We-sson/HanGao/README.md

# KUKA上位机软件使用说明

  该项目处于研发阶段，项目详情使用方法后续更新文档说明!
   
  主项目入口：HanGao/HanGao_Base/HanGao.sln
 
  欢迎各位对项目提出意见和问题~

 The project is in the research and development stage, the project details of the use of subsequent updates to the document description!
 
 Main project entrance: HanGao/HanGao_Base/HanGao.sln
 
 We welcome your comments and questions about the project.

企业微信截图_17210061561094
