We-sson/HanGao/KUKA_Socket/Krc8.3/技术参数说明.docx

Surround_Welding_Struc

参数（使用英文表示）：

焊盆口：

水槽本体属性参数：

Sink_Size_Long-长度

Sink_Size_Width-宽度

Sink_Size_R-圆角

Sink_Size_Pots_Thick 盆胆厚度

Sink_Size_Panel_Thick面板厚度

Sink_Model水槽型号

Sink_Size _Left_Distance 水槽面板左配件尺寸

Sink_Size _Down_Distance 水槽面板下配件尺寸

Sink_Type 水槽类型

各位置围边焊接工艺默认值

Welding_Name=”SS_1” 点名称

Welding _Power=80% 焊接功率

Welding_Speed=0.045 焊接速度

Welding_Angle=25 焊接角度

Welding_CDIS=5 轨道逼近值

Welding_Offset={X 0,Y 0,Z 0} 焊接偏移

Welding_Name={X 0,Y 0,Z 0} 焊接位置

短边焊接工作参数

{Surr_Welding_Craft_Type: Welding_Name[] "S2", Welding_Pos {E6POS: X 533.000, Y 463.600037, Z -2.05000, A 0.0, B -23.0000, C 0.0}, Welding_Speed 0.0500000, Welding_Angle 23.0000, Welding_Offset {Offset_POS: X 10.0000, Y 0.0, Z 0.0}} {Surr_Welding_Craft_Type: Welding_Name[] "S2", Welding_Pos {E6POS: X 533.000, Y 463.600037, Z -2.05000, A 0.0, B -23.0000, C 0.0}, Welding_Speed 0.0500000, Welding_Angle 23.0000, Welding_Offset {Offset_POS: X 10.0000, Y 0.0, Z 0.0}} {Surr_Welding_Craft_Type: Welding_Name[] "S2", Welding_Pos {E6POS: X 533.000, Y 463.600037, Z -2.05000, A 0.0, B -23.0000, C 0.0}, Welding_Speed 0.0500000, Welding_Angle 23.0000, Welding_Offset {Offset_POS: X 10.0000, Y 0.0, Z 0.0}} {Surr_Welding_Craft_Type: Welding_Name[] "S2", Welding_Pos {E6POS: X 533.000, Y 463.600037, Z -2.05000, A 0.0, B -23.0000, C 0.0}, Welding_Speed 0.0500000, Welding_Angle 23.0000, Welding_Offset {Offset_POS: X 10.0000, Y 0.0, Z 0.0}} {Surr_Welding_Craft_Type: Welding_Name[] "S2", Welding_Pos {E6POS: X 533.000, Y 463.600037, Z -2.05000, A 0.0, B -23.0000, C 0.0}, Welding_Speed 0.0500000, Welding_Angle 23.0000, Welding_Offset {Offset_POS: X 10.0000, Y 0.0, Z 0.0}} {Surr_Welding_Craft_Type: Welding_Name[] "S2", Welding_Pos {E6POS: X 533.000, Y 463.600037, Z -2.05000, A 0.0, B -23.0000, C 0.0}, Welding_Speed 0.0500000, Welding_Angle 23.0000, Welding_Offset {Offset_POS: X 10.0000, Y 0.0, Z 0.0}} {Surr_Welding_Craft_Type: Welding_Name[] "S2", Welding_Pos {E6POS: X 533.000, Y 463.600037, Z -2.05000, A 0.0, B -23.0000, C 0.0}, Welding_Speed 0.0500000, Welding_Angle 23.0000, Welding_Offset {Offset_POS: X 10.0000, Y 0.0, Z 0.0}} {Surr_Welding_Craft_Type: Welding_Name[] "S2", Welding_Pos {E6POS: X 533.000, Y 463.600037, Z -2.05000, A 0.0, B -23.0000, C 0.0}, Welding_Speed 0.0500000, Welding_Angle 23.0000, Welding_Offset {Offset_POS: X 10.0000, Y 0.0, Z 0.0}} {Surr_Welding_Craft_Type: Welding_Name[] "S2", Welding_Pos {E6POS: X 533.000, Y 463.600037, Z -2.05000, A 0.0, B -23.0000, C 0.0}, Welding_Speed 0.0500000, Welding_Angle 23.0000, Weldi

{Surr_Welding_Craft_Type:

Welding_Name[] "S2",

Welding_Pos {E6POS: X 533.000, Y 463.600037, Z -2.05000, A 0.0, B -23.0000, C 0.0},

Welding_Speed 0.0500000,

Welding_Angle 23.0000,

Welding_Offset {Offset_POS: X 10.0000, Y 0.0, Z 0.0}

}

存储XML格式

<Sink_Data DateLastModify=”2022-2-10-01:29” Sink_ListNumber=”12” >

<Sink Model=”952154” Type=”#LeftRight_One”>

<Sink_Size_Long>641<Sink_Size_Long>

<Sink_Size_Width>345<Sink_Size_Width>

<Sink_Size_R>10<Sink_Size_R>

<Sink_Size_Pots_Thick>0.75<Sink_Size_Pots_Thick>

<Sink_Size_Panel_Thick>2.85<Sink_Size_Panel_Thick>

<Sink_Size _Left_Distance>23.8<Sink_Size _Left_Distance>

<Sink_Size _Down_Distance>23.8<Sink_Size _Down_Distance>

<Surround_Craft >

<L0_Welding_Craft MaxArray=”10” >

<Craft_Data NO=”1” Welding_Name=”SS_1” Craft_Speed =”0.045” Craft_Angle=”25” Craft_CDIS=”10” Craft_Type=”#L_LIN_POS”>

<Welding_Offset X=”0.00” Y=”0.00” Z=”0.00” A=”0.00” B=”0.00” C=”0.00”>

<Craft_Data>

<Craft_Data NO=”2” Welding_Name=”SS_1” Craft_Speed =”0.045” Craft_Angle=”25” Craft_CDIS=”10” Craft_Type=”#L_LIN_POS”>

<Welding_Offset X=”0.00” Y=”0.00” Z=”0.00” A=”0.00” B=”0.00” C=”0.00”>

<Craft_Data>

<....补充....>

<Craft_Data NO=”10” Welding_Name=”SS_1” Craft_Speed =”0.045” Craft_Angle=”25” Craft_CDIS=”10” Craft_Type=”#L_LIN_POS”>

<Welding_Offset X=”0.00” Y=”0.00” Z=”0.00” A=”0.00” B=”0.00” C=”0.00”>

<Craft_Data>

< L0_Welding_Craft>

<C45_Welding_Craft MaxArray=”3” >

<Craft_Data NO=”1” Welding_Name=”SS_1” Craft_Speed =”0.045” Craft_Angle=”25” Craft_CDIS=”10” Craft_Type=”#C_LIN_POS”>

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

<Craft_Data>

<Craft_Data NO=”2” Welding_Name=”SS_1” Craft_Speed =”0.045” Craft_Angle=”0” Craft_CDIS=”0” Craft_Type=”#C_CIR_POS”>

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

<Craft_Data>

<Craft_Data NO=”3” Welding_Name=”SS_1” Craft_Speed =”0.045” Craft_Angle=”25” Craft_CDIS=”10” Craft_Type=”#C_CIR_POS”>

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

<Craft_Data>

<C45_Welding_Craft>

<...补充....>

<L270_Welding_Craft MaxArray=”10” >

<Craft_Data NO=”1” Welding_Name=”SS_1” Craft_Speed =”0.045” Craft_Angle=”25” Craft_CDIS=”10” Craft_Type=”#L_LIN_POS”>

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

<Craft_Data>

<Craft_Data NO=”2” Welding_Name=”SS_1” Craft_Speed =”0.045” Craft_Angle=”25” Craft_CDIS=”10” Craft_Type=”#L_LIN_POS”>

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

<Craft_Data>

<Craft_Data NO=”10” Welding_Name=”SS_1” Craft_Speed =”0.045” Craft_Angle=”25” Craft_CDIS=”10” Craft_Type=”#L_LIN_POS”>

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

<Craft_Data>

<L270_Welding_Craft >

<Surround_Craft>

<Sink>

<Sink_Data>

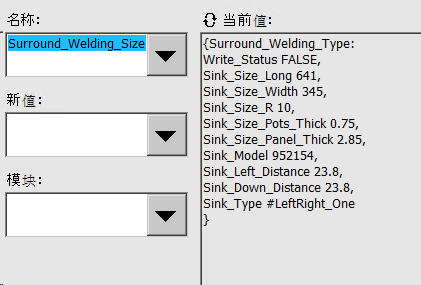
[picture p3: figure]
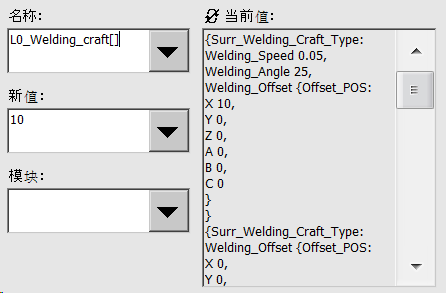
[picture p4: figure]
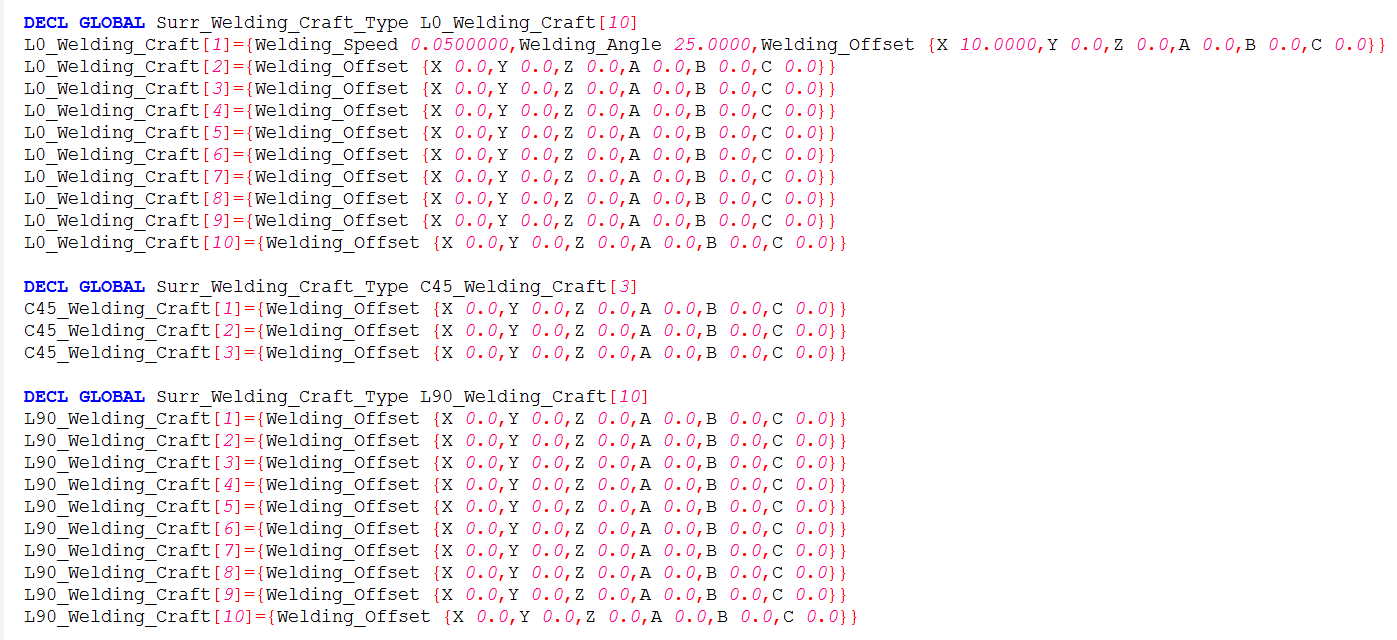
[picture p5: figure]

焊短边：ShortSide（）

结构：ShortSide_Struc {E6POS P1,P2……,E6POS Safe, BOOL Run, REAL Weld_Vel, INT CONT , REAL Width , Area SS_Area, Sink_Type SS_Sink , REAL BurnBack_High ,POS BurnBack_Point,INT BurnBack_Width, REAL BurnBack_Vel}

位置变量如：SS_1、SS_2。。。。。。。

D-焊小边长度

点：L_270_P1........

结构：

C_V_TYPE（CDIS,VEL,ANGLE）---轨道逼近，速度，姿态

例：L_0={C_DIS ,VEL ,ANGLE}

枚举：

方向区域：ENUM Area L0,C45,L90, C135,L180,C255,L270,C315

水槽类型：ENUM Sink_Type UpDown_One,LeftRight_One, LeftRight_Two
