We-sson/HanGao/Robot_Info_Mes/通讯协议解析.docx

ABB:

通讯发送使用格式：16进制位（1~FF）

协议结构：

1. 总字节长度：格式整数Uint（0~ 65535）
2. 通讯类型长度：格式整数Uint（0~ 65535）
3. 通讯类型：固定字符串Mes_Info_Data
4. 机器人类型长度：格式整数Uint（0~ 65535）
5. 机器人类型：ABB,KUKA,FAUNC等等
6. 机器人模式长度：格式整数Uint（0~ 65535）
7. 机器人模式：（Run，T1，Error）表示运行，手动，报警
8. 机器人程序名称长度：格式整数Uint（0~ 65535）
9. 机器人程序名称：当前指针程序名称。
10. 工位A作业状态长度：格式整数Uint（0~ 65535）
11. 工位A作业状态：FALSE,TURE
12. 工位B作业状态长度：格式整数Uint（0~ 65535）
13. 工位B作业状态：FALSE,TURE
14. 工位C作业状态长度：格式整数Uint（0~ 65535）
15. 工位C作业状态：FALSE,TURE
16. 工位D作业状态长度：格式整数Uint（0~ 65535）
17. 工位D作业状态：FALSE,TURE
18. 设备工艺类型长度:格式整数Uint（0~ 65535）
19. 设备工艺类型: Stretch_Sink_Cutting _1,每台机独立名称

接受示例~~~~

1. 总字节长度(如122个字，发送： 7A 00)，固定占2位
2. 通讯类型长度（如13字，发送0D 00）固定占2位
3. 通讯类型（如“Mes_Info_Data”字符串转字发送：4D 65 73 5F 49 6E 66 6F 5F 44 61 74 61）
4. 机器人类型长度（如3个字，发送03 00）固定占2位
5. 机器人类型(如“ABB”字符串转字发送41 42 42)
6. 机器人模式长度（如2个字，发送02 00）固定占2位
7. 机器人模式（如“T1”，字符串转字发送54 31）
8. 机器人程序名称长度（如6个字，发送06 00）固定占2位
9. 机器人程序名称（如“T_ROB1”,发送54 5F 52 4F 42 31）
10. 工位A作业状态长度（如5个字，发送05 00）固定占2位
11. 工位A作业状态（如“FALSE”字符串转字，发送：46 41 4C 53 45）
12. 工位B作业状态长度（如5个字，发送05 00）固定占2位
13. 工位B作业状态（如“FALSE”字符串转字，发送：46 41 4C 53 45）
14. 工位C作业状态长度（如5个字，发送05 00）固定占2位
15. 工位C作业状态（如“FALSE”字符串转字，发送：46 41 4C 53 45）
16. 工位D作业状态长度（如5个字，发送05 00）固定占2位
17. 工位D作业状态（如“FALSE”字符串转字，发送：46 41 4C 53 45）
18. 设备工艺类型长度（如8个字，发送08 00）固定占2位
19. 设备工艺类型（如“R_Side_9”，字符串转字发送52 5F 53 69 64 65 5F 39）
20. 完整接受信息47 00 0D 00 4D 65 73 5F 49 6E 66 6F 5F 44 61 74 61 03 00 41 42 42 02 00 54 31 06 00 54 5F 52 4F 42 31 05 00 46 41 4C 53 45 04 00 54 52 55 45 05 00 46 41 4C 53 45 05 00 46 41 4C 53 45 08 00 52 5F 53 69 64 65 5F 39
