We-sson/HanGao/ABB_Socket/资料/3HAC050947 TRM RAPID Overview RW 6-zh-cn.pdf

ROBOTICS

# 技术参考手册

# RAPID语言概览

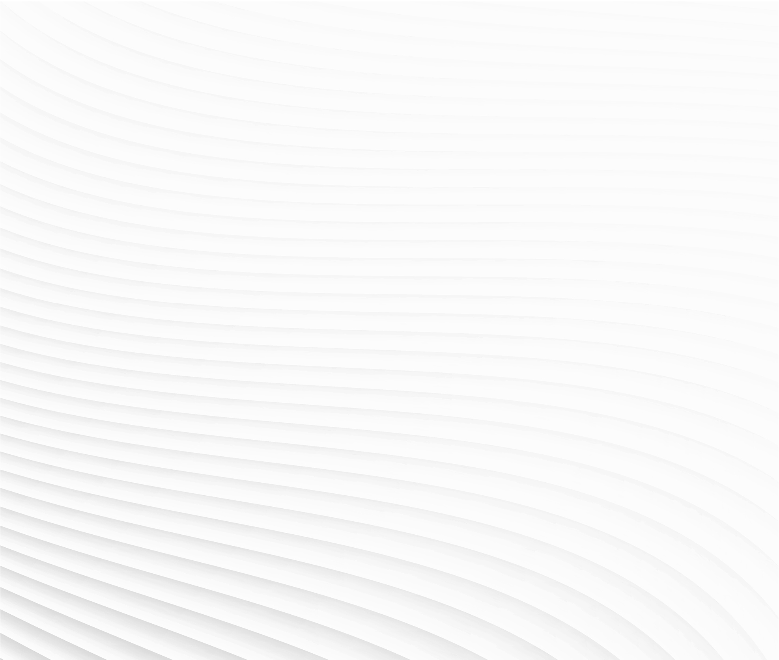
[picture p18: figure]

Trace back information:
Workspace 23C version a5
Checked in 2023-09-20
Skribenta version 5.5.019

## 技术参考手册

## RAPID语言概览

RobotWare 6.15.04

文档编号: 3HAC050947-010
修订: R

© 版权所有 2004-2023 ABB。保留所有权利。 规格如有更改，恕不另行通知。

本手册中包含的信息如有变更，恕不另行通知，且不应视为 ABB 的承诺。 ABB 对本手 册中可能出现的错误概不负责。
除本手册中有明确陈述之外，本手册中的任何内容不应解释为 ABB 对个人损失、财产 损坏或具体适用性等做出的任何担保或保证。
ABB 对因使用本手册及其中所述产品而引起的意外或间接伤害概不负责。
未经 ABB 的书面许可，不得再生或复制本手册和其中涉及的任何部件。 保留以备将来参考。
可从 ABB 处获取此手册的额外复印件。
本出版物为译本。

© 版权所有 2004-2023 ABB。保留所有权利。 规格如有更改，恕不另行通知。

目录

1 基本RAPID编程 | 11
2 运动编程和I/O编程 | 97
技术参考手册 - RAPID语言概览 | 5
3HAC050947-010 修订: R
© 版权所有 2004-2023 ABB。保留所有权利。

目录

3 术语表 | 143
索引 | 145
6 | 技术参考手册 - RAPID语言概览

目录

# 手册概述

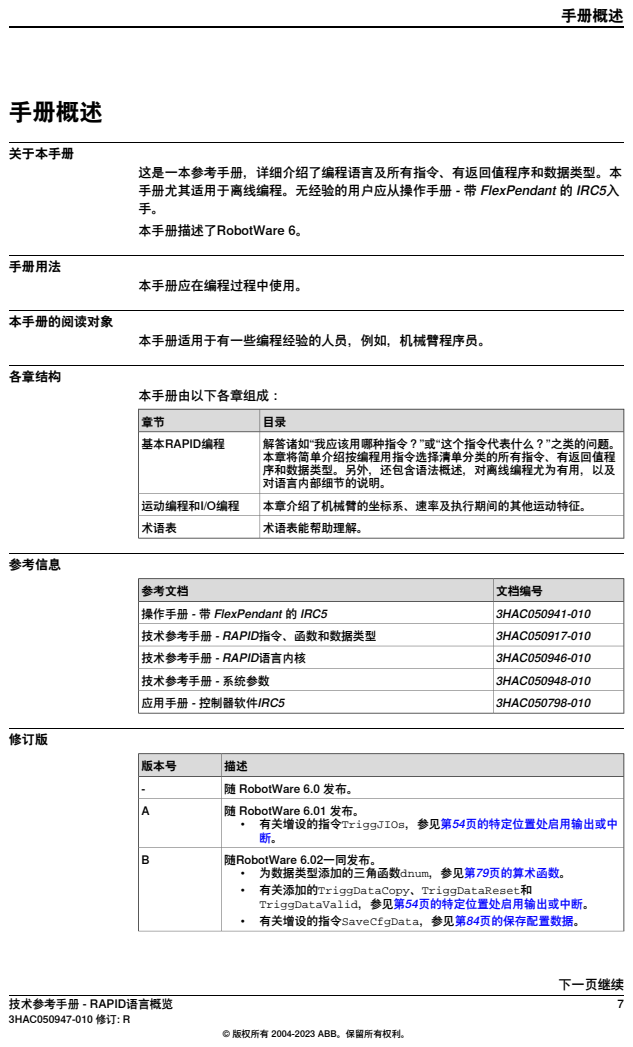
[picture p19: page 7]
关于本手册; 手册用法; 本手册应在编程过程中使用。; 本手册的阅读对象; 各章结构; 本手册由以下各章组成：; 基本RAPID编程; 运动编程和I/O编程; 本章介绍了机械臂的坐标系、速率及执行期间的其他运动特征。; 术语表; 术语表能帮助理解。; 参考信息; 参考文档; 文档编号; 操作手册 - 带 FlexPendant 的 IRC5; 3HAC050941-010; 技术参考手册 - RAPID指令、函数和数据类型; 3HAC050917-010; 技术参考手册 - RAPID语言内核; 3HAC050946-010; 技术参考手册 - 系统参数; 3HAC050948-010; 应用手册 - 控制器软件IRC5; 3HAC050798-010; 修订版; 版本号; - 随 RobotWare 6.0 发布。; 随 RobotWare 6.01 发布。 • 有关增设的指令TriggJIOs，参见第54页的特定位置处启用输出或中 断。; 随RobotWare 6.02一同发布。 • 为数据类型添加的三角函数dnum，参见第79页的算术函数。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

这是一本参考手册，详细介绍了编程语言及所有指令、有返回值程序和数据类型。本
手册尤其适用于离线编程。无经验的用户应从操作手册 - 带 FlexPendant 的 IRC5入
本手册描述了RobotWare 6。

本手册适用于有一些编程经验的人员，例如，机械臂程序员。

解答诸如“我应该用哪种指令？”或“这个指令代表什么？”之类的问题。
本章将简单介绍按编程用指令选择清单分类的所有指令、有返回值程
序和数据类型。另外，还包含语法概述，对离线编程尤为有用，以及
对语言内部细节的说明。

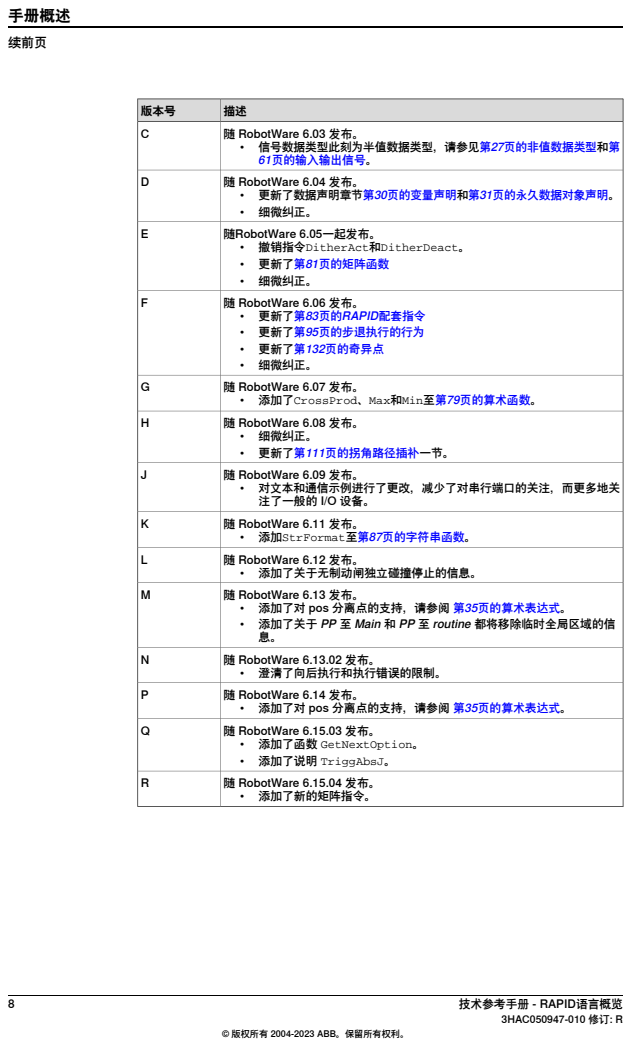
[picture p20: page 8]
版本号; 随 RobotWare 6.03 发布。 • 信号数据类型此刻为半值数据类型，请参见第27页的非值数据类型和第 61页的输入输出信号。; 随 RobotWare 6.04 发布。 • 更新了数据声明章节第30页的变量声明和第31页的永久数据对象声明。 • 细微纠正。; 随RobotWare 6.05一起发布。 • 撤销指令DitherAct和DitherDeact。 • 更新了第81页的矩阵函数 • 细微纠正。; 随 RobotWare 6.06 发布。 • 更新了第83页的RAPID配套指令 • 更新了第95页的步退执行的行为 • 更新了第132页的奇异点 • 细微纠正。; 随 RobotWare 6.07 发布。 • 添加了CrossProd、Max和Min至第79页的算术函数。; 随 RobotWare 6.08 发布。 • 细微纠正。 • 更新了第111页的拐角路径插补一节。; 随 RobotWare 6.11 发布。 • 添加StrFormat至第87页的字符串函数。; 随 RobotWare 6.12 发布。 • 添加了关于无制动闸独立碰撞停止的信息。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

随 RobotWare 6.09 发布。
• 对文本和通信示例进行了更改，减少了对串行端口的关注，而更多地关
注了一般的 I/O 设备。

随 RobotWare 6.13 发布。
• 添加了对 pos 分离点的支持，请参阅 第35页的算术表达式。
• 添加了关于 PP 至 Main 和 PP 至 routine 都将移除临时全局区域的信
随 RobotWare 6.13.02 发布。
• 澄清了向后执行和执行错误的限制。

随 RobotWare 6.14 发布。

# 如何查阅本手册

书面约定
程序示例通常以输出文件或打印机输出形式呈现，区别于以如下形式呈现在FlexPendant 示教器上的程序：
- FlexPendant示教器中隐藏的特定控制字码，如表明程序开始和结束的字码；
- 以标准格式打印出来的数据声明和程序声明，如VAR num reg1。 在本手册说明中，所有指令、函数和数据类型的名称都要用等宽字体表示，如 TPWrite。变量、系统参数和功能的名称用斜体表示。所列事件号示例中的注释不译 （即使翻译本手册时也一样不译）。

语法规则
用简化语法和形式语法对指令和函数进行说明。若您是用FlexPendant示教器编程， 则由于机械臂自身能保证所用语法的正确性，因此通常只需了解简化语法。

简化语法示例
如下为一种含指令TPWrite的简化语法示例。
TPWrite String [\Num] | [\Bool] | [\Pos] | [\Orient] [\Dnum]
- 括号中不含强制性参数。
- 用方括号[]将可选参数括起来，但可忽略这些参数。
- 互相排斥的参数不能同时存在于同一指令中，在同一指令中就要用竖线|隔开。
- 用波形括号{ }将可重复任意次的参数括起来。
上述示例采用了如下参数：
- String为强制性参数。
- Num、Bool、Pos、Orient和Dnum为可选参数。
- Num、Bool、Pos、Orient和Dnum互相排斥。

形式语法示例

TPWrite

[String ':='] <expression (IN) of string>

['\'Num':=' <expression (IN) of num> ] |

['\'Bool':=' <expression (IN) of bool> ] |

['\'Pos':=' <expression (IN) of pos> ] |

['\'Orient ':=' <expression (IN) of orient> ]

['\' Dnum':=' <expression (IN) of dnum]';'
- 方括号[ ]中的文字可忽略。
- 互相排斥的参数不能同时存在于同一指令中，在同一指令中就要用竖线|隔开。
- 用波形括号{ }将可重复任意次的参数括起来。
- 用单引号（两个撇号' '）将为获得正确语法而写出的符号括起来。
- 用尖角括号<>将参数和其他字符的数据类型括起来。更多详情，请查阅程序参 数说明。
用特殊语法EBNF编写语言和特定指令的基本元素。规则不变，而且还有所增加。
- 符号::=等同于被定义为。
- 至于尖角括号<>中的文字，将另起一行单独说明。

### 如何查阅本手册

示例

GOTO <identifier> ';'

<identifier> ::= <ident> | <ID>
<ident> ::= <letter> {<letter> | <digit> | '_'}

### 如何查阅本手册

# 1 基本RAPID编程

### 1.1 程序结构

### 1.1.1 简介

指令
本程序由多个对机械臂工作加以说明的指令构成。因此，不同操作对应的是不同的指 令，如，移动机械臂对应一个指令，设置输出对应一个指令。 指令通常包含多个相关参数，这些参数可定义按特定指令会出现的情况。如，重置输 出的指令包括一个明确要重置哪个输出的参数，如Reset do5。确定这些参数的方式 如下：
- 数值，如5或4.6；
- 数据索引，如reg1；
- 表达式，如5+reg1*2；
- 函数调用，如Abs(reg1)；
- 串值，如"Producing part A"。

程序
程序分为三类—无返回值程序、有返回值程序和软中断程序。
- 无返回值程序用作子程序。
- 有返回值程序会返回一个特定类型的数值。此程序用作指令的参数。
- 软中断程序提供了一种中断应对方式。一个软中断程序对应一次特定中断，如， 设置一个输入，若发生对应中断，则自动执行该输入。

数据
可按数据形式保存信息，如工具数据，包含对应工具的所有相关信息，如工具的工具 中心接触点及其重量等；数值数据，也有多种用途，如计算待处理的零件量等。数据 分为多种类型，不同类型所含的信息也各有不同，如工具、位置和负载等。由于此类 数据是可创建的，且可赋予任意名称，因此其数量不受限（除来自内存的限制外）。 既可遍布于整个程序中，也可能只在某一程序的局部。
数据分为三类—常量、变量和永久数据对象。
- 常量表示的是静态值，只能通过人为方式赋予新值。
- 另外，在程序执行期间，也可赋予变量一个新值。
- 永久数据对象也可被视作“永久”变量。保存程序时，初始化值呈现的就是永久数 据对象的当前值。

其他特征
语言中还有其他特征，如下所示：
- 程序参数
- 算术表达式和逻辑表达式
- 自动错误处理器
- 模块化程序

### 1 基本RAPID编程

1.1.1 简介

- 多任务处理
这种语言不区分大小写，如同一字母的大小写形式无区别。

1.1.1 简介

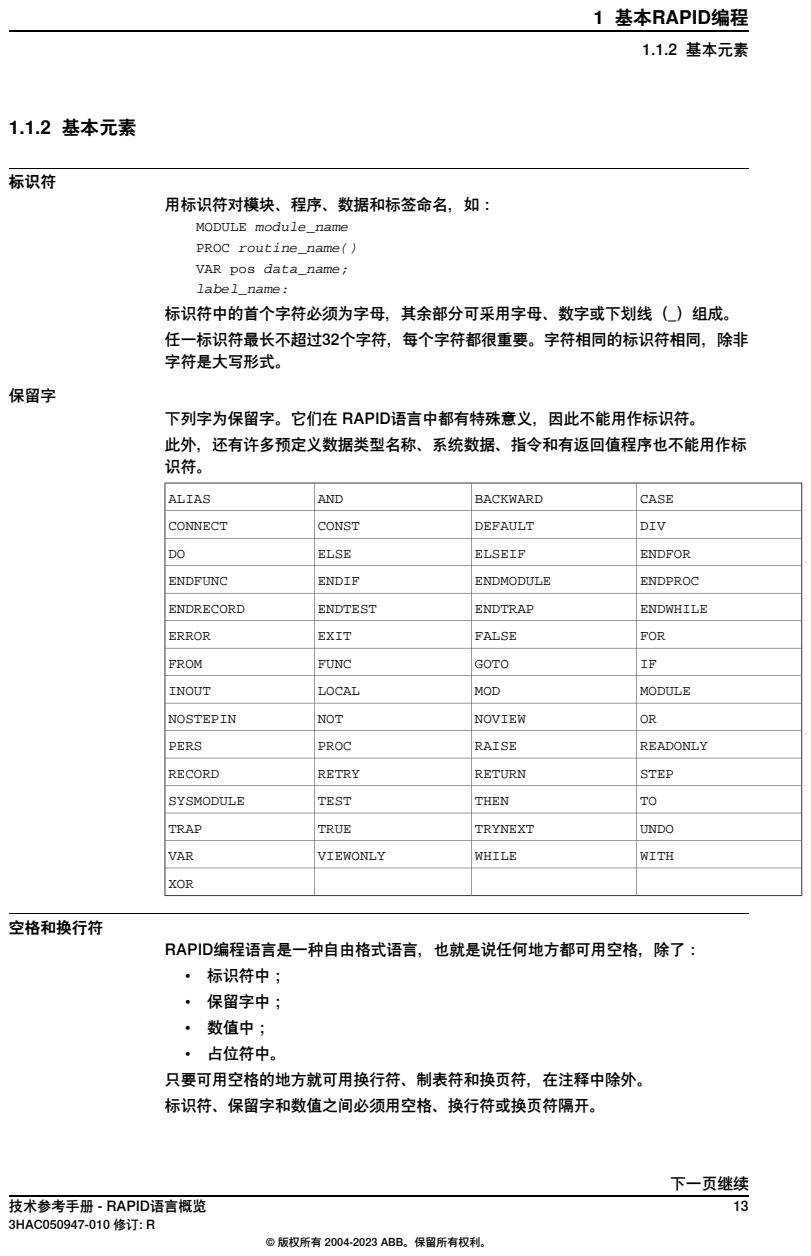
[picture p21: page 13]
1.1.2 基本元素; 标识符; MODULE module_name; PROC routine_name(); 保留字; ALIAS; AND; BACKWARD; CASE; CONNECT; CONST; DEFAULT; DIV; ELSE; ELSEIF; ENDFOR; ENDFUNC; ENDIF; ENDMODULE; ENDPROC; ENDRECORD; ENDTEST; ENDTRAP; ENDWHILE; ERROR; EXIT; FALSE; FOR; FROM; FUNC; GOTO; INOUT; LOCAL; MOD; MODULE; NOSTEPIN; NOT; NOVIEW; PERS; PROC; RAISE; READONLY; RECORD; RETRY; RETURN; STEP; SYSMODULE; TEST; THEN; TRAP; TRUE; TRYNEXT; UNDO; VAR; VIEWONLY; WHILE; WITH; XOR; 空格和换行符

用标识符对模块、程序、数据和标签命名，如：

VAR pos data_name;
label_name:
标识符中的首个字符必须为字母，其余部分可采用字母、数字或下划线（_）组成。
任一标识符最长不超过32个字符，每个字符都很重要。字符相同的标识符相同，除非
字符是大写形式。

下列字为保留字。它们在 RAPID语言中都有特殊意义，因此不能用作标识符。
此外，还有许多预定义数据类型名称、系统数据、指令和有返回值程序也不能用作标

RAPID编程语言是一种自由格式语言，也就是说任何地方都可用空格，除了：
• 标识符中；
• 保留字中；
• 数值中；
• 占位符中。
只要可用空格的地方就可用换行符、制表符和换页符，在注释中除外。
标识符、保留字和数值之间必须用空格、换行符或换页符隔开。

数值
数值有如下两种表示方式：
- 整数，如 3、-100或3E2等；
- 小数，如3.5、-0.345或-245E-2等。 数值必须在《浮点数算术标准》（ANSI IEEE 754）规定的范围内。

逻辑值

逻辑值可表示为TRUE或FALSE。

串值
串值为一个由字符（ISO 8859-1（Latin-1））和控制字符（用0~255这一数字代码范 围表示的非ISO 8859-1（Latin-1）字符）组成的序列。其中可含字符代码，使其能包 含字符串中的不可见字符（二进制数据）。字符串的最长长度为80个字符。 例子：

"This is a string"

"This string ends with the BEL control character \07"
若其中包含一个反斜线（表示字符代码）或双引号字符，则该字符必须写两次。 例子：

"This string contains a "" character"

"This string contains a \\ character"

注释
注释可帮助理解程序。绝不会影响程序的意义。
注释以感叹号（！）开始，以换行符结束，占据了该行的其余部分（从感叹号开始）， 不会出现在模块声明之外的其他地方。

! comment

IF reg1 > 5 THEN

! comment

reg2 := 0;

ENDIF

占位符
可用占位符暂时代表程序中尚未定义的部分。从句法方面来看，含占位符的程序没错， 可载入程序内存。
占位符 | 描述
<TDN> | 数据类型定义
<DDN> | 数据声明
<RDN> | 程序声明
<PAR> | 可选替换形参
<ALT> | 可选形参
<DIM> | 形式（一致）数组阶数
<SMT> | 指令
<VAR> | 数据对象（变量、永久数据对象或参数）索引
<EIT> | if指令的else if子句

1.1.2 基本元素

占位符 | 描述
<CSE> | 测试指令情况子句
<EXP> | 表达式
<ARG> | 过程调用参数
<ID> | 标识符

文件标题
一份程序文件的开头就是文件标题（非强制性要求），如下所示：

%%%

VERSION:1

LANGUAGE:ENGLISH

%%%

语法

标识符

<identifier> ::= <ident> | <ID>
<ident> ::= <letter> {<letter> | <digit> | '_'}

数值

<num literal> ::=

<integer> [ <exponent> ]

| <decimal integer>) [<exponent>]

| <hex integer> | <octal integer>

| <binary integer>

| <integer> '.' [ <integer> ] [ <exponent> ]

| [ <integer> ] '.' <integer> [ <exponent> ]

<integer> ::= <digit> {<digit>}

<hex integer> ::= '0' ('X' | 'x')

<hex digit> {<hex digit>}

<octal integer> ::= '0' ('O' | 'o') <octal digit> {<octal digit>}
<binary integer> ::= '0' ('B' | 'b') <binary digit> {<binary digit>}
<exponent> ::= ('E' | 'e') ['+' | '-'] <integer>
<digit> ::= 0 | 1 | 2 | 3 | 4 | 5 | 6 | 7 | 8 | 9
<hex digit> ::= <digit> | A | B | C | D | E | F | a | b | c | d |
e | f
<octal digit> ::= 0 | 1 | 2 | 3 | 4 | 5 | 6 | 7
<binary digit> ::= 0 | 1

逻辑值；

<bool literal> ::= TRUE | FALSE

字符串值

<string literal> ::= '"' {<character> | <character code> } '"'

<character code> ::= '\' <hex digit> <hex digit>

<hex digit> ::= <digit> | A | B | C | D | E | F | a | b | c | d |
e | f

备注

<comment> ::= '!' {<character> | <tab>} <newline>

1.1.2 基本元素

字符

<character> ::= -- ISO 8859-1 (Latin-1)--

<newline> ::= -- newline control character --

<digit> ::= 0 | 1 | 2 | 3 | 4 | 5 | 6 | 7 | 8 | 9
<hex digit> ::= <digit> | A | B | C | D | E | F | a | b | c | d |
e | f
<letter> ::= <upper case letter> | <lower case letter>

<upper case letter> ::=
A | B | C | D | E | F | G | H | I | J
| K | L | M | N | O | P | Q | R | S | T
| U | V | W | X | Y | Z | À | Á | Â | Ã
| Ä | Å | Æ | Ç | È | É | Ê | Ë | Ì | Í
| Î | Ï | Ð | Ñ | Ò | Ó | Ô | Õ | Ö | Ø
| Ù | Ú | Û | Ü | Ý | Þ | ß

<lower case letter> ::=
a | b | c | d | e | f | g | h | i | j
| k | l | m | n | o | p | q | r | s | t
| u | v | w | x | y | z | ß | à | á | â | ã
| ä | å | æ | ç | è | é | ê | ë | ì | í
| î | ï | ð | ñ | ò | ó | ô | õ | ö | ø
| ù | ú | û | ü | ý | þ | ÿ

1.1.2 基本元素

### 1.1.3 模块

简介
本程序分为编程模块和系统模块。

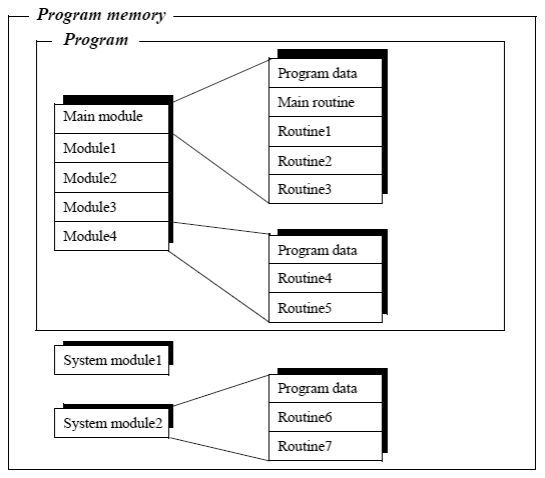
[picture p22: figure]

xx1100000550

编程模块
编程模块由不同的数据和路径构成。每个模块或整个程序都可复制到磁盘和内存盘等 设备中，反过来，也可从这些设备中复制模块或程序。
其中一个模块中含有入口过程和被称为Main的全局过程。执行程序实际上就是在执行 Main过程。本程序可包括多个模块，但其中一个必须要有一个主过程。 如，一个模块要么可定义与外部设备的接口，要么就包含CAD系统生成的或经数字化 （示教编程）在线上创建的几何学数据。
因而，一个模块中通常会包含多个小型计算站，而多个偏大的计算站可能共用一个主 模块，主模块可引用某一或其他多个模块中包含的程序和/或数据。

系统模块
用系统模块定义常见的系统专用数据和程序，如工具等。系统模块不会随程序一同保 存，也就是说，对系统模块的任何更新都会影响程序内存中当前所有的或随后会载入 其中的所有程序。

1.1.3 模块

模块声明
模块声明介绍了相应模块的名称和属性。这些属性只能通过离线添加，不能用 FlexPendant示教器添加。下文为某模块的属性示例：
属性 | 如有规定
SYSMODULE | 就模块而言，不是系统模块就是编程模块。
NOSTEPIN | 在逐步执行期间不能进入模块。
VIEWONLY | 模块无法修改。
READONLY | 模块无法修改，但可以删除其属性。
| 模块不可读，只可执行。可通过其他模块接近全局程序，此程序 通常以NOSTEPIN方式运行。目前全局数据数值可从其他模块或 FlexPendant示教器上的数据窗口接近。NOVIEW只能通过PC在 线下定义。
NOVIEW

例如，

MODULE module_name (SYSMODULE, VIEWONLY)

!data type definition

!data declarations

!routine declarations

ENDMODULE
某模块可能与另一模块的名称不同，或可能没有全局程序或数据。

程序文件结构
如上所述，名称已定的程序中包含所有编程模块。保存程序时，会生成一个新的以该 程序名称命名的目录。在这个目录中，所有程序模块都保存在该文件夹中，对应文件 扩展名为.mod。另外随之一起存入该文件夹的还有同样以程序名称命名的相关使用说 明文件，扩展名为 .pgf。该使用说明文件含有一份列表，该列表囊括了程序中的所有 模块。

语法

模块声明

<module declaration> ::=

MODULE <module name> [ <module attribute list> ]

<type definition list>

<data declaration list>

<routine declaration list>

ENDMODULE

<module name> ::= <identifier>

<module attribute list> ::= '(' <module attribute> { ',' <module attribute> } ')'

<module attribute> ::=

SYSMODULE
| NOVIEW

| NOSTEPIN

| VIEWONLY

| READONLY

1.1.3 模块

<type definition list> ::= { <type definition> }

<data declaration list> ::= { <data declaration> }

<routine declaration list> ::= { <routine declaration> }

1.1.3 模块

### 1.1.4 系统模块User

简介
为简化编程过程，提供机械臂的同时要提供预定义数据。由于未明确要求必须创建此 类数据，因此，此类数据不能直接使用。
若用该数据，则初始编程会更简单。但通常最好是自己重新为所用数据命名，以便您 能更轻松地查阅程序。

目录
User包含五个数值数据（寄存器）、一个对象数据、一个计时函数和两个数字信号符 号值。
名称 | 数据类型 | 声明
reg1 | num | VAR num reg1:=0
reg2 | num | VAR num reg2:=0
reg3 | num | VAR num reg3:=0
reg4 | num | VAR num reg4:=0
reg5 | num | VAR num reg5:=0
clock1 | clock | VAR clock clock1
User是一个系统模块，也就是说，无论有没有加载程序，它都会出现在机械臂内存 中。

1.1.4 系统模块User

### 1.1.5 程序

简介
程序（子程序）分为无返回值程序、有返回值程序和软中断程序这三类。
- 无返回值程序不会返回数值。该程序用于指令中。
- 有返回值程序会返回一个特定类型的数值。该程序用于表达式中。
- 软中断程序提供了一种中断应对方式。一个软中断程序只对应一次特定中断。 一旦发生中断，则将自动执行对应软中断程序。但不能从程序中直接调用软中 断程序。

程序的范围
程序的范围是指可获得程序的区域。除非程序声明的可选局部命令将程序归为局部程 序（在模块内），不然则为全局程序。
例子：

LOCAL PROC local_routine (...

PROC global_routine (...
程序适用的范围规则如下：
- 全局程序的范围可能包括任务中的任意模块；
- 局部程序的范围由其所处模块构成；
- 在范围内，局部程序会隐藏名称相同的所有全局程序或数据；
- 在范围内，程序会隐藏名称相同的所有指令、预定义程序和预定义数据。

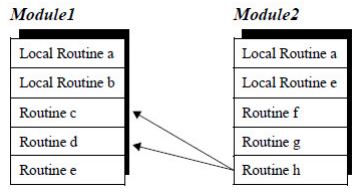
[picture p23: figure]

xx1100000551
以上示例中，可从程序h中调用下述程序：
- 模块1：程序c和d；
- 模块2：所有程序。
同一模块中，某一程序的名称与另一程序、数据或数据类型的名称不一定相同。全局 程序的名称与对应模块或另一模块中的全局程序、全局数据或全局数据类型的名称不 一定相同。

参数
程序声明中的参数列表明确规定了调用程序时必须或能提供的参数（实参）。

1.1.5 程序

参数包括四种（按访问模式区分）：
- 正常情况下，参数仅用作输入，同时被视作程序变量。改变此变量，不会改变 对应参数；
- INOUT参数规定，对应参数必须为变量（整体、元素或部分）或对应参数必须 为可为程序所改变的完整的永久数据对象；
- VAR参数规定，对应参数必须为可为程序所改变的变量（整体、元素或部分）；
- PERS参数规定，对应参数必须为可为程序所改变的完整的永久数据对象。 更新INOUT、VAR或PERS参数事实上就等同于更新了参数本身，借此可用参数将多个 数值返回到调用程序。
例子：

PROC routine1 (num in_par, INOUT num inout_par,

VAR num var_par, PERS num pers_par)
此类参数是可选的，在程序调用的参数列表中可忽略。可选参数用反斜线（\）+参数 表示。
例子：

PROC routine2 (num required_par \num optional_par)
不可引用程序调用时会忽略的可选参数值，也就是说，在使用可选参数前，必须要检 查程序调用的可选参数。
两个或多个可选参数之间可能会互相排斥（声明互相排斥），也就是说同一程序调用 中只可能出现其中一个。这一情况通过在存疑参数之间加竖线（管道字符 |）表明。 例子：
PROC routine3 (\num exclude1 | num exclude2)
特殊类型switch可能（只能）属于可选参数，提供了一种运用转换参数（只能通过名 称—而非数值—确定）的方式。数值不能转为switch参数。要运用switch参数的唯 一方式就是运用预定义函数Present检查其存在。
例子：
PROC routine4 (\switch on | switch off)

IF Present (off ) THEN

ENDPROC
数组可能会以参数的形式通过。数组参数的范围必须与相应形参的范围相符。数组参 数的阶数一致（带*标记）。因此实际阶数取决于程序调用中相应参数的阶数。程序借 用预定义函数 Dim可确定参数的实际阶数。
例子：

PROC routine5 (VAR num pallet{*,*})

程序终止
通过RETURN指令明确无返回值程序执行终止，或在到达无返回值程序末端（ENDPROC、

BACKWARD、ERROR或UNDO）时，即暗示执行终止。
有返回值程序求值必须通过RETURN指令终止。
运用RETURN指令明确软中断程序执行终止，或在到达软中断程序末端（ENDTRAP、 ERROR或UNDO）时，即暗示执行终止。下次会从中断点处开始继续执行。

1.1.5 程序

程序声明
程序包含程序声明（包括参数）、数据、正文主体、反向处理器（仅限无返回值程 序）、错误处理器和撤销处理器。不能套入程序声明，也就是说，不能在程序中声明 程序。

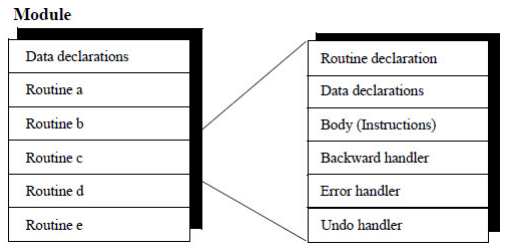
[picture p24: figure]

xx1100000553

无返回值程序声明
如，用数值数组中的各元素乘以：

PROC arrmul( VAR num array{*}, num factor)

FOR index FROM 1 TO dim( array, 1 ) DO

array{index} := array{index} * factor;

ENDFOR

ENDPROC

有返回值程序声明
有返回值程序可返回任意数据类型的数值，但不能返回数组数值。 如，可返回矢量长度。

FUNC num veclen (pos vector)

RETURN Sqrt(Pow(vector.x,2)+Pow(vector.y,2)+Pow(vector.z,2));

ENDFUNC

软中断声明
如，对“给料机空载”所致中断的反应：

TRAP feeder_empty

wait_feeder;

RETURN;

ENDTRAP

过程调用
调用一个过程时,应使用与该过程的参数对应的参数:
- 必须明确强制性参数,同时还须按正确顺序列出.
- 可选参数可忽略.
- 可用条件式参数,将参数从一个程序调用转到另一程序调用。 请参阅 第39页的运用表达式中的函数调用。

1.1.5 程序

可用标识符（前期绑定）以静态方式指定过程名称或在串类型表达式运行时间内（后 期绑定）求得程序名称的值。前期绑定应被视作正常的过程调用形式，但有时后期绑 定却能提供极有效的紧凑编码。通过在代表过程名称的字符串前后添加百分比符号， 定义后期绑定。
例子：

! early binding

TEST products_id

CASE 1:

proc1 x, y, z;

CASE 2:

proc2 x, y, z;

CASE 3:

! same example using late binding

% “proc” + NumToStr(product_id, 0) % x, y, z;

! same example again using another variant of late binding

VAR string procname {3} :=[“proc1”, “proc2”, “proc3”];

% procname{product_id} % x, y, z;
注意后期绑定仅适用于过程调用，不适合函数调用。若要用后期绑定引用一个未知过
程，则将系统变量ERRNO设为ERR_REFUNKPRC；若要引用过程调用错误（语法，而

非过程），则将系统变量ERRNO设为ERR_CALLPROC。

语法

程序声明

<routine declaration> ::=

[LOCAL] ( <procedure declaration>

| <function declaration>

| <trap declaration> )

| <comment>

| <RDN>

参数

<parameter list> ::=

<first parameter declaration> { <next parameter declaration> }

<first parameter declaration> ::=

<parameter declaration>

| <optional parameter declaration>

| <PAR>

<next parameter declaration> ::=

',' <parameter declaration>

| <optional parameter declaration>

| ','<optional parameter declaration>

| ',' <PAR>

<optional parameter declaration> ::=

'\' ( <parameter declaration> | <ALT> )
{ '|' ( <parameter declaration> | <ALT> ) }

1.1.5 程序

<parameter declaration> ::=

[ VAR | PERS | INOUT] <data type>
<identifier> [ '{' ( '*' { ',' '*' } ) | <DIM>] '}'

| 'switch' <identifier>

无返回值程序声明

<procedure declaration> ::=

PROC <procedure name>

'(' [ <parameter list> ] ')'

<data declaration list>

<instruction list>

[ BACKWARD <instruction list> ]

[ ERROR <instruction list> ]

[ UNDO <instruction list> ]

ENDPROC

<procedure name> ::= <identifier>

<data declaration list> ::= {<data declaration>}

有返回值程序声明

<function declaration> ::=

FUNC <value data type>

<function name>

'(' [ <parameter list> ] ')'

<data declaration list>

<instruction list>

[ ERROR <instruction list> ]

[ UNDO <instruction list> ]

ENDFUNC

<function name> ::= <identifier>

软中断程序声明

<trap declaration> ::=

TRAP <trap name>

<data declaration list>

<instruction list>

[ ERROR <instruction list> ]

[ UNDO <instruction list> ]

ENDTRAP

<trap name> ::= <identifier>

过程调用

<procedure call> ::= <procedure> [ <procedure argument list> ] ';'

<procedure> ::=

<identifier>

| '%' <expression> '%'

<procedure argument list> ::= <first procedure argument> { <procedure argument> }

<first procedure argument> ::=

<required procedure argument>

| <optional procedure argument>

| <conditional procedure argument>

| <ARG>

1.1.5 程序

<procedure argument> ::=

',' <required procedure argument>

| <optional procedure argument>

| ',' <optional procedure argument>

| <conditional procedure argument>

| ',' <conditional procedure argument>

| ',' <ARG>

<required procedure argument> ::= [ <identifier> ':=' ] <expression>

<optional procedure argument> ::= '\' <identifier> [ ':=' <expression> ]

<conditional procedure argument> ::= '\' <identifier> '?' (
<parameter> | <VAR> )

1.1.5 程序

### 1.2 程序数据

### 1.2.1 数据类型

简介
有三种数据类型：
- 显然从意义上讲，基本类型就是不是基于其他任意类型定义且不能再分为多个 部分的基本数据，如num。
- 记录数据类型就是含多个有名称的有序部分的复合类型，如pos。其中任意部分 可能由基本类型构成，也可能由记录类型构成。
可用聚合表示法表示记录数值，如[ 300, 500, depth ] pos记录聚合值。 通过某部分的名称可访问数据类型的对应部分，如pos1.x:=300；pos1的x部分 赋值。
- 从定义上来讲，alias数据类型等同于其他类型。Alias类型可对数据对象进行分 类。

非值数据类型
一个有效数据类型要么是数值数据类型，要么是非值数据类型。简而言之，数值数据 类型仅代表部分数值形式。在数值导向操作中不能用非值数据：
- 初始化；
- 赋值（:=）；
- 等于（=）和不等于（<>）检查；
- TEST指令；
- 程序调用中的IN（访问模式）参数；
- 有返回值程序（返回）数据类型。
信号数据类型（signalai、signaldi、signalgi、signalao、signaldo、signalgo）均为 半值数据类型。这些数据可用于数值运算中，但初始化和赋值除外。 在数据类型说明中，仅对何时是半值数据类型及何时是非值数据类型作了规定。

同等（alias）数据类型
alias根据定义，数据类型等同于另一类型。数据可用另一含相同数据类型的数据替 代。
例子：

VAR num level;

VAR dionum high:=1;

level:= high;
由于dionum是num的一种alias数据类型，因此这样可行。

语法

<type definition>::=

[LOCAL] ( <record definition>

| <alias definition> )

| <comment>

| <TDN>

1.2.1 数据类型

<record definition>::=

RECORD <identifier>

<record component list>

ENDRECORD

<record component list> ::=

<record component definition> |

<record component definition> <record component list>

<record component definition> ::=

<data type> <record component name> ';'

<alias definition> ::=

ALIAS <data type> <identifier> ';'

<data type> ::= <identifier>

1.2.1 数据类型

### 1.2.2 数据声明

简介
数据包括三种：
- 程序执行期间，可赋予一个变量一个新值。
- 一个数据可被称为永久变量。这点通过如下方式实现，即更新永久数据对象数 值自发导致待更新的永久声明数值初始化。（保存程序的同时，任意永久声明 的初始化值反映的都是对应永久数据对象的当前值。）
- 各常量代表各个静态值，不能赋予其新值。
数据声明通过将名称（标识符）与数据类型联系在一起，引入数据。除了预定义数据 和循环变量外，必须声明所用的其他所有数据。

数据的范围
数据的范围是指可获得数据的区域。除非数据声明的可选局部命令将数据归为局部数 据（在模块内），不然则为全局数据。注意局部命令仅限用于模块级，不能用在程序 内。

示例

LOCAL VAR num local_variable;

VAR num global_variable;

程序数据
程序外声明的数据被称为程序数据。程序数据适用的范围规则如下：
- 预定义程序数据或全局程序数据的范围可能包括任何模块；
- 局部程序数据的范围由其所处模块构成；
- 在范围内，局部程序数据会隐藏名称相同的所有全局数据或程序（包括指令、 预定义程序和预定义数据）。
同一模块中，程序数据的名称与其他数据或程序的名称不一定相同。全局程序数据的 名称与另一模块中的全局数据或程序的名称不一定相同。

程序数据
程序内声明的数据被称作程序数据。注意程序参数也同样按程序数据处理。程序数据 适用的范围规则如下：
- 程序数据的范围由其所处程序构成；
- 在范围内，程序数据会隐藏名称相同的其他所有程序或数据。 程序数据的名称与同一程序中其他数据或标号的名称不一定相同。

示例
在该示例中，可从程序e中调用下述数据：
- 模块1：数据c和d；
- 模块2：数据a、f、g和e1。
可从程序h中调用下述数据：
- 模块1：数据d；
- 模块2：数据a、f、g、h1和c。

1.2.2 数据声明

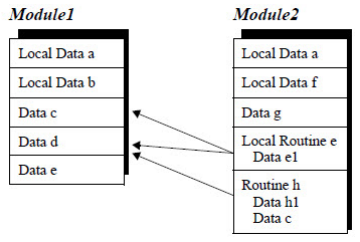
[picture p25: figure]

xx1100000554

变量声明
通过变量声明可引入变量。同时变量也可作全局（无需命令）或局部变量声明。 例子：

MainModule已加载到任务T_ROB1。

MODULE MainModule

! The scope of this variable is within T_ROB1, i.e. it can be

! accessed from any module in T_ROB1.

VAR num global_var := 123;

! The scope of this variable is within this module.

LOCAL VAR num local_var := 789;

PROC main()

! The scope of this variable is within this procedure.

VAR num local_var2 := 321;

ENDPROC

ENDMODULE
在已安装共享的模块中声明的变量可以使用TASK来声明，请参阅，技术参考手册-系 统参数, 主题 Controller, 类型 Automatic Loading of Modules。这样的变量可以从所 有任务中访问，但是每个任务都有一个惟一的值。例如，从一个任务更改变量值不会 影响其他任务。
例子：

SharedModule在系统中为共享安装。

MODULE SharedModule(SYSMODULE)

! This variable is accessible from all tasks, but has a

! unique value for each task.

TASK VAR num global_var := 123;

ENDMODULE
在为共享安装的模块中使用TASK命令将不会有效果。

1.2.2 数据声明

通过在声明中添加阶数信息，可赋予任一类变量一种数组（1阶、2阶和3阶）形式。 阶数是大于0的整数值。
例子：

VAR pos pallet{14, 18};
可初始化含各类数值的变量（赋予一个初始值）。程序变量初始化所用的表达式必须 为常量表达式。注意，也可用未初始化变量的数值，只是该值未定义，如果为num则 设为零。如果是字符串则设为空字符串，如果是布尔值则设置为 FALSE。
例子：

VAR string author_name := "John Smith";

VAR pos start := [100, 100, 50];

VAR num maxno{10} := [1, 2, 3, 9, 8, 7, 6, 5, 4, 3];
出现如下状况时，即设置初始化值：
- 已加载程序/模块。
- 程序指针重置，例如程序指针指向main。

永久数据对象声明
只能在模块级进行永久数据对象声明，在程序内不能。可作系统全局（无需命令）、 任务全局或局部永久数据对象声明。
例子：

下列模块同时加载到T_ROB1和T_ROB2.

MODULE MainModule

! The scope of this persistent is within the task it’s been

! loaded to. But, it will share the current value with any

! other task declaring the same persistent. I.e. changing the

! value in T_ROB1 will automatically change the value in T_ROB2.

PERS num globalpers := 123;

! The scope of this persistent is within the task this

! module has been loaded to.

TASK PERS num taskpers := 456;

! The scope of this persistent is within this module.

LOCAL PERS num localpers := 789;

ENDMODULE
必须赋予局部和任务全局永久数据对象一个初始化值。而对于系统全局永久数据对象， 可忽略初始值。初始化值必须为单一值（不含数据引用对象或数据运算对象）或由多 个单一值或单一聚合体构成的单一聚合体。
例子：

PERS pos refpnt := [100.23, 778.55, 1183.98];
通过在声明中添加阶数信息，可赋予任一类永久数据对象一种数组（1阶、2阶和3阶） 形式。阶数是大于0的整数值。
例子：

PERS pos pallet{14, 18} := [...];
注意，永久数据对象的当前值变更时，永久数据对象声明的初始化值（若未忽略）也 会随之更新。但在程序执行期间，因执行问题，不会更新。保存模块（备份

1.2.2 数据声明

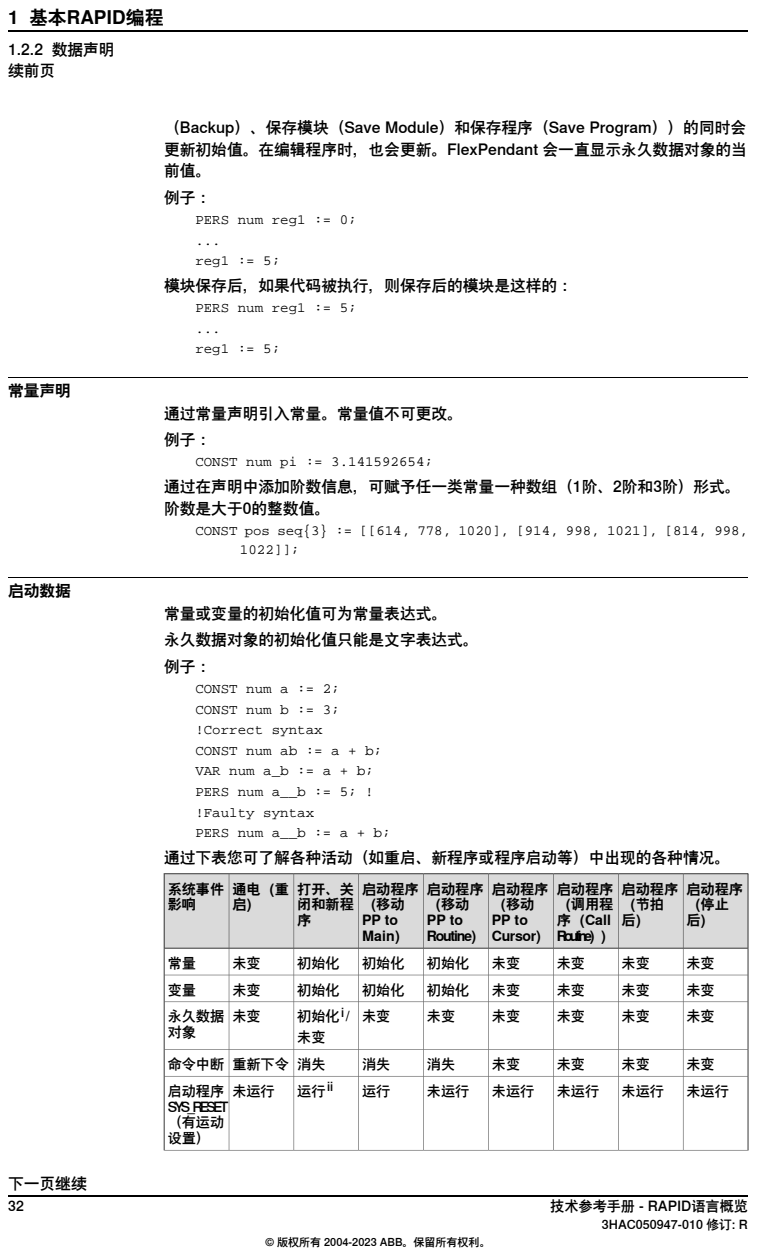
[picture p26: page 32]
PERS num reg1 := 0;; reg1 := 5; 模块保存后，如果代码被执行，则保存后的模块是这样的：; PERS num reg1 := 5;; reg1 := 5;; 常量声明; 通过常量声明引入常量。常量值不可更改。; 启动数据; 常量或变量的初始化值可为常量表达式。; 永久数据对象的初始化值只能是文字表达式。; 启动程序 （停止 后）; 启动程序 （节拍 后）; 启动程序 （调用程 序（Call Routine））; 启动程序 （移动 PP to Cursor）; 启动程序 （移动 PP to Routine）; 启动程序 （移动 PP to Main）; 打开、关 闭和新程 序; 系统事件 影响; 初始化; 永久数据 未变; 初始化i; 命令中断 重新下令 消失; 启动程序 未运行; 运行ii; 未运行; SYS_RESET （有运动 设置）; 1.2.2 数据声明

（Backup）、保存模块（Save Module）和保存程序（Save Program））的同时会
更新初始值。在编辑程序时，也会更新。FlexPendant 会一直显示永久数据对象的当

CONST num pi := 3.141592654;
通过在声明中添加阶数信息，可赋予任一类常量一种数组（1阶、2阶和3阶）形式。
阶数是大于0的整数值。

CONST pos seq{3} := [[614, 778, 1020], [914, 998, 1021], [814, 998,

CONST num a := 2;
CONST num b := 3;
!Correct syntax
CONST num ab := a + b;
VAR num a_b := a + b;
PERS num a__b := 5; !
!Faulty syntax
PERS num a__b := a + b;
通过下表您可了解各种活动（如重启、新程序或程序启动等）中出现的各种情况。

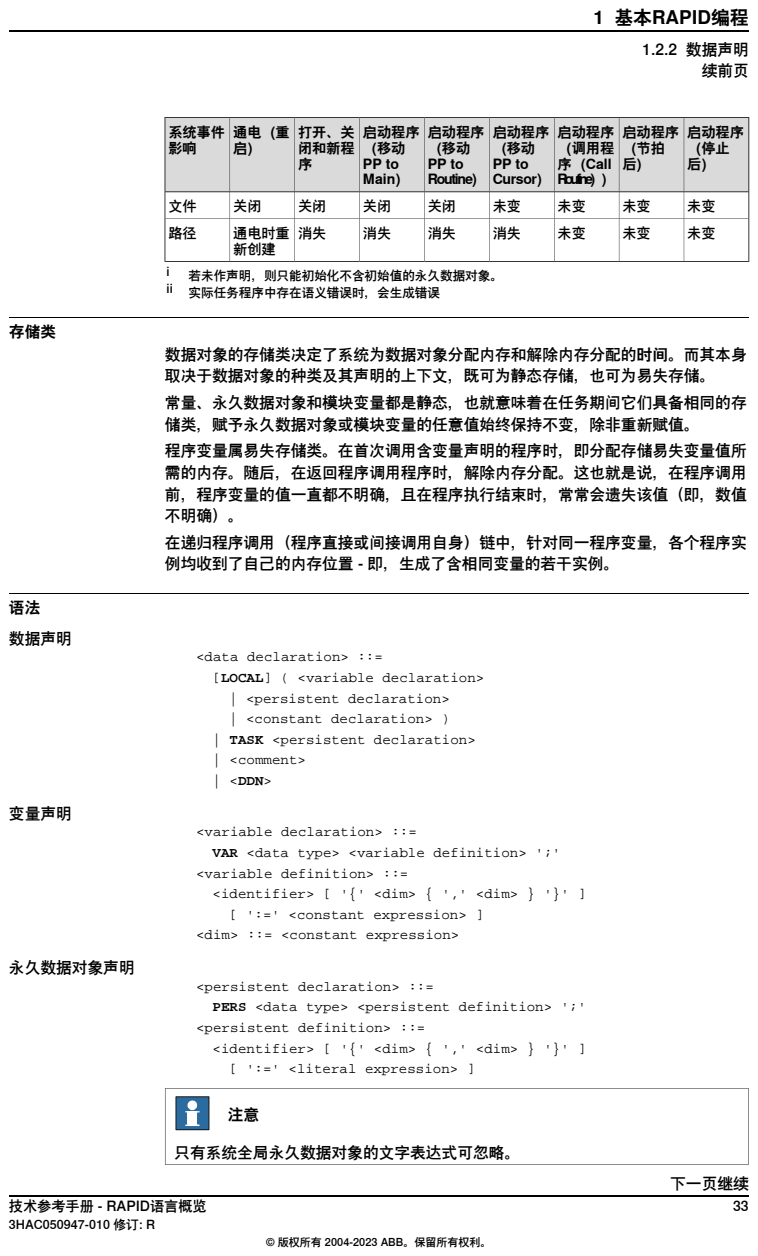
[picture p27: page 33]
启动程序 （停止 后）; 启动程序 （节拍 后）; 启动程序 （调用程 序（Call Routine））; 启动程序 （移动 PP to Cursor）; 启动程序 （移动 PP to Routine）; 启动程序 （移动 PP to Main）; 打开、关 闭和新程 序; 系统事件 影响; 通电时重 消失; 新创建; 若未作声明，则只能初始化不含初始值的永久数据对象。; 实际任务程序中存在语义错误时，会生成错误; 存储类; 数据声明; 变量声明; 永久数据对象声明; [ ':=' <literal expression> ]; 只有系统全局永久数据对象的文字表达式可忽略。; 1.2.2 数据声明

数据对象的存储类决定了系统为数据对象分配内存和解除内存分配的时间。而其本身
取决于数据对象的种类及其声明的上下文，既可为静态存储，也可为易失存储。
常量、永久数据对象和模块变量都是静态，也就意味着在任务期间它们具备相同的存
储类，赋予永久数据对象或模块变量的任意值始终保持不变，除非重新赋值。
程序变量属易失存储类。在首次调用含变量声明的程序时，即分配存储易失变量值所
需的内存。随后，在返回程序调用程序时，解除内存分配。这也就是说，在程序调用
前，程序变量的值一直都不明确，且在程序执行结束时，常常会遗失该值（即，数值
不明确）。
在递归程序调用（程序直接或间接调用自身）链中，针对同一程序变量，各个程序实
例均收到了自己的内存位置 - 即，生成了含相同变量的若干实例。

<data declaration> ::=
[LOCAL] ( <variable declaration>
<persistent declaration>
<constant declaration> )
TASK <persistent declaration>
<comment>
<DDN>

<variable declaration> ::=
VAR <data type> <variable definition> ';'
<variable definition> ::=
<identifier> [ '{' <dim> { ',' <dim> } '}' ]

[ ':=' <constant expression> ]
<dim> ::= <constant expression>

<persistent declaration> ::=
PERS <data type> <persistent definition> ';'
<persistent definition> ::=

常量声明

<constant declaration> ::=

CONST <data type> <constant definition> ';'

<constant definition> ::=

<identifier> [ '{' <dim> { ',' <dim> } '}' ]

':=' <constant expression>

<dim> ::= <constant expression>

1.2.2 数据声明

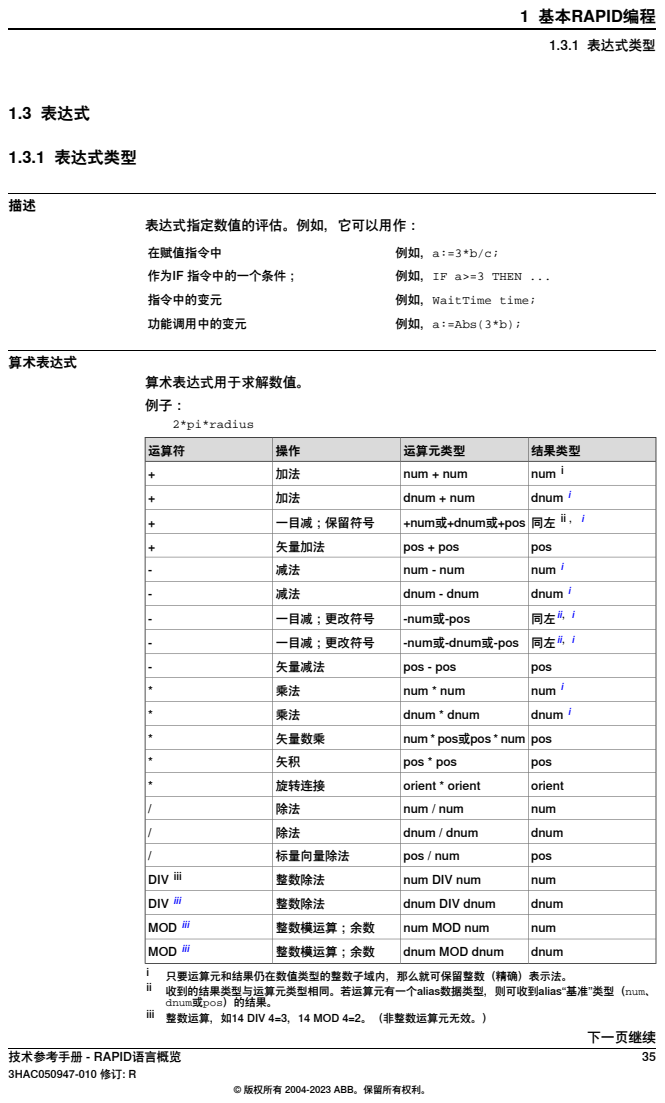
[picture p28: page 35]
1.3 表达式; 1.3.1 表达式类型; 在赋值指令中; 作为IF 指令中的一个条件；; 例如，IF a>=3 THEN ...; 指令中的变元; 例如，WaitTime time;; 功能调用中的变元; 例如，a:=Abs(3*b);; 算术表达式; 算术表达式用于求解数值。; 2*pi*radius; 运算符; 运算元类型; 结果类型; num i +; num + num; dnum i +; dnum + num; 一目减；保留符号; +num或+dnum或+pos; 矢量加法; pos + pos; pos; num i; num - num; dnum i; dnum - dnum; 同左ii，i; 一目减；更改符号; -num或-pos; -num或-dnum或-pos; 矢量减法; pos - pos; num * num; dnum * dnum; 矢量数乘; num * pos或pos * num pos; pos * pos; 旋转连接; orient * orient; orient; num / num; num; dnum / dnum; dnum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

表达式指定数值的评估。例如，它可以用作：

dnum或pos）的结果。
iii 整数运算，如14 DIV 4=3，14 MOD 4=2。（非整数运算元无效。）

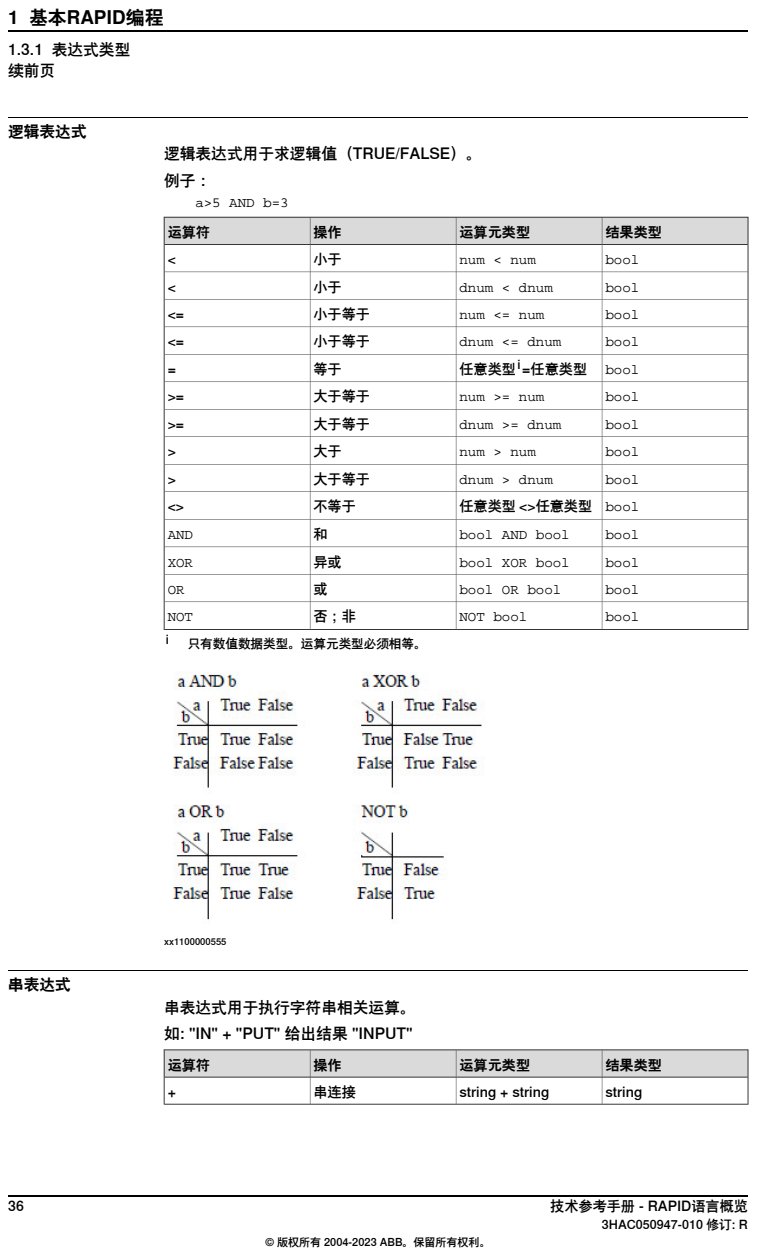
[picture p29: page 36]
逻辑表达式; a>5 AND b=3; 运算符; 运算元类型; 结果类型; num < num; bool; dnum < dnum; 小于等于; num <= num; dnum <= dnum; 任意类型; bool i =; =任意类型; 大于等于; num >= num; dnum >= dnum; num > num; dnum > dnum; 不等于; 任意类型 <>任意类型 bool; AND; bool AND bool; XOR; bool XOR bool; bool OR bool; NOT; NOT bool; 只有数值数据类型。运算元类型必须相等。; 串表达式; 串连接; string + string; string; 1.3.1 表达式类型

逻辑表达式用于求逻辑值（TRUE/FALSE）。

串表达式用于执行字符串相关运算。
如: "IN" + "PUT" 给出结果 "INPUT"

### 1.3.2 运用表达式中的数据

简介
变量、永久数据对象或常量整体可作为表达式的组成部分。 例子：

2*pi*radius

数组
整个数组或单一元素中可引用声明为数组的变量、永久数据对象或常量。 运用元素的索引号引用数组元素。索引号为大于0的整数值，不会违背所声明的阶数。 索引值1对应的是第一个元素。索引表中的元素量必须与声明的数组阶数（1阶、2阶 或3阶）相配。
例子：

VAR num row{3};

VAR num column{3};

VAR num value;

! get one element from the array value := column{3};

! get all elements in the array

row := column;

记录
整个记录或单一部分中可引用声明为记录的变量、永久数据对象或常量。 运用部分名称引用记录部分。
例子：

VAR pos home;

VAR pos pos1;

VAR num yvalue;

! get the Y component only

yvalue := home.y;

! get the whole position

pos1 := home;

1.3.2 运用表达式中的数据

### 1.3.3 运用表达式中的聚合体

简介
聚合体可用于记录或数组数值中。
例子：

! pos record aggregate

pos := [x, y, 2*x];

! pos array aggregate

posarr := [[0, 0, 100], [0,0,z]];

操作前提
必须根据上下文确定范围内聚合项的数据类型。各聚合项的数据类型必须等于类型确 定的相应项的类型。
示例（通过p1确定的聚合类型pos - ）：

VAR pos pl;

p1 :=[1, -100, 12];
不允许存在（由于任意聚合体的数据类型都不能通过范围决定，因此不允许存在）的 示例：

VAR pos pl;

IF [1, -100, 12] = [a,b,b,] THEN

1.3.3 运用表达式中的聚合体

### 1.3.4 运用表达式中的函数调用

简介
通过函数调用，求特定函数的值，同时接收函数返回的值。 例子：

Sin(angle)

变元
运用函数调用的参数将数据传递至所调用的函数（及也可从调用的函数中调动数据）。 参数的数据类型必须与相应函数参数的类型相同。可选参数可忽略，但（当前）参数 的顺序必须与形参的顺序相同。此外，声明两个及两个以上可选参数相互排斥，在此

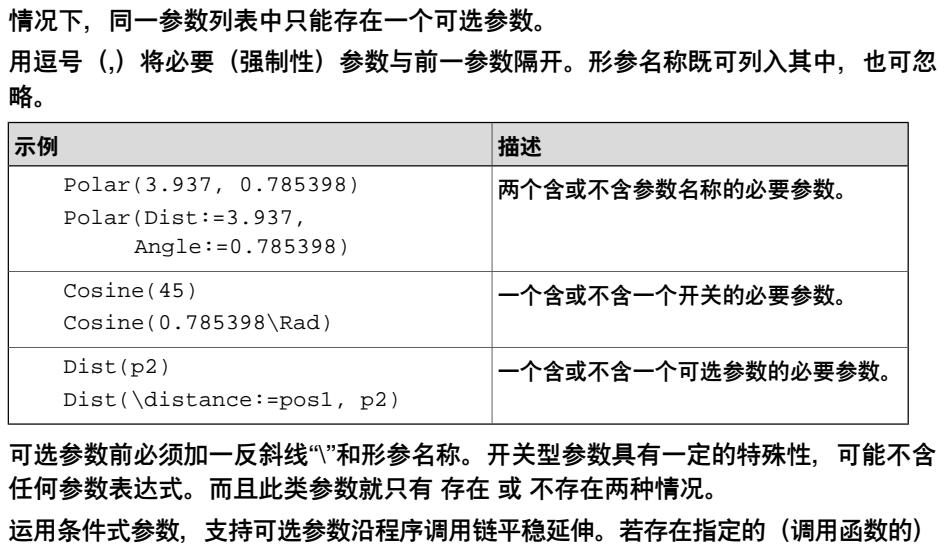
[picture p30: figure]
情况下，同一参数列表中只能存在一个可选参数。; 用逗号（,）将必要（强制性）参数与前一参数隔开。形参名称既可列入其中，也可忽 略。; Polar(3.937, 0.785398); 两个含或不含参数名称的必要参数。; Polar(Dist:=3.937,; Angle:=0.785398); Cosine(45); 一个含或不含一个开关的必要参数。; Cosine(0.785398\Rad); Dist(p2); 一个含或不含一个可选参数的必要参数。; Dist(\distance:=pos1, p2); 可选参数前必须加一反斜线“\”和形参名称。开关型参数具有一定的特殊性，可能不含 任何参数表达式。而且此类参数就只有 存在 或 不存在两种情况。; 运用条件式参数，支持可选参数沿程序调用链平稳延伸。若存在指定的（调用函数的）

可选参数，则可以认为条件式参数“存在”，反之则可认为已忽略。注意指定参数必须 为可选参数。
例子：

PROC Read_from_file (iodev File \num Maxtime)

character:=ReadBin (File \Time?Maxtime);

! Max. time is only used if specified when calling the routine

! Read_from_file

ENDPROC

参数
函数参数列表为各个参数指定了一种访问模式。访问模式包括in、inout、var或pers：
- 一个IN参数（默认）允许参数成为任意表达式。所调用的函数将该参数视作常 量。
- 一个INOUT参数要求相应参数为变量（整体、数组元素或记录部分）或一个永 久数据对象整体。所调用的函数可全面（读/写）接入参数。
- 一个VAR参数要求相应参数为变量（整体、数组元素或记录部分）。所调用的函 数可全面（读/写）接入参数。

1.3.4 运用表达式中的函数调用

- 一个PERS参数要求相应参数为永久数据对象整体。所调用的函数可全面（读/更 新）接入参数。

1.3.4 运用表达式中的函数调用

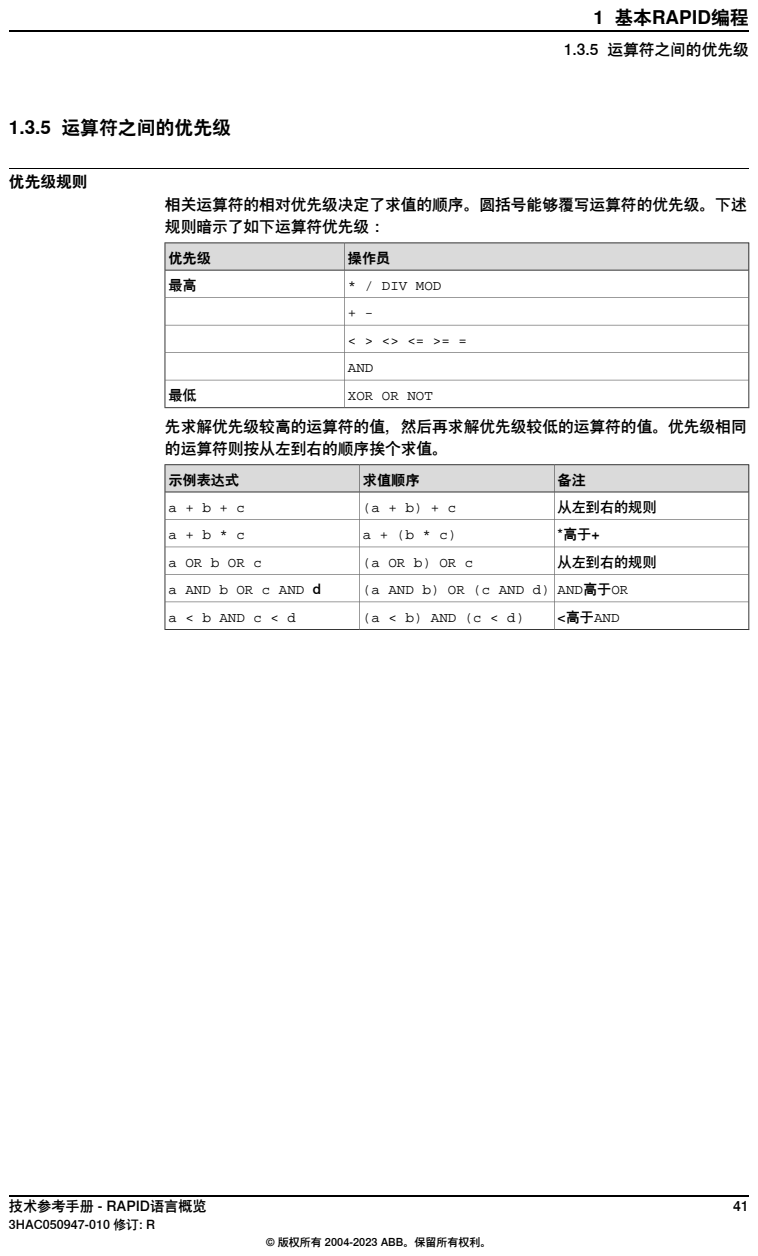
[picture p31: page 41]
1.3.5 运算符之间的优先级; 优先级规则; 优先级; 操作员; * / DIV MOD; AND; XOR OR NOT; 示例表达式; 求值顺序; 从左到右的规则; a AND b OR c AND d; (a AND b) OR (c AND d) AND高于OR; a < b AND c < d; (a < b) AND (c < d); <高于AND

相关运算符的相对优先级决定了求值的顺序。圆括号能够覆写运算符的优先级。下述
规则暗示了如下运算符优先级：

先求解优先级较高的运算符的值，然后再求解优先级较低的运算符的值。优先级相同
的运算符则按从左到右的顺序挨个求值。

### 1.3.6 语法

表达式

<expression> ::= <expr> | <EXP>
<expr> ::= [ NOT ] <logical term> { ( OR | XOR ) <logical term> }

<logical term> ::= <relation> { AND <relation> }

<relation> ::= <simple expr> [ <relop> <simple expr> ]

<simple expr> ::= [ <addop> ] <term> { <addop> <term> }

<term> ::= <primary> { <mulop> <primary> }

<primary> ::=

<literal>

| <variable>

| <persistent>

| <constant>

| <parameter>

| <function call>

| <aggregate>

| '(' <expr> ')'

操作员

<relop> ::= '<' | '<=' | '=' | '>' | '>=' | '<>'
<addop> ::= '+' | '-'
<mulop> ::= '*' | '/' | DIV | MOD

常量值

<literal> ::= <num literal>

| <string literal>

| <bool literal>

数据

<variable> ::=

<entire variable>

| <variable element>

| <variable component>

<entire variable> ::= <ident>

<variable element> ::= <entire variable> '{' <index list> '}'

<index list> ::= <expr> { ',' <expr> }

<variable component> ::= <variable> '.' <component name>

<component name> ::= <ident>

<persistent> ::=

<entire persistent>

| <persistent element>

| <persistent component>

<constant> ::=

<entire constant>

| <constant element>

| <constant component>

聚合体

<aggregate> ::= '[' <expr> { ',' <expr> } ']'

1.3.6 语法

函数调用

<function call> ::= <function> '(' [ <function argument list> ] ')'

<function> ::= <ident>

<function argument list> ::= <first function argument> { <function argument> }

<first function argument> ::=

<required function argument>

| <optional function argument>

| <conditional function argument>

<function argument> ::=

',' <required function argument>

| <optional function argument>

| ',' <optional function argument>

| <conditional function argument>

| ',' <conditional function argument>

<required function argument> ::= [ <ident> ':=' ] <expr>

<optional function argument> ::= '\' <ident> [ ':=' <expr> ]

<conditional function argument> ::= '\' <ident> '?' <parameter>

特殊表达式

<constant expression> ::= <expression>

<literal expression> ::= <expression>

<conditional expression> ::= <expression>

参数

<parameter> ::=

<entire parameter>

| <parameter element>

| <parameter component>

1.3.6 语法

### 1.4 指令：

描述
连续执行指令，除非程序流程指令或中断或错误导致执行中途中断，然后接着继续。 多数指令都通过分号(;)终止。标号通过冒号 (:)终止。有些指令可能含有其他指令，要 通过具体关键词才能终止：
指令 | 终止词
IF | ENDIF
FOR | ENDFOR
WHILE | ENDWHILE
TEST | ENDTEST

例子：

WHILE index < 100 DO

| index := index + 1;

ENDWHILE

拾取列表
所有指令按指定组集合到一起。有关分组情况，详见下文。其分组可参见在 FlexPendant 示教器程序编辑器上给程序添加新指令时所用的参数选用表中的分组情 况，两者相同。

语法

<instruction list> ::= { <instruction> }

<instruction> ::=

| [<instruction according to separate chapter in this manual>

| <SMT>

1.4 指令：

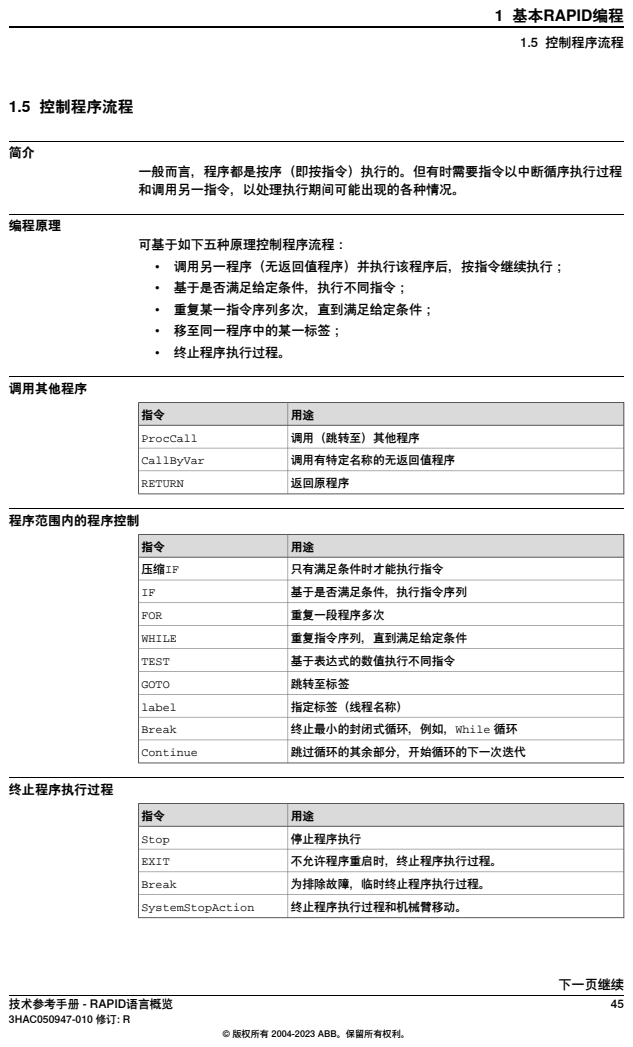
[picture p32: page 45]
1.5 控制程序流程; 编程原理; 调用其他程序; ProcCall; 调用（跳转至）其他程序; CallByVar; 调用有特定名称的无返回值程序; RETURN; 返回原程序; 程序范围内的程序控制; 压缩IF; 只有满足条件时才能执行指令; 基于是否满足条件，执行指令序列; FOR; 重复一段程序多次; WHILE; 重复指令序列，直到满足给定条件; TEST; 基于表达式的数值执行不同指令; GOTO; 跳转至标签; label; 指定标签（线程名称）; Break; 终止最小的封闭式循环，例如，While 循环; Continue; 跳过循环的其余部分，开始循环的下一次迭代; 终止程序执行过程; Stop; 停止程序执行; EXIT; 不允许程序重启时，终止程序执行过程。; 为排除故障，临时终止程序执行过程。; SystemStopAction; 终止程序执行过程和机械臂移动。

一般而言，程序都是按序（即按指令）执行的。但有时需要指令以中断循序执行过程
和调用另一指令，以处理执行期间可能出现的各种情况。

可基于如下五种原理控制程序流程：
• 调用另一程序（无返回值程序）并执行该程序后，按指令继续执行；
• 基于是否满足给定条件，执行不同指令；
• 重复某一指令序列多次，直到满足给定条件；
• 移至同一程序中的某一标签；
• 终止程序执行过程。

终止当前循环

指令 | 用途
ExitCycle | 终止当前循环，将程序指针移至主程序中第一个指令处。 选中执行模式CONT后，在下一程序循环中，继续执行。

1.5 控制程序流程

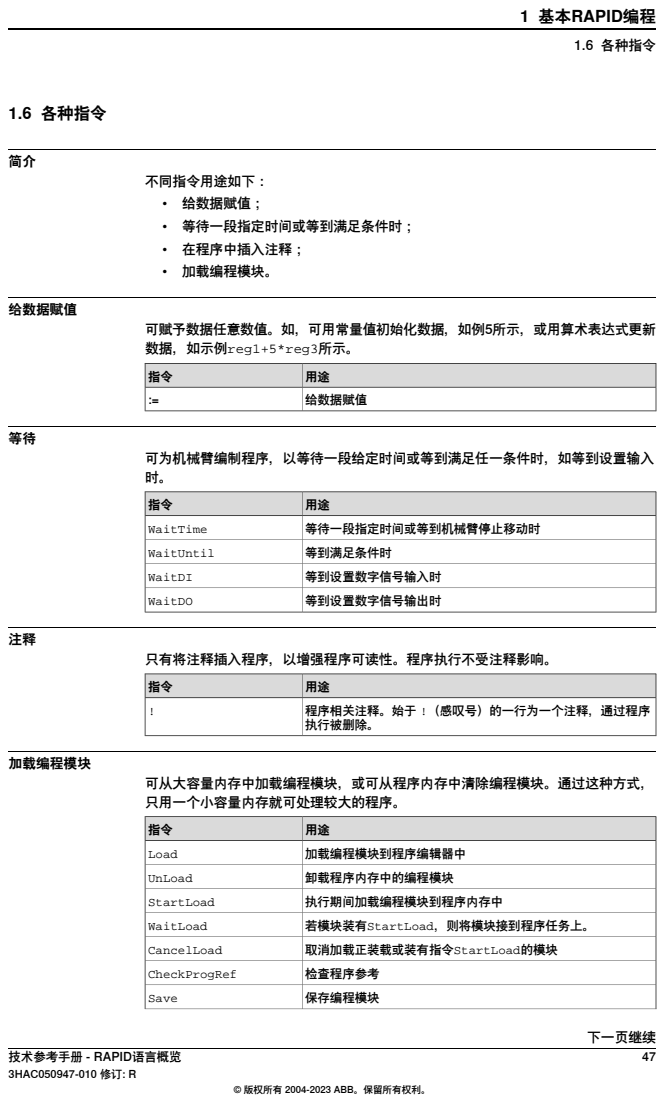
[picture p33: page 47]
1.6 各种指令; 不同指令用途如下：; • 给数据赋值；; • 等待一段指定时间或等到满足条件时；; • 在程序中插入注释；; • 加载编程模块。; 给数据赋值; WaitTime; 等待一段指定时间或等到机械臂停止移动时; WaitUntil; 等到满足条件时; WaitDI; 等到设置数字信号输入时; WaitDO; 等到设置数字信号输出时; 加载编程模块; Load; 加载编程模块到程序编辑器中; UnLoad; 卸载程序内存中的编程模块; StartLoad; 执行期间加载编程模块到程序内存中; WaitLoad; 若模块装有StartLoad，则将模块接到程序任务上。; CancelLoad; 取消加载正装载或装有指令StartLoad的模块; CheckProgRef; 检查程序参考; Save; 保存编程模块

可赋予数据任意数值。如，可用常量值初始化数据，如例5所示，或用算术表达式更新
数据，如示例reg1+5*reg3所示。

可为机械臂编制程序，以等待一段给定时间或等到满足任一条件时，如等到设置输入

只有将注释插入程序，以增强程序可读性。程序执行不受注释影响。

程序相关注释。始于 !（感叹号）的一行为一个注释，通过程序
执行被删除。

可从大容量内存中加载编程模块，或可从程序内存中清除编程模块。通过这种方式，
只用一个小容量内存就可处理较大的程序。

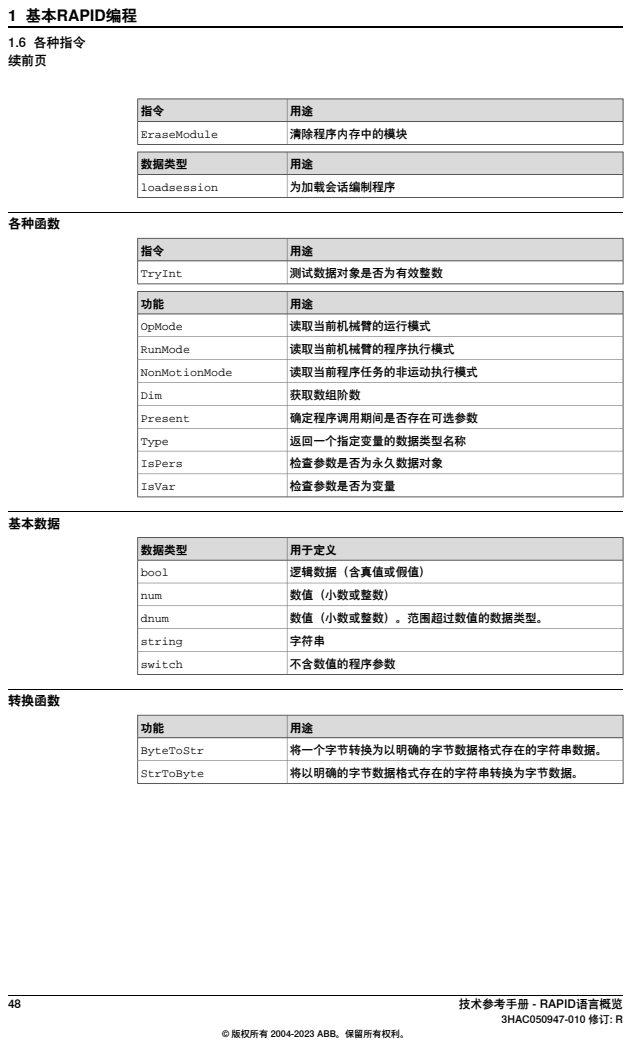
[picture p34: page 48]
EraseModule; 清除程序内存中的模块; 数据类型; loadsession; 为加载会话编制程序; 各种函数; TryInt; 测试数据对象是否为有效整数; OpMode; 读取当前机械臂的运行模式; RunMode; 读取当前机械臂的程序执行模式; NonMotionMode; 读取当前程序任务的非运动执行模式; Dim; 获取数组阶数; Present; 确定程序调用期间是否存在可选参数; Type; 返回一个指定变量的数据类型名称; IsPers; 检查参数是否为永久数据对象; IsVar; 检查参数是否为变量; 基本数据; 用于定义; bool; 逻辑数据（含真值或假值）; num; 数值（小数或整数）; dnum; 数值（小数或整数）。范围超过数值的数据类型。; string; 字符串; switch; 不含数值的程序参数; 转换函数; ByteToStr; 将一个字节转换为以明确的字节数据格式存在的字符串数据。; StrToByte; 将以明确的字节数据格式存在的字符串转换为字节数据。; 1.6 各种指令

### 1.7 运动设置

简介
运用应用于所有运动的逻辑指令确定机械臂的部分运动特征：
- 工具中心接触点（TCP）最大速度
- 最高速率和速率覆盖
- 加速度
- 不同机械臂配置的管理
- 有效载荷
- 接近奇点时的行为
- 程序位移
- 软伺服
- 调整值
- 事件缓冲区的启用和停用
- 抑制圆角路径警告

编程原理
机械臂运动的基本特征取决于为各个定位指令指定的数据。但部分数据是通过在数据 变更前一直适用于所有运动的不同指令指定。

运用多个指令明确一般运动设置，另外，也可用系统变量C_MOTSET或C_PROGDISP
读取一般运动设置。

自动设置默认值（通过执行系统模块BASE_SHARED中的程序SYS_RESET）。
- 使用重启模式重置系统时；
- 加载新的程序时；
- 从起点开始启动程序时。

工具中心接触点（TCP）最大速度函数

功能 | 用途
MaxRobSpeed | 返回所用的机械臂类型的工具中心接触点最大速度

确定速率
将绝对速率设为定位指令中的参数。除此以外，也可确定最高速率和速率覆盖（设定 速率的百分比）。
同时，可设置速度限值，在设置系统输入信号时，对速度加以限制。
指令 | 用于定义
VelSet | 最高速率和速率覆盖
SpeedRefresh | 更新持续运动速率覆盖
SpeedLimAxis | 设置轴的速度限值。随后，通过系统输入信号加以应用。
SpeedLimCheckPoint | 设置检查点的速度限值。随后，通过系统输入信号加以应用。

1.7 运动设置

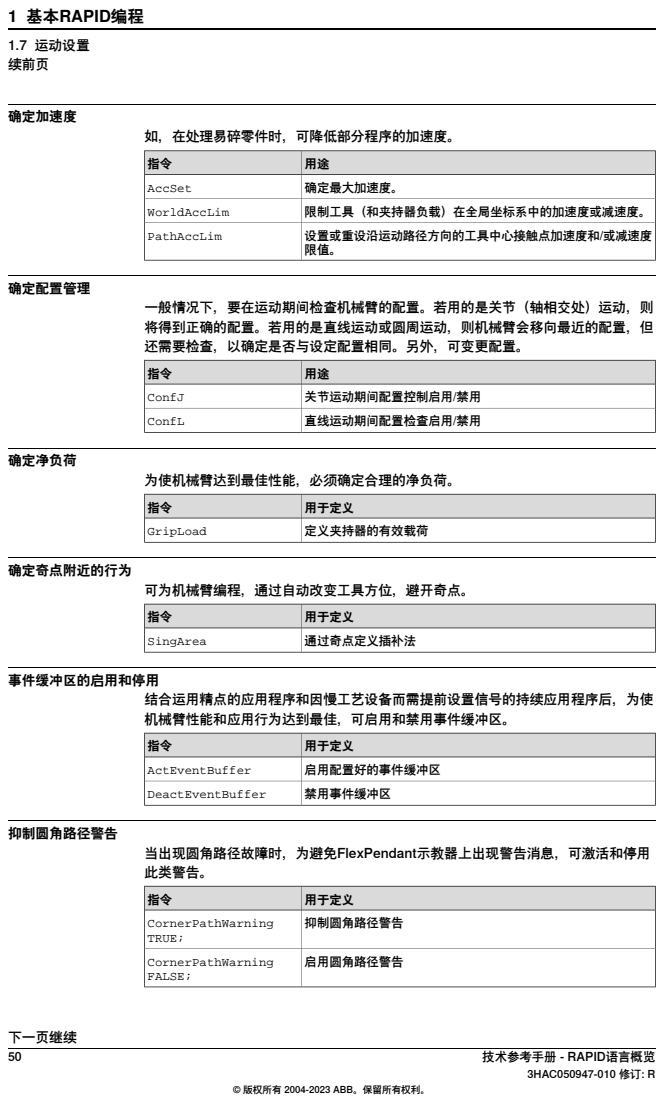
[picture p35: page 50]
确定加速度; 如，在处理易碎零件时，可降低部分程序的加速度。; AccSet; 确定最大加速度。; WorldAccLim; 限制工具（和夹持器负载）在全局坐标系中的加速度或减速度。; 设置或重设沿运动路径方向的工具中心接触点加速度和/或减速度 限值。; PathAccLim; 确定配置管理; ConfJ; 关节运动期间配置控制启用/禁用; ConfL; 直线运动期间配置检查启用/禁用; 确定净负荷; 为使机械臂达到最佳性能，必须确定合理的净负荷。; 用于定义; GripLoad; 定义夹持器的有效载荷; 确定奇点附近的行为; SingArea; 通过奇点定义插补法; 事件缓冲区的启用和停用 结合运用精点的应用程序和因慢工艺设备而需提前设置信号的持续应用程序后，为使 机械臂性能和应用行为达到最佳，可启用和禁用事件缓冲区。; ActEventBuffer; 启用配置好的事件缓冲区; DeactEventBuffer; 禁用事件缓冲区; 抑制圆角路径警告; CornerPathWarning; TRUE;; 启用圆角路径警告; FALSE;; 1.7 运动设置

一般情况下，要在运动期间检查机械臂的配置。若用的是关节（轴相交处）运动，则
将得到正确的配置。若用的是直线运动或圆周运动，则机械臂会移向最近的配置，但
还需要检查，以确定是否与设定配置相同。另外，可变更配置。

可为机械臂编程，通过自动改变工具方位，避开奇点。

当出现圆角路径故障时，为避免FlexPendant示教器上出现警告消息，可激活和停用
此类警告。

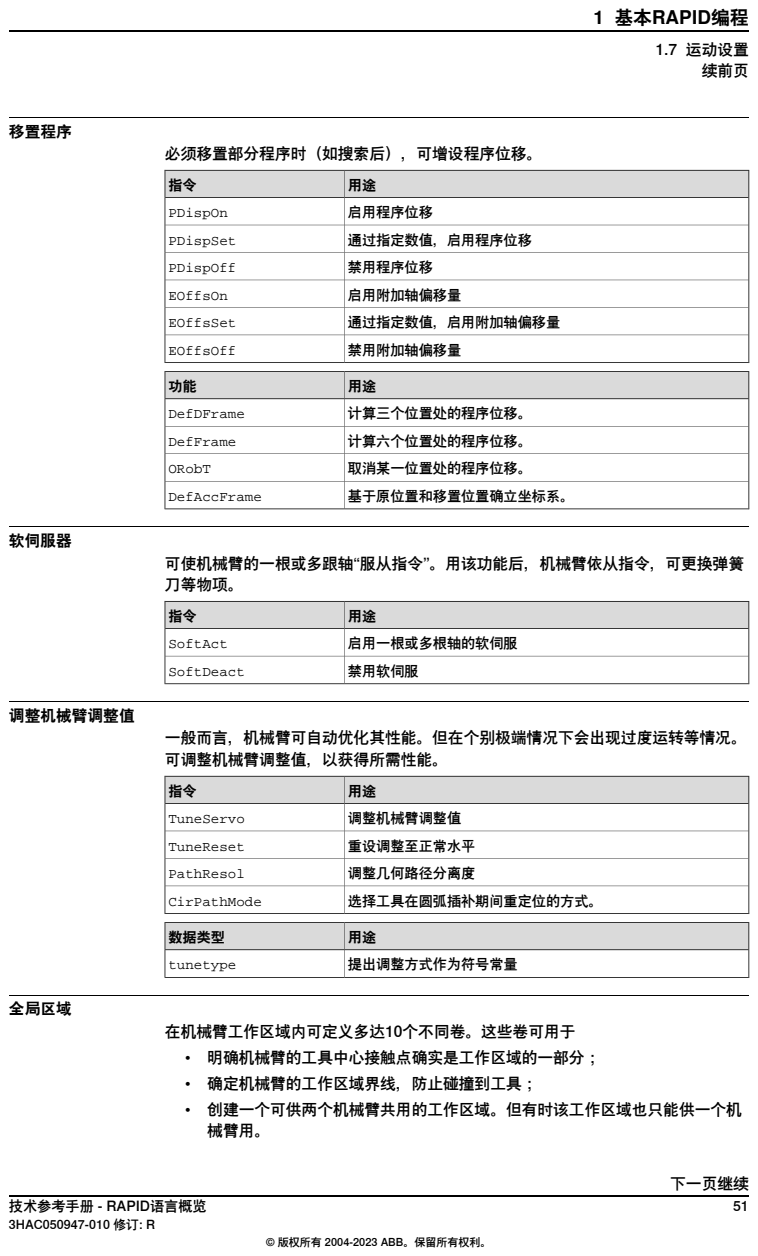
[picture p36: page 51]
移置程序; PDispOn; 启用程序位移; PDispSet; 通过指定数值，启用程序位移; PDispOff; 禁用程序位移; EOffsOn; 启用附加轴偏移量; EOffsSet; 通过指定数值，启用附加轴偏移量; EOffsOff; 禁用附加轴偏移量; DefDFrame; 计算三个位置处的程序位移。; DefFrame; 计算六个位置处的程序位移。; ORobT; 取消某一位置处的程序位移。; DefAccFrame; 基于原位置和移置位置确立坐标系。; 软伺服器; SoftAct; 启用一根或多根轴的软伺服; SoftDeact; 禁用软伺服; 调整机械臂调整值; TuneServo; TuneReset; 重设调整至正常水平; PathResol; 调整几何路径分离度; CirPathMode; 选择工具在圆弧插补期间重定位的方式。; 数据类型; tunetype; 提出调整方式作为符号常量; 全局区域; 在机械臂工作区域内可定义多达10个不同卷。这些卷可用于; • 明确机械臂的工具中心接触点确实是工作区域的一部分；; • 确定机械臂的工作区域界线，防止碰撞到工具；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

必须移置部分程序时（如搜索后），可增设程序位移。

可使机械臂的一根或多跟轴“服从指令”。用该功能后，机械臂依从指令，可更换弹簧
刀等物项。

一般而言，机械臂可自动优化其性能。但在个别极端情况下会出现过度运转等情况。
可调整机械臂调整值，以获得所需性能。

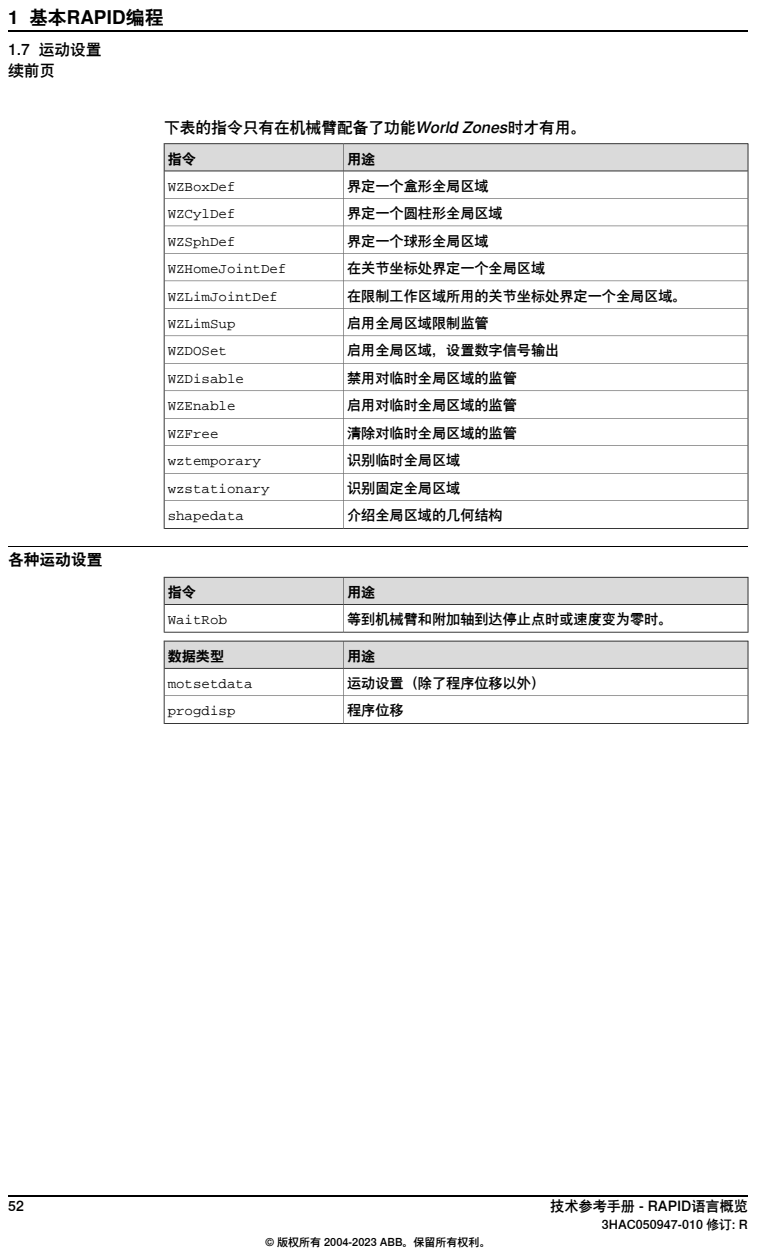
[picture p37: page 52]
下表的指令只有在机械臂配备了功能World Zones时才有用。; WZBoxDef; 界定一个盒形全局区域; WZCylDef; 界定一个圆柱形全局区域; WZSphDef; 界定一个球形全局区域; WZHomeJointDef; 在关节坐标处界定一个全局区域; WZLimJointDef; 在限制工作区域所用的关节坐标处界定一个全局区域。; WZLimSup; 启用全局区域限制监管; WZDOSet; 启用全局区域，设置数字信号输出; WZDisable; 禁用对临时全局区域的监管; WZEnable; 启用对临时全局区域的监管; WZFree; 清除对临时全局区域的监管; wztemporary; 识别临时全局区域; wzstationary; 识别固定全局区域; shapedata; 介绍全局区域的几何结构; 各种运动设置; WaitRob; 等到机械臂和附加轴到达停止点时或速度变为零时。; 数据类型; motsetdata; 运动设置（除了程序位移以外）; progdisp; 程序位移; 1.7 运动设置

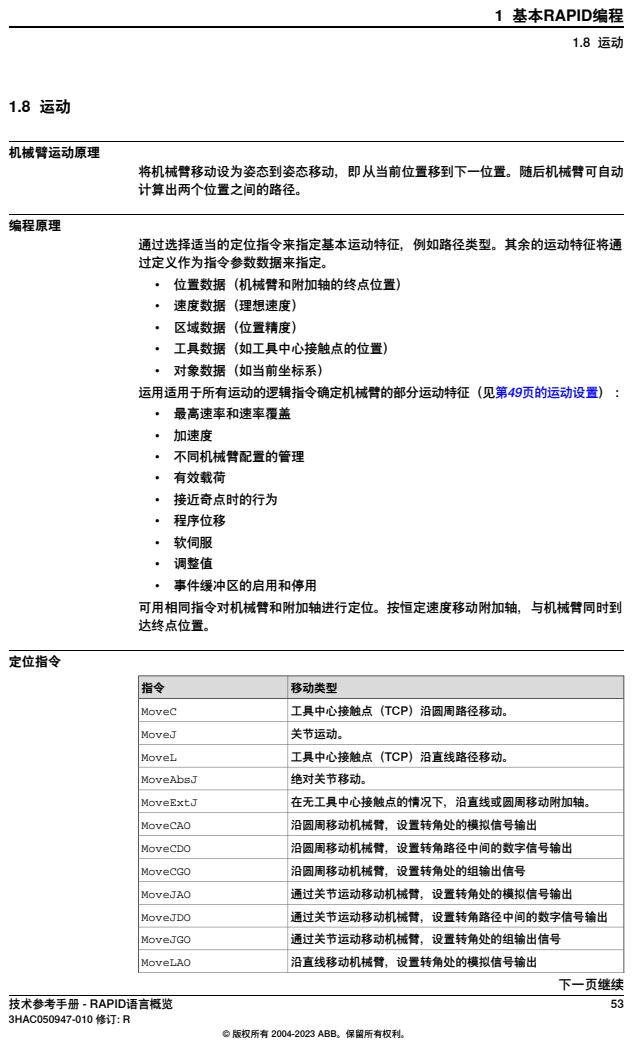
[picture p38: page 53]
机械臂运动原理; 编程原理; 通过选择适当的定位指令来指定基本运动特征，例如路径类型。其余的运动特征将通 过定义作为指令参数数据来指定。; • 位置数据（机械臂和附加轴的终点位置）; • 速度数据（理想速度）; • 区域数据（位置精度）; • 工具数据（如工具中心接触点的位置）; • 对象数据（如当前坐标系）; 运用适用于所有运动的逻辑指令确定机械臂的部分运动特征（见第49页的运动设置）：; • 最高速率和速率覆盖; • 加速度; • 不同机械臂配置的管理; • 有效载荷; • 接近奇点时的行为; • 程序位移; • 软伺服; • 调整值; • 事件缓冲区的启用和停用; 可用相同指令对机械臂和附加轴进行定位。按恒定速度移动附加轴，与机械臂同时到 达终点位置。; 定位指令; 移动类型; MoveC; 工具中心接触点（TCP）沿圆周路径移动。; MoveJ; 关节运动。; MoveL; 工具中心接触点（TCP）沿直线路径移动。; MoveAbsJ; 绝对关节移动。; MoveExtJ; 在无工具中心接触点的情况下，沿直线或圆周移动附加轴。; MoveCAO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

将机械臂移动设为姿态到姿态移动，即从当前位置移到下一位置。随后机械臂可自动
计算出两个位置之间的路径。

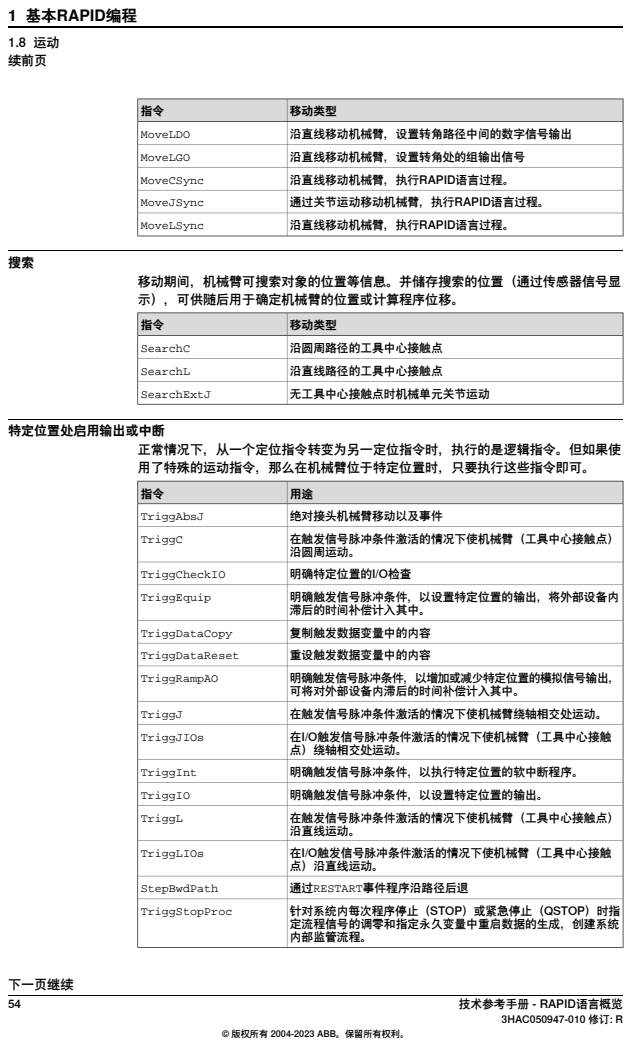
[picture p39: page 54]
移动类型; MoveLDO; 沿直线移动机械臂，设置转角路径中间的数字信号输出; MoveLGO; 沿直线移动机械臂，设置转角处的组输出信号; MoveCSync; 沿直线移动机械臂，执行RAPID语言过程。; MoveJSync; 通过关节运动移动机械臂，执行RAPID语言过程。; MoveLSync; SearchC; 沿圆周路径的工具中心接触点; SearchL; 沿直线路径的工具中心接触点; SearchExtJ; 无工具中心接触点时机械单元关节运动; 特定位置处启用输出或中断; TriggAbsJ; 绝对接头机械臂移动以及事件; 在触发信号脉冲条件激活的情况下使机械臂（工具中心接触点） 沿圆周运动。; TriggC; TriggCheckIO; 明确特定位置的I/O检查; TriggEquip; TriggDataCopy; 复制触发数据变量中的内容; TriggDataReset; 重设触发数据变量中的内容; 明确触发信号脉冲条件，以增加或减少特定位置的模拟信号输出， 可将对外部设备内滞后的时间补偿计入其中。; TriggRampAO; TriggJ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

移动期间，机械臂可搜索对象的位置等信息。并储存搜索的位置（通过传感器信号显
示），可供随后用于确定机械臂的位置或计算程序位移。

正常情况下，从一个定位指令转变为另一定位指令时，执行的是逻辑指令。但如果使
用了特殊的运动指令，那么在机械臂位于特定位置时，只要执行这些指令即可。

明确触发信号脉冲条件，以设置特定位置的输出，将外部设备内
滞后的时间补偿计入其中。

在I/O触发信号脉冲条件激活的情况下使机械臂（工具中心接触
点）绕轴相交处运动。

在触发信号脉冲条件激活的情况下使机械臂（工具中心接触点）
沿直线运动。
点）沿直线运动。

针对系统内每次程序停止（STOP）或紧急停止（QSTOP）时指
定流程信号的调零和指定永久变量中重启数据的生成，创建系统
内部监管流程。

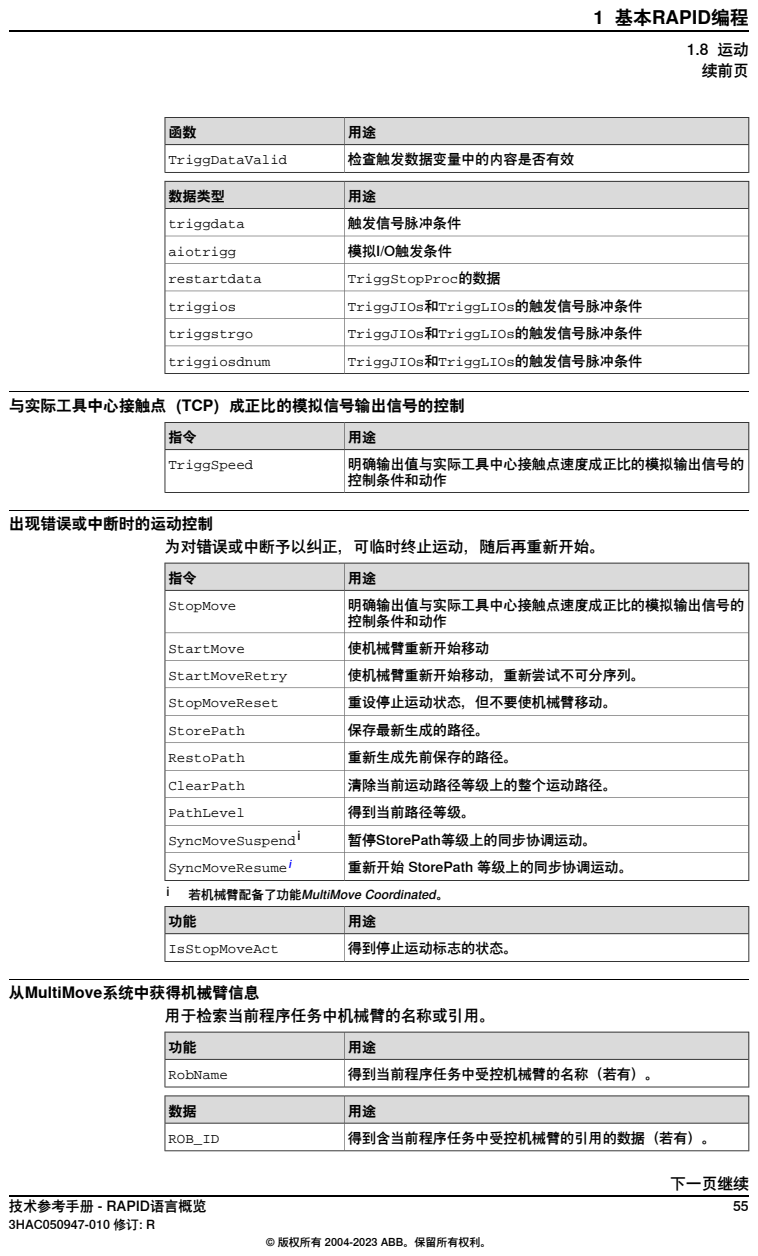
[picture p40: page 55]
TriggDataValid; 检查触发数据变量中的内容是否有效; 数据类型; triggdata; 触发信号脉冲条件; aiotrigg; 模拟I/O触发条件; restartdata; TriggStopProc的数据; triggios; TriggJIOs和TriggLIOs的触发信号脉冲条件; triggstrgo; triggiosdnum; 明确输出值与实际工具中心接触点速度成正比的模拟输出信号的 控制条件和动作; TriggSpeed; 出现错误或中断时的运动控制; StopMove; StartMove; 使机械臂重新开始移动; StartMoveRetry; 使机械臂重新开始移动，重新尝试不可分序列。; StopMoveReset; 重设停止运动状态，但不要使机械臂移动。; StorePath; 保存最新生成的路径。; RestoPath; 重新生成先前保存的路径。; ClearPath; 清除当前运动路径等级上的整个运动路径。; PathLevel; 得到当前路径等级。; SyncMoveSuspendi; 暂停StorePath等级上的同步协调运动。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

与实际工具中心接触点（TCP）成正比的模拟信号输出信号的控制

为对错误或中断予以纠正，可临时终止运动，随后再重新开始。

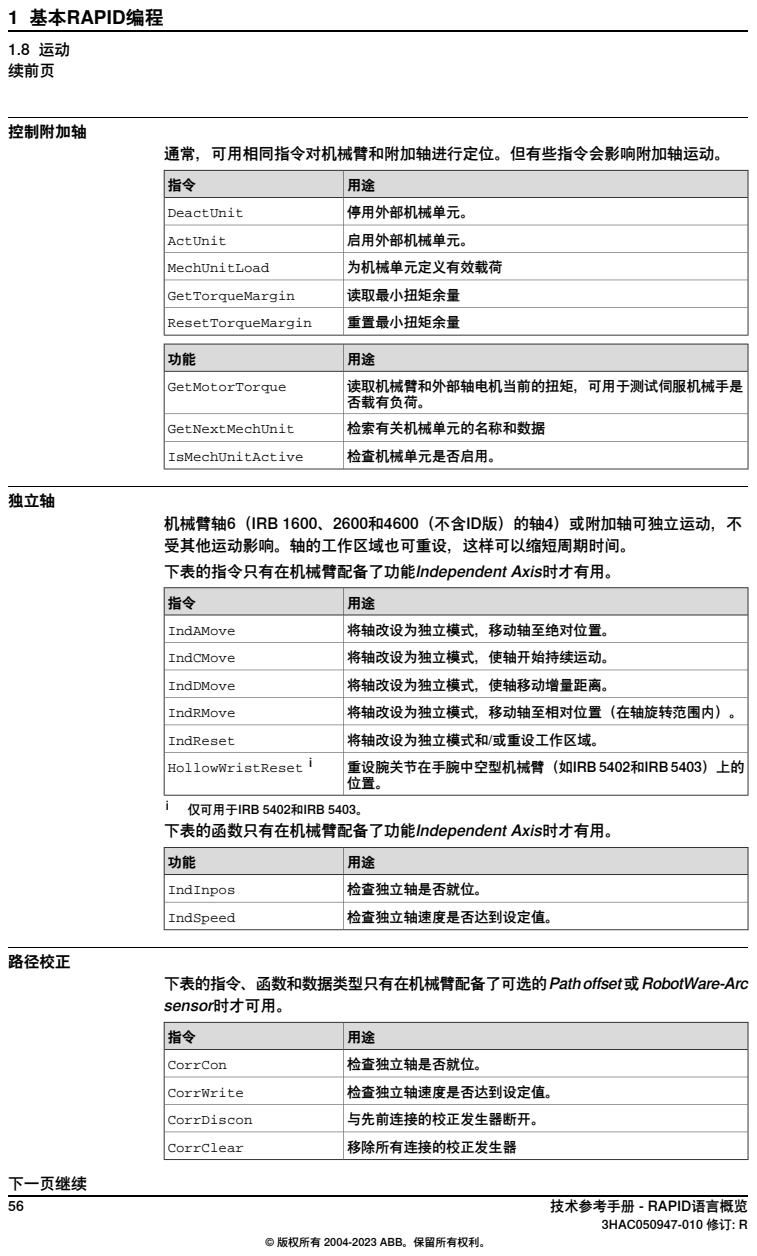
[picture p41: page 56]
控制附加轴; DeactUnit; 停用外部机械单元。; ActUnit; 启用外部机械单元。; MechUnitLoad; 为机械单元定义有效载荷; GetTorqueMargin; 读取最小扭矩余量; ResetTorqueMargin; 重置最小扭矩余量; 读取机械臂和外部轴电机当前的扭矩，可用于测试伺服机械手是 否载有负荷。; GetMotorTorque; GetNextMechUnit; 检索有关机械单元的名称和数据; IsMechUnitActive; 检查机械单元是否启用。; 独立轴; IndAMove; 将轴改设为独立模式，移动轴至绝对位置。; IndCMove; 将轴改设为独立模式，使轴开始持续运动。; IndDMove; 将轴改设为独立模式，使轴移动增量距离。; IndRMove; 将轴改设为独立模式，移动轴至相对位置（在轴旋转范围内）。; IndReset; 将轴改设为独立模式和/或重设工作区域。; 重设腕关节在手腕中空型机械臂（如IRB5402和IRB5403）上的 位置。; HollowWristReset i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

通常，可用相同指令对机械臂和附加轴进行定位。但有些指令会影响附加轴运动。

机械臂轴6（IRB 1600、2600和4600（不含ID版）的轴4）或附加轴可独立运动，不
受其他运动影响。轴的工作区域也可重设，这样可以缩短周期时间。
下表的指令只有在机械臂配备了功能Independent Axis时才有用。

下表的指令、函数和数据类型只有在机械臂配备了可选的Pathoffset或RobotWare-Arc
sensor时才可用。

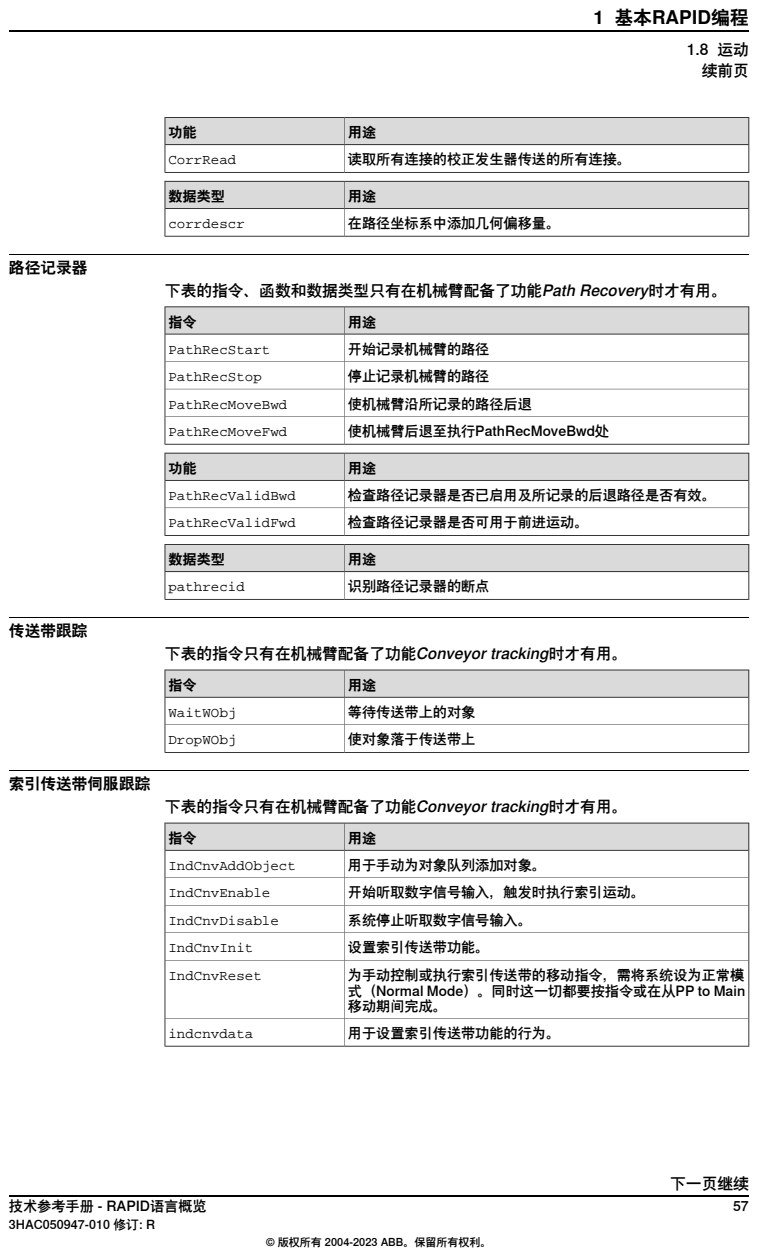
[picture p42: page 57]
CorrRead; 读取所有连接的校正发生器传送的所有连接。; 数据类型; corrdescr; 在路径坐标系中添加几何偏移量。; 路径记录器; PathRecStart; 开始记录机械臂的路径; PathRecStop; 停止记录机械臂的路径; PathRecMoveBwd; 使机械臂沿所记录的路径后退; PathRecMoveFwd; 使机械臂后退至执行PathRecMoveBwd处; PathRecValidBwd; 检查路径记录器是否已启用及所记录的后退路径是否有效。; PathRecValidFwd; 检查路径记录器是否可用于前进运动。; pathrecid; 识别路径记录器的断点; 传送带跟踪; 下表的指令只有在机械臂配备了功能Conveyor tracking时才有用。; WaitWObj; 等待传送带上的对象; DropWObj; 使对象落于传送带上; 索引传送带伺服跟踪; IndCnvAddObject; 用于手动为对象队列添加对象。; IndCnvEnable; 开始听取数字信号输入，触发时执行索引运动。; IndCnvDisable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

下表的指令、函数和数据类型只有在机械臂配备了功能Path Recovery时才有用。

为手动控制或执行索引传送带的移动指令，需将系统设为正常模
式（Normal Mode）。同时这一切都要按指令或在从PP to Main
移动期间完成。

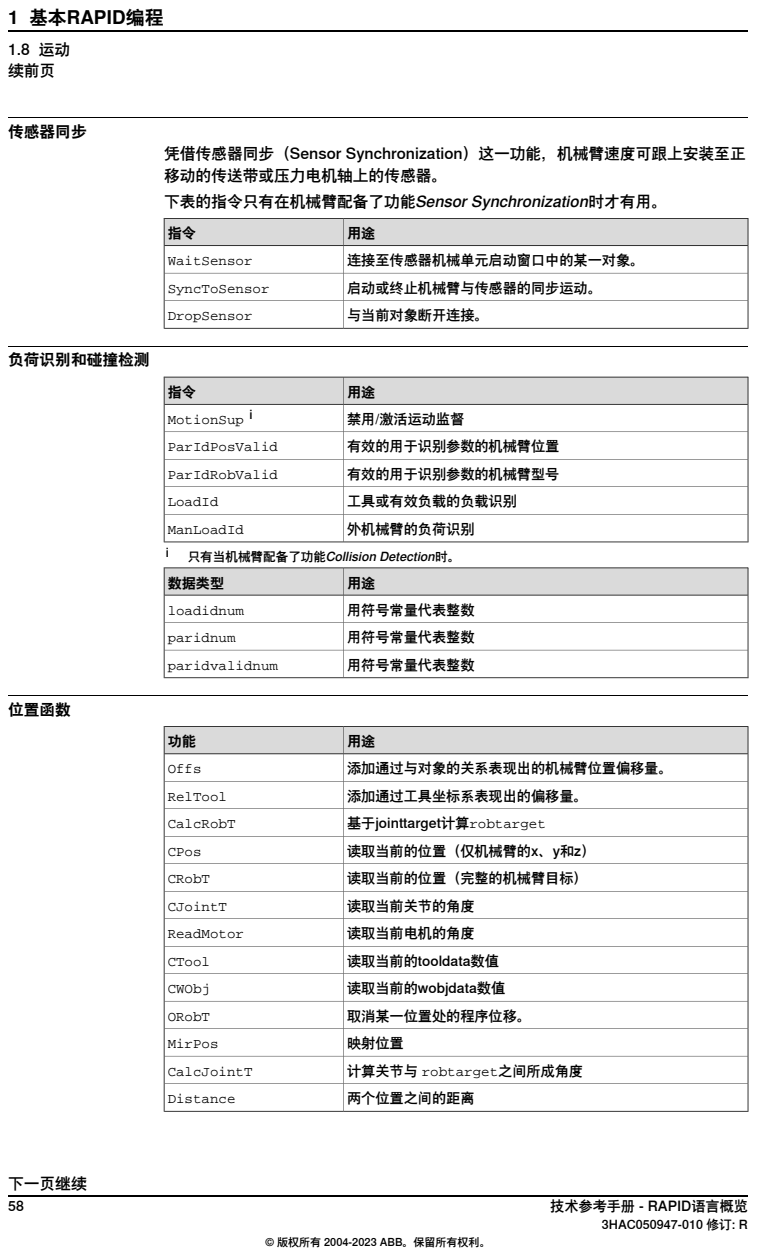
[picture p43: page 58]
传感器同步; WaitSensor; 连接至传感器机械单元启动窗口中的某一对象。; SyncToSensor; 启动或终止机械臂与传感器的同步运动。; DropSensor; 与当前对象断开连接。; 负荷识别和碰撞检测; MotionSup i; 禁用/激活运动监督; ParIdPosValid; 有效的用于识别参数的机械臂位置; ParIdRobValid; 有效的用于识别参数的机械臂型号; LoadId; 工具或有效负载的负载识别; ManLoadId; 外机械臂的负荷识别; 只有当机械臂配备了功能Collision Detection时。; 数据类型; loadidnum; 用符号常量代表整数; paridnum; paridvalidnum; 位置函数; Offs; 添加通过与对象的关系表现出的机械臂位置偏移量。; RelTool; 添加通过工具坐标系表现出的偏移量。; CalcRobT; 基于jointtarget计算robtarget; CPos; 读取当前的位置（仅机械臂的x、y和z）; CRobT; 读取当前的位置（完整的机械臂目标）; CJointT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

凭借传感器同步（Sensor Synchronization）这一功能，机械臂速度可跟上安装至正
移动的传送带或压力电机轴上的传感器。
下表的指令只有在机械臂配备了功能Sensor Synchronization时才有用。

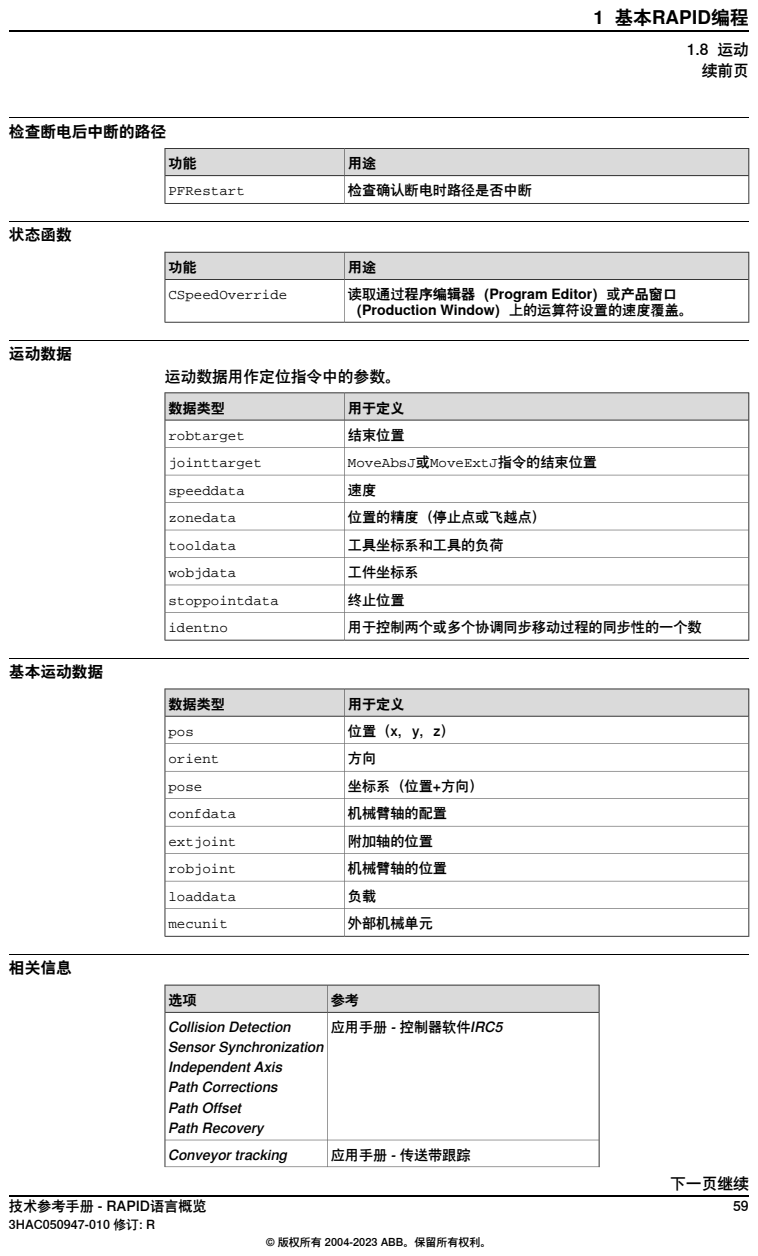
[picture p44: page 59]
检查断电后中断的路径; PFRestart; 检查确认断电时路径是否中断; 状态函数; CSpeedOverride; 运动数据; 运动数据用作定位指令中的参数。; 数据类型; 用于定义; robtarget; 结束位置; jointtarget; MoveAbsJ或MoveExtJ指令的结束位置; speeddata; zonedata; 位置的精度（停止点或飞越点）; tooldata; 工具坐标系和工具的负荷; wobjdata; 工件坐标系; stoppointdata; 终止位置; identno; 用于控制两个或多个协调同步移动过程的同步性的一个数; 基本运动数据; pos; orient; pose; 坐标系（位置+方向）; confdata; 机械臂轴的配置; extjoint; 附加轴的位置; robjoint; 机械臂轴的位置; loaddata; mecunit; 外部机械单元; 相关信息; Collision Detection; 应用手册 - 控制器软件IRC5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

读取通过程序编辑器（Program Editor）或产品窗口
（Production Window）上的运算符设置的速度覆盖。

选项 | 参考
MultiMove | 应用手册 - MultiMove
RobotWare-Arc | Application manual - Arc and Arc Sensor

1.8 运动

### 1.9 输入输出信号

信号
机械臂配有多个数字和模拟用户信号,这些信号可读,也可在程序内对其进行更改。

编程原理
通过系统参数定义信号名称。这些名称通常用于I/O操作读取或设置程序中。 规定模拟信号或一组数字信号的值为数值。

变更信号值

指令 | 用于定义
InvertDO | 转化数字信号输出信号值
PulseDO | 应数字信号输出信号生成脉冲
Reset | 重设数字信号输出信号（为0）
Set | 设数字信号输出信号（为1）
SetAO | 变更数字信号输出信号值
SetDO | 变更数字信号输出信号值（符号值，如高/低）
SetGO | 变更一组数字信号输出信号的值

读取输入信号值
通过程序可直接读取输入信号值，如，

! Digital input

IF di1 = 1 THEN ...

! Digital group input (smaller than 23 bits)

IF gi1 = 5 THEN ...

! Analog input

IF ai1 > 5.2 THEN ...
可能会产生下列可恢复错误。可用错误处理器处理这些错误。系统变量ERRNO将设置 为：
如果信号变量是RAPID中声明的变量，则ERR_NO_ALIASIO_DEF。尚未同I/O配置以 及指令AliasIO中确定的I/O信号相连。

如果与I/O单元无接触，则ERR_NORUNUNIT。

如果无法访问I/O信号（仅对ICI现场总线有效），则ERR_SIG_NOT_VALID。

读取输出信号值
通过程序可直接读取输出信号值，如：

! Digital output

IF do1 = 1 THEN ...

! Digital group output (smaller than 23 bits)

IF go1 = 5 THEN ...

! Analog output

IF ao1 > 5.2 THEN ...
可能会产生下列可恢复错误。可用错误处理器处理这些错误。系统变量ERRNO将设置 为：

1.9 输入输出信号

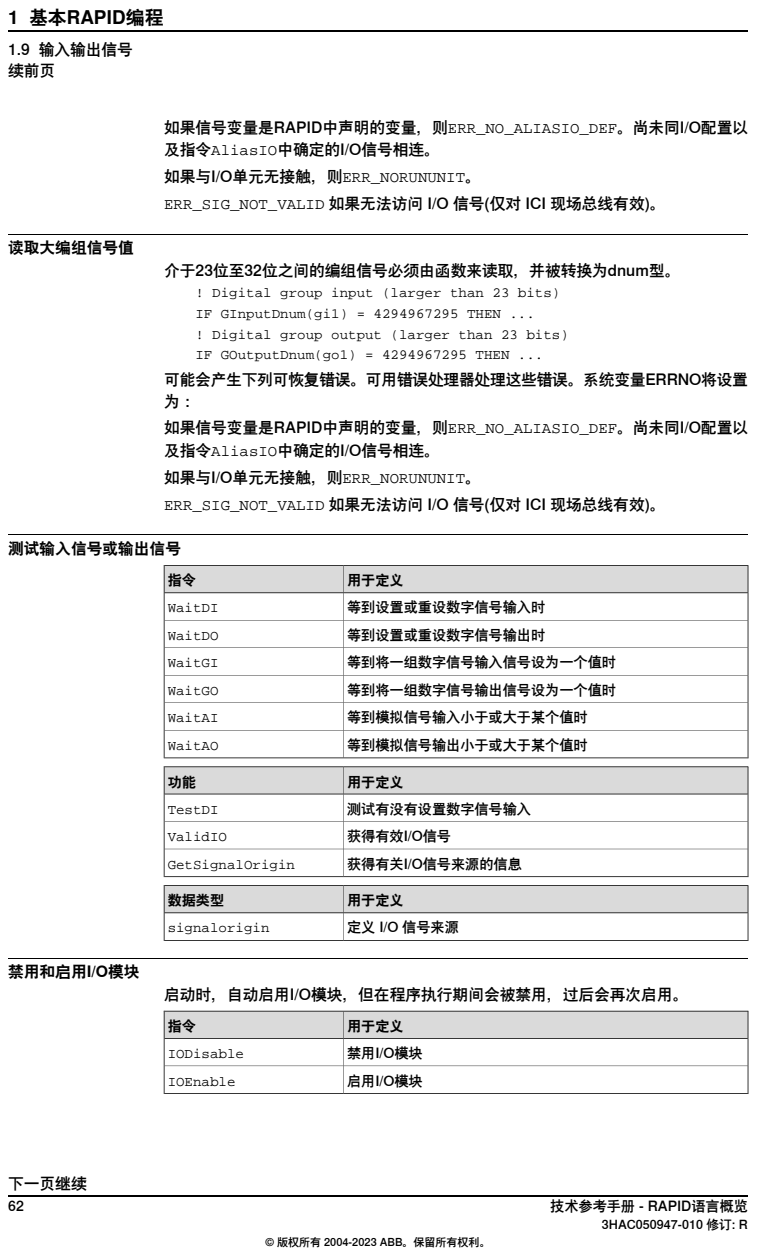
[picture p45: page 62]
如果与I/O单元无接触，则ERR_NORUNUNIT。; 读取大编组信号值; 介于23位至32位之间的编组信号必须由函数来读取，并被转换为dnum型。; 测试输入信号或输出信号; 用于定义; WaitDI; 等到设置或重设数字信号输入时; WaitDO; 等到设置或重设数字信号输出时; WaitGI; 等到将一组数字信号输入信号设为一个值时; WaitGO; 等到将一组数字信号输出信号设为一个值时; WaitAI; 等到模拟信号输入小于或大于某个值时; WaitAO; 等到模拟信号输出小于或大于某个值时; TestDI; 测试有没有设置数字信号输入; ValidIO; 获得有效I/O信号; GetSignalOrigin; 获得有关I/O信号来源的信息; 数据类型; signalorigin; 定义 I/O 信号来源; 禁用和启用I/O模块; IODisable; 禁用I/O模块; IOEnable; 启用I/O模块; 1.9 输入输出信号

如果信号变量是RAPID中声明的变量，则ERR_NO_ALIASIO_DEF。尚未同I/O配置以
及指令AliasIO中确定的I/O信号相连。

ERR_SIG_NOT_VALID 如果无法访问 I/O 信号(仅对 ICI 现场总线有效)。

! Digital group input (larger than 23 bits)
IF GInputDnum(gi1) = 4294967295 THEN ...
! Digital group output (larger than 23 bits)

IF GOutputDnum(go1) = 4294967295 THEN ...
可能会产生下列可恢复错误。可用错误处理器处理这些错误。系统变量ERRNO将设置

启动时，自动启用I/O模块，但在程序执行期间会被禁用，过后会再次启用。

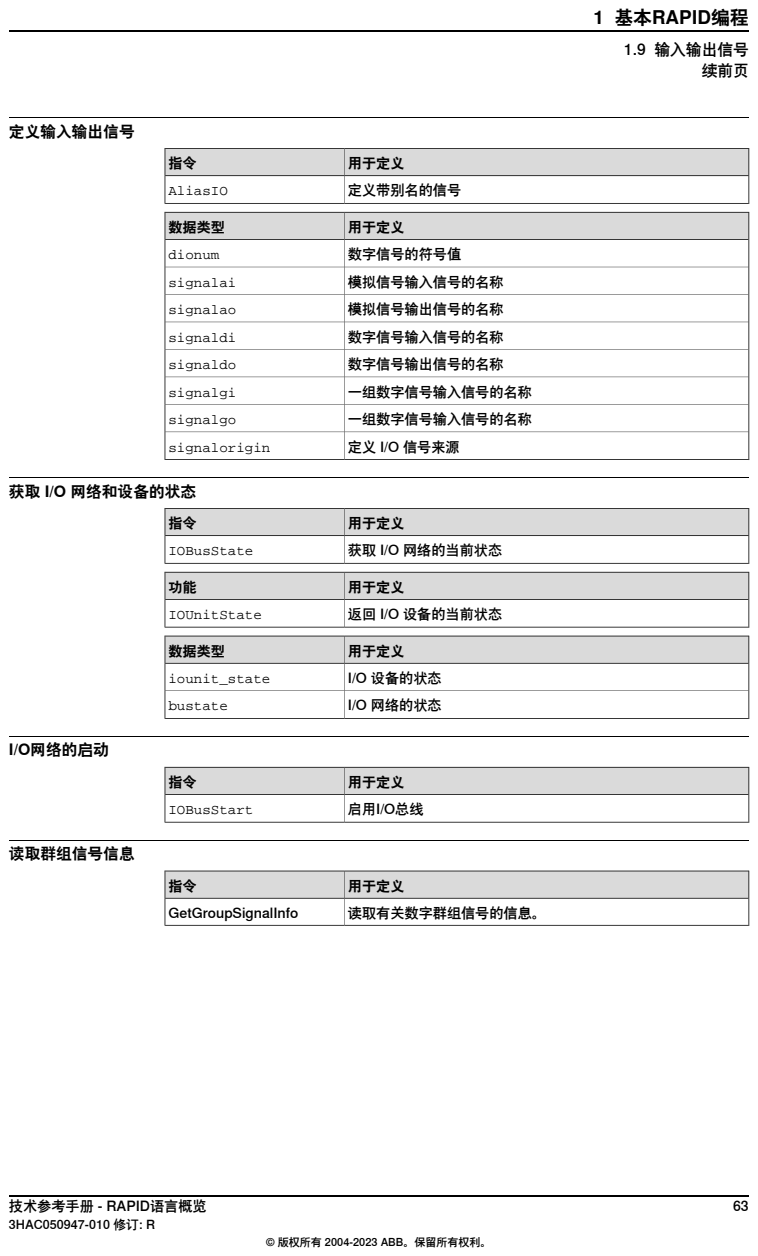
[picture p46: page 63]
定义输入输出信号; 用于定义; AliasIO; 定义带别名的信号; 数据类型; dionum; 数字信号的符号值; signalai; 模拟信号输入信号的名称; signalao; 模拟信号输出信号的名称; signaldi; 数字信号输入信号的名称; signaldo; 数字信号输出信号的名称; signalgi; 一组数字信号输入信号的名称; signalgo; signalorigin; 定义 I/O 信号来源; 获取 I/O 网络和设备的状态; IOBusState; 获取 I/O 网络的当前状态; IOUnitState; 返回 I/O 设备的当前状态; iounit_state; I/O 设备的状态; bustate; I/O 网络的状态; I/O网络的启动; IOBusStart; 启用I/O总线; 读取群组信号信息; GetGroupSignalInfo; 读取有关数字群组信号的信息。; 1.9 输入输出信号

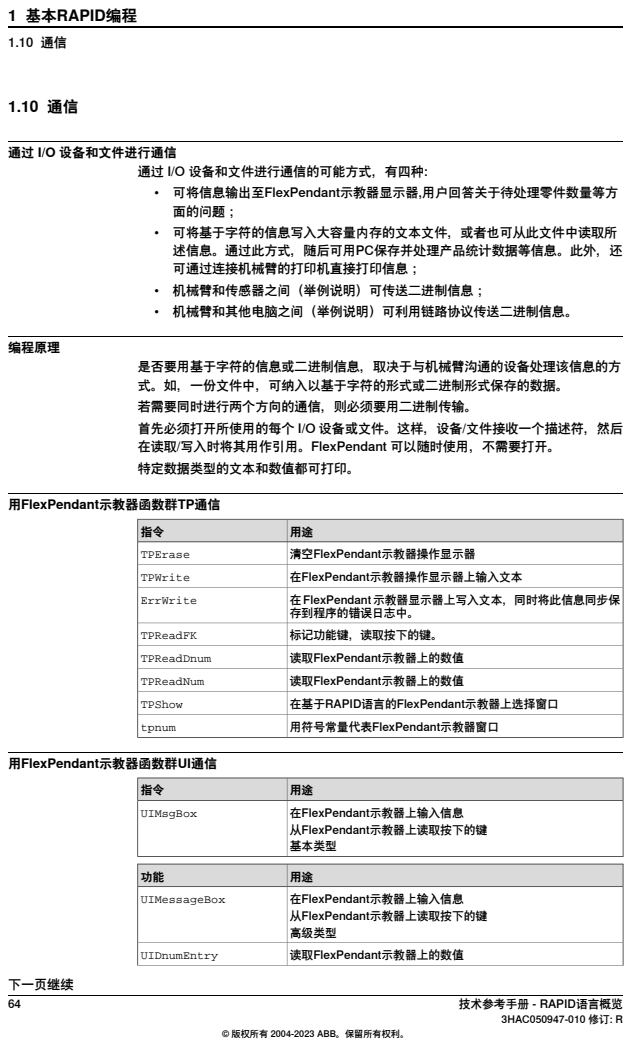
[picture p47: page 64]
通过 I/O 设备和文件进行通信; 编程原理; 用FlexPendant示教器函数群TP通信; TPErase; 清空FlexPendant示教器操作显示器; TPWrite; 在FlexPendant示教器操作显示器上输入文本; 在FlexPendant示教器显示器上写入文本，同时将此信息同步保 存到程序的错误日志中。; ErrWrite; TPReadFK; 标记功能键，读取按下的键。; TPReadDnum; 读取FlexPendant示教器上的数值; TPReadNum; TPShow; 在基于RAPID语言的FlexPendant示教器上选择窗口; tpnum; 用符号常量代表FlexPendant示教器窗口; 用FlexPendant示教器函数群UI通信; UIMsgBox; 在FlexPendant示教器上输入信息; 从FlexPendant示教器上读取按下的键 基本类型; UIMessageBox; 从FlexPendant示教器上读取按下的键 高级类型; UIDnumEntry

通过 I/O 设备和文件进行通信的可能方式，有四种:
• 可将信息输出至FlexPendant示教器显示器,用户回答关于待处理零件数量等方
面的问题；
• 可将基于字符的信息写入大容量内存的文本文件，或者也可从此文件中读取所
述信息。通过此方式，随后可用PC保存并处理产品统计数据等信息。此外，还
可通过连接机械臂的打印机直接打印信息；
• 机械臂和传感器之间（举例说明）可传送二进制信息；
• 机械臂和其他电脑之间（举例说明）可利用链路协议传送二进制信息。

是否要用基于字符的信息或二进制信息，取决于与机械臂沟通的设备处理该信息的方
式。如，一份文件中，可纳入以基于字符的形式或二进制形式保存的数据。
若需要同时进行两个方向的通信，则必须要用二进制传输。
首先必须打开所使用的每个 I/O 设备或文件。这样，设备/文件接收一个描述符，然后
在读取/写入时将其用作引用。FlexPendant 可以随时使用，不需要打开。
特定数据类型的文本和数值都可打印。

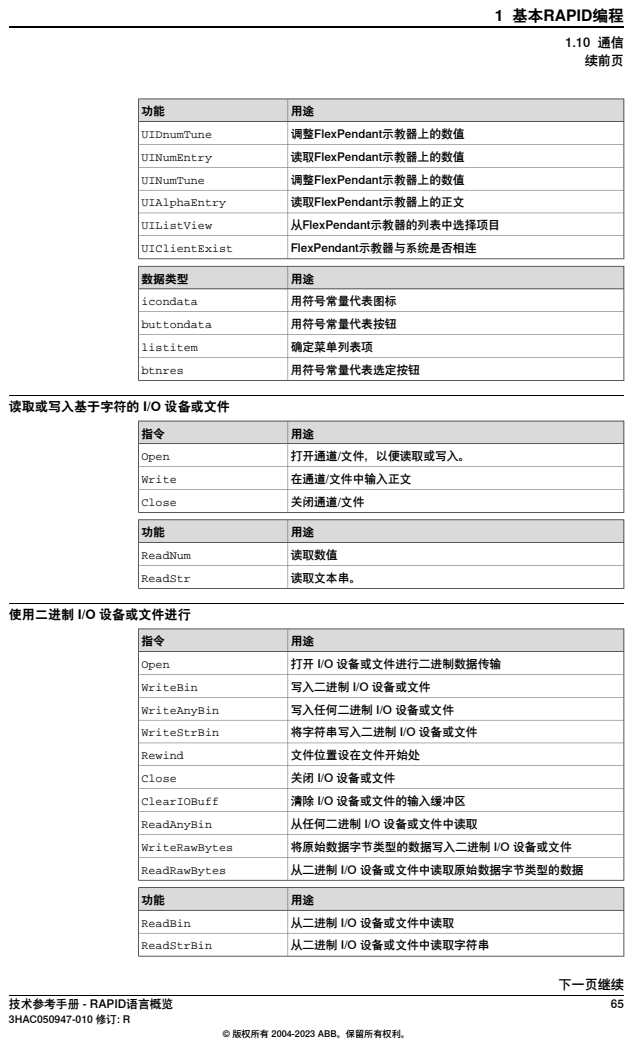
[picture p48: page 65]
UIDnumTune; 调整FlexPendant示教器上的数值; UINumEntry; 读取FlexPendant示教器上的数值; UINumTune; UIAlphaEntry; 读取FlexPendant示教器上的正文; UIListView; 从FlexPendant示教器的列表中选择项目; UIClientExist; FlexPendant示教器与系统是否相连; 数据类型; icondata; 用符号常量代表图标; buttondata; 用符号常量代表按钮; listitem; 确定菜单列表项; btnres; 用符号常量代表选定按钮; 读取或写入基于字符的 I/O 设备或文件; Open; 打开通道/文件，以便读取或写入。; Write; 在通道/文件中输入正文; Close; 关闭通道/文件; ReadNum; 读取数值; ReadStr; 读取文本串。; 使用二进制 I/O 设备或文件进行; 打开 I/O 设备或文件进行二进制数据传输; WriteBin; 写入二进制 I/O 设备或文件; WriteAnyBin; 写入任何二进制 I/O 设备或文件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

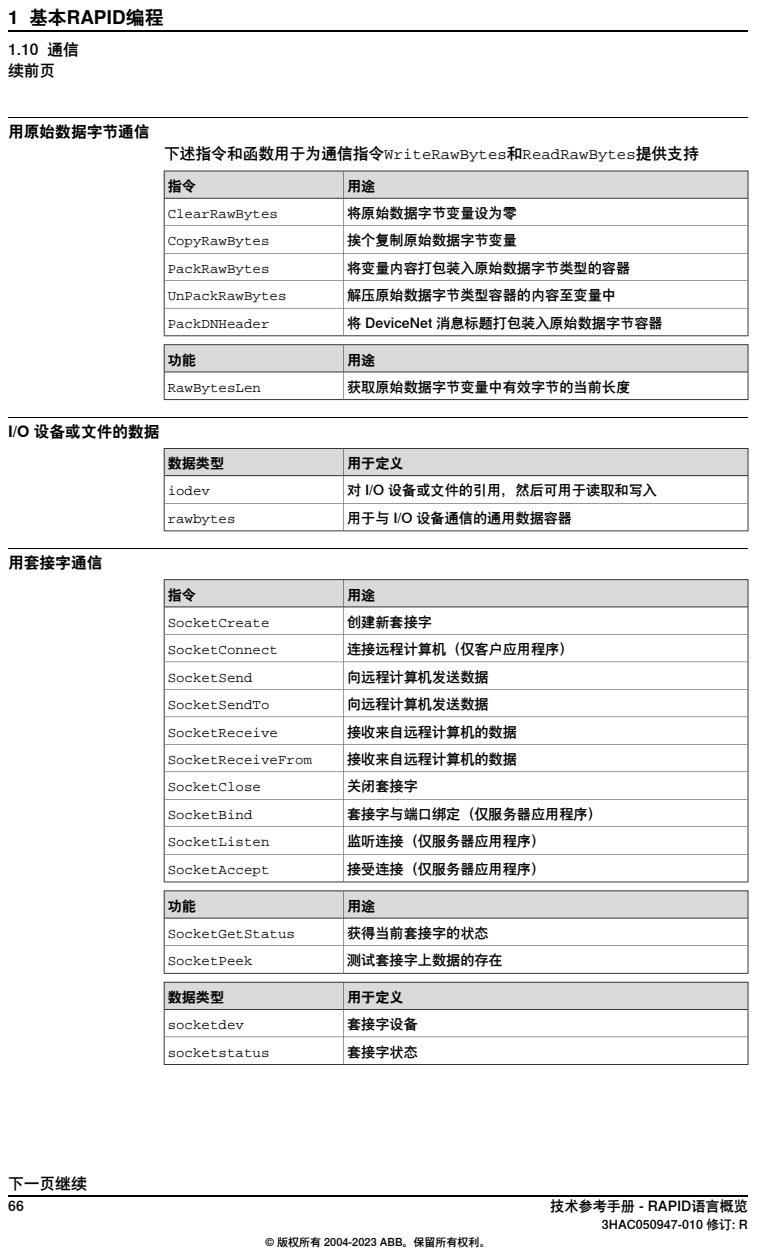
[picture p49: page 66]
用原始数据字节通信; 下述指令和函数用于为通信指令WriteRawBytes和ReadRawBytes提供支持; ClearRawBytes; 将原始数据字节变量设为零; CopyRawBytes; 挨个复制原始数据字节变量; PackRawBytes; 将变量内容打包装入原始数据字节类型的容器; UnPackRawBytes; 解压原始数据字节类型容器的内容至变量中; PackDNHeader; 将 DeviceNet 消息标题打包装入原始数据字节容器; RawBytesLen; 获取原始数据字节变量中有效字节的当前长度; I/O 设备或文件的数据; 数据类型; 用于定义; iodev; 对 I/O 设备或文件的引用，然后可用于读取和写入; rawbytes; 用于与 I/O 设备通信的通用数据容器; 用套接字通信; SocketCreate; 创建新套接字; SocketConnect; 连接远程计算机（仅客户应用程序）; SocketSend; 向远程计算机发送数据; SocketSendTo; SocketReceive; 接收来自远程计算机的数据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

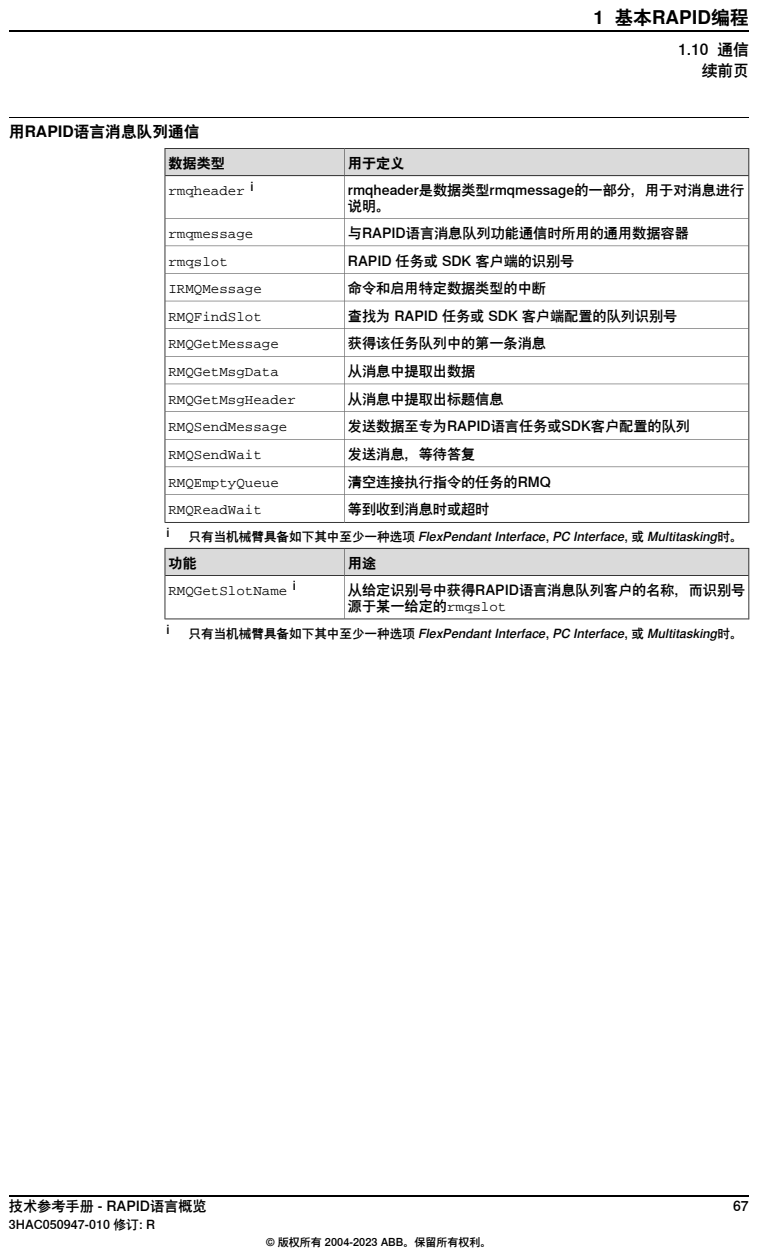
[picture p50: page 67]
用RAPID语言消息队列通信; 数据类型; 用于定义; rmqheader是数据类型rmqmessage的一部分，用于对消息进行 说明。; rmqheader i; rmqmessage; 与RAPID语言消息队列功能通信时所用的通用数据容器; rmqslot; RAPID 任务或 SDK 客户端的识别号; IRMQMessage; 命令和启用特定数据类型的中断; RMQFindSlot; 查找为 RAPID 任务或 SDK 客户端配置的队列识别号; RMQGetMessage; 获得该任务队列中的第一条消息; RMQGetMsgData; 从消息中提取出数据; RMQGetMsgHeader; 从消息中提取出标题信息; RMQSendMessage; 发送数据至专为RAPID语言任务或SDK客户配置的队列; RMQSendWait; 发送消息，等待答复; RMQEmptyQueue; 清空连接执行指令的任务的RMQ; RMQReadWait; 等到收到消息时或超时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

### 1.11 中断

简介
中断是程序定义事件，通过中断编号识别。中断发生在中断条件为真时。中断不同于 其他错误，前者与特定消息号位置无直接关系（不同步）。中断会导致正常程序执行 过程暂停，跳过控制，进入软中断程序。
即使机械臂可快速识别中断事件（仅因硬件速度延迟），但也只会在特定程序位置才 会作出反应，即调用相应的软中断程序，其中特定位置如下所示：
- 输入下一条指令时；
- 等待指令执行期间的任意时候，如WaitUntil；
- 移动指令执行期间的任意时候，如MoveL。
这通常会导致在识别出中断后要延迟2ms到30ms才能作出反应，具体延时取决于中断 时所进行的运动类型。
可禁用和启用中断。若禁用中断，则可将发生的所有中断列入等待队列，到再次启用 中断前都不会再出现。注意中断队列可能包含不止一起待中断事件。使列队的中断按 FIFO顺序（先进先出）发生。在软中断程序执行期间通常禁用中断。 按步骤运行期间，在程序停止的情况下，不处理任何中断。停止时将舍弃队列中的所 有中断，同时也不会处理停止时发生的任何中断，但安全中断例外，参见第70页的安 全中断。
任意一次确定的最高中断次数限于每个程序任务100次。

编程原理
赋予每次中断一个中断识别号。通过创建变量（数据类型intnum）并与软中断程序相 连，获取该识别号。
随用可用中断识别号（变量）发出中断命令，也就是明确中断原因。原因可能是如下 任一事件：
- 将输入或输出设为一或零；
- 下令在中断后按给定时间延时；
- 到达指定位置。
下达中断命令的同时，会自动启用中断，但会临时禁用。在两种情况下会发生这种情 况：
- 可禁用所有中断。在此期间发生的所有中断都将列入等待队列，同时会在再次 启用中断时自动出现；
- 可使个别中断失效。而在此期间发生的所有中断都可忽略。

连接中断与软中断程序

指令 | 用途
CONNECT | 连接变量（中断识别号）与软中断程序

下达中断命令

指令 | 用于下令
ISignalDI | 中断数字信号输入信号

1.11 中断

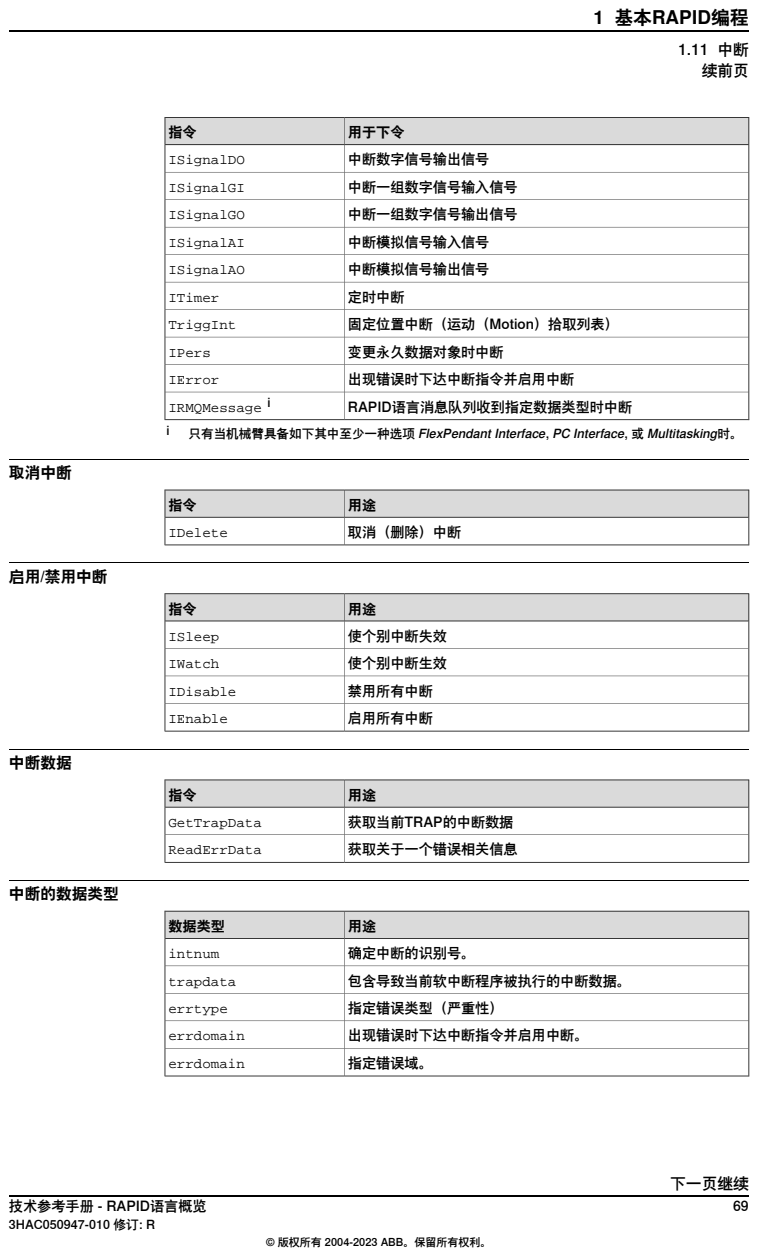
[picture p51: page 69]
用于下令; ISignalDO; 中断数字信号输出信号; ISignalGI; 中断一组数字信号输入信号; ISignalGO; 中断一组数字信号输出信号; ISignalAI; 中断模拟信号输入信号; ISignalAO; 中断模拟信号输出信号; ITimer; 定时中断; TriggInt; 固定位置中断（运动（Motion）拾取列表）; IPers; 变更永久数据对象时中断; IError; 出现错误时下达中断指令并启用中断; IRMQMessage i; RAPID语言消息队列收到指定数据类型时中断; 只有当机械臂具备如下其中至少一种选项 FlexPendant Interface, PC Interface, 或 Multitasking时。; 取消中断; IDelete; 启用/禁用中断; ISleep; 使个别中断失效; IWatch; 使个别中断生效; IDisable; 禁用所有中断; IEnable; 启用所有中断; 中断数据; GetTrapData; 获取当前TRAP的中断数据; ReadErrData; 获取关于一个错误相关信息; 中断的数据类型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

安全中断
某些指令（如ITimer和ISignalDI）可与安全中断结合用。安全中断是指停止或按 步骤执行期间发生时被列入等待队列的所有中断。在启动持续执行过程时，按FIFO顺 序尽快处理所有列入等待队列的中断。另外，停止时列队的中断也要予以处理。指令 ISleep不能与安全中断结合用。

中断操作
对中断的定义可帮助系统了解此中断。定义将明确中断条件，激活并启用中断。 例子：

VAR intnum sig1int;

ISignalDI di1, high, sig1int;
但激活的中断也可能失效，当然反过来也有可能。
在失效期间，无软中断执行的情况下，可舍弃产生的任何指定类型的中断。 例子：

! deactivate

ISleep sig1int;

! activate

IWatch sig1int;
已启用的中断也可能被禁用，反过来也有可能。
在禁用期间，将产生的所有指定类型的中断列入等待队列，待再次启用中断时，使其 首先出现。
例子：

! disable

IDisable sig1int;

1 enable

IEnable sig1int;
删除中断也就意味着取消其定义。没有必要直接取消中断定义，但只有当前一个中断 定义被取消后才能将新出现的中断定义为中断变量。
例子：

IDelete sig1int;

软中断程序
软中断程序提供了一种中断处理方式。可用CONNECT指令将软中断程序与特定中断相 连。发生中断时，立即将控制符传到相应的软中断程序（若有）。若此时没有任何可 连接的软中断程序，则将中断当做一个严重错误（即，导致程序执行立即终止）来处 理。
例子：

VAR intnum empty;

VAR intnum full;

PROC main()

! Connect trap routines

CONNECT empty WITH etrap;

CONNECT full WITH ftrap;

! Define feeder interrupts

1.11 中断

ISignalDI di1, high, empty;

ISignalDI di3, high, full;

! Delete interrupts

IDelete empty;

IDelete full;

ENDPROC

! Responds to “feeder empty” interrupt

TRAP etrap

open_valve;

RETURN;

ENDTRAP

! Responds to “feeder full” interrupt

TRAP ftrap

close_valve;

RETURN;

ENDTRAP
同一软中断程序可连接多个中断。系统变量INTNO包含中断次数，可供软中断程序用 于识别中断。在采取必要行动后，可用RETURN指令结束软中断程序，也可等到到达软 中断程序结尾（ENDTRAP或ERROR）处自然结束软中断程序。随后，将从中断处继续 执行。

1.11 中断

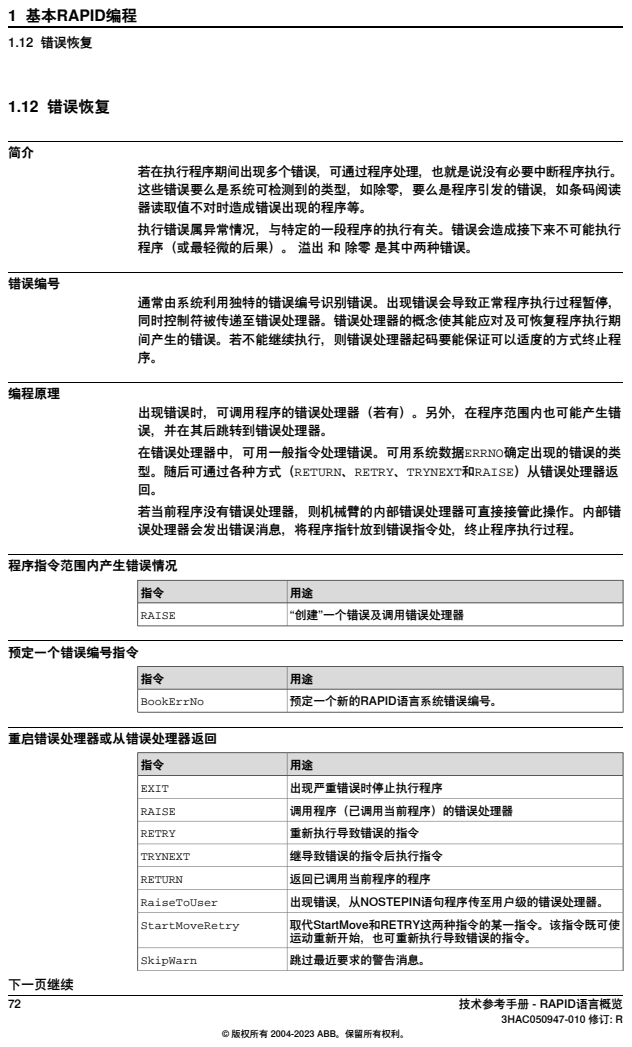
[picture p52: page 72]
1.12 错误恢复; 错误编号; 编程原理; 程序指令范围内产生错误情况; RAISE; “创建”一个错误及调用错误处理器; 预定一个错误编号指令; BookErrNo; 预定一个新的RAPID语言系统错误编号。; 重启错误处理器或从错误处理器返回; EXIT; 出现严重错误时停止执行程序; 调用程序（已调用当前程序）的错误处理器; RETRY; 重新执行导致错误的指令; TRYNEXT; 继导致错误的指令后执行指令; RETURN; 返回已调用当前程序的程序; RaiseToUser; 出现错误，从NOSTEPIN语句程序传至用户级的错误处理器。; 取代StartMove和RETRY这两种指令的某一指令。该指令既可使 运动重新开始，也可重新执行导致错误的指令。; StartMoveRetry; SkipWarn; 跳过最近要求的警告消息。

若在执行程序期间出现多个错误，可通过程序处理，也就是说没有必要中断程序执行。
这些错误要么是系统可检测到的类型，如除零，要么是程序引发的错误，如条码阅读
器读取值不对时造成错误出现的程序等。
执行错误属异常情况，与特定的一段程序的执行有关。错误会造成接下来不可能执行
程序（或最轻微的后果）。 溢出 和 除零 是其中两种错误。

通常由系统利用独特的错误编号识别错误。出现错误会导致正常程序执行过程暂停，
同时控制符被传递至错误处理器。错误处理器的概念使其能应对及可恢复程序执行期
间产生的错误。若不能继续执行，则错误处理器起码要能保证可以适度的方式终止程

出现错误时，可调用程序的错误处理器（若有）。另外，在程序范围内也可能产生错
误，并在其后跳转到错误处理器。
在错误处理器中，可用一般指令处理错误。可用系统数据ERRNO确定出现的错误的类
型。随后可通过各种方式（RETURN、RETRY、TRYNEXT和RAISE）从错误处理器返
若当前程序没有错误处理器，则机械臂的内部错误处理器可直接接管此操作。内部错
误处理器会发出错误消息，将程序指针放到错误指令处，终止程序执行过程。

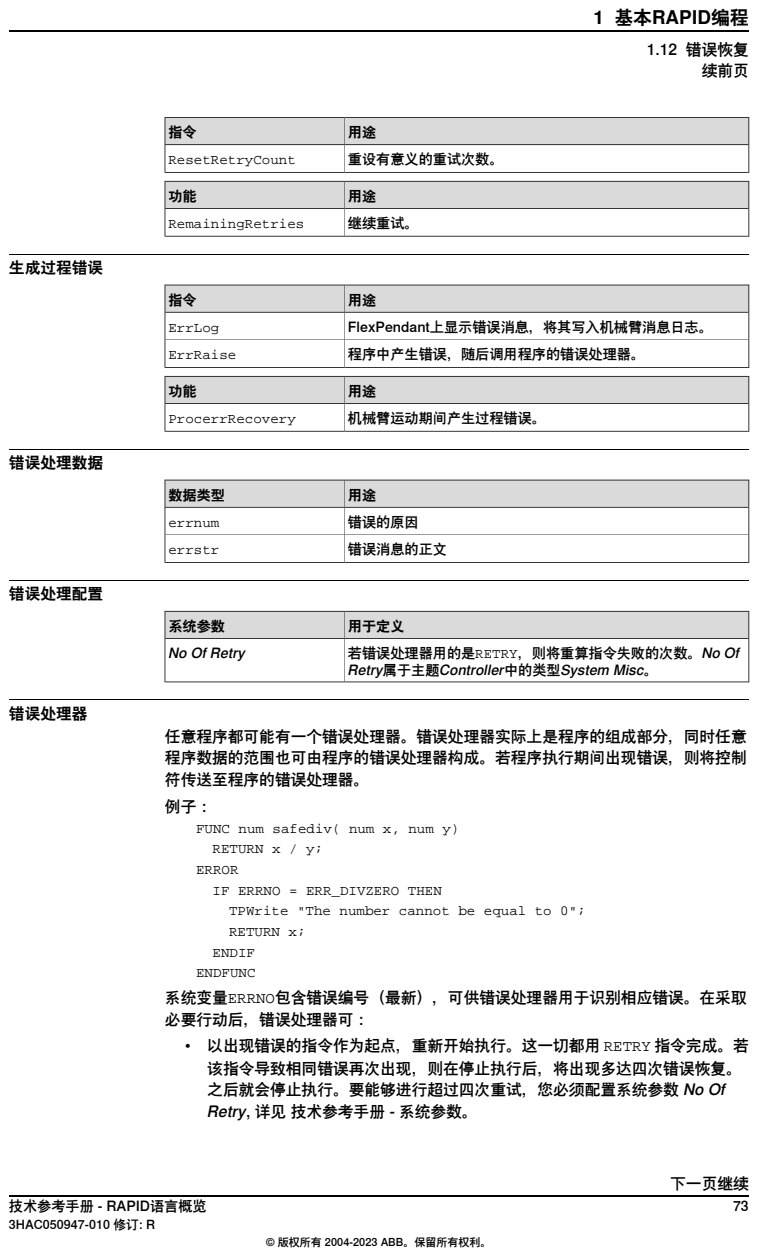
[picture p53: page 73]
ResetRetryCount; 重设有意义的重试次数。; RemainingRetries; 继续重试。; 生成过程错误; ErrLog; FlexPendant上显示错误消息，将其写入机械臂消息日志。; ErrRaise; 程序中产生错误，随后调用程序的错误处理器。; ProcerrRecovery; 机械臂运动期间产生过程错误。; 错误处理数据; 数据类型; errnum; 错误的原因; errstr; 错误消息的正文; 错误处理配置; 系统参数; 用于定义; 错误处理器; 1.12 错误恢复

No Of Retry

若错误处理器用的是RETRY，则将重算指令失败的次数。No Of
Retry属于主题Controller中的类型System Misc。

任意程序都可能有一个错误处理器。错误处理器实际上是程序的组成部分，同时任意
程序数据的范围也可由程序的错误处理器构成。若程序执行期间出现错误，则将控制
符传送至程序的错误处理器。

FUNC num safediv( num x, num y)

RETURN x / y;
ERROR
IF ERRNO = ERR_DIVZERO THEN
TPWrite "The number cannot be equal to 0";

RETURN x;
ENDIF
ENDFUNC
系统变量ERRNO包含错误编号（最新），可供错误处理器用于识别相应错误。在采取
必要行动后，错误处理器可：
• 以出现错误的指令作为起点，重新开始执行。这一切都用 RETRY 指令完成。若
该指令导致相同错误再次出现，则在停止执行后，将出现多达四次错误恢复。
之后就会停止执行。要能够进行超过四次重试，您必须配置系统参数 No Of
Retry, 详见 技术参考手册 - 系统参数。

- 以出现错误的指令后的指令作为起点，重新开始执行。这一切都用TRYNEXT指 令完成；
- 用RETURN指令返回控制符至程序调用程序。若该程序为有返回值程序，则 RETURN指令必须指定适当的返回值；
- 用RAISE指令将错误传送至程序的调用程序。

系统错误处理器
若不含错误处理器的程序中出现错误或到达错误处理器末尾（ENDFUNC、ENDPROC或 ENDTRAP），则调用系统错误处理器。系统错误处理器才会报告错误，并停止执行。 在程序调用链中，可能每个程序都有自己的错误处理器。若带错误处理器的程序中出 现错误，并用RAISE指令直接传送出错误，则在程序调用处会再次出现同样的错误， 即，传送错误。在没有错误处理器的情况下到达调用链顶端（任务的入口程序）时， 或到达调用链中任一错误处理器的末尾时，调用系统错误处理器。随后系统错误处理 器才会报告错误并停止执行。由于系统只能调用软中断程序（以应对中断），因此软 中断程序中的错误可传送至系统错误处理器。
错误恢复不适用于反向处理器中的指令。此时一般会将此类错误传送至系统错误处理 器。
错误处理器中出现的错误既不能恢复也不能应对。此时一般也会将此类错误传送至系 统错误处理器。

程序导致的错误
除了机械臂检测到的及导致的错误外，程序也可通过RAISE指令直接导致错误。可用 该功能恢复复杂情况。如，可用于脱离深层次嵌套代码位置。在出现指令中，可用1到 90的错误编号。对于直接出现的错误，可像处理系统导致的错误那样加以处理。

事件日志
利用错误处理器处理的错误仍会导致事件日志中出现警告。通过查阅事件日志，可跟 踪出现过的所有错误。
若想要在事件日志中不会写入警告的情况下处理好错误，则要用错误处理器中的指令 SkipWarn。这对于用错误处理器测试某些物项（如，有一份文件）存在与否很有用， 即使测试失败，也不会留下任何痕迹。

1.12 错误恢复

### 1.13 UNDO

简介
RAPID语言程序可能包含一个UNDO处理器。若将程序指针移到程序范围外，则会自动 执行该处理器。据推测，这可用于清除执行部分程序后留下的侧放作用，如取消模态 指令（如打开一份文件）。大部分RAPID语言都可用于UNDO处理器中，但也有一些限 制，如运动指令等。
UNDO 处理程序中的代码应尽可能快地执行，不得有任何延迟，因为用户很可能不知 道此时将运行任何代码。

术语
以下术语与UNDO有关。
- UNDO：程序重设前清理代码的执行。
- UNDO处理器：含在UNDO上可执行的RAPID语言代码的RAPID语言过程或函 数的一个可选部分。
- UNDO程序：有UNDO处理器的一个过程或函数。
- 调用链：目前通过尚未完成的程序调用相互联系到一起的所有过程或函数。若 未另作说明，则假定从程序Main处开始。
- UNDO上下文：当前程序为以UNDO处理器作为起点的调用链的组成部分。

何时使用UNDO
通过将程序指针移到程序外，可以在任意点中止RAPID语言程序。有时，若程序正在 执行特定敏感程序时，则不适合中止程序。采用UNDO，可保护这些敏感程序，使其 不会出现意外的程序复位。在中止程序的情况下，运用UNDO可自动执行特定代码。 该代码应执行清理动作，比如，关闭文档。

详细的UNDO行为
若激活UNDO，则可执行当前调用链中的所有UNDO-处理器。这些处理器为含有RAPID 代码的RAPID过程或函数的可选部分。当前活跃的UNDO-处理器都是已调用但还未终 止的过程或函数的一部分，即为当前调用链中的程序。
意外将程序指针移出UNDO-程序范围时，如用户将程序指针移至Main，UNDO被激 活。另外，若执行EXIT指令导致程序复位或出于其他原因（如变更某些配置或删除程 序或模块时）程序复位，则UNDO将被启动。但如果程序到达程序或RETURN语句的结 尾处，并如常从程序处返回，则不会启动UNDO。
若调用链中有不止一个UNDO程序，则将按程序返回的顺序（由下至上）处理程序的 UNDO-处理器。离调用链末端最近的UNDO-处理器第一个执行，最接近Main的处理 器将最后一个执行。

限制
UNDO-处理器可访问从正常程序体处可到达的包括局部声明变量在内的所有变量或符 号。但UNDO上下文中将执行的RAPID代码有限制。

UNDO-处理器不得含有STOP、BREAK、RAISE或RETURN。若试图在UNDO上下文中
使用上述任一指令，则指令将被忽略，同时产生ELOG警告。 在UNDO上下文中，也不允许存在诸如MoveL之类的运动指令。

1.13 UNDO

在UNDO中,执行是一个连续过程,不可能跳过。UNDO启动时，自动将执行模式设为连 续。完成UNDO会话后，才会恢复原来的执行模式。
若执行UNDO-处理器期间终止程序，则不会再执行程序的其余部分。若调用链中还有 其他未执行的UNDO-处理器，则也会忽略掉。而这会导致出现ELOG警告。同时，还 会出现因运行出错造成的停止。
在UNDO-处理器中看不到程序指针。执行UNDO时，程序指针停留在其原来的位置， 但在完成UNDO-处理器时，会有所变化。
EXIT指令通过类似于运行出错或Stop这样的方式中止UNDO。UNDO-处理器的其余部 分都被忽略，将程序指针移至Main。

示例
程序：

PROC B

TPWrite "In Routine B";

Exit;

UNDO

TPWrite "In UNDO of routine B";

ENDPROC

PROC A

TPWrite "In Routine A";

B;

ENDPROC

PROC main

TPWrite "In main";

A;

UNDO

TPWrite "In UNDO of main";

ENDPROC
输出：

In main

In Routine A

In Routine B

In UNDO of routine B

In UNDO of main

1.13 UNDO

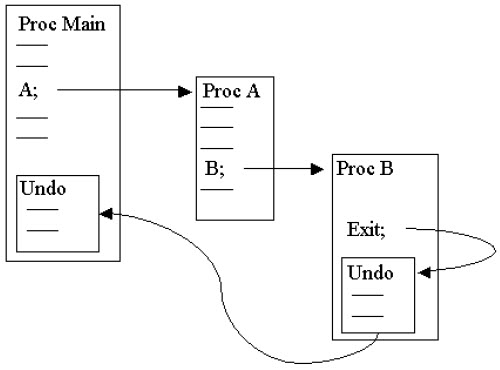
[picture p54: figure]

xx1100000588

1.13 UNDO

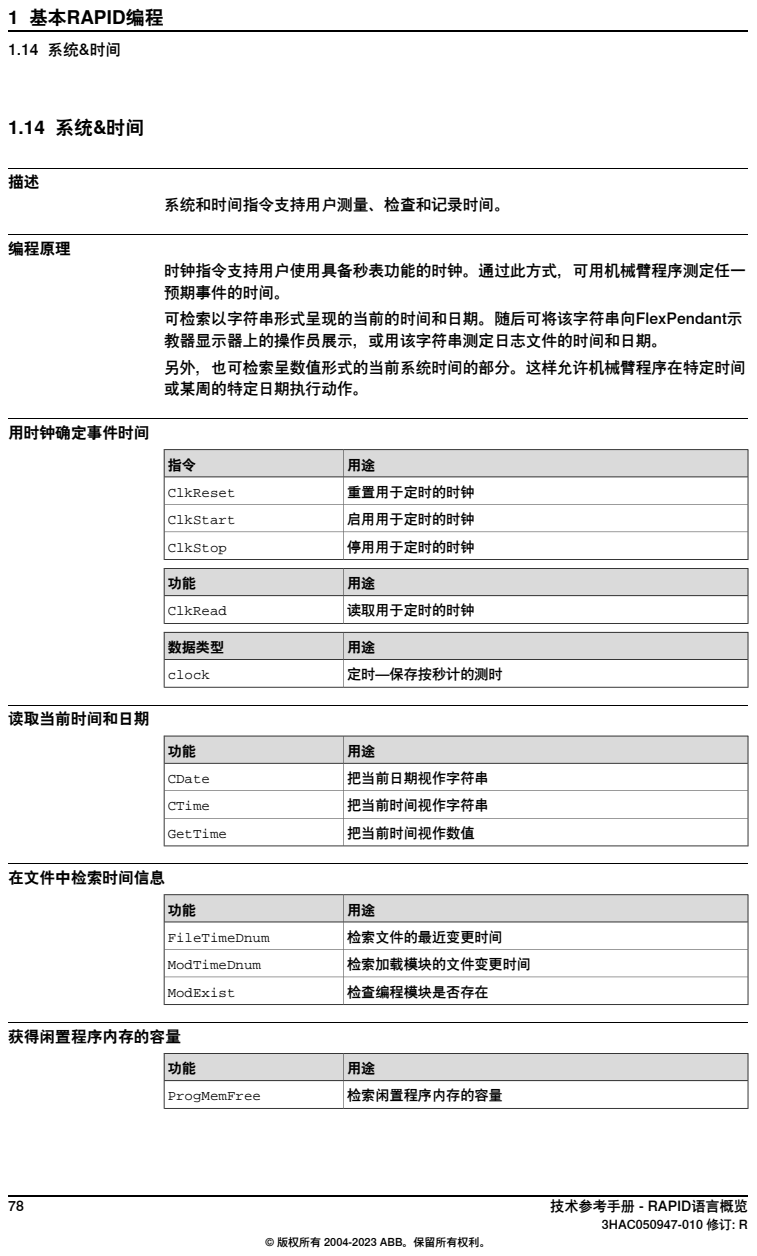
[picture p55: page 78]
系统和时间指令支持用户测量、检查和记录时间。; 编程原理; 用时钟确定事件时间; ClkReset; 重置用于定时的时钟; ClkStart; 启用用于定时的时钟; ClkStop; 停用用于定时的时钟; ClkRead; 读取用于定时的时钟; 数据类型; clock; 定时—保存按秒计的测时; 读取当前时间和日期; CDate; 把当前日期视作字符串; CTime; 把当前时间视作字符串; GetTime; 把当前时间视作数值; 在文件中检索时间信息; FileTimeDnum; 检索文件的最近变更时间; ModTimeDnum; 检索加载模块的文件变更时间; ModExist; 检查编程模块是否存在; 获得闲置程序内存的容量; ProgMemFree; 检索闲置程序内存的容量

时钟指令支持用户使用具备秒表功能的时钟。通过此方式，可用机械臂程序测定任一
预期事件的时间。
可检索以字符串形式呈现的当前的时间和日期。随后可将该字符串向FlexPendant示
教器显示器上的操作员展示，或用该字符串测定日志文件的时间和日期。
另外，也可检索呈数值形式的当前系统时间的部分。这样允许机械臂程序在特定时间
或某周的特定日期执行动作。

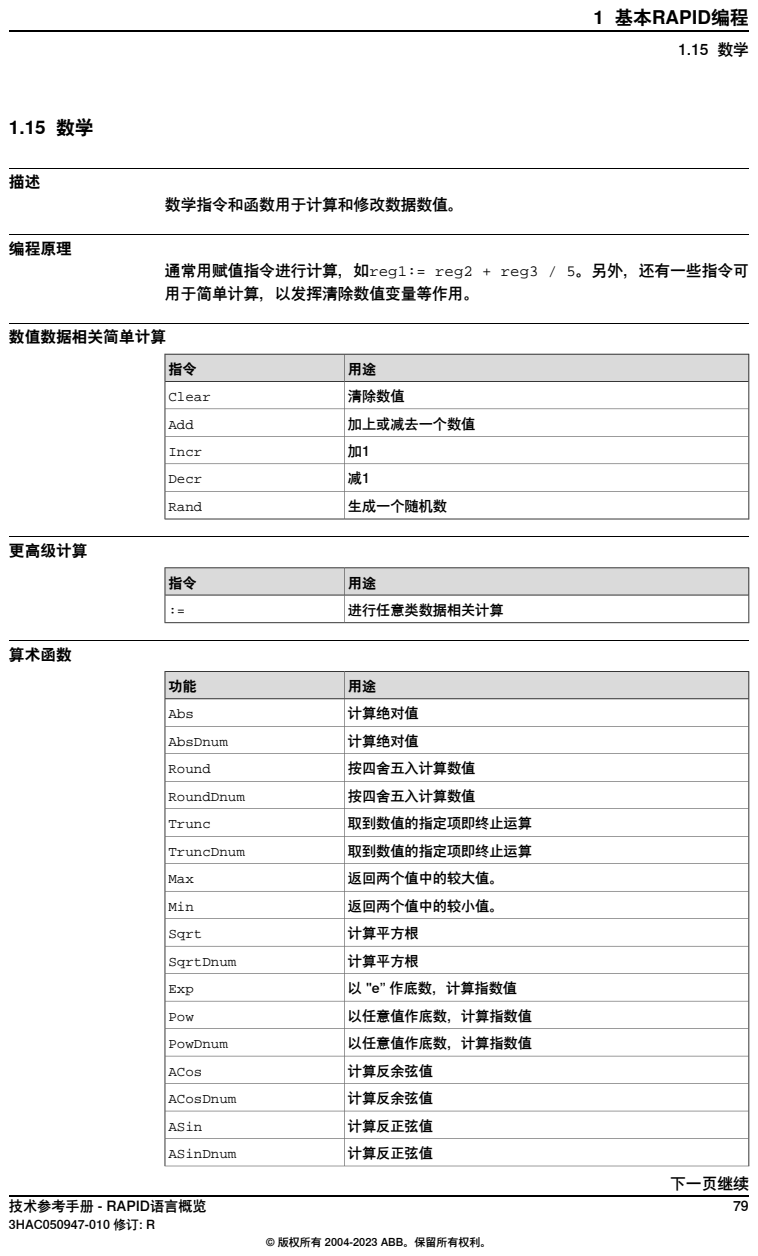
[picture p56: page 79]
数学指令和函数用于计算和修改数据数值。; 编程原理; 数值数据相关简单计算; Clear; 清除数值; Add; 加上或减去一个数值; Incr; Decr; Rand; 生成一个随机数; 更高级计算; 进行任意类数据相关计算; 算术函数; Abs; 计算绝对值; AbsDnum; Round; 按四舍五入计算数值; RoundDnum; Trunc; 取到数值的指定项即终止运算; TruncDnum; Max; 返回两个值中的较大值。; Min; 返回两个值中的较小值。; Sqrt; 计算平方根; SqrtDnum; Exp; 以 "e” 作底数，计算指数值; Pow; 以任意值作底数，计算指数值; PowDnum; ACos; 计算反余弦值; ACosDnum; ASin; 计算反正弦值; ASinDnum

通常用赋值指令进行计算，如reg1:= reg2 + reg3 / 5。另外，还有一些指令可
用于简单计算，以发挥清除数值变量等作用。

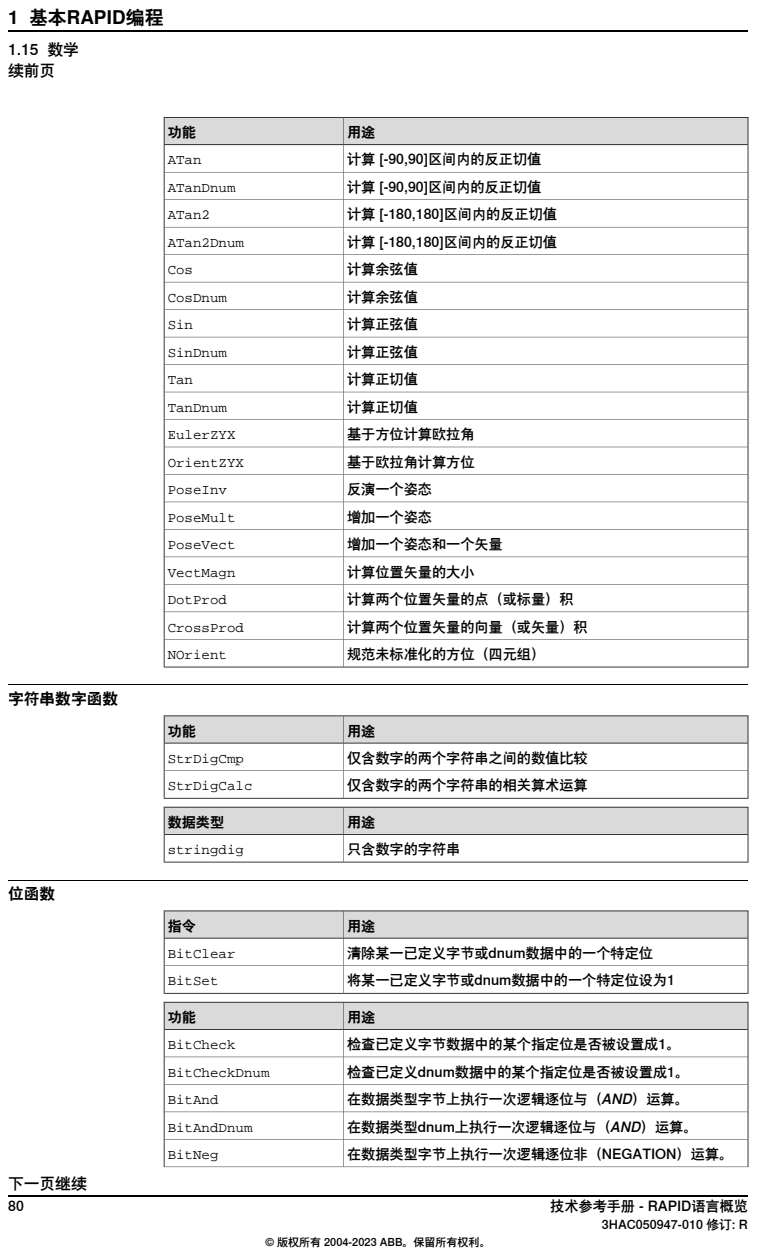
[picture p57: page 80]
ATan; 计算 [-90,90]区间内的反正切值; ATanDnum; ATan2; 计算 [-180,180]区间内的反正切值; ATan2Dnum; Cos; 计算余弦值; CosDnum; Sin; 计算正弦值; SinDnum; Tan; 计算正切值; TanDnum; EulerZYX; 基于方位计算欧拉角; OrientZYX; 基于欧拉角计算方位; PoseInv; 反演一个姿态; PoseMult; 增加一个姿态; PoseVect; 增加一个姿态和一个矢量; VectMagn; 计算位置矢量的大小; DotProd; 计算两个位置矢量的点（或标量）积; CrossProd; 计算两个位置矢量的向量（或矢量）积; NOrient; 规范未标准化的方位（四元组）; 字符串数字函数; StrDigCmp; 仅含数字的两个字符串之间的数值比较; StrDigCalc; 仅含数字的两个字符串的相关算术运算; 数据类型; stringdig; 只含数字的字符串; 位函数; BitClear; 清除某一已定义字节或dnum数据中的一个特定位; BitSet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

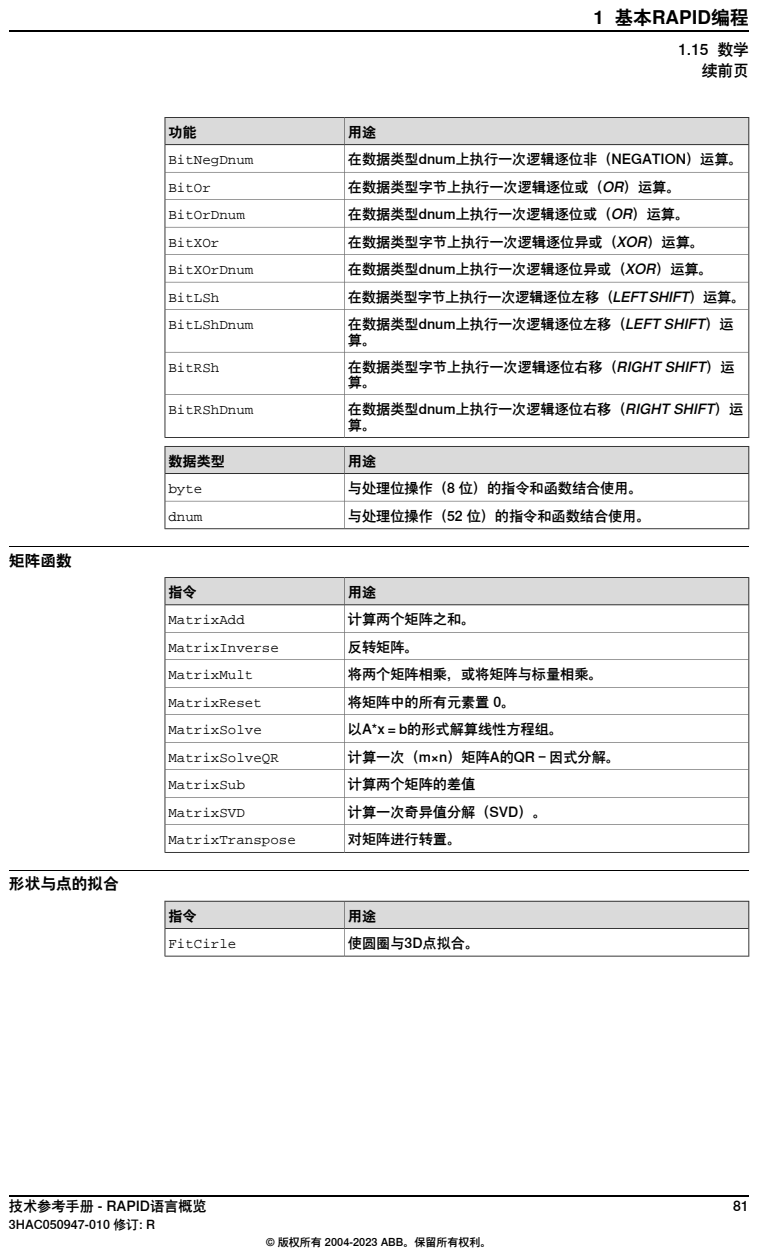
[picture p58: page 81]
BitNegDnum; 在数据类型dnum上执行一次逻辑逐位非（NEGATION）运算。; BitOr; 在数据类型字节上执行一次逻辑逐位或（OR）运算。; BitOrDnum; 在数据类型dnum上执行一次逻辑逐位或（OR）运算。; BitXOr; 在数据类型字节上执行一次逻辑逐位异或（XOR）运算。; BitXOrDnum; 在数据类型dnum上执行一次逻辑逐位异或（XOR）运算。; BitLSh; 在数据类型字节上执行一次逻辑逐位左移（LEFTSHIFT）运算。; BitLShDnum; BitRSh; BitRShDnum; 数据类型; byte; 与处理位操作（8 位）的指令和函数结合使用。; dnum; 与处理位操作（52 位）的指令和函数结合使用。; 矩阵函数; MatrixAdd; 计算两个矩阵之和。; MatrixInverse; 反转矩阵。; MatrixMult; 将两个矩阵相乘，或将矩阵与标量相乘。; MatrixReset; 将矩阵中的所有元素置 0。; MatrixSolve; 以A*x＝b的形式解算线性方程组。; MatrixSolveQR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

在数据类型dnum上执行一次逻辑逐位左移（LEFT SHIFT）运
在数据类型字节上执行一次逻辑逐位右移（RIGHT SHIFT）运
在数据类型dnum上执行一次逻辑逐位右移（RIGHT SHIFT）运

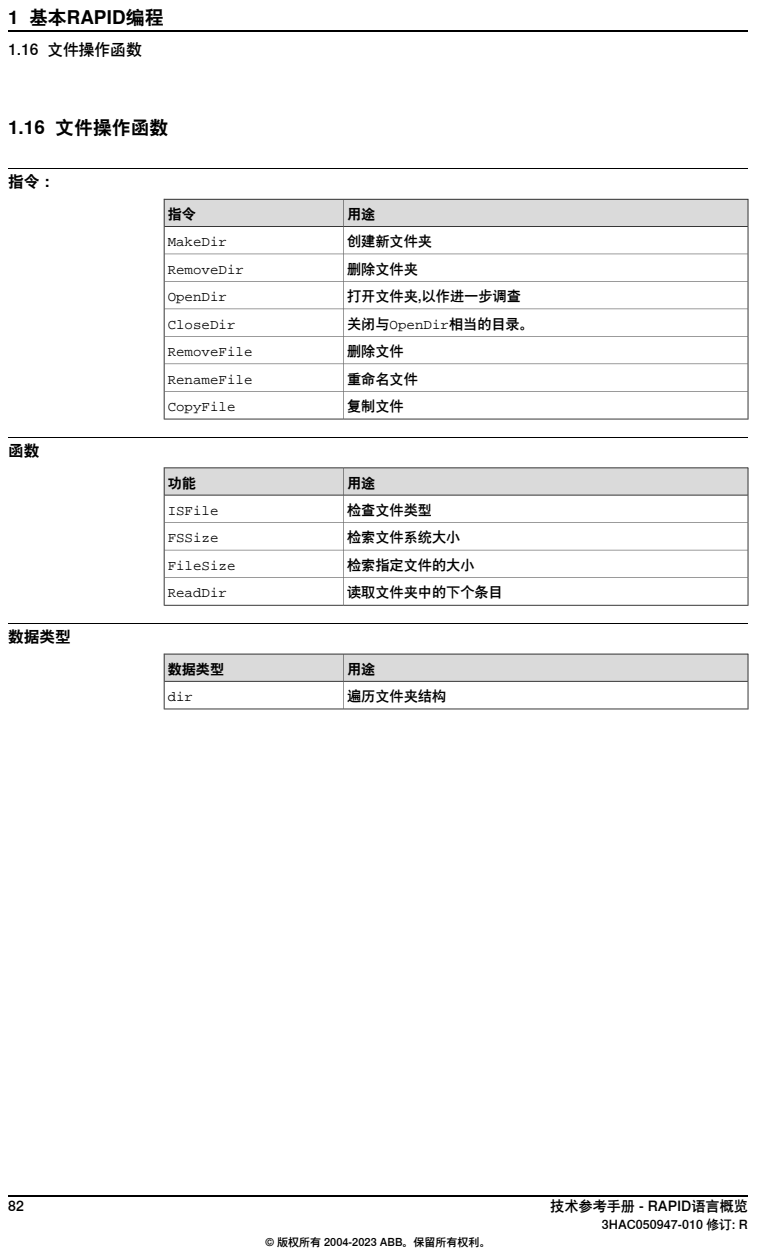
[picture p59: page 82]
1.16 文件操作函数; MakeDir; 创建新文件夹; RemoveDir; 删除文件夹; OpenDir; 打开文件夹,以作进一步调查; CloseDir; 关闭与OpenDir相当的目录。; RemoveFile; 删除文件; RenameFile; 重命名文件; CopyFile; 复制文件; ISFile; 检查文件类型; FSSize; 检索文件系统大小; FileSize; 检索指定文件的大小; ReadDir; 读取文件夹中的下个条目; 数据类型; dir; 遍历文件夹结构

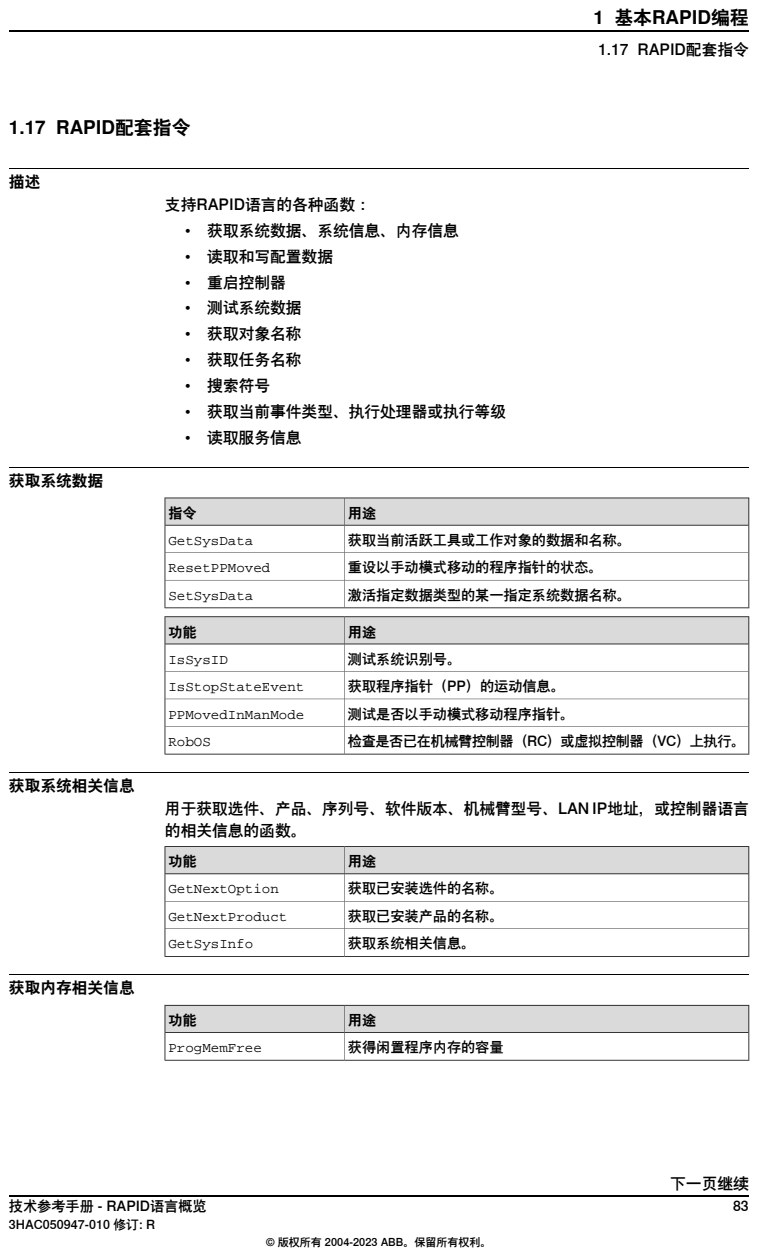
[picture p60: page 83]
1.17 RAPID配套指令; 支持RAPID语言的各种函数：; • 获取系统数据、系统信息、内存信息; • 读取和写配置数据; • 重启控制器; • 测试系统数据; • 获取对象名称; • 获取任务名称; • 搜索符号; • 获取当前事件类型、执行处理器或执行等级; • 读取服务信息; 获取系统数据; GetSysData; 获取当前活跃工具或工作对象的数据和名称。; ResetPPMoved; 重设以手动模式移动的程序指针的状态。; SetSysData; 激活指定数据类型的某一指定系统数据名称。; IsSysID; 测试系统识别号。; IsStopStateEvent; 获取程序指针（PP）的运动信息。; PPMovedInManMode; 测试是否以手动模式移动程序指针。; RobOS; 检查是否已在机械臂控制器（RC）或虚拟控制器（VC）上执行。; 获取系统相关信息; GetNextOption; 获取已安装选件的名称。; GetNextProduct; 获取已安装产品的名称。; GetSysInfo; 获取系统相关信息。; 获取内存相关信息; ProgMemFree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

用于获取选件、产品、序列号、软件版本、机械臂型号、LAN IP地址，或控制器语言
的相关信息的函数。

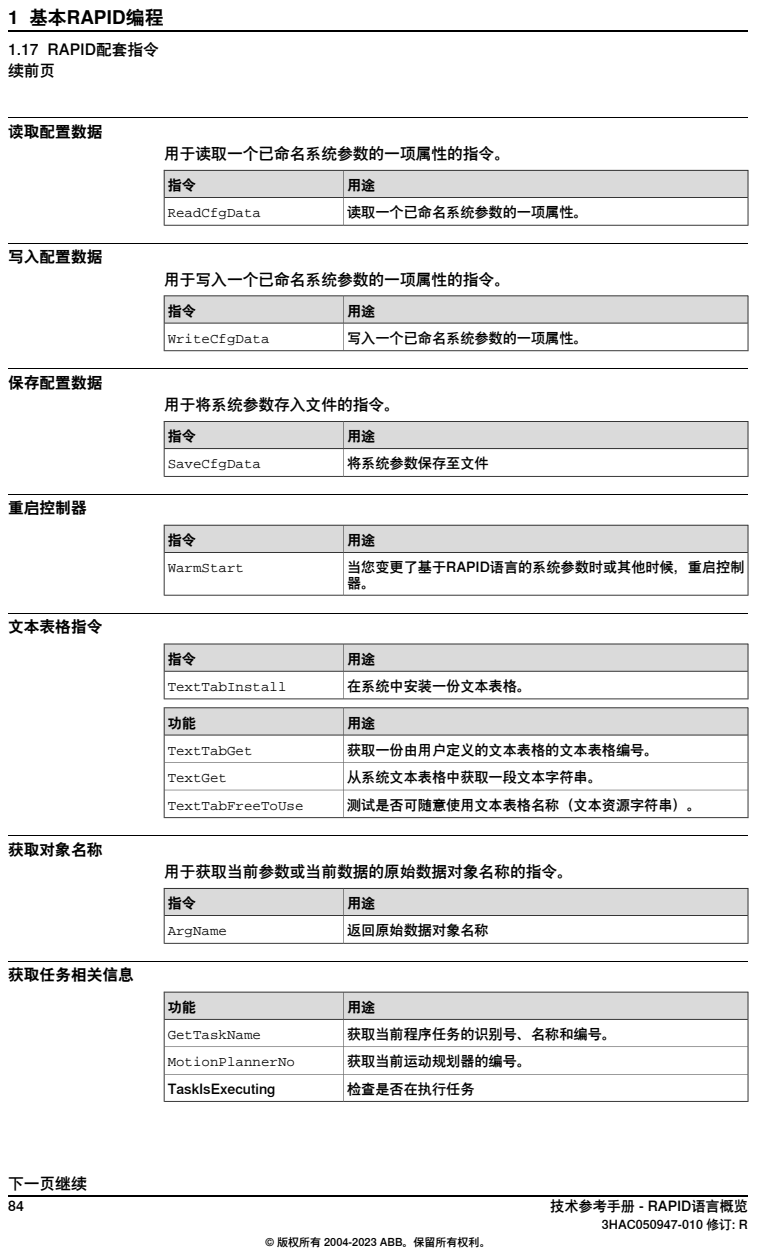
[picture p61: page 84]
读取配置数据; 用于读取一个已命名系统参数的一项属性的指令。; ReadCfgData; 读取一个已命名系统参数的一项属性。; 写入配置数据; 用于写入一个已命名系统参数的一项属性的指令。; WriteCfgData; 写入一个已命名系统参数的一项属性。; 保存配置数据; 用于将系统参数存入文件的指令。; SaveCfgData; 将系统参数保存至文件; 重启控制器; 当您变更了基于RAPID语言的系统参数时或其他时候，重启控制 器。; WarmStart; 文本表格指令; TextTabInstall; 在系统中安装一份文本表格。; TextTabGet; 获取一份由用户定义的文本表格的文本表格编号。; TextGet; 从系统文本表格中获取一段文本字符串。; TextTabFreeToUse; 测试是否可随意使用文本表格名称（文本资源字符串）。; 获取对象名称; 用于获取当前参数或当前数据的原始数据对象名称的指令。; ArgName; 返回原始数据对象名称; 获取任务相关信息; GetTaskName; 获取当前程序任务的识别号、名称和编号。; MotionPlannerNo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

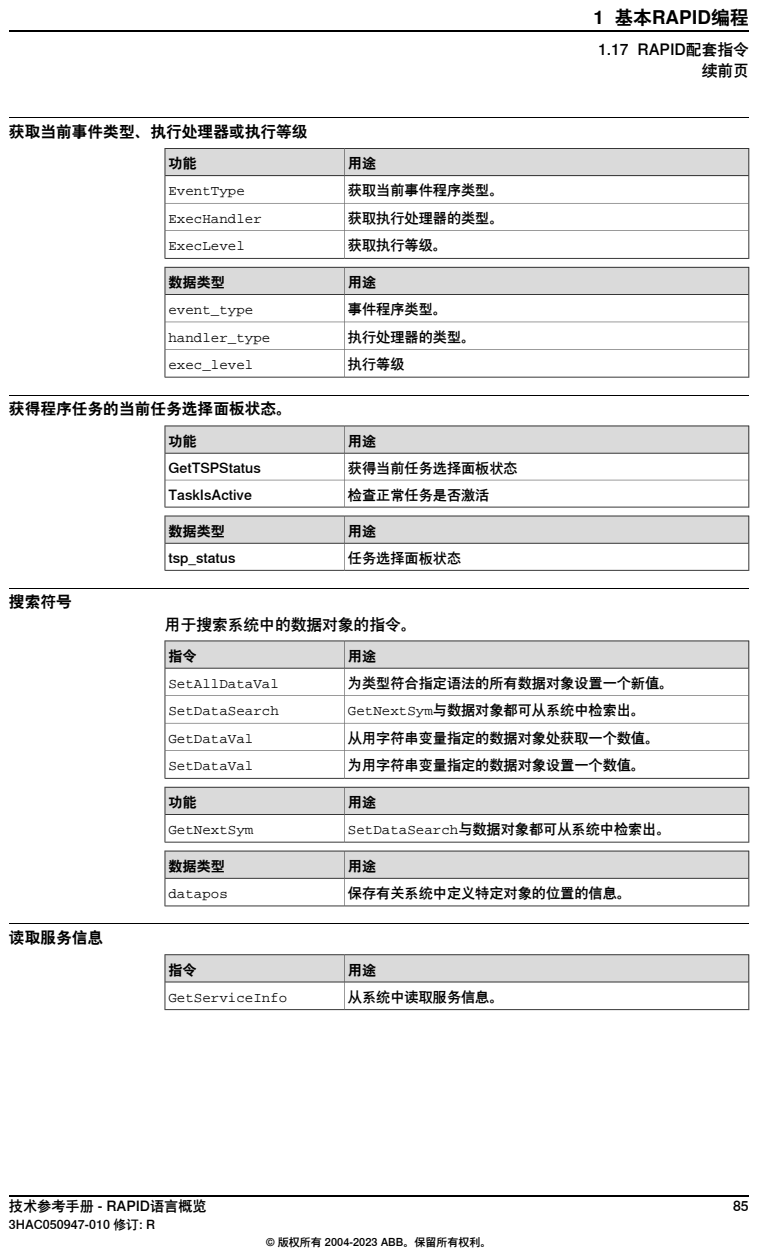
[picture p62: page 85]
获取当前事件类型、执行处理器或执行等级; EventType; 获取当前事件程序类型。; ExecHandler; 获取执行处理器的类型。; ExecLevel; 获取执行等级。; 数据类型; event_type; 事件程序类型。; handler_type; 执行处理器的类型。; exec_level; 执行等级; 获得程序任务的当前任务选择面板状态。; GetTSPStatus; 获得当前任务选择面板状态; TaskIsActive; 检查正常任务是否激活; tsp_status; 任务选择面板状态; 搜索符号; 用于搜索系统中的数据对象的指令。; SetAllDataVal; 为类型符合指定语法的所有数据对象设置一个新值。; SetDataSearch; GetNextSym与数据对象都可从系统中检索出。; GetDataVal; 从用字符串变量指定的数据对象处获取一个数值。; SetDataVal; 为用字符串变量指定的数据对象设置一个数值。; GetNextSym; SetDataSearch与数据对象都可从系统中检索出。; datapos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

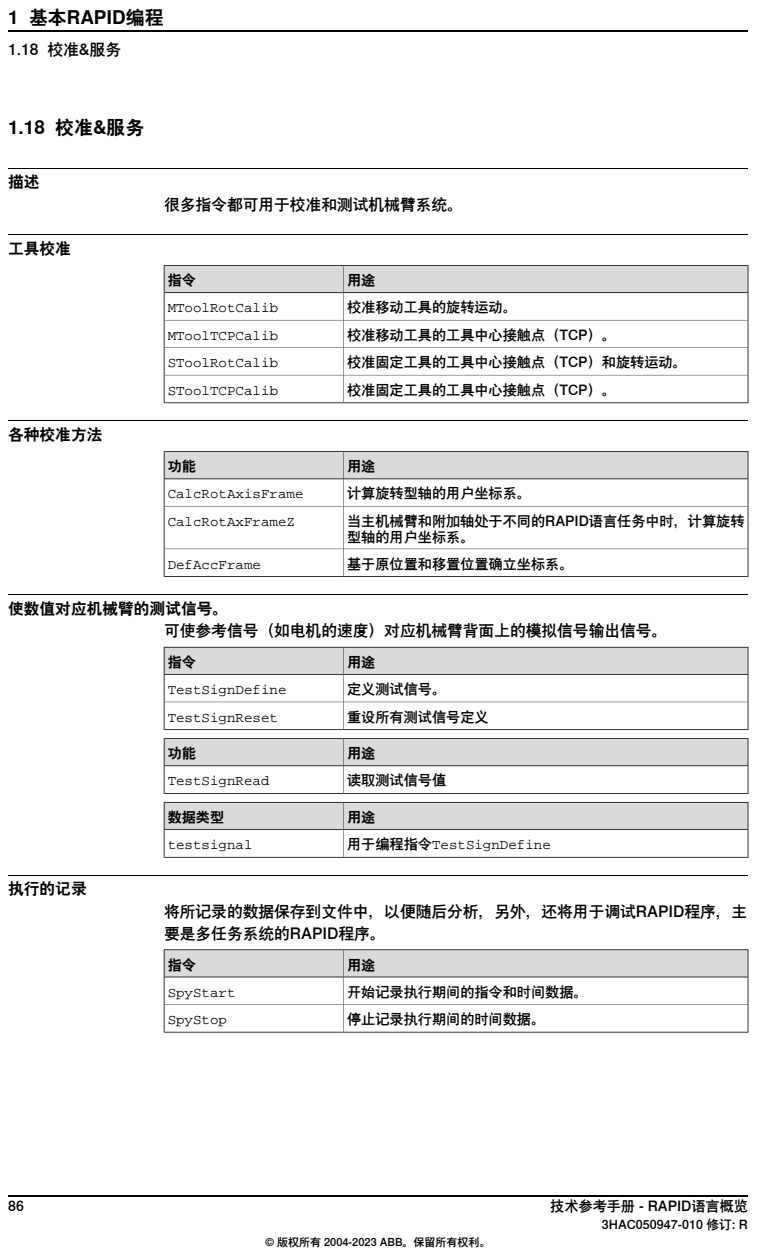
[picture p63: page 86]
很多指令都可用于校准和测试机械臂系统。; 工具校准; MToolRotCalib; 校准移动工具的旋转运动。; MToolTCPCalib; 校准移动工具的工具中心接触点（TCP）。; SToolRotCalib; 校准固定工具的工具中心接触点（TCP）和旋转运动。; SToolTCPCalib; 校准固定工具的工具中心接触点（TCP）。; 各种校准方法; CalcRotAxisFrame; 计算旋转型轴的用户坐标系。; 当主机械臂和附加轴处于不同的RAPID语言任务中时，计算旋转 型轴的用户坐标系。; CalcRotAxFrameZ; DefAccFrame; 基于原位置和移置位置确立坐标系。; 使数值对应机械臂的测试信号。; TestSignDefine; 定义测试信号。; TestSignReset; 重设所有测试信号定义; TestSignRead; 读取测试信号值; 数据类型; testsignal; 用于编程指令TestSignDefine; 执行的记录; SpyStart; 开始记录执行期间的指令和时间数据。; SpyStop; 停止记录执行期间的时间数据。

可使参考信号（如电机的速度）对应机械臂背面上的模拟信号输出信号。

将所记录的数据保存到文件中，以便随后分析，另外，还将用于调试RAPID程序，主
要是多任务系统的RAPID程序。

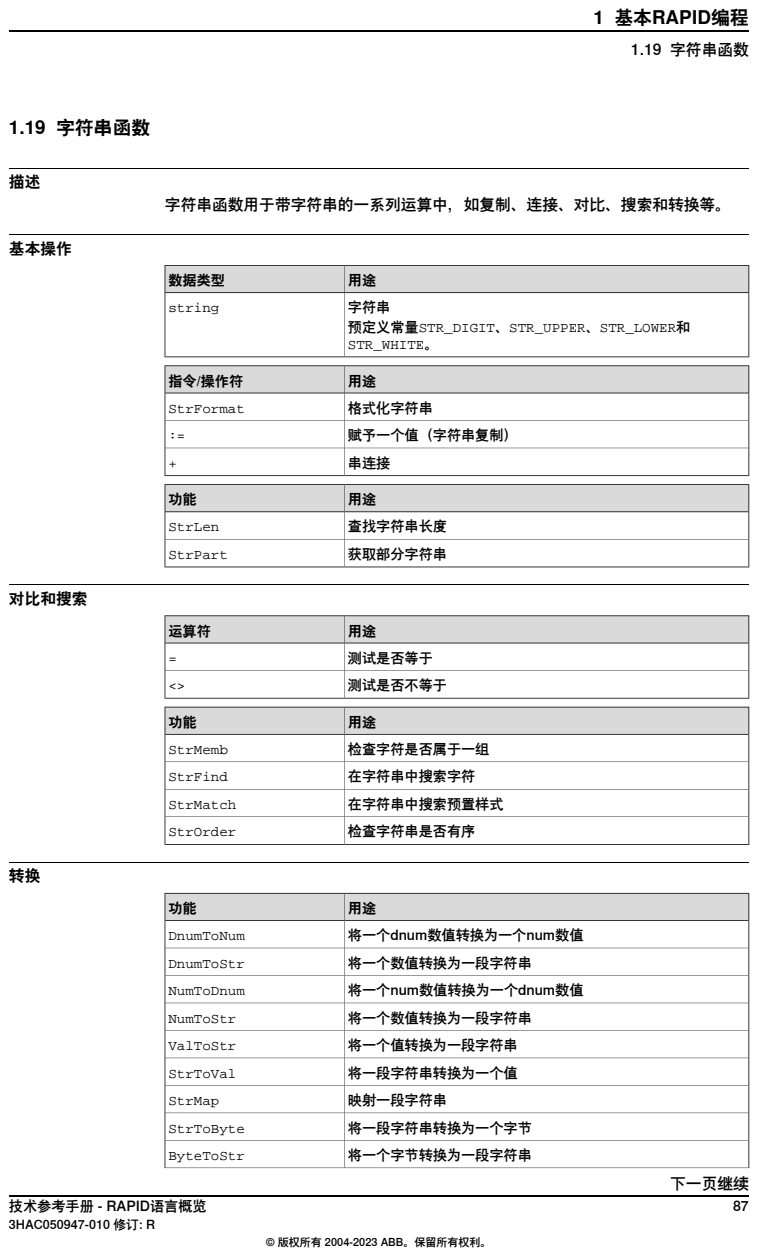
[picture p64: page 87]
1.19 字符串函数; 基本操作; 数据类型; string; 字符串; 预定义常量STR_DIGIT、STR_UPPER、STR_LOWER和; STR_WHITE。; 指令/操作符; StrFormat; 格式化字符串; 赋予一个值（字符串复制）; 串连接; StrLen; 查找字符串长度; StrPart; 获取部分字符串; 对比和搜索; 运算符; 测试是否等于; 测试是否不等于; StrMemb; 检查字符是否属于一组; StrFind; 在字符串中搜索字符; StrMatch; 在字符串中搜索预置样式; StrOrder; 检查字符串是否有序; DnumToNum; 将一个dnum数值转换为一个num数值; DnumToStr; 将一个数值转换为一段字符串; NumToDnum; 将一个num数值转换为一个dnum数值; NumToStr; ValToStr; 将一个值转换为一段字符串; StrToVal; 将一段字符串转换为一个值; StrMap; 映射一段字符串; StrToByte; 将一段字符串转换为一个字节; ByteToStr; 将一个字节转换为一段字符串

字符串函数用于带字符串的一系列运算中，如复制、连接、对比、搜索和转换等。

功能 | 用途
DecToHex | 将10进制可读字符串中指定的一个数字转换成16进制。
HexToDec | 将16进制可读字符串中指定的一个数字转换成10进制。

1.19 字符串函数

### 1.20 多任务

描述
一个机械臂安全围笼中的所有事件通常是并行的，那为什么程序不是并行的呢？ 多任务RAPID是执行（伪）并行程序的一种方式。可将一个并行程序放入另一程序的 后台或前台。另外，也可与另一程序同在一个级别上。
有关所有设置，参见 技术参考手册 - 系统参数。

限制
但在使用多任务RAPID上有几个限制。
- 不要混淆并行程序与PLC。响应时间与某一任务的中断响应时间相同，但在任 务不在另一繁忙程序的后台时，这才是真的。
- 以手动模式运行Wait指令时，约3秒后，将出现一个仿真逻辑单元。但这只会 出现在NORMAL任务中。
- 在运动任务中只能执行移动指令（程序实例 0 中的任务绑定，参见 技术参考手 册 - 系统参数）。
- 在其他任务正访问文件系统时，也就是，若操作员选择保存或打开程序或任务 中的程序采用加载/清除/读取/写入指令，将停止执行任务。
- 除了一项NORMAL任务外，FlexPendant示教器不能访问其他任务。因此只有 在将代码载入NORMAL任务或在离线时才能开发其他SEMISTATIC 或STATIC 任务的RAPID程序。

基本要素
为使用该函数，必须为该机械臂的每个附加程序都额外配置一个任务（TASK）。每 个任务可为NORMAL、STATIC或SEMISTATIC类型。 多达20项任务可同时伪并行运行。每项任务由一组模块按正常程序那样的方式构成。 每项任务中的所有模块都呈局部性。
每项任务中的变量、常量和永久数据对象都呈局部性，但也有例外，即全局永久数据 对象。若未声明该永久数据对象为LOCAL或TASK，则默认其为全局永久数据对象。 可在声明的全局永久数据对象所在的所有任务中，访问名称和类型相同的全局永久数 据对象。若两个全局永久数据对象名称相同，但其类型或大小（数组阶数）不同，则 会发生运行出错。
各任务都有自己的软中断处理，且只有在面对其自身的任务系统状态（如启动、停止 或重启等）时才会触发事件程序。

通用指令和函数

1.20 多任务

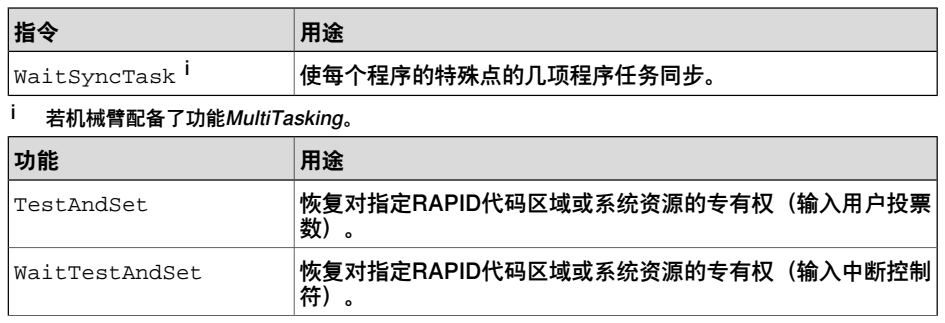
[picture p65: figure]
WaitSyncTask i; 使每个程序的特殊点的几项程序任务同步。; 若机械臂配备了功能MultiTasking。; 恢复对指定RAPID代码区域或系统资源的专有权（输入用户投票 数）。; TestAndSet; 恢复对指定RAPID代码区域或系统资源的专有权（输入中断控制 符）。; WaitTestAndSet
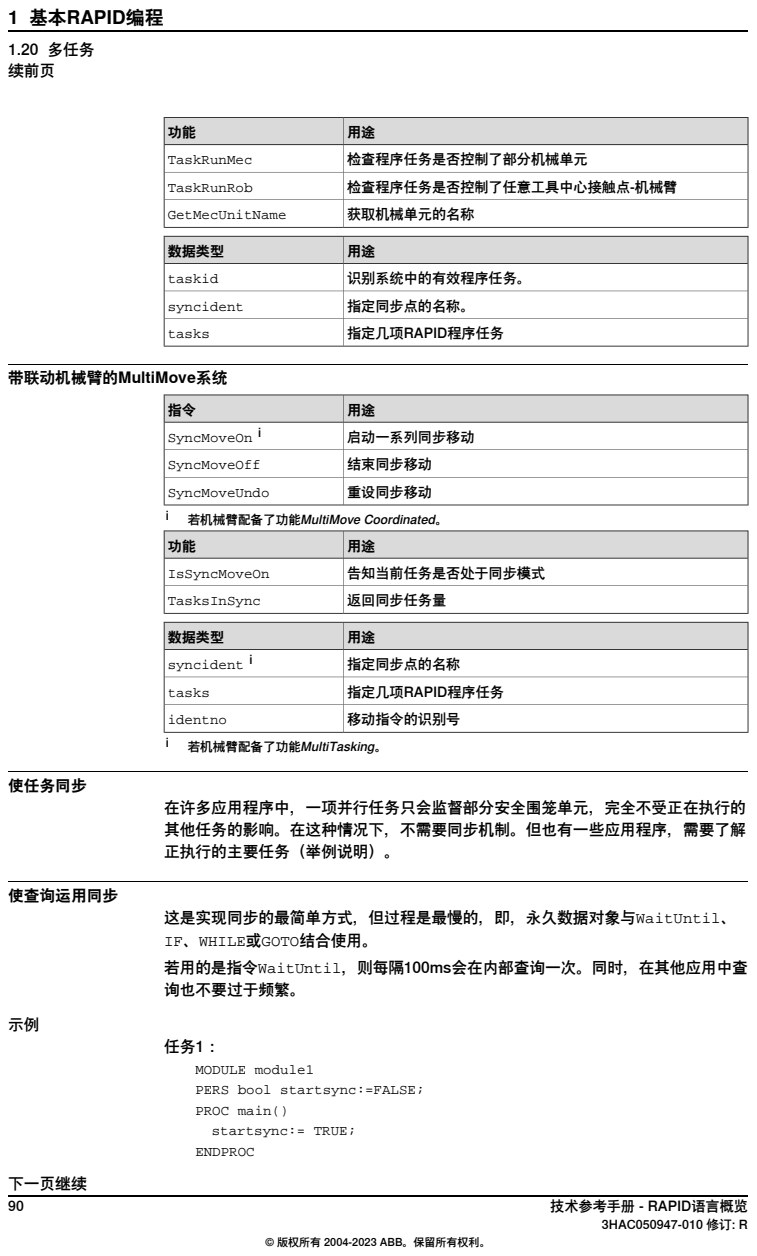
[picture p66: page 90]
TaskRunMec; 检查程序任务是否控制了部分机械单元; TaskRunRob; 检查程序任务是否控制了任意工具中心接触点-机械臂; GetMecUnitName; 获取机械单元的名称; 数据类型; taskid; 识别系统中的有效程序任务。; syncident; 指定同步点的名称。; tasks; 指定几项RAPID程序任务; 带联动机械臂的MultiMove系统; SyncMoveOn i; 启动一系列同步移动; SyncMoveOff; 结束同步移动; SyncMoveUndo; 重设同步移动; 若机械臂配备了功能MultiMove Coordinated。; IsSyncMoveOn; 告知当前任务是否处于同步模式; TasksInSync; 返回同步任务量; syncident i; 指定同步点的名称; identno; 移动指令的识别号; 若机械臂配备了功能MultiTasking。; 使任务同步; 使查询运用同步; startsync:= TRUE;; ENDPROC; 1.20 多任务

在许多应用程序中，一项并行任务只会监督部分安全围笼单元，完全不受正在执行的
其他任务的影响。在这种情况下，不需要同步机制。但也有一些应用程序，需要了解
正执行的主要任务（举例说明）。

这是实现同步的最简单方式，但过程是最慢的，即，永久数据对象与WaitUntil、
IF、WHILE或GOTO结合使用。
若用的是指令WaitUntil，则每隔100ms会在内部查询一次。同时，在其他应用中查
询也不要过于频繁。

MODULE module1
PERS bool startsync:=FALSE;
PROC main()

ENDMODULE
任务2：

MODULE module2

PERS bool startsync:=FALSE;

PROC main()

WaitUntil startsync;

ENDPROC

ENDMODULE

使中断运用同步

运用指令SetDO和ISignalDO。

示例
任务1：

MODULE module1

PROC main()

SetDO do1,1;

ENDPROC

ENDMODULE
任务2：

MODULE module2

VAR intnum isiint1;

PROC main()

CONNECT isiint1 WITH isi_trap;

ISignalDO do1, 1, isiint1;

WHILE TRUE DO

WaitTime 200;

ENDWHILE

IDelete isiint1;

ENDPROC

TRAP isi_trap

ENDTRAP

ENDMODULE

任务间通信
在含全局永久变量的两项（或多项）任务之间，可传送各类数据。 所有任务中的全局永久变量是共用的。在声明该永久变量的所有任务中，该永久变量 必须具备相同的类型和大小（数组阶数）。否则，就会发生运行出错。

示例
任务1：

MODULE module1

PERS bool startsync:=FALSE;

PERS string stringtosend:=””;

PROC main()

1.20 多任务 stringtosend:=”this is a test”;

startsync:= TRUE

ENDPROC

ENDMODULE
TASK 2:

MODULE module2

PERS bool startsync:=FALSE;

PERS string stringtosend:=””;

PROC main()

WaitUntil startsync;

!read string

IF stringtosend = “this is a test” THEN

ENDIF

ENDPROC

ENDMODULE

任务类型
每项任务都必须是NORMAL、STATIC 或SEMISTATIC类型。 按系统启动顺序启动STATIC 和SEMISTATIC任务。若任务是 STATIC类型，则将在 当前位置（系统断电时PP所在位置）重启该任务。若将任务设置为SEMISTATIC，则 每次通电时将从开始启动，同时若模块文件比加载模块更新更快，则要重新加载系统 参数中指定的模块。
启动时，不会启动NORMAL类型的任务。这些任务将按正常方式启动，如通过 FlexPendant示教器。

优先级
默认的任务运行方式是以循环方式运行同处一级的所有任务（各实例中的一个基本步 骤）。而通过将任务嵌入另一任务的后台，则可能改变某一任务的优先级。随后该后 台只有在前台等待某些事件或已停止执行（空闲状态）时才能执行。大多数时候，含 移动指令的机械臂程序都处于空闲状态。
下述示例介绍了系统有10项任务时的部分情况（参见图9）。 循环链1：任务1、2和9正处于繁忙状态。
循环链2：任务1、4、5、6和9正处于繁忙状态，而任务2和3处于空闲状态。 循环链3：任务3、5和6正处于繁忙状态，而任务1、2、9和10处于空闲状态。

1.20 多任务

循环链4：任务7和8正处于繁忙状态，而任务1、2、3、4、5、6、9和10处于空闲状 态。

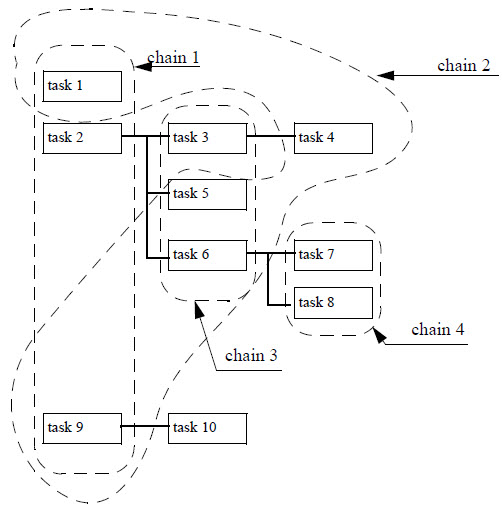
[picture p67: figure]

xx1100000589

图9：任务优先级可有所不同

TrustLevel
出于某种原因停止SEMISTATIC或STATIC任务时或此任务不可执行时，由信任等级 处理系统行为。
- SysFail—这是默认行为，同时所有其他NORMAL任务将停止，系统被设为 SYS_FAIL状态。拒绝所有手动控制和程序启动命令。只有通过热重启重置系 统。这可用于任务具备一定的安全监管时。
- SysHalt—将停止所有NORMAL任务。迫使系统电机关闭。使系统电机开启时， 可手动控制机械臂，但拒绝再次尝试启动程序。同时热重启将重置系统。
- SysStop—将停止所有NORMAL任务，但可重启。同时也可手动控制。
- NoSafety —只有实际任务本身才会停止。
参见 技术参考手册 - 系统参数，主题Controller和类型Task

推荐
指定任务优先级时，要考虑如下事宜：
- 监管任务延时时，常用中断机制或回路。不然，FlexPendant示教器再无法取得 任何时间去与用户互动。若监管任务位于前台，则禁止后台中的另一任务执行。

1.20 多任务

### 1.21 步退执行

描述
有时执行程序可后退一项指令。步退执行时遇到的有效常规限制如下：
- 步退时无法退出IF、FOR、WHILE 和 TEST 语句。
- 到达某一例行程序的开头时将无法以步退方式退出该例行程序。
- 运动设置指令和其他可影响运动的指令不能向后执行。若试图执行这样的指令， 则事件日志中会写入一个警告。
- 当执行向后处理程序时，如果出现执行错误，则不可能在错误处理程序中处理 该错误。

反向处理器
过程可能包含一个定义过程调用步退执行的反向处理器。在调用反向处理器内部的程 序时，可步进执行该程序。
反向处理器实际上是过程的一部分，同时任何程序数据的范围都由过程的反向处理器 构成。
程序的反向处理器或错误处理器中的指令可能不能步退执行。不能嵌入步退执行，也 就是说，不能同时步退执行同一调用链中的两个指令。
不能步退执行无反向处理器的过程。而含空反向处理器的过程可以“空操作”方式执行。

例 1

PROC MoveTo ()

MoveL p1,v500,z10,tool1;

MoveC p2,p3,v500,z10,tool1;

MoveL p4,v500,z10,tool1;

BACKWARD

MoveL p4,v500,z10,tool1;

MoveC p2,p3,v500,z10,tool1;

MoveL p1,v500,z10,tool1;

ENDPROC
若步进执行期间调用了过程，则会出现如下情况：

MoveL p1,v500,z10,tool1;

MoveC p2,p3,v500,z10,tool1;

MoveL p4,v500,z10,tool1;

例 2

PROC MoveTo ()

MoveL p1,v500,z10,tool1;

MoveC p2,p3,v500,z10,tool1;

MoveL p4,v500,z10,tool1;

BACKWARD

MoveL p4,v500,z10,tool1;

MoveC p2,p3,v500,z10,tool1;

MoveL p1,v500,z10,tool1;

ENDPROC
若步进执行期间调用了过程，则会执行如下代码（接反向处理器的过程代码）：

MoveL p1,v500,z10,tool1;

MoveC p2,p3,v500,z10,tool1;

1.21 步退执行

MoveL p4,v500,z10,tool1;
若步退执行期间调用了过程，则会执行如下代码（反向处理器中的代码）：

MoveL p4,v500,z10,tool1;

MoveC p2,p3,v500,z10,tool1;

MoveL p1,v500,z10,tool1;

反向处理器中移动指令的限制
反向处理器中移动指令的类型和顺序必须为同一程序中步进执行用移动指令的类型和 顺序的映射：

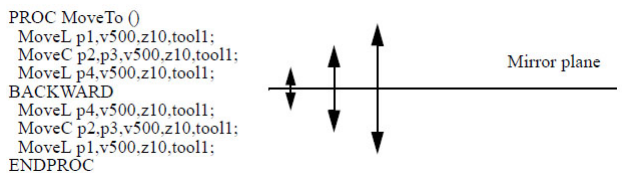
[picture p68: figure]

xx1100000633

步退执行的行为

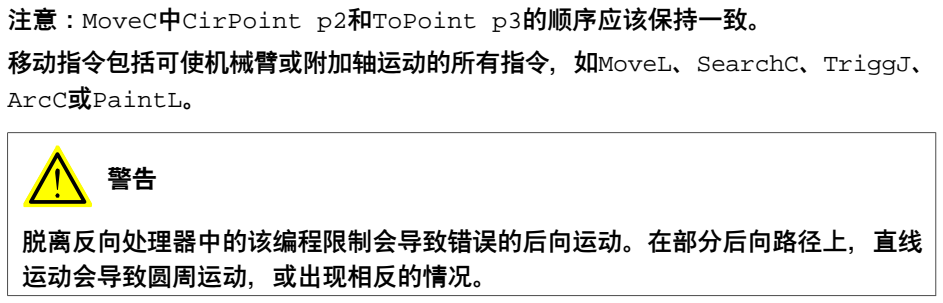
[picture p69: figure]
注意：MoveC中CirPoint p2和ToPoint p3的顺序应该保持一致。; 移动指令包括可使机械臂或附加轴运动的所有指令，如MoveL、SearchC、TriggJ、; ArcC或PaintL。; 脱离反向处理器中的该编程限制会导致错误的后向运动。在部分后向路径上，直线 运动会导致圆周运动，或出现相反的情况。

MoveC和nostepin程序
向前分步执行MoveC指令时，机械臂停在圆点（分两步执行指令）。然而，向后分步 执行MoveC指令时，机械臂不会停在圆点（通过一个步骤执行指令）。 在机械臂执行MoveC指令时，禁止从步进执行变为步退执行。 为了能在nostepin程序中从步进执行变为步退执行或从步退执行变为步进执行，必须 设置系统参数StepOutNoStepin。

目标、运动类型和速度
当步进执行时，在程序代码中，程序指针指示下一步应该执行的程序指令，动作指针 指示机器人的动作指令。
当分步步退执行程序代码时，程序指针指示的指令优先于运动指针指示的指令。当程 序指针和运动指针指示不同的移动指令时，下次将用运动指针指示的类型和速度，向 后移动到程序指针指示的目标处。
就步退执行速度而言，也有例外，即指令MoveExtJ。该指令将robtarget相关速度 运用到步进执行和步退执行中。

1.21 步退执行

示例
下图解释了如何通过动作指令执行步退。程序指针和动作指针可以帮助您跟踪RAPID 的执行位置和机器人的位置。

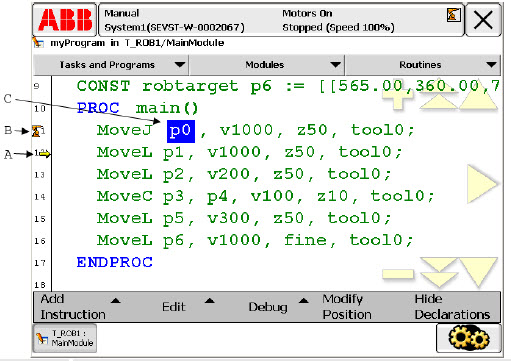
[picture p70: figure]

xx1100000634

A | 程序指针
B | 运动指针
C | 突出机械臂正向前移动要到达或已到达的robtarget

1 使程序向前步进，直至机械臂位于p5。运动指针将指向p5，而程序指针将指向
| Next Move指令（MoveL p6）。
2 首次按下步退按钮时，机械臂不会移动，但程序指针将移动到上一条指令（MoveC p3, p4），表明这就是再次按下步退按钮时将执行的指令。
3 第二次按下步退按钮时，机械臂将以v300的速度沿直线移动至p4。该移动目标 （p4）取自MoveC指令。运动类型（直线）和速度取自下述指令（MoveL p5）。 运动指针将指向p4，程序指针将向上移至MoveL p2。
| 4 第三次按下步退按钮时，机械臂将以v100的速度沿圆周经p3移至p2。目标p2取
自指令MoveL p2。运动类型（圆周）、圆点（p3）和速度取自MoveC指令。 运动指针将指向p2，程序指针将向上移至MoveL p1。
5 第四次按下步退按钮，机械臂将以v200的速度沿直线移动至p1。运动指针将指 向p1，程序指针将向上移至MoveJ p0。
6 首次按下步进按钮，机械臂不会移动，但程序指针会移向后一个指令（MoveL

p2）。
7 第二次按下步进按钮，机械臂将以v200的速度移至p2。

1.21 步退执行

# 2 运动编程和I/O编程

### 2.1 坐标系

### 2.1.1 机械臂的工具中心接触点（TCP）

描述
机械臂的位置及其移动常常与工具中心接触点（TCP）有关。一般情况下，该点被定 义为工具上的某处，如喷胶枪的枪口、机械手的中心或手锥的末端等。 可定义多个工具中心接触点（工具），但一次只能用一个。若已记录下一个位置，则 该位置即为所记录的工具中心接触点的位置，同时也是沿给定路径以给定速率移动的 点。
当机械臂夹住一个对象并在某固定工具上工作时，可用固定工具中心接触点。当该工 具已启用，则编程路径和速度与该对象有关。参见第106页的固定工具中心接触点。

相关信息

参考

全局坐标系的确定 | 技术参考手册 - 系统参数
用户坐标系的确定 | 操作手册 - 带 FlexPendant 的 IRC5
对象坐标系的确定 | 操作手册 - 带 FlexPendant 的 IRC5
工具坐标系的确定 | 操作手册 - 带 FlexPendant 的 IRC5
工具中心接触点的确定 | 操作手册 - 带 FlexPendant 的 IRC5
位移坐标系的确定 | 操作手册 - 带 FlexPendant 的 IRC5

通过不同坐标系手动控制 操作手册 - 带 FlexPendant 的 IRC5

### 2 运动编程和I/O编程

2.1.1 机械臂的工具中心接触点（TCP）

### 2.1.2 用于确定工具中心接触点（TCP）位置的坐标系

描述
通过不同坐标系可指定工具（工具中心接触点）的位置，以便编程和调整程序。 确定的坐标系基于机械臂必须要做的事项。若未确定坐标系，则可通过基座坐标系确 定机械臂的位置。

基座坐标系
在简单应用中，可通过基座坐标系统编程；在该坐标系中，z 轴与机械臂的轴 1 保持 一致。

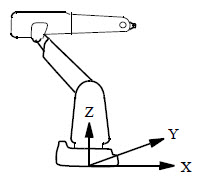
[picture p71: figure]

xx1100000611
基座坐标系位于机械臂的基座上：
- 原点设于轴1与基座安装面的交点处。
- xy平面就是基座安装面。
- x轴 指向前方。
- y轴指向左边（从机械臂角度来看）。
- z轴指向上方。

世界坐标系
若机械臂是安装在地面上，则通过基座坐标系编程较容易。但，如果机械臂是倒置安 装（倒挂安装），那么因各轴的方向与工作空间内的主要方向不同，导致通过基座坐 标系编程变难。此时，定义一个全局坐标系很有用。全局坐标系将与基座坐标系保持 一致，除非另有规定。
有时，在某一装置的同一工作空间内，会有多个机械臂同时运作。本例中使用了一个 公用全局坐标系，使机械臂程序能够彼此通信。当这些位置与车间中的一个定点相关 时，使用这种方法也是一个好主意。

### 2 运动编程和I/O编程

2.1.2 用于确定工具中心接触点（TCP）位置的坐标系

下图显示了两个机械臂(一个悬挂着)，它们有一个公用全局坐标系。

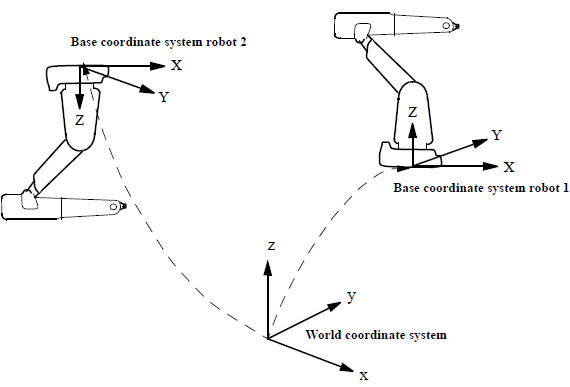
[picture p72: figure]

xx1100000612

用户坐标系
一个机械臂可与不同位置、不同方位的各种固定设备或工作面工作。可为各固定设备 定义一个用户坐标系。若将所有位置都通过对象坐标保存下来，则在必须移动或转动 该固定设备时，不需要再次编程。按移动或转动固定设备的情况移动或转动用户坐标 系，此时所有的已编程位置都将随固定设备变动，因而不需要再次编程。 用户坐标系是在全局坐标系的基础上定义的。
下图显示了描述两个不同夹具位置的两个用户坐标系统。

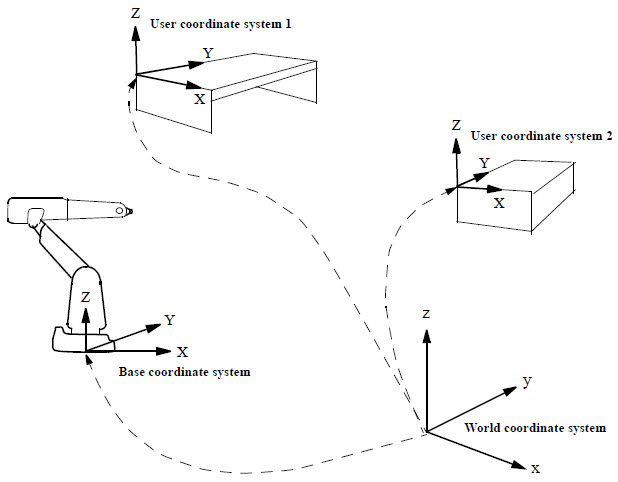
[picture p73: figure]

xx1100000613

### 2 运动编程和I/O编程

2.1.2 用于确定工具中心接触点（TCP）位置的坐标系

对象坐标系
利用用户坐标系获得不同固定设备或工作面的坐标系。但有时，一台固定设备可能包 含几个需要机械臂处理的对象。因此，为便于在移动对象或需要在另一处对一个新对 象（同前述对象一样）进行编程时调节程序，通常要为所有对象都定义一个坐标系。 对象所参照的坐标系就被称为对象坐标系。同时，由于可直接从对象的图纸中找出规 定位置，因此对象坐标系也非常适合离线编程。除此之外，在使机械臂缓慢行进时， 也可用对象坐标系。
在用户坐标系的基础上定义目标坐标系。
下图显示了两个对象坐标系，它们描述位于同一夹具中的两个不同工作对象的位置。

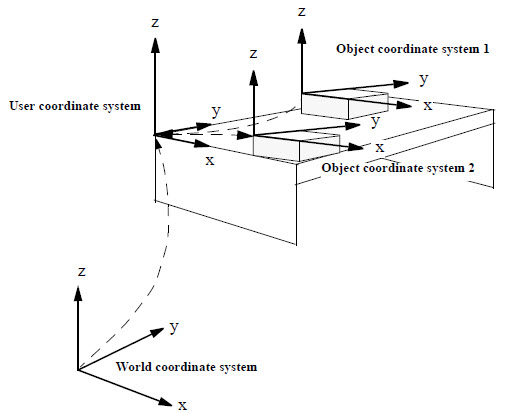
[picture p74: figure]

xx1100000614
通常可基于对象坐标系，定义已编程位置。若要移动或转动固定设备，则可通过移动 或转动用户坐标系加以弥补，既不需要改动已编程位置，也不需要改动已定义对象坐 标系。若要移动或转动对象，则可通过移动或转动对象坐标系加以弥补。 若用户坐标系可移动，也就是说，可用协同附加轴，则对象坐标系可随用户坐标系一 起移动。这样一来，即使是在操纵工作台时，也可使机械臂对照对象作相对运动。

### 2 运动编程和I/O编程

2.1.2 用于确定工具中心接触点（TCP）位置的坐标系

位移坐标系
有时，同一对象上多处的路径相同。为避免每次都要对所有位置重新编程，特别定义 了一个坐标系，即，位移坐标系。另外，可结合搜索功能，使用该坐标系，以弥补单 个零件位置的不同。
位移坐标系基于工件坐标系而定义。

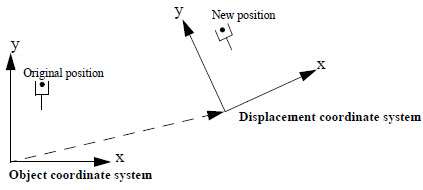
[picture p75: figure]

xx1100000615
若程序位移激活，则将移动所有位置。

### 2 运动编程和I/O编程

2.1.2 用于确定工具中心接触点（TCP）位置的坐标系

协调附加轴

用户坐标系的协调
在机械臂执行对象坐标系定义的路径时，移动某一外部机械单元，同时将对象放到正 移动的机械单元上，则可定义可移动的用户坐标系。此时，用户坐标系的位置和方位 都将视外部单元的轴旋转而定。因此，已编程的路径和速度与对象有关，不需要考虑 对象随外部单元移动一事。
下图显示了一个用户坐标系，定义为跟踪一个 3 轴外部机械单元移动。

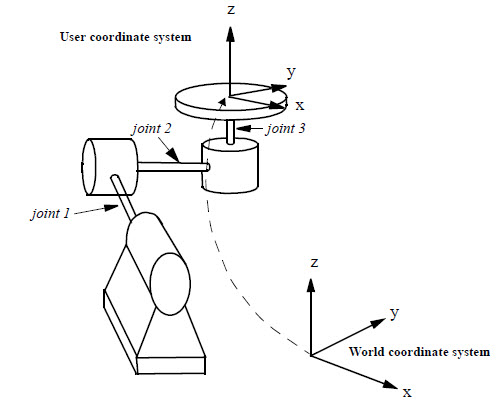
[picture p76: figure]

xx1100000616

### 2 运动编程和I/O编程

2.1.2 用于确定工具中心接触点（TCP）位置的坐标系

基座坐标系的协调
也可为机械臂的基座定义一个可移动坐标系。这有利于安装，比如要将机械臂安装到 轨道或龙门吊上时。同可移动用户坐标系一样，基座坐标系的位置和方位同样视外部 单元的移动情况而定。已编程路径和速度与对象坐标系有关，无需考虑机械臂坐标随 外部单元移动一事。可同步定义一个协调的用户坐标系和一个协调的基座坐标系。 下图显示的是在机械臂的基础坐标系中运动轨迹的协调插补。

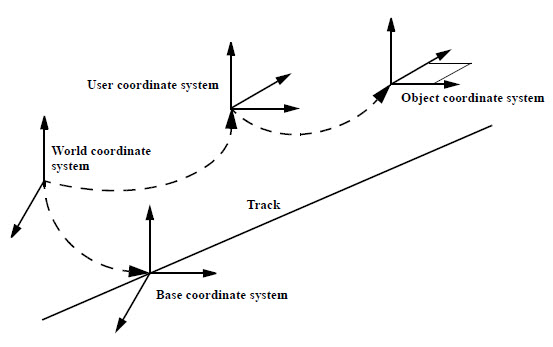
[picture p77: figure]

xx1100000617
为能计算出移动相关单元时的用户和基座坐标系，机械臂必须获知：
- 用户和基座坐标系的校准位置。
- 附加轴的角度与用户和基座坐标系平移或旋转之间的关系；
- 通过系统参数定义上述关系。

### 2 运动编程和I/O编程

2.1.2 用于确定工具中心接触点（TCP）位置的坐标系

### 2.1.3 用于定义工具方向的坐标系

描述
利用工具坐标系的姿态得出某一已编程位置处此工具的姿态。工具坐标系可供机械臂 腕上安装法兰处定义的腕坐标系参考。

腕坐标系
在简单应用中，可通过腕坐标系定义工具的方向。在该坐标系中，z 轴与机械臂的轴 6 保持一致。

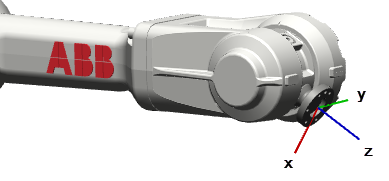
[picture p78: figure]

xx1600000580
腕坐标系不可改动,且从如下方面来看,通常与机械臂的安装法兰保持一致:
- 原点设于安装法兰（安装面上）的中心处；
- x轴沿相反方向指向安装法兰的控制孔。
- z轴指向外面，与安装法兰成直角。

工具坐标系
安装在机械臂安装法兰上的工具通常需要有自己的坐标系，以便定义其工具中心接触 点。工具中心接触点是工具坐标系的原点。另外还可通过工具坐标系，得出缓慢移动 机械臂时正确的移动方向。
若工具受损或要更换工具，则您只需重新定义工具坐标系即可。而程序通常无需作变 动。
选择工具中心接触点（原点）作为工具上必须正确定位的点，如喷胶枪的枪口。自然， 将工具坐标轴定义为存疑工具的坐标轴。

### 2 运动编程和I/O编程

2.1.3 用于定义工具方向的坐标系

下图显示了工具坐标系，通常定义为弧焊枪(左)和点焊枪(右)。

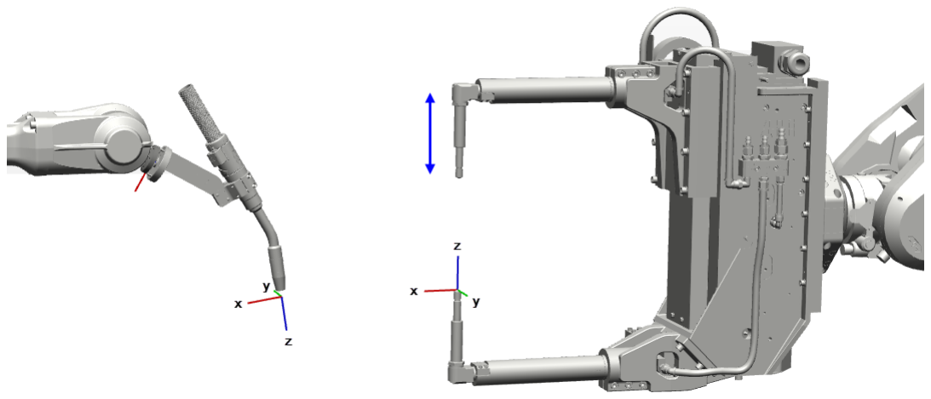
[picture p79: figure]

xx1600000581
基于腕坐标系定义工具坐标系。
下图显示了相对于腕坐标系定义的工具坐标系，此处所示为夹具坐标系。

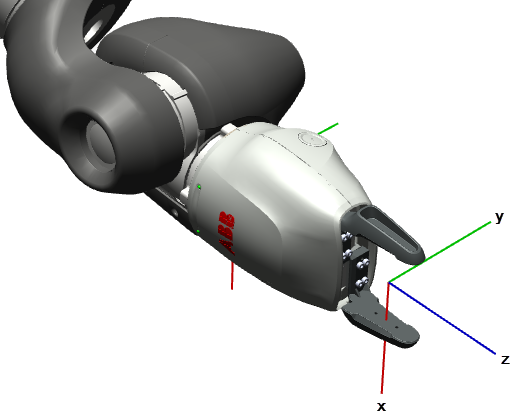
[picture p80: figure]

xx1600000582

### 2 运动编程和I/O编程

2.1.3 用于定义工具方向的坐标系

固定工具中心接触点
如果机械臂拿着一个工作对象在一个固定的工具上工作，就使用一个固定的TCP。如 果该工具处于活动状态，则程序路径和速度与机械臂所持的工作对象相关。这意味着 坐标系将被颠倒，如下图所示。
下图显示了一个固定的 TCP，其中对象坐标系基于腕坐标系。

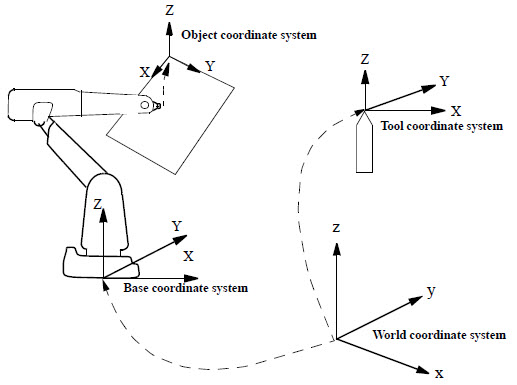
[picture p81: figure]

xx1100000635
在下面的图中，既没用用户坐标系，也没用程序位移。但实际上可以用它们。在用了 这两者的情况下，这两者将互相关联。

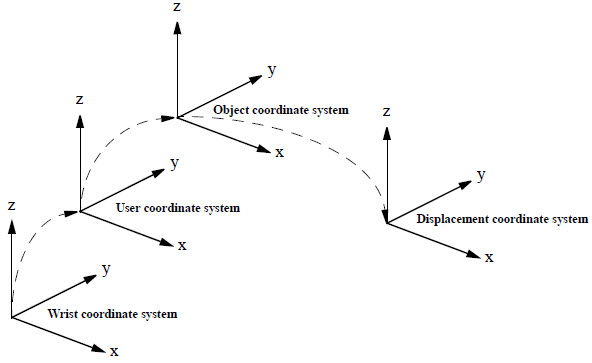
[picture p82: figure]

xx1100000636
程序位移也可以与固定 TCPs 一起使用

### 2 运动编程和I/O编程

2.1.3 用于定义工具方向的坐标系

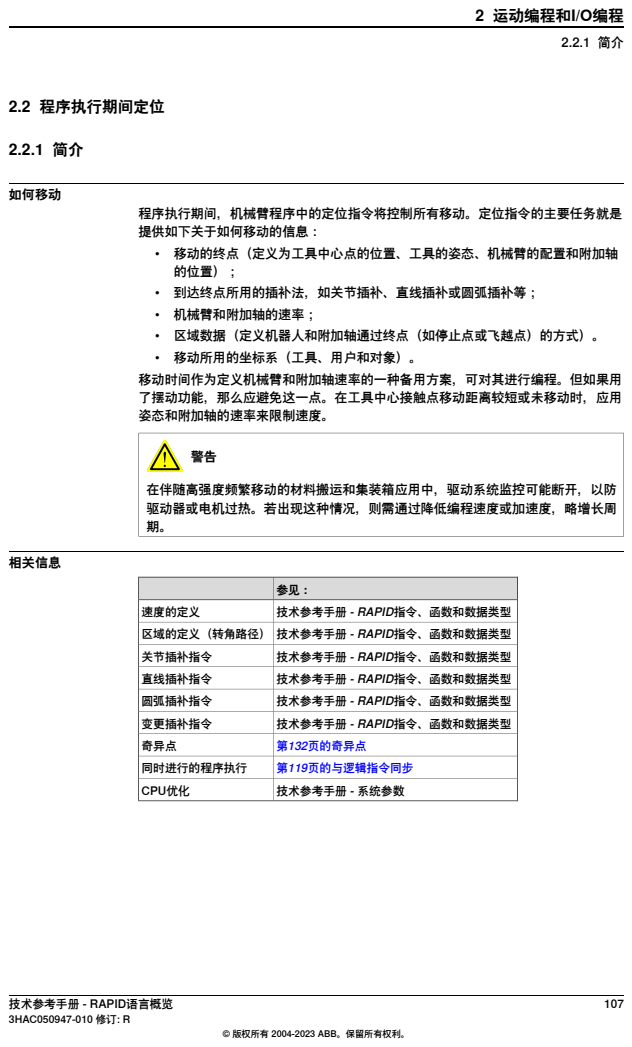
[picture p83: page 107]
2.2 程序执行期间定位; 如何移动; 相关信息; 速度的定义; 技术参考手册 - RAPID指令、函数和数据类型; 关节插补指令; 直线插补指令; 圆弧插补指令; 变更插补指令; 奇异点; 第132页的奇异点; 同时进行的程序执行; 第119页的与逻辑指令同步; CPU优化; 技术参考手册 - 系统参数; 2 运动编程和I/O编程

程序执行期间，机械臂程序中的定位指令将控制所有移动。定位指令的主要任务就是
提供如下关于如何移动的信息：
• 移动的终点（定义为工具中心点的位置、工具的姿态、机械臂的配置和附加轴
的位置）；
• 到达终点所用的插补法，如关节插补、直线插补或圆弧插补等；
• 机械臂和附加轴的速率；
• 区域数据（定义机器人和附加轴通过终点（如停止点或飞越点）的方式）。
• 移动所用的坐标系（工具、用户和对象）。
移动时间作为定义机械臂和附加轴速率的一种备用方案，可对其进行编程。但如果用
了摆动功能，那么应避免这一点。在工具中心接触点移动距离较短或未移动时，应用
姿态和附加轴的速率来限制速度。

在伴随高强度频繁移动的材料搬运和集装箱应用中，驱动系统监控可能断开，以防
驱动器或电机过热。若出现这种情况，则需通过降低编程速度或加速度，略增长周

区域的定义（转角路径） 技术参考手册 - RAPID指令、函数和数据类型

### 2.2.2 工具位置和姿态的插补

关节插补
若不是很重视路径精确度，则可通过此类运动将工具从某一位置快速移动至另一位置。 此外，关节插补支持某一根轴从任意位置一次性移动至其工作空间内的另一位置。 所有轴都能以恒定轴速率从起点移至终点，见下图。
关节插补通常是两点间最快的移动方式，原因在于机械臂轴是在沿起点与终点间（从 轴角度而言）的最短路径移动。

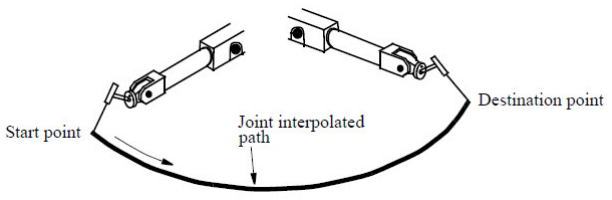
[picture p84: figure]

xx1100000637
工具中心点的速率按mm/s计（在对象坐标系中）。由于插补都是一根轴接一根轴进行 的，因此实际速率不可能是编程值。
在插补期间，确定限制轴的速率。限制轴是为实施移动而行进最快（相对于其最大速 率而言）的一根轴。然后计算其他轴的速率，以便所有轴可同时到达终点。 协调所有轴，以得到不受速率影响的一条路径。自动优化加速度，以尽可能发挥出机 械臂的最佳性能。

直线插补
在线性插补过程中，TCP 沿着起点和终点之间的直线运行。

xx1100000638
为通过对象坐标系获得一条直线路径，机械臂轴必须沿轴空间内的非直线路径行进。 机械臂配置的非线性程度越严重，则需要的加速度和减速度更多变，才能使工具沿直 线移动，并获得满意的工具姿态。若配置的非线性程度极其严重（如接近腕和臂奇异 点），则一根或多根轴将需要超出电机能力范围的扭矩。此时，将自动降低所有轴的 速率。
在整个移动过程中，工具的姿态始终不变，除非是已完成对调整姿态的编程。若调整 工具姿态，则使其以恒定速率旋转。
在转动工具的同时，可指定最大旋转速率（以度/秒计）。若将其设为较小值，则不管 定义的工具中心点的速率为多少，都可顺利调整姿态。若为较大值，则只有通过最大 电机速率限制调整姿态速率。只要没有电机超过扭矩限值，就可维持定义速率。而若 有任一电机超过当前限值，那么整个移动过程的速率（与位置和姿态有关）都将被迫 减小。
协调所有轴，以获得一条不受速率影响的路径。自动优化加速度。

### 2 运动编程和I/O编程

2.2.2 工具位置和姿态的插补

圆弧插补
圆路径是由三个定义圆段的编程位置定义的。要编程的第一个点是圆段的起点。下一 个点是一个支撑点(圆点)，用来定义圆的曲率，第三个点表示圆的终点。这三个程序 点应按一定的间隔沿圆弧散布，以使其尽可能精确。
为支撑点定义的方向用于从起点到终点的方向，在短捻和长捻之间进行选择。如果编 程的方向相对于起点和终点的圆是相同的，并且支撑点的方向相对于圆是接近相同的 方向，那么工具的方向相对于路径将保持不变。
下图是一个圆(圆段)的起点、圆点和终点部分的短捻圆弧插补。

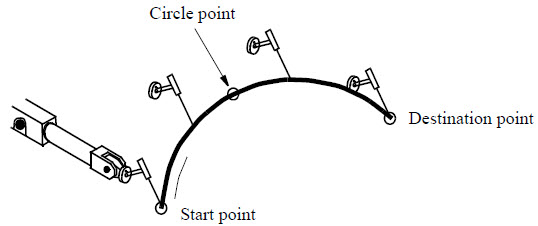
[picture p85: figure]

xx1100000639
但是，如果将支撑点的方向编程为更接近旋转 180° 的方向，则选择备选捻度，如下 图所示。

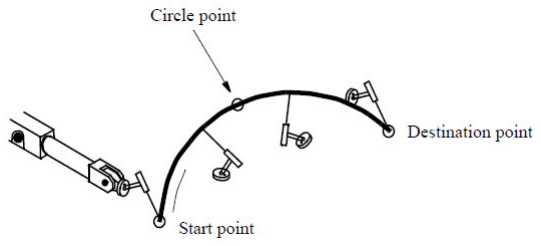
[picture p86: figure]

xx1100000640
只要所有电机扭矩不超过最大允许值，那么工具将以编程速率沿圆弧移动。若任一电 机的扭矩不足，则在圆周路径上电机性能不足的地方，速率将自动减小。 协调所有轴，以获得一条不受速率影响的路径。自动优化加速度。

### 2 运动编程和I/O编程

2.2.2 工具位置和姿态的插补

SingArea\Wrist
在接近奇异点的情况下执行时，直线或圆弧插补可能存在问题。此时，最好用变更插 补，也就是说腕轴是一根接一根插补的，同时工具中心接触点沿直线或圆周路径移动。 但工具的姿态与编程姿态多少有点儿不同。考虑到有两个奇异点，编程点处的最终姿 态也可能异于编程姿态。

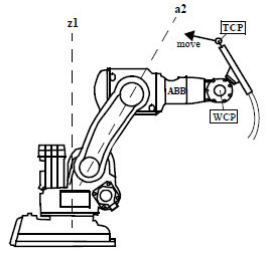
[picture p87: figure]

xx1100000641
第一个奇异点出现在工具中心接触点从轴2（上图的a2）一直向前时。工具中心接触 点没法到达轴2的另一侧，而且轴2和轴3还会微微合拢，使工具中心接触点停留在同 一侧。随后，移动的终点姿态与编程姿态之间将存在同样的尺寸误差。 第二个奇异点出现在工具中心接触点经过轴 1（上图的 z1）的 z 轴时。此时轴 1 将全 速转向，同时工具调整姿态也将按同样的方式进行。转向与工具中心接触点将到达哪 一侧无关。我们推荐改为在z轴附近进行关节插补（MoveJ）。注意，使用 SingArea\Off时，产生奇异点的是 TCP，不是 WCP。 在SingArea\Wrist情况下，圆周支撑点的姿态与设定姿态相同。但工具相对于圆周 平面的方向就不能像在正常圆弧插补中那样保持不变。若圆周路径通过一个奇异点， 则有时必须要更改设定位置处的姿态，以免腕动作过大。执行圆周运动时（关节4和6 分别移动180度），如果发生完整的腕再配置，则会出现腕动作过大这一情况。

### 2 运动编程和I/O编程

2.2.2 工具位置和姿态的插补

### 2.2.3 拐角路径插补

描述
圆角路径用于使持续移动路径越过设定位置。按此方式，无需降低速度，即可快速越

定义圆角路径

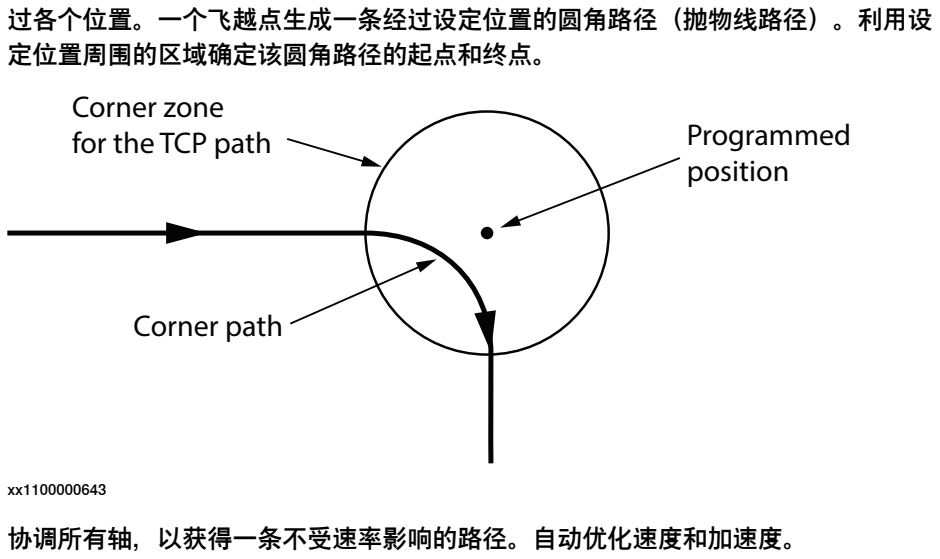
[picture p88: figure]
过各个位置。一个飞越点生成一条经过设定位置的圆角路径（抛物线路径）。利用设 定位置周围的区域确定该圆角路径的起点和终点。; Corner zone for the TCP path; Corner path; Programmed position; 协调所有轴，以获得一条不受速率影响的路径。自动优化速度和加速度。

用数据类型zonedata来定义圆角区域的尺寸，该数据类型被用作移动指令中的一个 参数。更多详细信息，请参阅技术参考手册 - RAPID指令、函数和数据类型中的

zonedata。

在不同速度之间顺利过渡
若圆角位置前后的设定TCP速度不同，则将顺利地从一种速度转变为另一种速度，且 此转变过程是在圆角路径范围内完成，不影响实际路径。
若圆角位置前后设定的调整方位速率不同，且该速率限制移动，则在圆角路径范围内， 可从一种速率顺利转变到另一种速率。

微调路径
若要用工具沿拐角路径实施一种工艺（如弧焊、涂胶或水力切割等），则可调整区域 半径，以获得合格路径。若抛物线状拐角路径的形状与对象几何结构不匹配，则可缩 小设定位置之间的距离，以便用两条或更多较短的抛物线路径得到近似于合格路径的 路径。

圆角路径及重新调整
一个飞越点可针对TCP位置（位置区域）设置一个区域尺寸，并针对工具重新调整和 附加轴运动（重新调整和附加轴区域）设置一个区域尺寸。 可将重新调整和附加轴区域定义为与位置区域类似。重新调整和附加轴区域设置通常 高于位置区域。此时，调整方位将抢在圆角路径开始前朝着下一位置的方位进行插补。 随后调整方位变得更容易。

### 2 运动编程和I/O编程

2.2.3 拐角路径插补

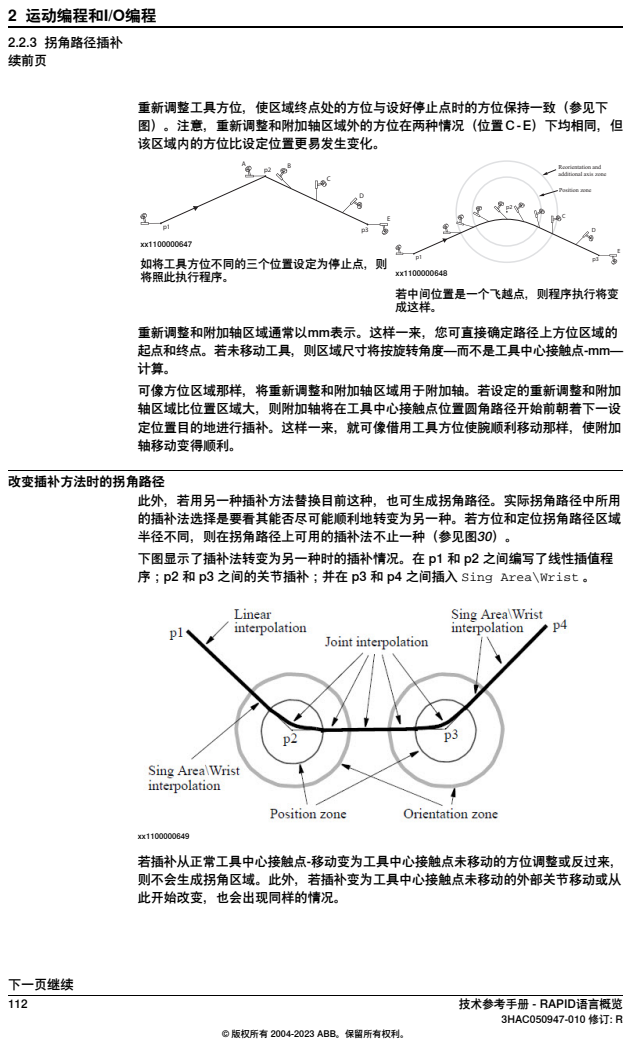
[picture p89: page 112]
Position zone; xx1100000648 若中间位置是一个飞越点，则程序执行将变 成这样。; xx1100000647 如将工具方位不同的三个位置设定为停止点，则 将照此执行程序。; 改变插补方法时的拐角路径; 2 运动编程和I/O编程; 2.2.3 拐角路径插补

重新调整工具方位，使区域终点处的方位与设好停止点时的方位保持一致（参见下
图）。注意，重新调整和附加轴区域外的方位在两种情况（位置C-E）下均相同，但
该区域内的方位比设定位置更易发生变化。

Reorientation and
additional axis zone

重新调整和附加轴区域通常以mm表示。这样一来，您可直接确定路径上方位区域的
起点和终点。若未移动工具，则区域尺寸将按旋转角度—而不是工具中心接触点-mm—
可像方位区域那样，将重新调整和附加轴区域用于附加轴。若设定的重新调整和附加
轴区域比位置区域大，则附加轴将在工具中心接触点位置圆角路径开始前朝着下一设
定位置目的地进行插补。这样一来，就可像借用工具方位使腕顺利移动那样，使附加
轴移动变得顺利。

此外，若用另一种插补方法替换目前这种，也可生成拐角路径。实际拐角路径中所用
的插补法选择是要看其能否尽可能顺利地转变为另一种。若方位和定位拐角路径区域
半径不同，则在拐角路径上可用的插补法不止一种（参见图30）。
下图显示了插补法转变为另一种时的插补情况。在 p1 和 p2 之间编写了线性插值程
序；p2 和 p3 之间的关节插补；并在 p3 和 p4 之间插入 Sing Area\Wrist 。

若插补从正常工具中心接触点-移动变为工具中心接触点未移动的方位调整或反过来，
则不会生成拐角区域。此外，若插补变为工具中心接触点未移动的外部关节移动或从
此开始改变，也会出现同样的情况。

改变坐标系时的插补
若拐角路径上坐标系发生变化，如出现新工具中心接触点或新对象时，则用拐角路径 关节插补。另外，从协调操作变为非协调操作或反过来时，同样可用此插补法。

所设定圆角区域的尺寸缩减程度
若设定位置相互靠近，则设定区域重叠是不正常的。为获得一条清晰明确的路径及随 时能达到最佳速率，机器人要将该区域尺寸缩小。机器人默认将该区域缩小为从一个 设定位置到另一设定位置的距离的一半。

关于默认区域设置的行为
关于默认设置，与一邻近点距离过半的设定区域会导致区域缩小（参见下图）。相同 区域半径默认用于某一设定位置的出入路径。
下图显示了一个位置区域过大的插补插值。p3 周围的区域都比 p2 到 p3 距离的一半

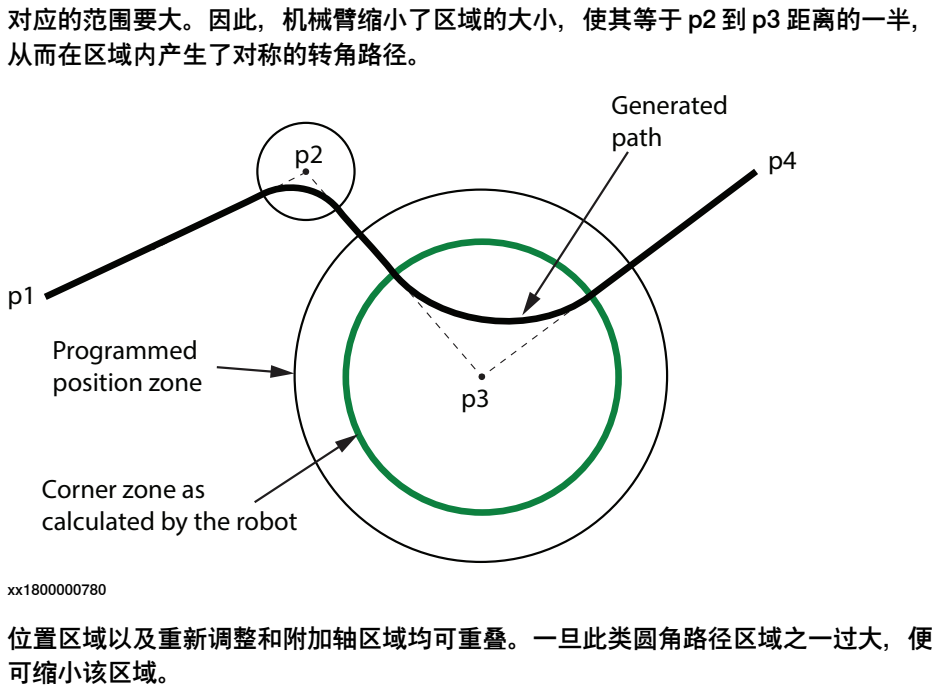
[picture p90: figure]
对应的范围要大。因此，机械臂缩小了区域的大小，使其等于 p2 到 p3 距离的一半， 从而在区域内产生了对称的转角路径。; Generated path; Programmed position zone; Corner zone as calculated by the robot; 位置区域以及重新调整和附加轴区域均可重叠。一旦此类圆角路径区域之一过大，便 可缩小该区域。

注意

通过更改系统参数Relative zone size with finepoint（主题Motion，类型Motion Planner），允许圆角区域与一邻近精确点的距离过半。 通过设定系统参数Allow asymmetric zones（主题Motion，类型Motion Planner）， 针对进出路径的圆角区域尺寸可能不同。
请参见技术参考手册 - 系统参数。

飞越点的计划时间
有时，若未及时制定好下一次移动的计划，则设定飞越点会导致停止点的出现。这种 情况可能会发生在：
- 较短移动范围与较短移动范围之间设定了多个程序执行时间较长的逻辑指令；
- 高速状况下，点与点之间间距极短。

### 2 运动编程和I/O编程

2.2.3 拐角路径插补

### 2 运动编程和I/O编程

2.2.3 拐角路径插补

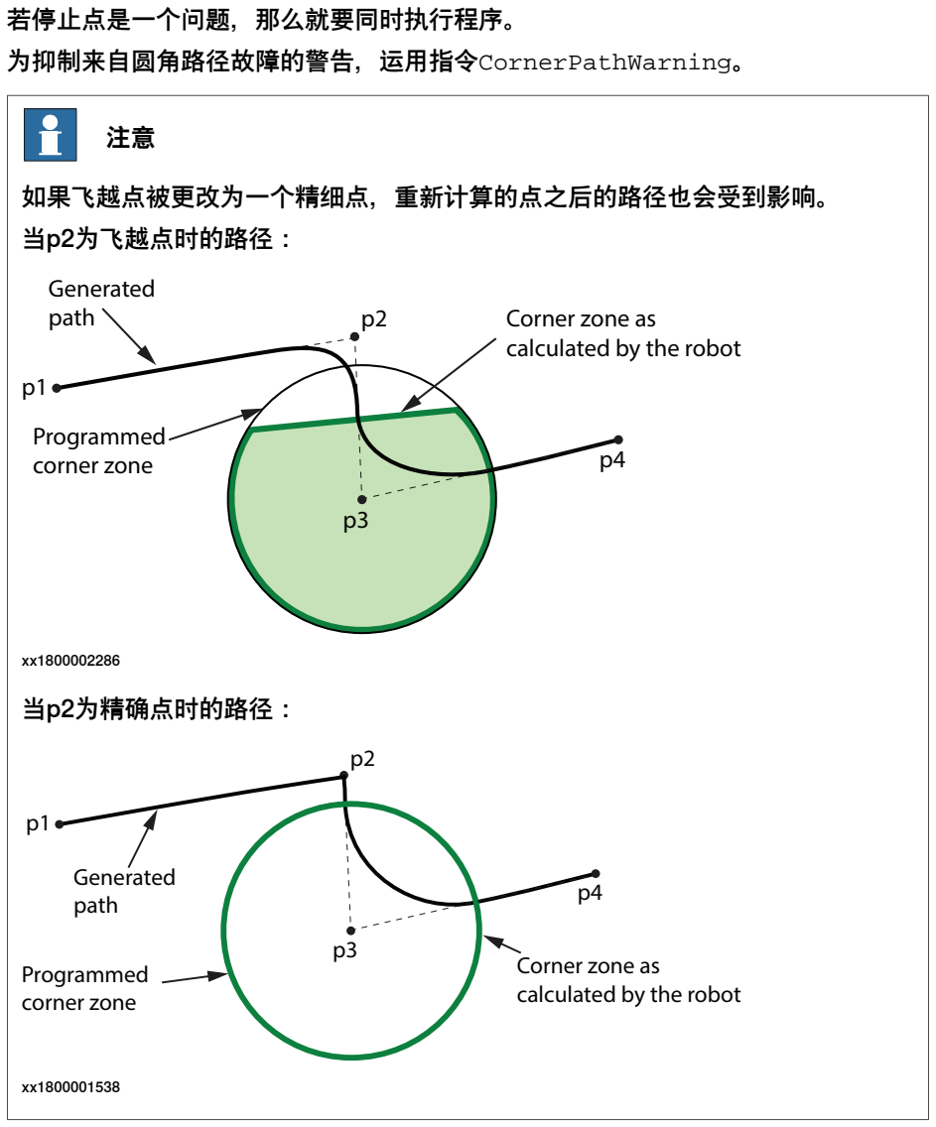
[picture p91: figure]
若停止点是一个问题，那么就要同时执行程序。; 为抑制来自圆角路径故障的警告，运用指令CornerPathWarning。; 如果飞越点被更改为一个精细点，重新计算的点之后的路径也会受到影响。; 当p2为飞越点时的路径：; Generated path; Programmed corner zone; Corner zone as calculated by the robot; 当p2为精确点时的路径：

### 2.2.4 独立轴

描述
独立轴是指机械臂系统中不受其他轴影响、可独立移动的轴。可将某一根轴改设为独 立模式，然后再恢复正常模式。
有一组指令，专门用于处理独立轴。四种不同的移动指令对该轴的移动作了规定。如， IndCMove指令使轴开始持续移动。随后轴以恒定速度持续移动（不管机械臂的行为 如何），直到执行一个新的独立指令。
要改回正常模式，就要用重设指令IndReset。此外，重设指令也可为测量系统设置 新基准，即一种全新的轴同步类型。一旦轴变回正常模式，则可使其按正常轴那样运 行。

程序执行
一执行Ind_Move，轴即刻变为独立模式。即使是在已将前一个点设为飞越点或同步 执行程序等情况下，该轴正在移动中，也不能避免这种行为。 若上一指令执行还未结束即执行一个新的Ind_Move指令，则该新指令即刻就会覆盖 旧指令。
若在独立轴移动过程中，停止执行程序，则该轴将停止。当继续执行该程序时，独立 轴也会自动启动。独立轴和正常模式下的其他轴之间未有效协调。 若在轴处于独立模式时，出现电压损失，则不能再次开始执行程序。随后会显示出错 信息，同时必须重新从头开始执行程序。
注意，若机械单元的某一根轴处于独立模式，则该机械单元不一定会停止活动。

逐步执行
在逐步执行期间，执行另一指令的同时只能操纵一根独立轴。同时该轴也要遵循其他 指令的执行情况按步骤移动。

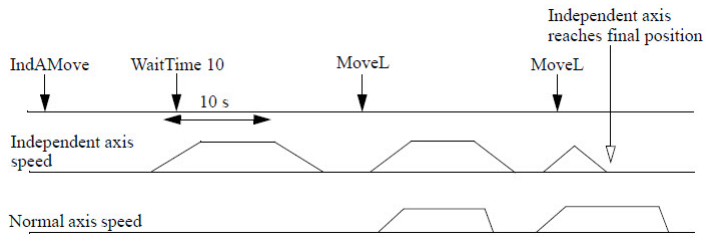
[picture p92: figure]

xx1100000652

微动控制
无法使处于独立模式的轴缓慢移动。试图手动操纵该轴时，该轴不会移动，接着会显 示一条出错信息。执行IndReset指令或移动程序指针到主程序，以脱离独立模式。

工作范围
实际工作范围就是该轴的整体移动范围。
逻辑工作范围就是为RAPID指令所用的且可通过操控窗口读取的范围。

### 2 运动编程和I/O编程

2.2.4 独立轴

同步化（更新转数计数器）后，实际工作范围和逻辑工作范围相同。运用 IndReset 指令，可移动逻辑工作区域，参见下图。

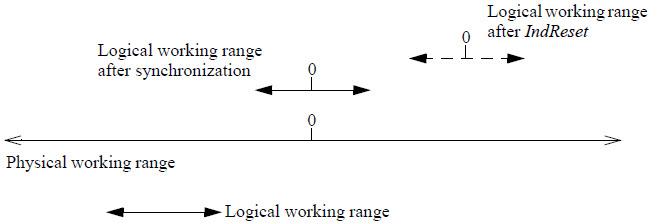
[picture p93: figure]

xx1100000653
逐渐偏离逻辑位置0的过程中，迫使位置的分辨率降低。低分辨率加上刚性控制器会造 成扭矩不合格、噪声和控制器不稳定。安装时，检查靠近工作范围界限的控制器调节 和轴性能情况，同时检查位置分辨率和路径性能是否合格。

速度和加速度
在速度减小的手动模式下，将速度减小至以前轴处于非独立运行中所达到的水平。注
意，若减小轴速度，则IndSpeed函数不为TRUE。
VelSet指令和通过生成窗口进行的速度修正（以百分比计）对于独立移动有效。注 意，通过生成窗口进行的修正会妨碍TRUE值成为IndSpeed函数。 在独立模式下，要用配置文件中规定的最小加速度值和最小减速度值。可通过指令使 该值按梯度值减小（1%~100%）。AccSet指令不会影响处于独立模式的轴。

机器人轴
只有机械臂轴6可用作独立轴。正常情况下，IndReset指令只可用于该轴。但 IndReset指令同样可供IRB1600型、2600型和4600型（不包括ID版）上的轴4使用。 若IndReset用于机械臂轴4，则轴6一定不能处于独立模式。 若用轴6作独立轴，则因仍沿用正常的6轴坐标变换函数，可能会出现奇异点问题。若 真的出现，就在轴6处于正常模式的情况下执行相同的程序。变更各个点或用

SingArea\Wrist或MoveJ指令。
在路径性能计算过程中轴6处于内部活动状态，导致如此的原因在于轴6的内部移动会 减小系统中其他轴的速度。
在轴4和轴5处于起始位置的情况下，界定轴6的独立工作范围。若轴4或轴5不在起始 位置，则齿轮啮合也会导致轴6的工作范围移动。但从FlexPendant示教器上读取的轴 6的位置已通过齿轮啮合由轴4和轴5的位置加以补偿。

### 2 运动编程和I/O编程

2.2.4 独立轴

### 2.2.5 软伺服

描述
在某些应用中，需要一个伺服充当机械弹簧。也就是说，机械臂作用于对象的力将随 着设定位置（对象后）和接触位置（机械臂工具与对象之间）之间的距离变化而增大。

柔性度
位置偏差和力之间的关系可利用柔性度这一参数进行定义。柔性度参数越大，获得同 样大的力所需的位置偏差也就越大。
通过程序设置柔性度参数，同时可在程序中任意处变更柔性度值。不同点的柔性度值 设置不同，同时可将具备正常伺服的关节与具备软伺服的关节混合。 在移动机械臂的同时，可启用和禁用软伺服，还可变更柔性度值。这样做的同时，不

### 2 运动编程和I/O编程

2.2.5 软伺服

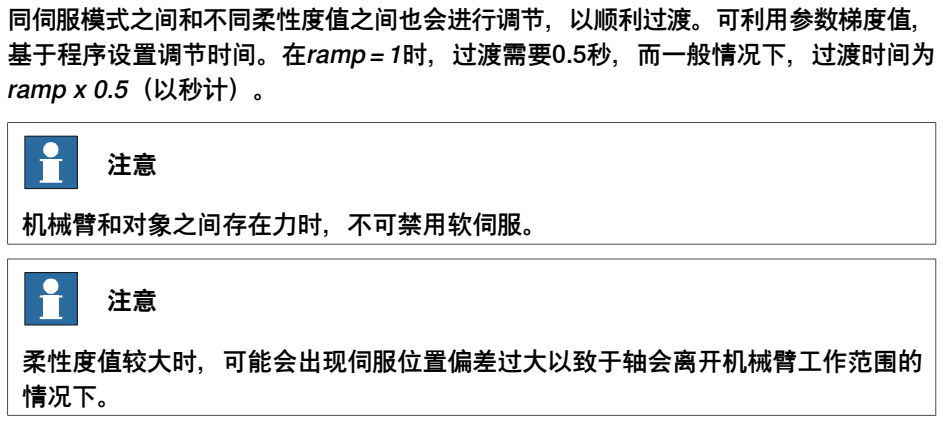
[picture p94: figure]
同伺服模式之间和不同柔性度值之间也会进行调节，以顺利过渡。可利用参数梯度值， 基于程序设置调节时间。在ramp = 1时，过渡需要0.5秒，而一般情况下，过渡时间为 ramp x 0.5（以秒计）。; 机械臂和对象之间存在力时，不可禁用软伺服。; 柔性度值较大时，可能会出现伺服位置偏差过大以致于轴会离开机械臂工作范围的 情况下。

### 2.2.6 停止和重启

停止移动
可通过如下三种方式停止移动：
- 正常情况下，机器人会停在路径上，这样方便重启。
- 强制停止时，机器人会在比正常停止用时更短的时间内停下，但减速路径会偏 离设定路径。这种停止方式可用于搜索停止等须尽快停止运动的情况中。 强制停止时，机器人会在比软停止用时更短的时间内停下，但减速路径会偏离 设定路径。这种停止方式可用于搜索停止等须尽快停止运动的情况中。
- 快速停止情况下，用机械制动器,以减速移动一段距离,出于安全原因,该距离应符 合规定长度。通常在该情况下的路径偏差要比强制停止时的大。

开始移动
通常，停止（上述任一类）后，都可在中断路径处重启。若机械臂停在了设定路径范 围外，则可返回路径上机械臂停止的位置再重启。
断电后重启等同于快速停止后重启。应注意，机械臂通常会在重启中断的程序操作前 返回路径，即使是在逻辑指令运行时断电，也是如此。重启时，要从头开始计时，如 按时定位或确定指令WaitTime中断位置。

### 2 运动编程和I/O编程

2.2.6 停止和重启

### 2.3 与逻辑指令同步

逻辑指令
一般来说是通过程序连续执行指令。但也可在特定位置或在持续移动期间执行逻辑指 令。
逻辑指令是指不会造成机械臂移动或附加轴移动的所有指令，如I/O指令。

在停止点连续执行程序
若已将定位指令设为停止点，则不能执行其后面的指令，直到机械臂和附加轴停止， 即到达设定位置时。

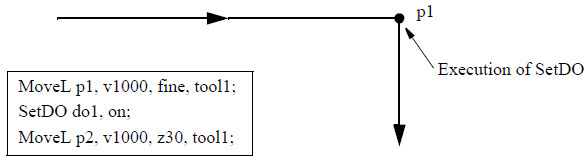
[picture p95: figure]

xx1100000654

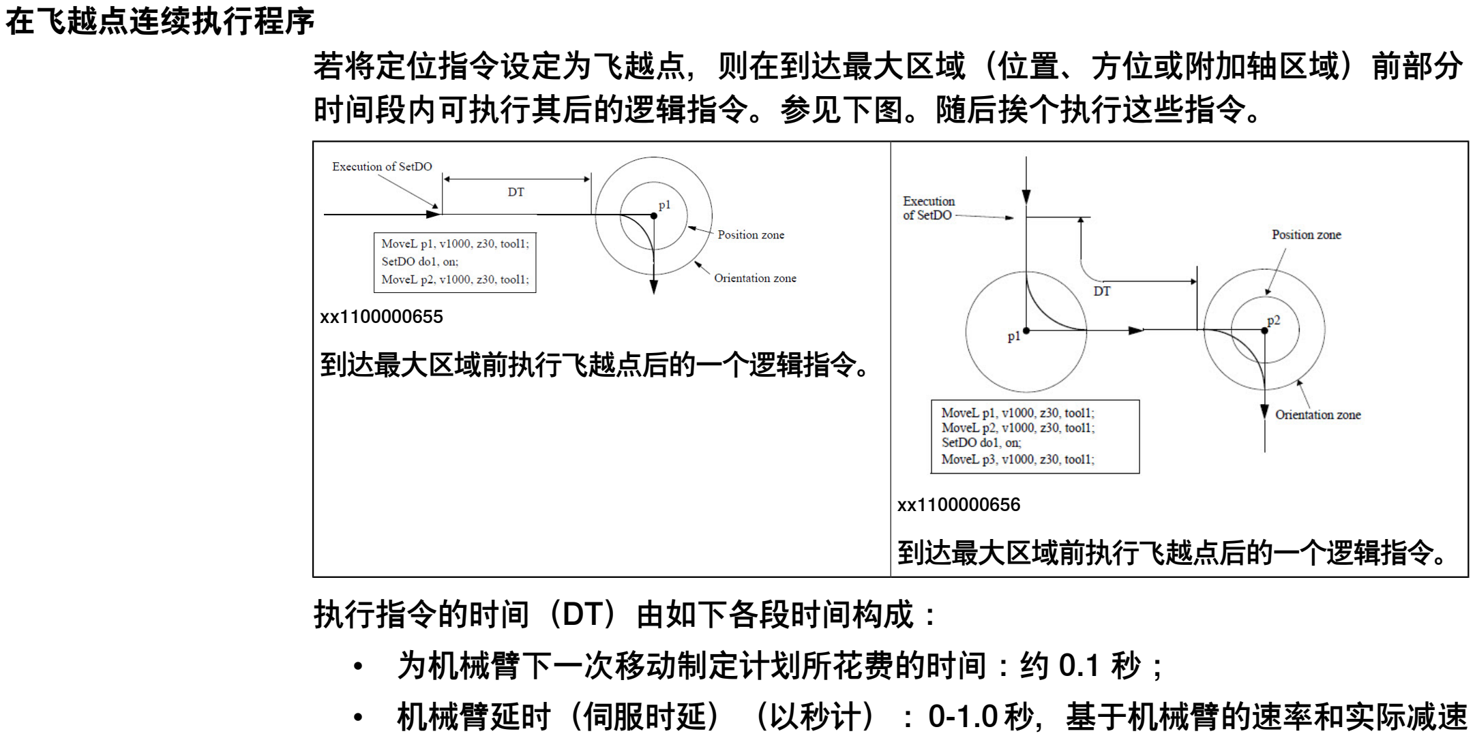
[picture p96: figure]
在飞越点连续执行程序 若将定位指令设定为飞越点，则在到达最大区域（位置、方位或附加轴区域）前部分 时间段内可执行其后的逻辑指令。参见下图。随后挨个执行这些指令。; xx1100000656 到达最大区域前执行飞越点后的一个逻辑指令。; xx1100000655 到达最大区域前执行飞越点后的一个逻辑指令。; 执行指令的时间（DT）由如下各段时间构成：; • 为机械臂下一次移动制定计划所花费的时间：约 0.1 秒；; • 机械臂延时（伺服时延）（以秒计）：0-1.0秒，基于机械臂的速率和实际减速

性能。

### 2 运动编程和I/O编程

2.3 与逻辑指令同步

同时执行程序
可以使用定位指令中的参数对并发\Conc程序执行并行编程。该参数用于在机械臂移

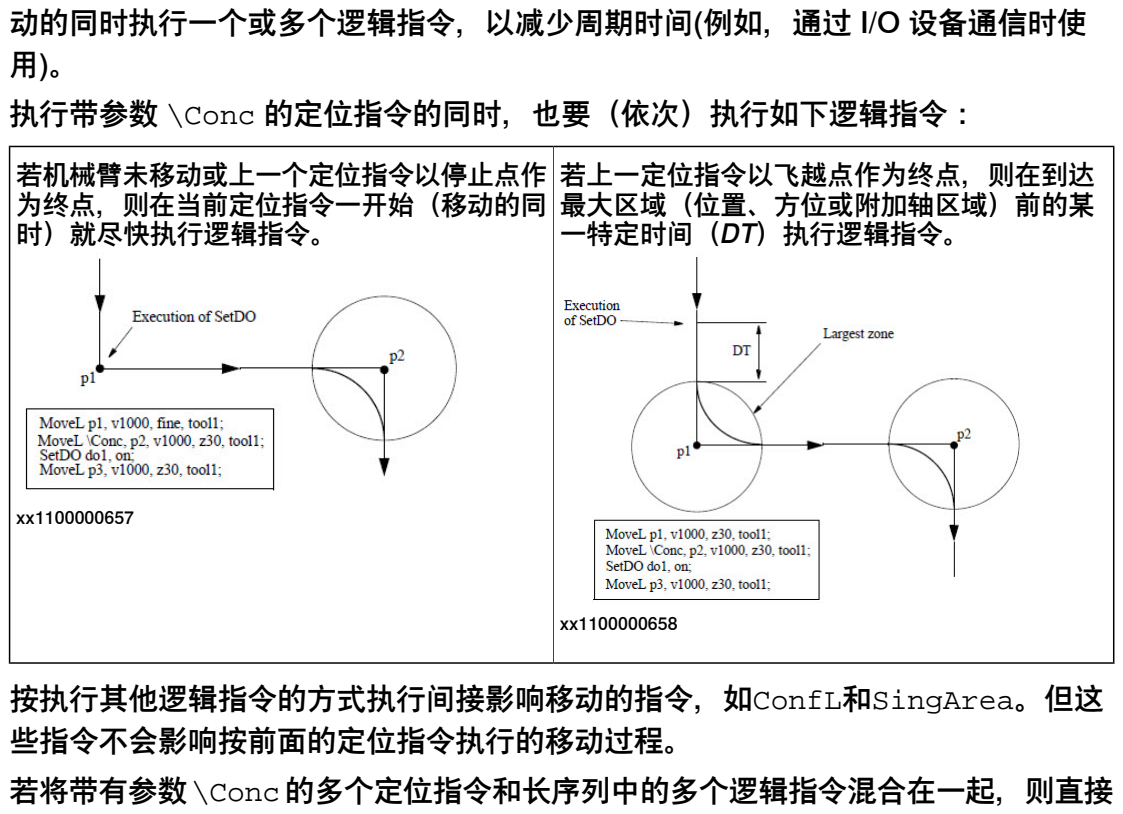
[picture p97: figure]
动的同时执行一个或多个逻辑指令，以减少周期时间(例如，通过 I/O 设备通信时使 用)。; 执行带参数 \Conc 的定位指令的同时，也要（依次）执行如下逻辑指令：; 若上一定位指令以飞越点作为终点，则在到达 最大区域（位置、方位或附加轴区域）前的某 一特定时间（DT）执行逻辑指令。; 若机械臂未移动或上一个定位指令以停止点作 为终点，则在当前定位指令一开始（移动的同 时）就尽快执行逻辑指令。; 按执行其他逻辑指令的方式执行间接影响移动的指令，如ConfL和SingArea。但这 些指令不会影响按前面的定位指令执行的移动过程。; 若将带有参数\Conc的多个定位指令和长序列中的多个逻辑指令混合在一起，则直接

按照编程的顺序执行逻辑指令。与移动发生在同一时间，这意味着逻辑指令在路径上 执行的时间比它们被编程的时间要早。

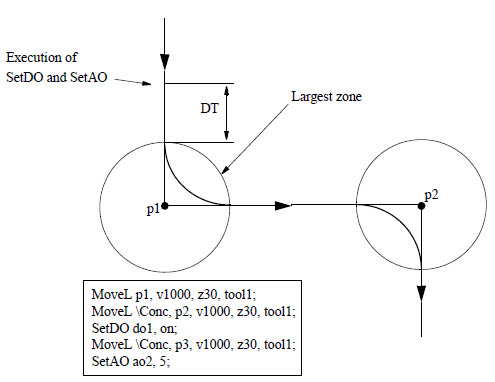
[picture p98: figure]

xx1100000659
在同时执行程序期间，为下述指令编程，以结束序列，并使定位指令和逻辑指令再次 同步：
- 不带参数\Conc的停止点定位指令；
- 带参数\Inpos的指令WaitTime或WaitUntil。

### 2 运动编程和I/O编程

2.3 与逻辑指令同步

路径同步
为使工艺设备（用于喷胶、涂漆和弧焊）与机械臂移动同步，生成了不同的路径同步 信号。
发生所谓的定位事件时，在机械臂通过路径上预定义位置时将生成触发信号脉冲信号。 若发生时间事件，则在机械臂在停止位置停止前的预定时间内将生成一个信号。而且 控制系统会处理摆动事件，在摆动动作的预定相位角处生成脉冲。 在机械臂通过预定位置前（提前时间）后（时延）可获得所有位置同步的信号。通过 设定位置确定位置，另外，可按设定位置前的路径距离调节该位置。 路径上一组数字信号输出的一般重复精确度为+/-2ms。 在Trigg指令中发生断电和重启时，在Trigg指令的其余移动路径上讲再次引发所有 触发事件。

相关信息

参见：

定位器指令 第53页的运动

区域半径的定义 技术参考手册 - RAPID指令、函数和数据类型

### 2 运动编程和I/O编程

2.3 与逻辑指令同步

### 2.4 机械臂配置

各类机械臂配置
通常采用不同组轴角度，通过不同方式可获得相同的机械臂工具位置和方位。我们称 其为不同的机械臂配置。
例如，如果一个位置大约位于工作单元的中间，当使用不同的轴 1 方向时，一些机械 臂可以从上方和下方到达该位置，如下图所示，其中向右的配置是通过向后旋转臂获 得的。轴 1 旋转 180 度。

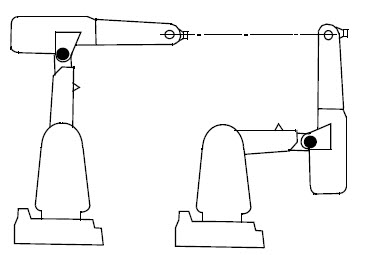
[picture p99: figure]

xx1100000660
一些机械臂也可以从上方和下方到达该位置，同时使用相同的轴 1 方向。这对于具有 扩展的轴 3 工作范围的机械臂类型是可能的。在下图中，两种不同的臂配置用于获得 相同的位置和方位。两种配置的轴 1 角度相同。右侧的配置是通过向前旋转下臂和向 后旋转上臂实现的。

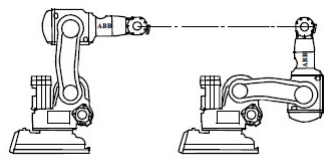
[picture p100: figure]

xx1100000661
另外，在将轴 5 和轴 6 转至预期位置和方位的同时，将机械臂上臂（轴 4）的前端颠 倒过来，也可获得右侧配置。

### 2 运动编程和I/O编程

2.4 机械臂配置

下图展示了到达相同位置和方位所用的两种不同腕配置。在上臂的前端指向上方的配 置（下图）中，轴 4、轴 5 和轴 6 旋转 180 度，就可获得上臂的前端指向下方的配置 （上图）。

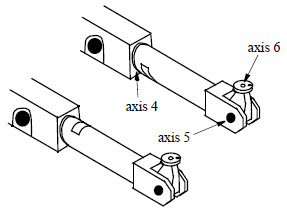
[picture p101: figure]

xx1100000662

确定机械臂配置

设定机械臂位置时，也可用confdata cf1, cf4, cf6, cfx明确机械臂配置。
确定机械臂配置的方式要视机械臂类型而定（有关详细说明，参见 技术参考手 册 - RAPID指令、函数和数据类型 - confdata）。但对于大多数机械臂而言，主要包 括为轴 1、轴 4 和轴 6 确定恰当的四等分旋转。例如，若轴 1 在 0 度到 90 度之间， 则 cf1=0，如下图所示。

xx1100000664
四等分旋转为负关节角

xx1100000663
四等分旋转为正关节角

配置控制与检测
要实现定义良好的机器人移动，通常要让机器人在程序执行时获取程序中指定的相同 配置。为此，应使用ConfL\On或ConfJ\On配置控制与检测。配置检测设计比较编程 位置的配置与机器人配置。
在直线运动期间，机械臂通常会移到最可能的配置。但如果用ConfL\On启用了配置 监控，则会提前验证，是否能实现设定配置。若不可能，则程序停止。在结束移动（在 区域内或尖端处）时，同样要验证机械臂是否已接近设定配置。若配置不同，则程序 停止。有关特定类机械的配置数据的具体说明，参见技术参考手册 - RAPID指令、函 数和数据类型中的数据类型confdata。
在机器人逐轴移动中，当使用了ConfJ\On时，机器人总是会按编程的配置移动。当 配置控制启用时，不会执行轴移动的监控。根据起点配置与结束点配置的不同，结果 可能会是一个长距离移动（尤其是腕节）。如果配置监控未生效，机器人会按相比起 点拥有最近关节值的配置移动到指定位置和朝向。
因配置错误停止执行设定位置，可能是如下某些原因造成的：
- 利用错误配置离线设定位置；
- 改变机械臂工具，导致机械臂采用了不同于设定配置的配置；

### 2 运动编程和I/O编程

2.4 机械臂配置

- 位置受活跃的坐标系操作（位移、用户、对象和基座）影响；
- 通过将机械臂位置设定在终点位置附近，并从FlexPendant示教器上读取配置， 获得终点位置处的正确配置。
若配置参数因活跃的坐标系操作而改变，则可禁用配置检查。

ConfJ的具体信息

带ConfJ\Off的MoveJ：
- 利用最接近轴起点位置的轴定位，移动机械臂至设定位置处。也就是说，没有 用指令中的confdata。也未实施配置监控。

带ConfJ\On的MoveJ：
- 通过定位轴，以使相关配置与confdata中的设定配置相同或相近，移动机械臂 至设定位置。
- 如果在执行程序位移或路径纠正，风险是编程配置与原始位置不同。结果，机 器人可能会执行腕节轴的大幅度移动以实现编程配置。

ConfL的具体信息

带ConfL\Off的MoveL：
- 利用最接近轴起点位置的轴定位，沿着直线移动机器人至设定位置处。也就是 说，没有用指令中的 confdata。也未实施配置监控。

带ConfL\On的MoveL：
- 首先用设定的confdata对终点位置进行计算（按节计），得出答案。然后对比 终点位置处配置轴的该值与起点位置的对应轴。
若相较于起点而言，新的配置数据可行（OK），则允许移动。而在其他情况 下，若出现出错信息，则机械臂将停在起点位置。有关可接受的各类机械臂的 配置错误，参见confdata，技术参考手册 - RAPID指令、函数和数据类型。
- 若开始移动前未报告错误，则在移动结束时系统会再次检查配置。若与设定配 置不同，则程序将停止。

相关信息

参见：

机械臂配置的定义 技术参考手册 - RAPID指令、函数和数据类型

启用/禁用配置监控 第53页的运动

### 2 运动编程和I/O编程

2.4 机械臂配置

### 2.5 机械臂运动模型

机械臂运动
根据机械臂机械结构的运动模型确定机械臂的位置和姿态。每次安装都必须要确定好 特定的机械单元模型。对于标准的ABB主机械臂和外部机械臂而言，会通过控制器提 前确定这些模型。

主机械臂
主机械臂运动模型会作机械臂工具相对于其基座的位置和姿态随机械臂关节角度变化 的模型。
在各类机械臂的配置文件中，会提前定好确定臂长、偏移量和接头方位角的运动参数。

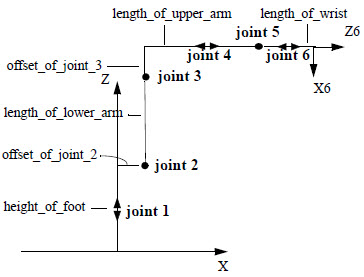
[picture p102: figure]

xx1100000666

### 2 运动编程和I/O编程

2.5 机械臂运动模型

校准无返回值程序可为确定主机械臂相对于全局坐标系基准坐标系提供支持。

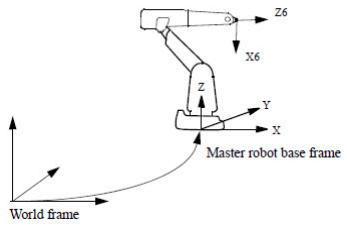
[picture p103: figure]

xx1100000667

外部机械臂
另外，与外部机械臂协调需要外部机械臂的运动模型。许多预定义级二维和三维机械 结构都可获得支持。
下图展示了一个使用预定义模型的 ORBIT 160B 轨道机械臂的运动学结构。

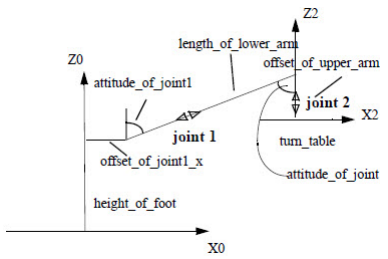
[picture p104: figure]

xx1100000668

### 2 运动编程和I/O编程

2.5 机械臂运动模型

通用运动

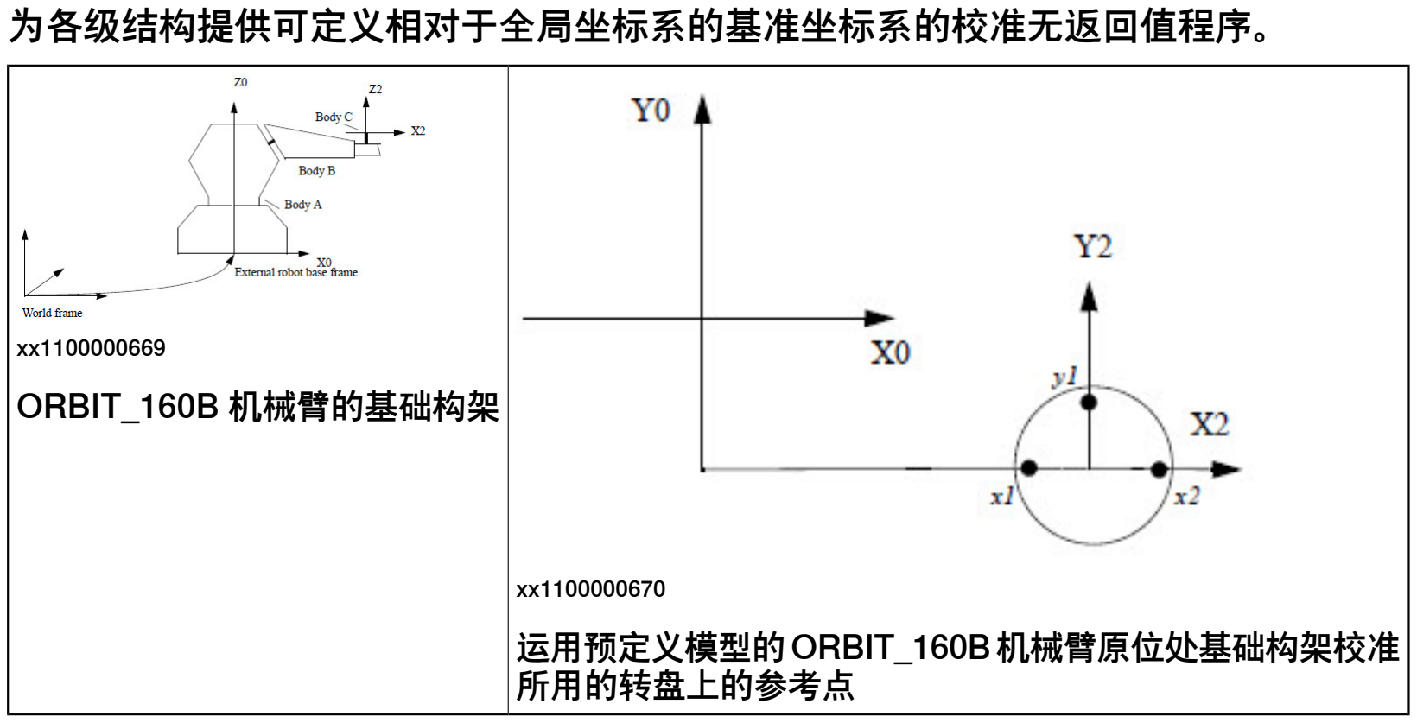
[picture p105: figure]
为各级结构提供可定义相对于全局坐标系的基准坐标系的校准无返回值程序。; xx1100000670 运用预定义模型的ORBIT_160B机械臂原位处基础构架校准 所用的转盘上的参考点; ORBIT_160B 机械臂的基础构架

可利用通用运动模型为预定义结构支持的机械结构建模。对于外部机械臂，也可如此。 根据John J. Craigh（Addison-Wesley 1986）发表的Introduction to Robotics, Mechanics & Control，建模是依据Denavit-Hartenberg法则。 下图展示了使用通用运动学模型的 ORBIT 160B 轨道机械臂的运动学结构。

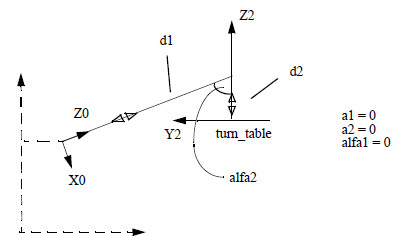
[picture p106: figure]

xx1100000671

### 2 运动编程和I/O编程

2.5 机械臂运动模型

相关信息

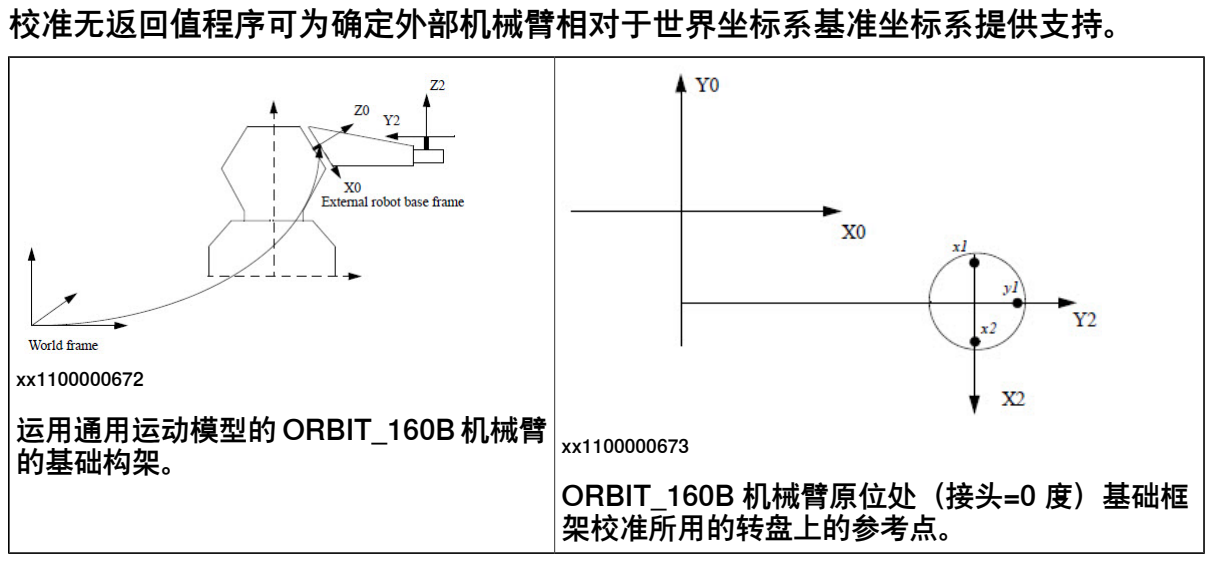
[picture p107: figure]
校准无返回值程序可为确定外部机械臂相对于世界坐标系基准坐标系提供支持。; ORBIT_160B 机械臂原位处（接头=0 度）基础框 架校准所用的转盘上的参考点。; 运用通用运动模型的 ORBIT_160B 机械臂 的基础构架。

参见：

外部机械臂通用运动的定义 技术参考手册 - 系统参数

### 2 运动编程和I/O编程

2.5 机械臂运动模型

### 2.6 运动监控/碰撞检测

简介
运动监控是对机械臂移动实施基于模型的高灵敏度监控所用的有返回值程序集合的名 称。运动监控包括碰撞检测、堵塞和不当负载定义功能。该功能也被称为碰撞检测（选 项Collision Detection）。
机械臂承载的负载数据不正确时，可能触发碰撞检测。所述数据包括工具负载数据、 有效负载数据和手臂负载数据。若工具数据或有效负载数据未知，则可用负载识别功 能加以确定。无法识别手臂负载数据。
触发碰撞检测时，机器人尽快停止。默认情况下，扭矩反转并施加制动闸，但也可以 配置不使用制动闸的停止。
如果至少有一根轴（包括附加轴）正在运动，那么运动监控会默认处于激活状态，其 它情况下则不会默认激活。如果所有轴直立不动，那么此功能会被停用。这是为了避 免因外部作用力而不必要地触发该功能。系统参数Collision detection at standstill 会 启用对任何碰撞的检测（甚至包括直立不动时），更多信息请参见 技术参考手册 - 系 统参数。

碰撞检测等级的调节
碰撞检测用的是可变的监控级。低速状况下比高速期间更为敏感。为此，在正常工作 状况下，不要求用户调节该功能。但可启用和禁用该功能，调节监控级。各个调节参 数都适用于缓慢行进和程序执行。有关不同调节参数的详细说明，参见技术参考手 册 - 系统参数。
有一种叫MotionSup的 RAPID 指令，可启用和禁用该功能，并修改监控级。这在外 部过程力在循环的某些部分作用于机械臂的应用中很有用。有关MotionSup指令的详 细说明，参见技术参考手册 - RAPID指令、函数和数据类型。 按占基本调节的百分比设置调节值，基本调节中，100%对应的是基本值。百分比增 大，系统灵敏度降低，百分比减小，系统灵敏度增大。关键是要注意，若通过系统参

### 2 运动编程和I/O编程

2.6 运动监控/碰撞检测

数和RAPID指令设置调节值，则两个值都要考虑到。如，若通过系统参数把调节值设 为150%，通过RAPID指令设为200%，则最终的调节级将为300%。

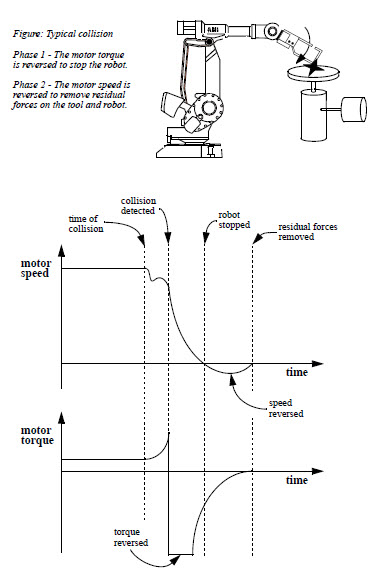
[picture p108: figure]

xx1100000674
有一个可通过修改总碰撞检测调节级得到的最高级。默认将其设为300%，而且也可通 过系统参数motion_sup_max_level对其实施变更。

变更运动监控
修改运动监督，请打开任务。
1 点击任务（Task）列表，选择一项任务。如果您有多个任务，那您需要为每个 任务设置理想值。

### 2 运动编程和I/O编程

2.6 运动监控/碰撞检测

2 点击关闭/开启（OFF/ON），以取消或启用路径监控。点击-/+，调整灵敏度。 灵敏度设置范围为0到300。除非您安装了选项Collision Detection，不然路径监 控就只会影响处于自动和手动全速模式的机械臂。
3 点击关闭/开启（OFF/ON），以取消或启用手动控制监控。点击-/+，调整灵敏 度。灵敏度设置范围为0到300。但该设置无效，除非是您安装了选项Collision Detection。
有关Collision Detection的详细信息，请参见应用手册 - 控制器软件IRC5。

数字输出
启用碰撞检测功能时，数字信号输出MotSupOn高，禁用时，则变低。注意，运动开 始时，该功能状态变化才起作用。因此若禁用碰撞检测，且机械臂正在移动中，则 MotSupOn高。若使机械臂停下，并禁用该功能，则MotSupOn仍不会降低。当机械臂

开始移动时，MotSupOn才变低。
碰撞检测触发时，数字信号输出MotSupTrigg变高，一直持续到从FlexPendant示教 器或通过数字信号输入AckErrDialog收到错误事件号。 有关数字信号输出的详情，参见 操作手册 - 带 FlexPendant 的 IRC5 和 技术参考手 册 - 系统参数。

限制
运动监控只适用于机械臂轴，不适合用于导轨、轨道站或任何其他外部机械臂。 在至少有一根轴通过独立关节模式运行的情况下禁用碰撞检测。即使这一根轴为作为 独立关节运行的附加轴，也一样。
通过软伺服模式使用机械臂时，碰撞检测可能触发。因此，在机械臂处于软伺服模式 时建议禁用碰撞检测。
若要用RAPID指令MotionSup禁用碰撞检测，则只有在机械臂开始移动时才能起作 用。因此，在机械臂开始移动前，程序起点处，数字信号输出MotSupOn可能会暂时 处于高水平。
碰撞后机械臂后退的距离与碰撞前的运动速度成正比。若反复发生多次低速碰撞，则 机械臂的后退距离可能达不到充分消除碰撞应力的程度。因此在监控未触发的情况下 不能手动控制机械臂。此时，要用手动控制菜单暂时禁用碰撞检测，并手动控制机械 臂远离障碍。
程序执行期间发生激烈碰撞，可能要过几秒，机械臂才会开始后退。 若机械臂安装在轨道上，则在轨道移动时应将碰撞检测设为关闭状态。若不能，则在 轨道移动时，即使没有碰撞，碰撞检测也可能触发。

相关信息

参见：

RAPID指令MotionSup 第53页的运动

调节用系统参数 | 技术参考手册 - 系统参数
运动监控I/O信号 | 技术参考手册 - 系统参数

直立不动时的碰撞检测 技术参考手册 - 系统参数

无制动闸独立碰撞停止 技术参考手册 - 系统参数

负载识别 | 操作手册 - 带 FlexPendant 的 IRC5

### 2 运动编程和I/O编程

2.6 运动监控/碰撞检测

### 2.7 奇异点

描述
利用无限量的机械臂配置可获得机械臂空间内的某些位置，以确定工具的位置和方位。 但在基于工具的位置和方位计算机械臂角度时，这些位置，也就是熟知的奇异点，却 成了一个问题。
一般说来，机械臂有两类奇异点；臂异奇点或腕异奇点。
臂奇异点就是腕中心（轴4、轴5和轴6的交点）正好直接位于轴1上方的所有配置。 腕奇异点是指轴 4 和轴 6 处于同一条线上，即，轴 5 角度为 0。

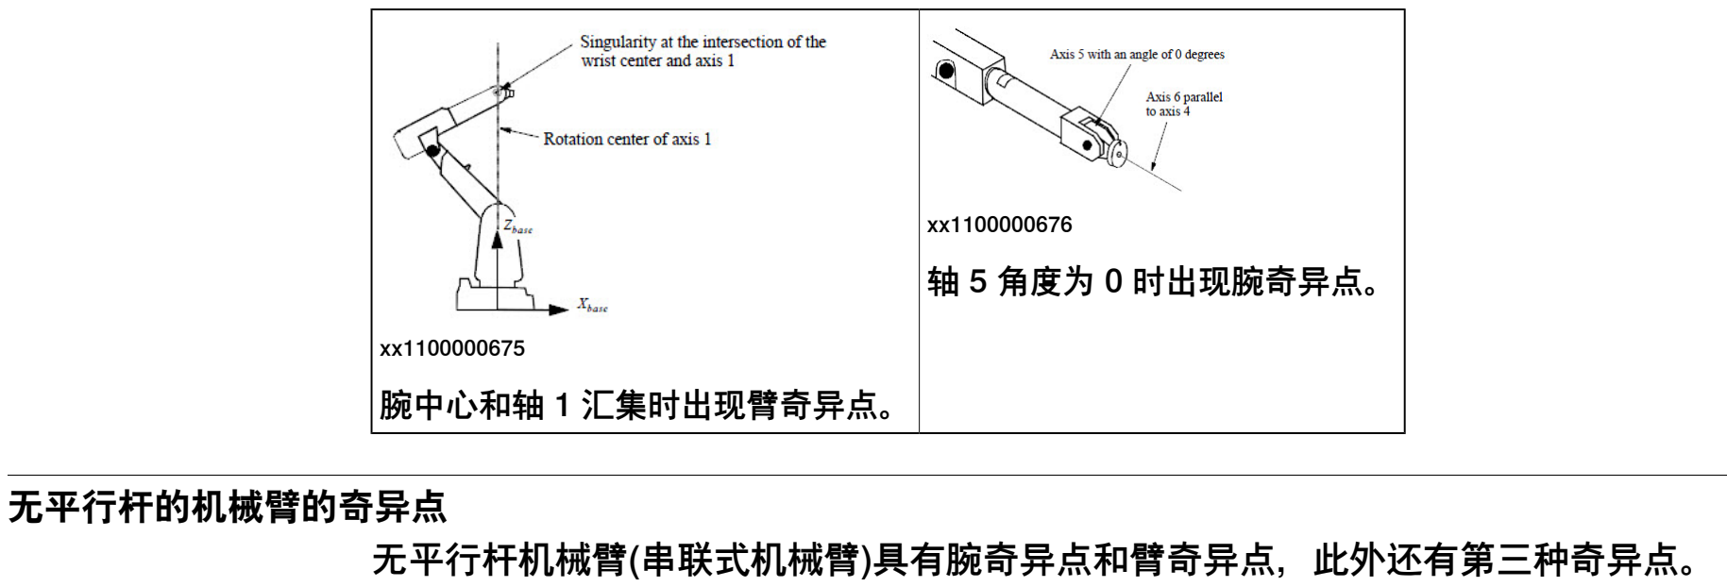
[picture p109: figure]
xx1100000676 轴 5 角度为 0 时出现腕奇异点。; xx1100000675 腕中心和轴 1 汇集时出现臂奇异点。; 无平行杆的机械臂的奇异点 无平行杆机械臂(串联式机械臂)具有腕奇异点和臂奇异点，此外还有第三种奇异点。

这个奇异点发生在机器人腕中心和坐标轴 2、3 的旋转中心都在一条直线上的位置， 见下图。

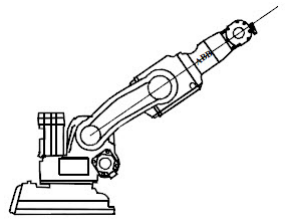
[picture p110: figure]

xx1100000677

带7根轴的串联机器人的奇异点
有7根轴的串联机器人，如IRB14000/14050，不仅具备6轴机器人所有的所有奇异点， 而且还多出两个奇异点。

### 2 运动编程和I/O编程

2.7 奇异点

第一个奇异点出现在轴2角度为零以便轴1和轴7处于同一条线上的状况下。这与腕关 节奇异点类似。
第二个奇异点出现在位于参照方向上时，因此，该奇异点与机械臂角度计算有关，具 体根据所配置的参照方向 WCP 而定。更多信息，参见 技术参考手册 - 系统参数 中的 Arm-Angle Reference Direction。

通过奇异点的程序执行
在关节插补期间，机械臂通过奇异点时，不会出现问题。
在接近奇异点处执行直线或圆弧路径时，某些接头（1与6或4与6）的速率可能极大。 为避免超过最大关节速率，可降低直线路径速率。
在接头交角处插补腕轴时，可用模式（SingArea\Wrist）使接头的高速率降低，同 时仍维持机械臂工具的直线路经。但，与完全直线插补相比，这种方式可能会导致方 位错误。
注意，当机械臂经过带直线或圆弧插补的某一奇异点附近时，机械臂配置会发生显著 变化。为避免重新配置，应利用导致必须重新配置的方位在奇异点另一侧设置第一个 位置。
同时，还应注意，只移动外部接头时，机械臂不得停留在其奇异点，不然会导致机械 臂接头发生不必要的移动。
对于有 7 根甚或更多轴的机械臂而言，机械臂可能能自动调整机械臂角度，以避免某 些奇异点。参见 操作手册 - 带 FlexPendant 的 IRC5。

通过奇异点手动控制
在关节插补期间，机械臂通过奇异点时，不会出现问题。
在线性插补期间，机器人无法通过奇异点。在奇异点附近移动可能会导致TCP速度降 低，而关节动作较大。

相关信息

参见：

控制机械人作用于奇异点附近操纵的方式 技术参考手册 - RAPID指令、函数和数据类型

### 2 运动编程和I/O编程

2.7 奇异点

### 2.8 优化加速度限制

描述
要持续控制机械臂的加速度和速度，以便不超过定义的限制。 通过用户程序定义限值（如设定速度或AccSet等）或通过系统本身定义限值（如齿轮 箱或电机的最大扭矩或机械臂结构中的最大扭矩和最大力等）。

负载数据
只要负载数据（质量、重力中心和惯量）在负载图所示限制范围内，且是正确输入工 具数据中的，那么不需要用户定义加速度限值，即可自动为机械臂的使用寿命提供保 障。
按ABB要求规定，若负载数据超出负载图的限制范围，则可能需要特殊限制，即，

AccSet或更低速度。

工具中心接触点加速度
路径设计者在完整的机械臂（包括用户定义负载）动力学模型的帮助下，控制工具中 心接触点加速度和速度。
工具中心接触点加速度和速度视任意时刻各轴的位置、速度和加速度而定，因而实际 加速度是不断变化的。通过此方式，获得最佳周期时间，即，任意时刻一个或多个限 值都为最大值。也就是说，在任何时刻，都能最大程度地发挥机械臂电机和结构的功 用。

### 2 运动编程和I/O编程

2.8 优化加速度限制

### 2.9 全局区域

全局区域的说明
使用全局区域（选项World Zones）时，机械臂会停下，或若是机械臂正处于特殊的 用户定义区域内，则会自动设置输出。有关此应用的示例，如下所示：
- 若两个机械臂的工作区域有部分重叠时。可通过监控这些信号，安全消除两个 机械臂相撞的可能性；

运用全局区域

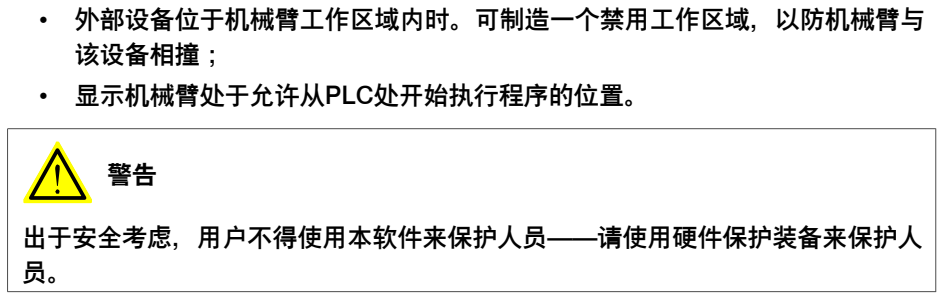
[picture p111: figure]
• 外部设备位于机械臂工作区域内时。可制造一个禁用工作区域，以防机械臂与 该设备相撞；; • 显示机械臂处于允许从PLC处开始执行程序的位置。; 出于安全考虑，用户不得使用本软件来保护人员——请使用硬件保护装备来保护人 员。

运用全局区域：
- 表明工具中心点是工作区域的特殊组成部分；
- 限制机械臂的工作区域，以免与工具相撞；
- 为两个机械臂制造一个公用工作区域，但一次只能供一个机械臂使用。

运用全局坐标系界定全局区域
通过全局坐标系界定全局区域。箱的各边与坐标轴平行，圆柱轴与全局坐标系的z轴平 行。

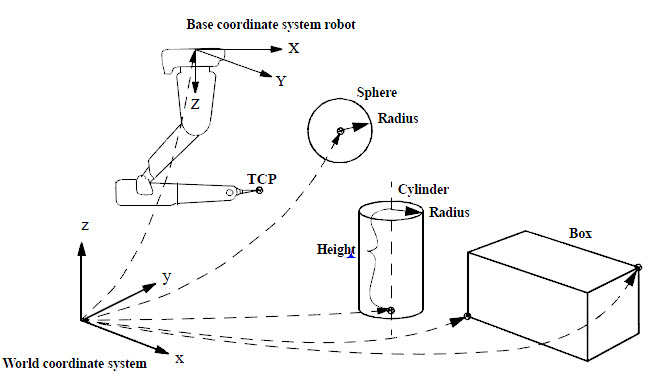
[picture p112: figure]

xx1100000678
可将全局区域设在箱体、球体或圆柱体的外侧或内侧。
也可通过接头界定全局区域。将该区域设在任一机械臂或附加轴的两个接头值范围内 （内侧）或范围外（外侧）。

### 2 运动编程和I/O编程

2.9 全局区域

机械臂工具中心接触点监控

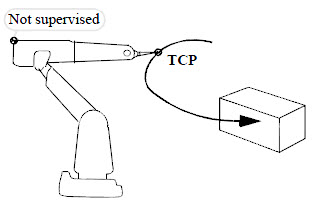
[picture p113: figure]

xx1100000679
监控工具中心点的移动，至于机械臂上其他点则不用管。
通常，不论是何种操作模式，如程序执行和手动控制，都要监控工具中心接触点。

固定工具中心接触点
当机械臂夹住一个对象并在某固定工具上工作时，用固定工具中心接触点。若该工具 已启用，则该工具不会移动；若固定工具中心接触点正位于全局区域内，则其通常在 内侧。

操作

工具中心接触点位于全局区域内时设置数字信号输出
若工具中心接触点位于全局区域内，则此行动设了数字信号输出，以表明机械臂已停 在某一特定区域内。

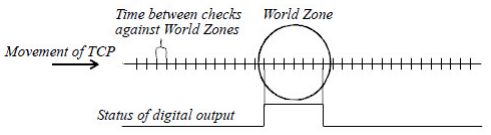
[picture p114: figure]

xx1100000680

在工具中心接触点到达全局区域前设置数字信号输出
此行动在工具中心接触点到达全局区域前就设了数字信号输出。这样可帮助让机械臂 正好停在全局区域内。

xx1100000681

### 2 运动编程和I/O编程

2.9 全局区域

在工具中心接触点到达全局区域前使机械臂停下
可将全局区域设在工作区域范围外。当工具中心接触点刚好接近全局区域外侧正准备 向内部移动时，机械臂将停下。

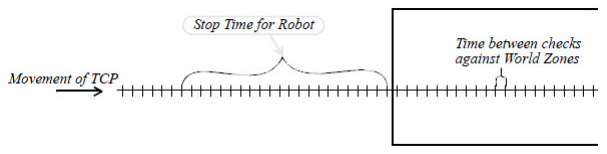
[picture p115: figure]

xx1100000682
若采用松闸和手推等方式将机械臂移到了设为外工作区域的全局区域内，则离开全局 区域的唯一方式就是在松闸的情况下手动控制或手推。

全局区域最小半径
在分散的各个点对工具中心店移动进行监控，但不是同时进行，而是各点之间要有一 定的时间间隔（具体视路径分辨率而定）。由用户负责将区域扩大，直至机械臂不能 在不被全局区域内察觉的情况下通过某一区域。
确保所有区域都比最小半径对应范围大一点儿。

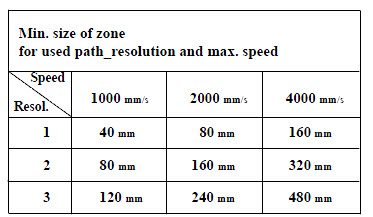
[picture p116: figure]

xx1100000683
若多个全局区域共用同一数字信号输出，则全局区域之间的距离必须大于最小半径， 如表所示，以免输出状态不对。

### 2 运动编程和I/O编程

2.9 全局区域

若机械臂在区域内停留时间较短，则机械臂可在不被注意到的情况下经过区域的一角。 因此区域的半径要设置得比危险区域的大。

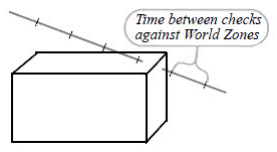
[picture p117: figure]

xx1100000684
若全局区域是与软伺服结合使用的，则区域半径必须要更大，以弥补软伺服引起的时 延。软伺服时延是插补时机械臂工具中心接触点与全局区域监控之间的距离。通过 SoftAct指令设定的软性度越高，则软伺服时延就越大。

最多全局区域数
一次性最多可界定20个全局区域。

断电、重启和运行
断电时，固定全局区域将被删除，通电时，必须利用与事件“通电（POWERON）”接 通的事件程序重新插入。
断电时临时全局区域不会消失，但在加载新程序或从主程序开始执行程序（PP至Main 或 PP 至 routine）时，该区域会被擦除。
在电机开启时，第一时间将更新全局区域的数字信号输出。也就是说在重启控制器时， 在启动期间全局区域状态将被设在外侧。重启后首次电机开启时，将正确更新全局区 域状态。
若电机关闭期间在移动机械臂，则全局区域状态只有等到下一个电机开启命令才会更 新。
在未更新全局区域信号的情况下，在停止移动时，机械臂可能移入或移出全局区域， 因此强制性紧急停止（不是SoftAS、SoftGS或SoftES）会引发不合理的全局区域状 态。在收到电机开启命令后，将对全局区域信号进行恰当更新。

相关信息

### 2 运动编程和I/O编程

2.9 全局区域

运动和I/O原理 | 坐标系
指令： | 技术参考手册 - RAPID指令、函数和数据类型
- WZBoxDef
- WZSphDef
- WZCylDef
- WZHomeJointDef
- WZLimJointDef
- WZLimSup
- WZDOSet
- WZDisable
- WZEnable
- WZFree

### 2 运动编程和I/O编程

2.9 全局区域

### 2.10 I/O原理

描述
机械臂通常拥有一个或多个I/O单板。每个单板有多个数字和/或模拟通道。这些通道只 有连接上逻辑信号后才能用。一般用系统参数完成连接，而在机械臂交付前常用标准 名称完成。在编程期间必须常用逻辑信号。
一条实体通道可连接至多个逻辑信号，但也可以不用逻辑连接，如下图所示。
为能使用 I/O 单板，必须为其通道提供逻辑信号。在下图中，实体输出 2 连接至两个不同的逻辑信号。而

另一方面，IN16 却没有逻辑信号，因此不能使用。

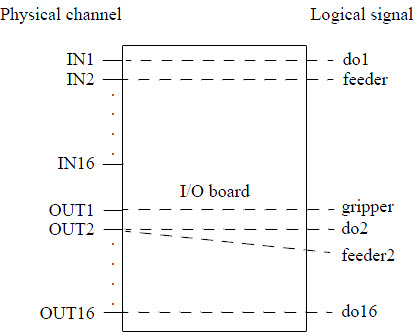
[picture p118: figure]

xx1100000685

信号特征
信号特征取决于所用的实体通道及利用系统参数界定通道的方式。实体通道决定着延 时和电压水平（请参阅机器人控制器的产品规格）。要用系统参数确定特征、滤波时 间和设定值及实际值之间的比例。
机械臂接通电源，同时把所有信号设为零。而且这些信号不受紧急停止或类似事件影 响。
可基于程序范围将输出设为一或零。另外，也可利用延迟或跳动形式完成。下令对输 出进行跳动或延迟变更时，仍将继续执行程序。随后在不影响其余部分程序执行的情 况下进行变更。而另一方面，若下令在给定时间结束前对同一输出重新进行变更，则 不执行首次变更。

### 2 运动编程和I/O编程

2.10 I/O原理

下图显示了一个示例，其中根本不执行指令 SetDO ，因为在时间延迟过去之前会给出一个新的命令。

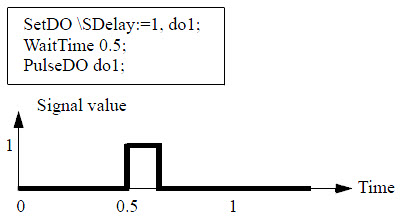
[picture p119: figure]

xx1100000686

与中断相连的信号
RAPID中断有返回值程序可与逻辑信号变更相连。在信号的上升沿或下降沿上，可调 用该有返回值程序。但如果数字信号变更很快，则可能错过此中断。 如，若有返回值程序与名为do1的信号相连且程序代码如下所示：

SetDO do1,1;

SetDO do1,0;
在几毫秒内，信号将首先上升（1），然后下降（0）。此时，可能失去中断。为确保 不会失去中断，必须要先确保在重设前已设置该输出。
例如，

SetDO do1,1;

WaitDO do1 ,1;

SetDO do1,0;
用此方法就不会失去中断。

系统信号
利用特殊的系统有返回值程序，可使逻辑信号互相连接到一起。如，若输入与系统有 返回值程序Start相连，则在启用该输入的同时快速自动生成程序起点。这些系统有 返回值程序通常都是以自动模式启用的。

交叉连接
通过此方式可使数字信号相互连接到一起，以便它们能自动影响彼此：
- 可将一个输出信号连接至一个或多个输入或输出信号；
- 可将一个输入信号连接至一个或多个输入或输出信号；
- 若多个交叉连接公用一个信号，则该信号的值与最近一次启用（变更）的值相 同；
- 交叉连接可互连，换句话说就是一个交叉连接可影响另一个。但它们不需要按 此方式连接，以形成一个“恶性循环”，如di2交叉连接至di1的同时，di1也交 叉连接至di2；
- 若输入信号上有一个交叉连接，则会自动禁用相应的实体连接。因此探测不到 任何实体通道变更情况；

### 2 运动编程和I/O编程

2.10 I/O原理

限制

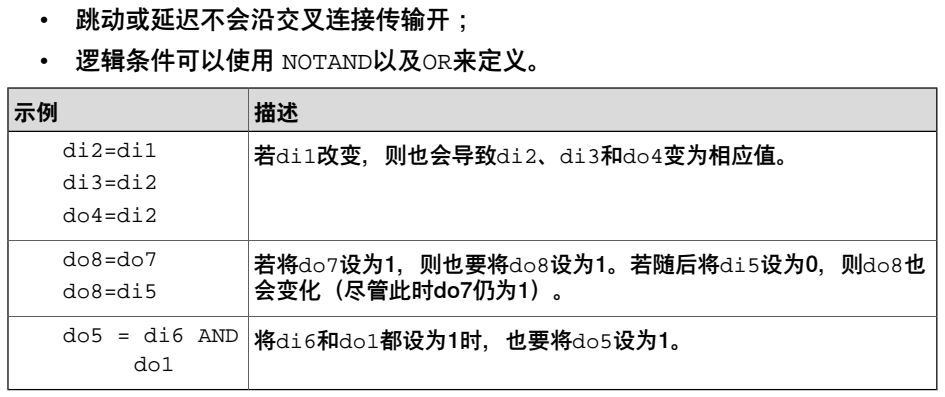
[picture p120: figure]
• 跳动或延迟不会沿交叉连接传输开；; • 逻辑条件可以使用 NOTAND以及OR来定义。; 若di1改变，则也会导致di2、di3和do4变为相应值。; 若将do7设为1，则也要将do8设为1。若随后将di5设为0，则do8也 会变化（尽管此时do7仍为1）。; do5 = di6 AND 将di6和do1都设为1时，也要将do5设为1。

一次最多可使10个信号跳动，一次最多可使20个信号延迟。

相关信息

参考

I/O单板与信号的定义 技术参考手册 - 系统参数

处理I/O的指令 | 第61页的输入输出信号
手动操纵I/O | 操作手册 - 带 FlexPendant 的 IRC5

### 2 运动编程和I/O编程

2.10 I/O原理

# 3 术语表

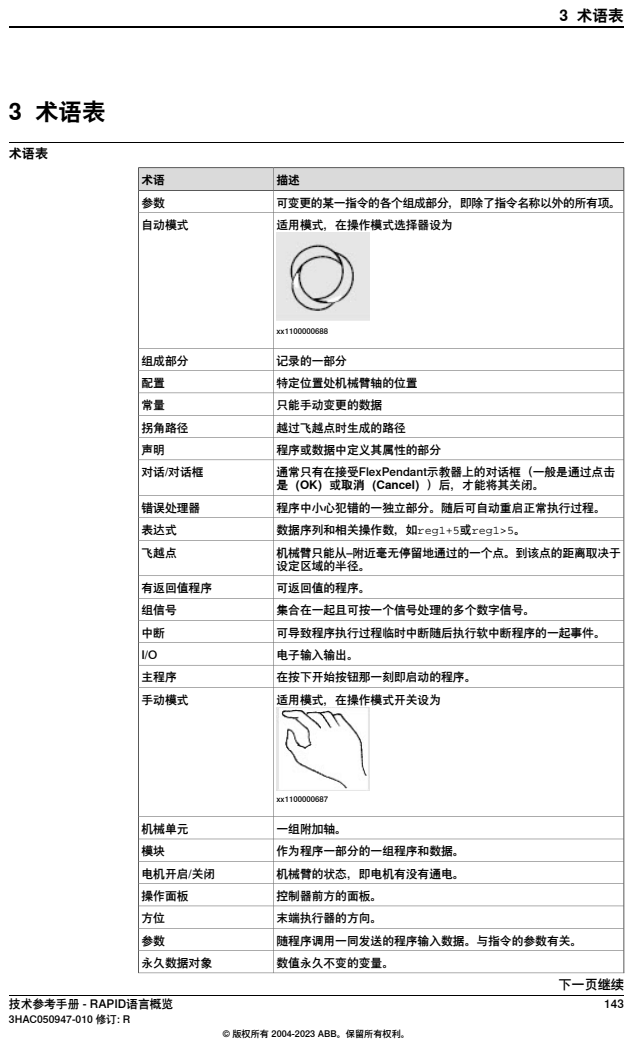
[picture p121: page 143]
术语表; 可变更的某一指令的各个组成部分，即除了指令名称以外的所有项。; 自动模式; 适用模式，在操作模式选择器设为; 组成部分; 记录的一部分; 特定位置处机械臂轴的位置; 只能手动变更的数据; 拐角路径; 越过飞越点时生成的路径; 程序或数据中定义其属性的部分; 对话/对话框; 错误处理器; 程序中小心犯错的一独立部分。随后可自动重启正常执行过程。; 表达式; 数据序列和相关操作数，如reg1+5或reg1>5。; 飞越点; 有返回值程序; 可返回值的程序。; 组信号; 集合在一起且可按一个信号处理的多个数字信号。; 可导致程序执行过程临时中断随后执行软中断程序的一起事件。; 电子输入输出。; 主程序; 在按下开始按钮那一刻即启动的程序。; 手动模式; 适用模式，在操作模式开关设为; 机械单元; 一组附加轴。; 作为程序一部分的一组程序和数据。; 电机开启/关闭; 机械臂的状态，即电机有没有通电。; 操作面板; 控制器前方的面板。; 末端执行器的方向。; 随程序调用一同发送的程序输入数据。与指令的参数有关。; 永久数据对象; 数值永久不变的变量。; 3 术语表

通常只有在接受FlexPendant示教器上的对话框（一般是通过点击
是（OK）或取消（Cancel））后，才能将其关闭。

机械臂只能从–附近毫无停留地通过的一个点。到该点的距离取决于
设定区域的半径。

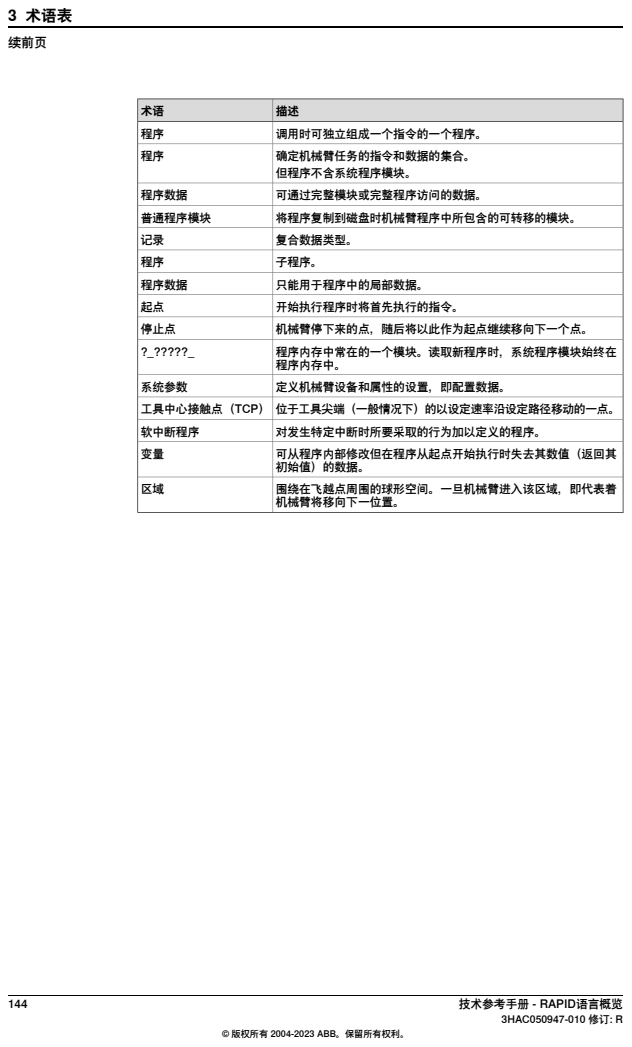
[picture p122: page 144]
调用时可独立组成一个指令的一个程序。; 确定机械臂任务的指令和数据的集合。; 但程序不含系统程序模块。; 程序数据; 可通过完整模块或完整程序访问的数据。; 普通程序模块; 将程序复制到磁盘时机械臂程序中所包含的可转移的模块。; 复合数据类型。; 子程序。; 只能用于程序中的局部数据。; 开始执行程序时将首先执行的指令。; 停止点; 机械臂停下来的点，随后将以此作为起点继续移向下一个点。; 系统参数; 定义机械臂设备和属性的设置，即配置数据。; 软中断程序; 对发生特定中断时所要采取的行为加以定义的程序。; 3 术语表

程序内存中常在的一个模块。读取新程序时，系统程序模块始终在
程序内存中。

工具中心接触点（TCP） 位于工具尖端（一般情况下）的以设定速率沿设定路径移动的一点。

可从程序内部修改但在程序从起点开始执行时失去其数值（返回其
初始值）的数据。
围绕在飞越点周围的球形空间。一旦机械臂进入该区域，即代表着
机械臂将移向下一位置。

索引7

7轴机器人, 132 A

alias数据类型, 27
AND

, 36

B
bool

, 48

C
confdata, 123
ConfJ

, 124
ConfL

, 124
CONST

, 32

D
DIV

, 35
dnum

, 48

E
ERRNO

, 73

I
I/O, 143
I/O 信号, 61
I/O原理, 140
I/O同步, 119
I/O 设备通信, 65
INOUT, 22 M

MOD

, 35
MultiMove, 55, 90 N

NOT

, 36
num

, 48

O
OR

, 36

P
PERS

, 31

R
RAPID语言消息队列, 67
robot configuration supervision, 123 S

string

, 48
supervision
robot configuration, 123
switch

, 22, 48

T
TCP, 97, 144 U

UNDO

, 75
User系统模块, 20 V

VAR

, 30

X
XOR

, 36

世
世界坐标系, 98 中

中断, 54, 68, 143
中断的路径, 59 串

串行连接机械臂, 132
串表达式, 36 主

主程序, 17, 143 事

事件日志, 74
事件类型, 85 二

二进制通信, 65 交

交叉连接, 141 任

任务, 84, 89
任务选择面板, 85 优

优先级
任务, 92
运算符, 41
传
传感器同步, 58
传送带跟踪, 57 伺

伺服跟踪, 57 位

位函数, 80
位移坐标系, 101
位置函数, 58 保

保留字, 13 信

信号, 61, 140 停

停止, 118
停止点, 144 全

全局
数据, 29
程序, 21
全局区域, 51, 135 关

关节插补, 108
关节运动, 53, 108

技术参考手册

- RAPID语言概览 | 145
3HAC050947-010 修订:
R

索引

内
内存, 83

函
函数调用, 39
加
加载模块, 47

区
区域, 111, 144
半
半值数据类型, 27
协
协调附加轴, 102

占
占位符, 14

原
原始数据字节通信, 66
参
参数, 21, 143
条件式, 39
说明, 11
反
反向处理器, 94
变
变更的直线插补, 110
变量, 29–30, 144
初始化值, 32
数组, 31

可
可选参数, 22

同
同时执行, 120
同步, 119
同等数据类型, 27
启
启动数据, 32

四
四等分旋转, 123

固
固定工具中心接触点, 106

圆
圆周运动, 53, 109
圆弧插补, 109
坐
坐标系, 97, 125
基
基座坐标系, 98, 103
基本数据类型, 27
声
声明, 143
变量, 30

常量, 32
模块, 18
永久数据对象, 31
程序, 23
多
多任务, 89
大
大小写灵敏性, 11
奇
奇异点, 110, 132
套
套接字通信, 66
字
字符串, 14
字符串函数, 87
定
定位I/O, 121
定位指令, 53
对
对话框, 143
对象坐标系, 100

局
局部
数据, 29
程序, 21

工
工具中心接触点, 97, 144
固定, 106
工具坐标系, 104
常
常量, 29, 32, 143
初始化值, 32
手
手动模式, 143
执
执行处理器, 85
执行等级, 85
拐
拐角路径, 111, 143
拾
拾取列表, 44
指
指令
拾取列表, 44
程序流程, 45
说明, 11
插
插补, 108, 111
搜
搜索指令, 54

索引

操
操作面板, 143 数

数值, 14
数学指令, 79
数据, 27
变量, 29
启动, 32
声明, 29
存储类, 33
数据, 29
永久, 29
用于表达式中, 37
程序, 29
范围, 29
说明, 11
赋值, 47
数据类型, 27
alias, 27
半值, 27
基本, 27
聚合, 27
记录, 27
非值, 27
数据类型的部分
部分, 27
数组
变量, 31
表达式, 37
文
文件指令, 65
文件操作函数, 82
文件标题, 15 方

方位, 143 无

无返回值程序, 21
无返回值程序声明, 23 时

时钟, 78
时间指令, 78 普

普通程序模块, 144 有

有返回值程序, 21, 143
有返回值程序声明, 23 服

服务, 86
服务信息, 85 术

术语表, 143 机

机械单元, 143
机械臂运动, 125
机械臂配置, 122 条

条件式参数, 39

标
标识符, 13 校

校准, 86 模

模块, 17, 143
说明, 17
模块声明, 18 步

步退执行, 94 永

永久, 29
永久数据对象, 31, 143
初始化值, 32
注
注释, 14, 47 状

状态函数, 59 独

独立轴, 56, 115 用

用户坐标系, 99, 102 电

电机开启/关闭, 143 直

直线插补, 108
直线移动, 53
直线运动, 108 碰

碰撞检测, 58, 129 移

移动指令, 53 程

程序, 21, 144
说明, 11
程序声明, 23
程序数据, 27, 29, 144
程序流程指令, 45 等

等待指令, 47 算

算术函数, 79
算术表达式, 35 系

系统信息, 83
系统参数, 144
系统数据, 83
系统模块, 17, 144 索

索引传送带, 57

技术参考手册

- RAPID语言概览 | 147
3HAC050947-010 修订:
R

索引

组
组信号, 143
终
终止程序, 22
终止程序执行过程, 45
给
给数据赋值, 47
编
编程, 17
编程模块, 17

聚
聚合, 27
聚合体
表达式, 38
腕
腕坐标系, 104
自
自动模式, 143
范
范围
数据, 29
程序, 21
表
表达式, 35, 143
串, 36
算术, 35
逻辑, 36
记
记录, 27, 144
表达式, 37
记录的组成部分, 143
语
语法规则, 9
负
负荷识别, 58
起
起点, 144
路
路径同步, 121
路径校正, 56
路径记录器, 57
转
转换, 48, 87

软
软中断声明, 23
软中断程序, 21, 68, 70, 144
软伺服, 117
软伺服器, 51
轴
轴配置, 122
输
输入信号, 61
输出信号, 61
过
过程调用, 23
运
运动, 53
运动指令, 53
运动数据, 59
运动模型, 125
运动监控, 129
运动设置
指令, 49
运算符优先级, 41
选
选项, 83
通
通信指令, 64

逻
逻辑值, 14
逻辑表达式, 36

配
配置, 143
机械臂, 122
配置数据, 84
重
重启控制器, 84
错
错误处理器, 73, 143
错误恢复, 72
错误编号, 72
附
附加轴, 56, 102
非
非值数据类型, 27

飞
飞越点, 111, 119, 143

索引

ABB AB
Robotics

& Discrete Automation
S-721 68 VÄSTERÅS, Sweden
Telephone +46 10-732 50 00

ABB AS
Robotics

& Discrete Automation
Nordlysvegen 7, N-4340 BRYNE, Norway Box 265, N-4349 BRYNE, Norway Telephone: +47 22 87 2000

ABB Engineering (Shanghai) Ltd. Robotics
& Discrete Automation
No. 4528 Kangxin Highway
PuDong New District
SHANGHAI 201319, China
Telephone: +86 21 6105 6666

ABB Inc.
Robotics

& Discrete Automation
1250 Brown Road
Auburn Hills, MI 48326
USA
Telephone: +1 248 391 9000

abb.com/robotics

3HAC050947-010, Rev R, zh-cn

规格如有更改，恕不另行通知。
