We-sson/HanGao/KUKA_Socket/资料/KST_UserTech_33_zh.pdf

## KUKA System Technology


# KUKA.UserTech 3.3

## KUKA 系统软件 8.2、8.3 和 8.4

KUKA Roboter GmbH

发布日期 : 06.03.2016

版本 : KST UserTech 3.3 V4

KUKA.UserTech

3.3

KUKA.UserTech 3.3

2 / 81 | 发布日期 : 06.03.2016 版本 : KST UserTech 3.3 V4

© 版权 2016

KUKA Roboter GmbH
Zugspitzstraße 140
D-86165 Augsburg
德国

此文献或节选只有在征得库卡机器人集团公司明确同意的情况下才允许复制或对第三方开放。

除了本文献中说明的功能外，控制系统还可能具有其他功能。 但是在新供货或进行维修时，无权要 求库卡公司提供这些功能。

我们已就印刷品的内容与描述的硬件和软件内容是否一致进行了校对。 但是不排除有不一致的情况， 我们对此不承担责任。 但是我们定期校对印刷品的内容，并在之后的版本中作必要的更改。

我们保留在不影响功能的情况下进行技术更改的权利。

本文件为原版文件的翻译。

KIM-PS5-DOC

出版物 : | Pub KST UserTech 3.3 (PDF) zh
书页构造 : | KST UserTech 3.3 V1.1
版本 : | KST UserTech 3.3 V4

发布日期 : 06.03.2016 版本 : KST UserTech 3.3 V4 | 3 / 81

目录

目录

目录

1 引言

1 | 引言
1.1 | 目标群

本文献针对具备下列知识的用户：

■ | 机器人控制器的高级系统知识
■ | 高级 KRL 编程知识
1.2 | 工业机器人文献

工业机器人文献由以下部分组成：

■ | 机器人机械装置文献
■ | 机器人控制系统文献
■ | 系统软件操作及编程指南
■ | 选项及附件指南
■ | 保存在数据载体上的部件目录

每份指南均独立成篇。

1.3 | 提示的图示
安全性 | 这些说明是安全提示，必须 遵守。

此提示提醒您注意用于预防或消除紧急情况或故障的操作步骤：

提示 | 这些提示可使工作便利或提供进一步信息的说明。

我们推荐客户在库卡学院进行培训，以便能以最佳方式使用我们的产 品。 有关培训项目信息请访问公司主页 www.kuka.com 或直接在公司 分支机构处获得。

该提示表示，如果不采取预防措施，则很可能将导致死亡或严 重的身体伤害。

该提示表示，如果不采取预防措施，则可能导致死亡或严重的 身体伤害。

该提示表示，如果不采取预防措施，则可能导致轻微的身体伤 害。

该提示表示，如果不采取预防措施，则可能导致财产损失。

该提示包含安全相关信息的说明或通用安全措施。
该提示不针对个别的危险或个别的预防措施。

必须严格遵守用此提示所标记的操作步骤。

用来使工作便利或提供进一步说明信息的提示。

1.4 | 所用概念
1.5 | 商标

Windows 是微软公司 （Microsoft Corporation）的商标。

概念 | 说明
KFD KFD 文件 | KUKA 表单说明 工艺中所描述的文件格式
KRL | 库卡机器人编程语言 （KUKA Robot Language）
KUKA smartHMI | KUKA 系统软件操作界面 （KUKA smart 人机对话接口）
KUKA smartPAD | 用于工业机器人的手持式编程器

2 产品说明

2 | 产品说明
2.1 | UserTech 概览
功能 | UserTech 是一个可后续载入的应用程序包，具有下列功能：
■ | 定义用户特定的联机表单
■ | 定义用户特定的信息
■ | 定义用户特定的工艺键和按键
■ | 定义用户特定的联机表单和工艺键脚本
■ | 定义用户特定的联机表单折叠夹 （Fold）
■ | 将用户特定的联机表单和工艺键集成到 KUKA smartHMI 操作界面中

3 安全

3 安全

该文件包括针对此处所述软件的安全提示。
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
