We-sson/HanGao/Halcon_SDK/Halcon样图测试/9点标定板样图/9点标定板.png

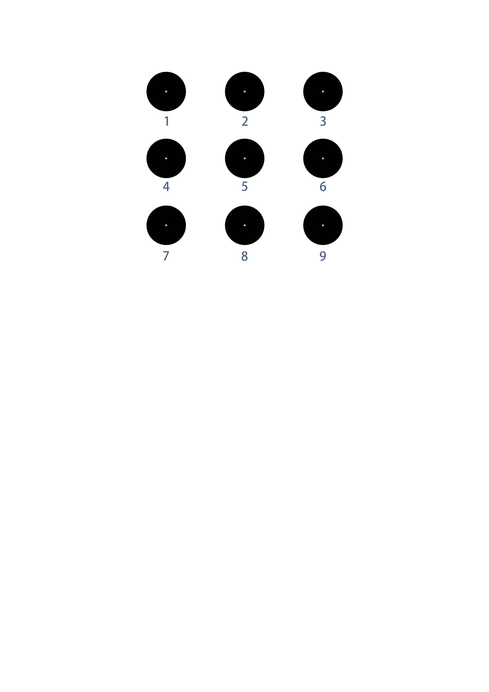
Halcon_SDK/Halcon样图测试/9点标定板样图/9点标定板.png
