We-sson/HanGao/Halcon_SDK/Halcon样图测试/单目标变图像/movingcam_calib3cm_06.png

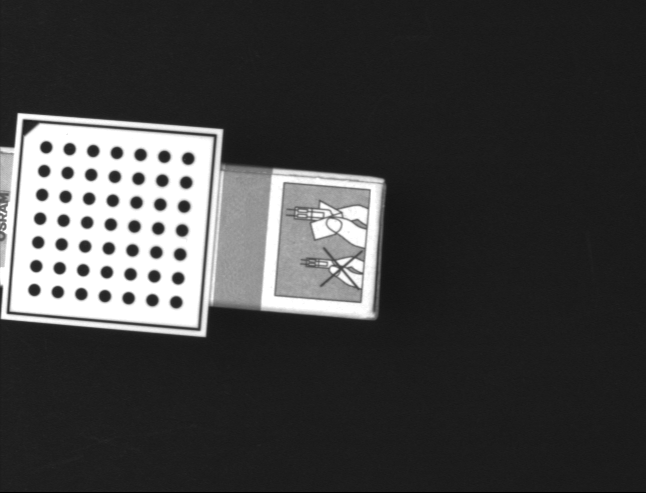
Halcon_SDK/Halcon样图测试/单目标变图像/movingcam_calib3cm_06.png
