We-sson/HanGao/Halcon_SDK/Halcon样图测试/立体视觉/图片/image_08.png

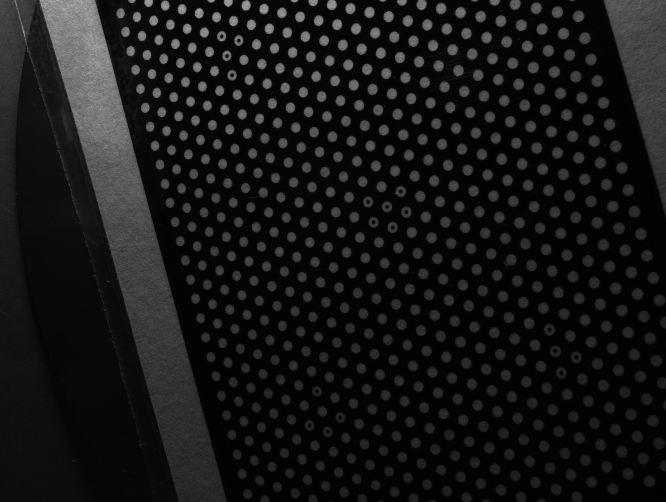
Halcon_SDK/Halcon样图测试/立体视觉/图片/image_08.png
