We-sson/HanGao/HanGao_Base/Resources/From_单窗口_Ioc.png

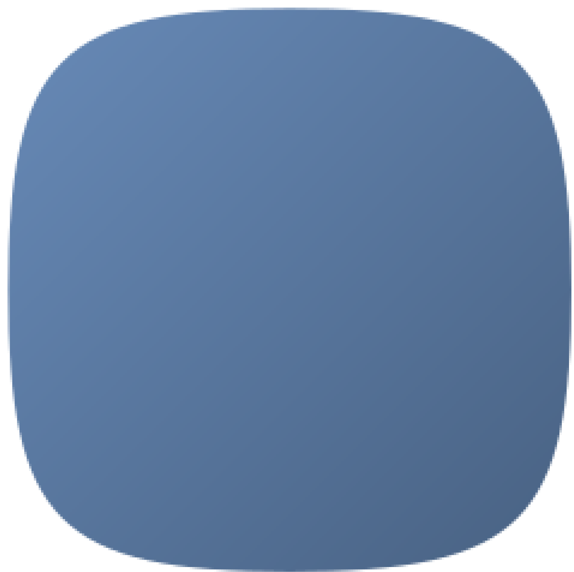
HanGao_Base/Resources/From_单窗口_Ioc.png
