We-sson/HanGao/HanGao_Base/Resources/From_双窗口_ioc.png

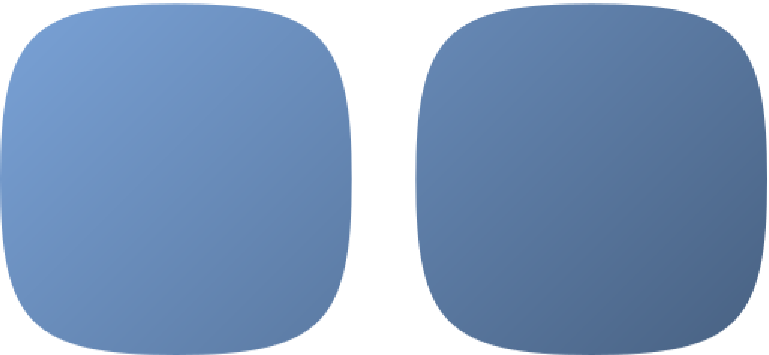
HanGao_Base/Resources/From_双窗口_ioc.png
