We-sson/HanGao/HanGao_Base/Resources/From_四窗口_ioc.png

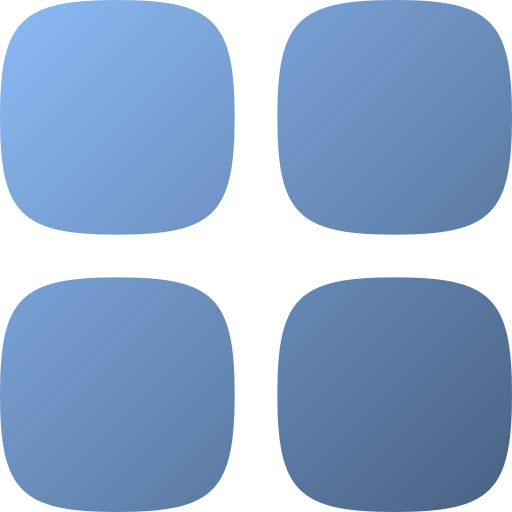
HanGao_Base/Resources/From_四窗口_ioc.png
