We-sson/HanGao/HanGao_Base/Resources/ListView_参数添加_ioc.png

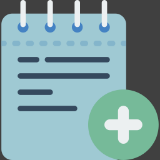
HanGao_Base/Resources/ListView_参数添加_ioc.png
