We-sson/HanGao/HanGao_Base/Resources/UC_开始页面状态_2.png

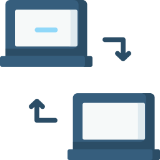
HanGao_Base/Resources/UC_开始页面状态_2.png
