We-sson/HanGao/HanGao_Base/Resources/UC_开始页面状态_3.png

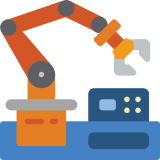
HanGao_Base/Resources/UC_开始页面状态_3.png
