We-sson/HanGao/HanGao_Base/Resources/UC_放大_1_ioc.png

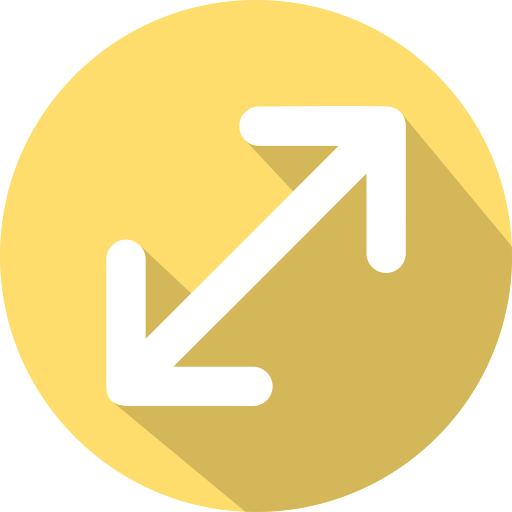
HanGao_Base/Resources/UC_放大_1_ioc.png
