We-sson/HanGao/HanGao_Base/Resources/UC_放大_ioc.png

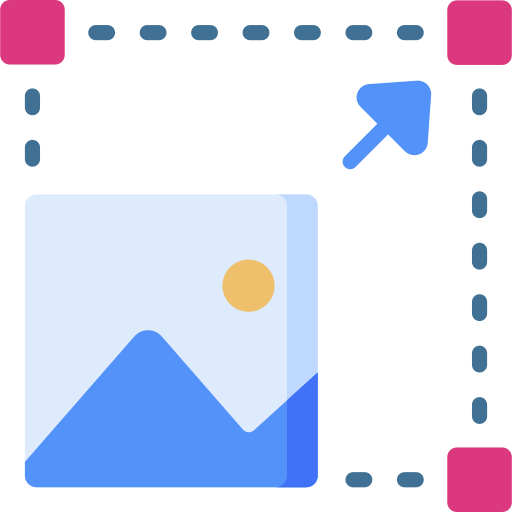
HanGao_Base/Resources/UC_放大_ioc.png
