We-sson/HanGao/HanGao_Base/Resources/Vision_handEye_1.png

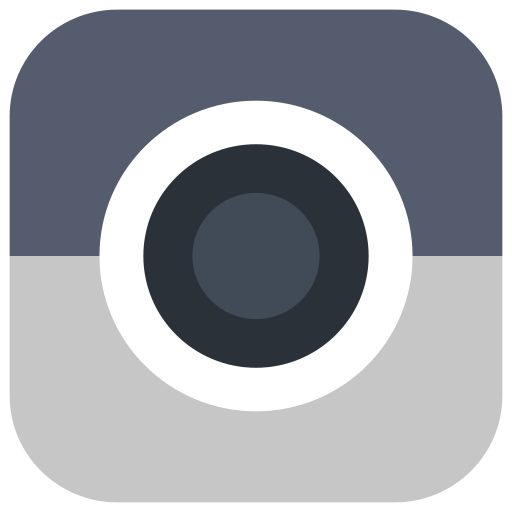
HanGao_Base/Resources/Vision_handEye_1.png
