We-sson/HanGao/HanGao_Base/Resources/Vision_handEye_3.png

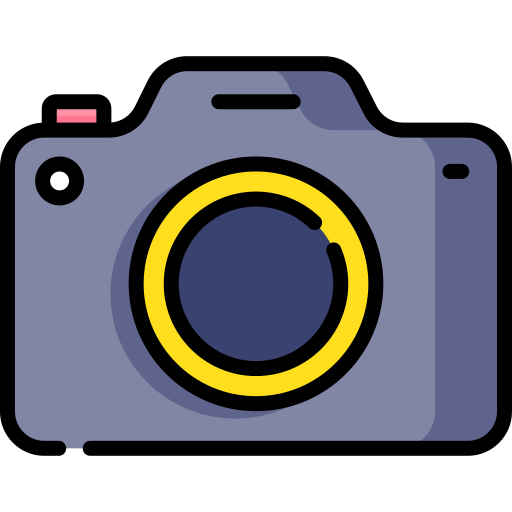
HanGao_Base/Resources/Vision_handEye_3.png
