We-sson/HanGao/HanGao_Base/Resources/Vision_handEye_4.png

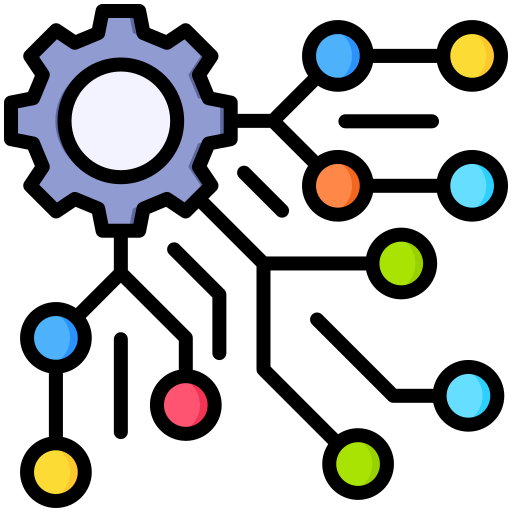
HanGao_Base/Resources/Vision_handEye_4.png
