We-sson/HanGao/HanGao_Base/Resources/Vision_handEye_5.png

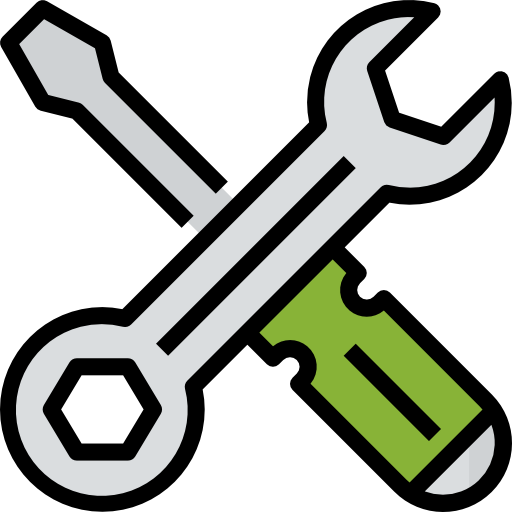
HanGao_Base/Resources/Vision_handEye_5.png
