We-sson/HanGao/HanGao_Base/Resources/Vision_handEye_7.png

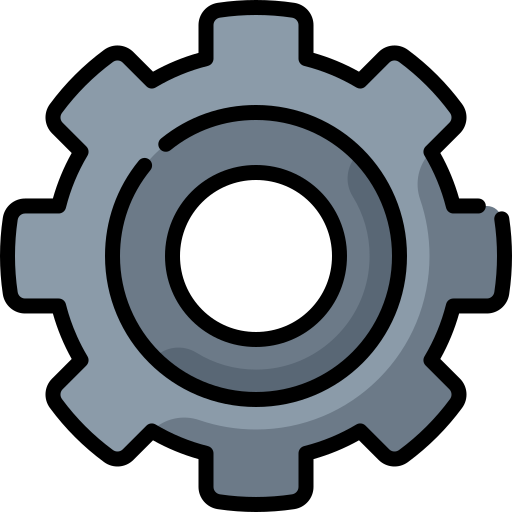
HanGao_Base/Resources/Vision_handEye_7.png
