We-sson/HanGao/HanGao_Base/Resources/Vision_handEye_8.png

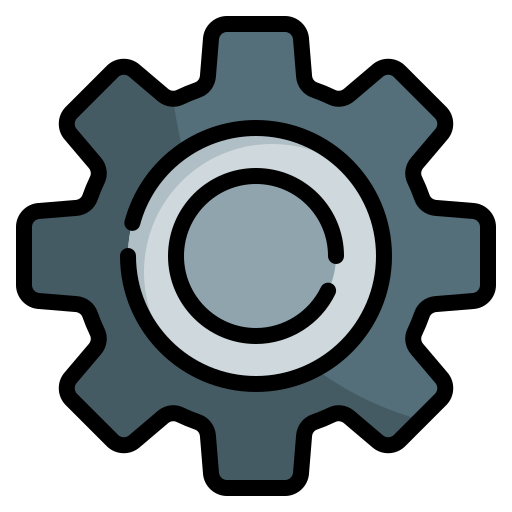
HanGao_Base/Resources/Vision_handEye_8.png
