We-sson/HanGao/HanGao_Base/Resources/Vision_handEye_10.png

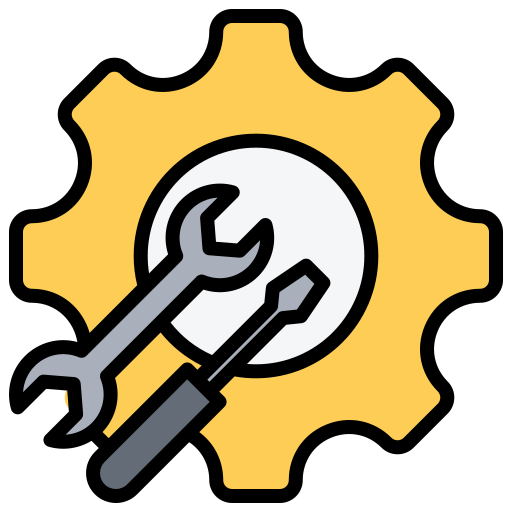
HanGao_Base/Resources/Vision_handEye_10.png
