We-sson/HanGao/HanGao_Base/Resources/Vision_保存图标_ioc.png

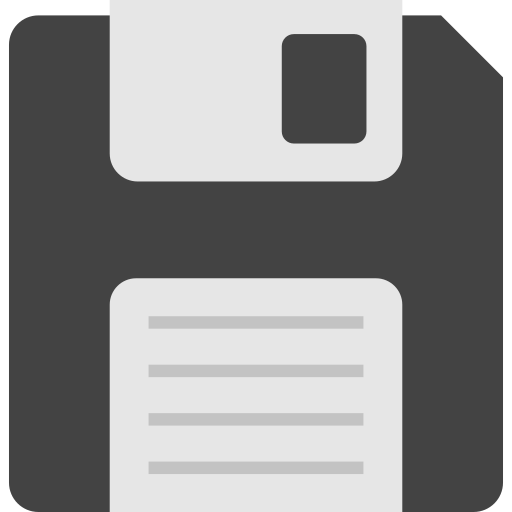
HanGao_Base/Resources/Vision_保存图标_ioc.png
