We-sson/HanGao/HanGao_Base/Resources/Vision_刷新_ioc.png

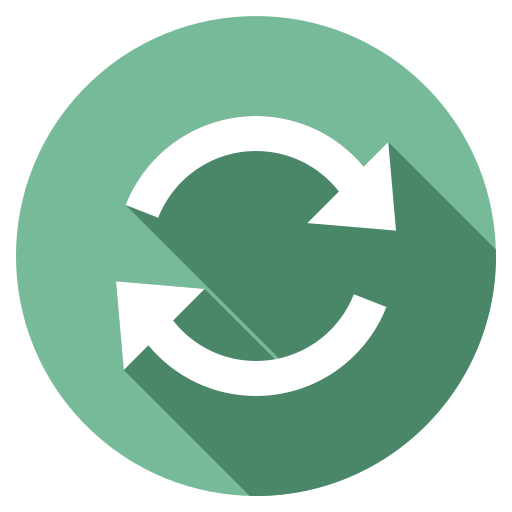
HanGao_Base/Resources/Vision_刷新_ioc.png
