We-sson/HanGao/HanGao_Base/Resources/Vision_标定板例图_ioc.png

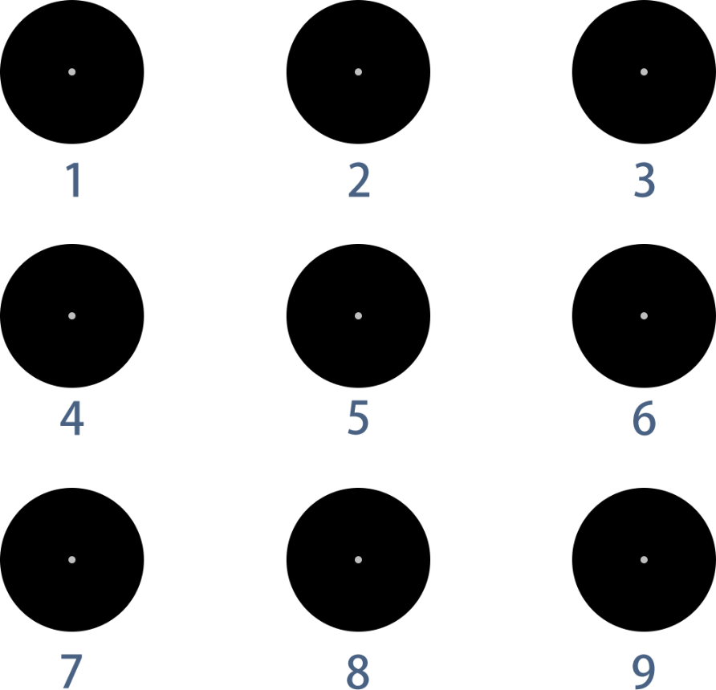
HanGao_Base/Resources/Vision_标定板例图_ioc.png
