We-sson/HanGao/HanGao_Base/Resources/Vision_清除数据_ioc.png

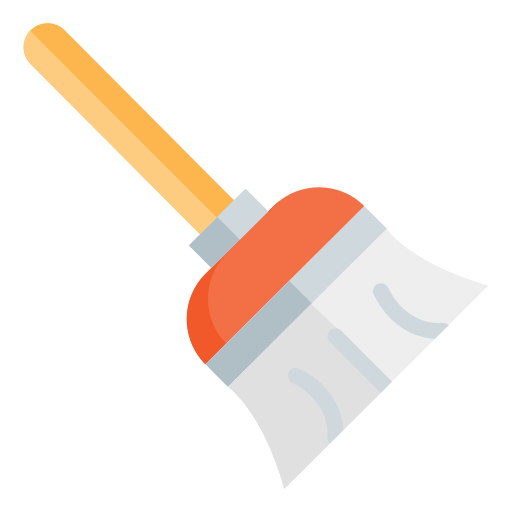
HanGao_Base/Resources/Vision_清除数据_ioc.png
