We-sson/HanGao/HanGao_Base/Resources/Vision_读取文件_ioc.png

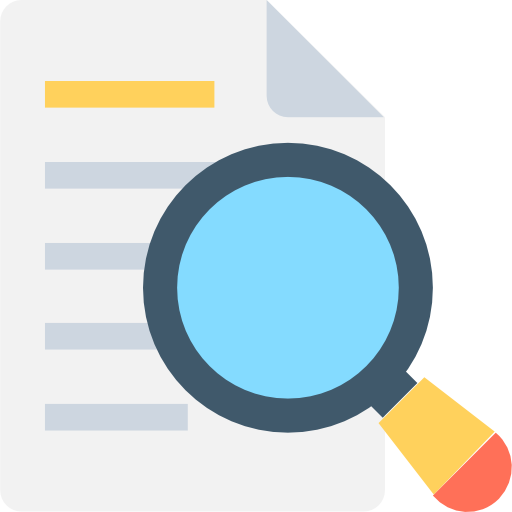
HanGao_Base/Resources/Vision_读取文件_ioc.png
