We-sson/HanGao/Ps_UI/electric-tower.png

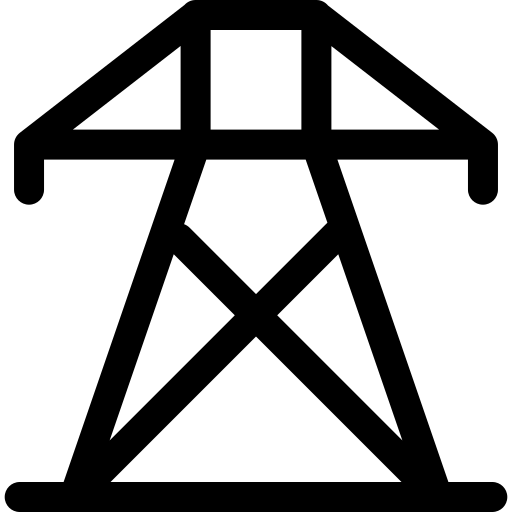
Ps_UI/electric-tower.png
