We-sson/HanGao/Ps_UI/graph.png

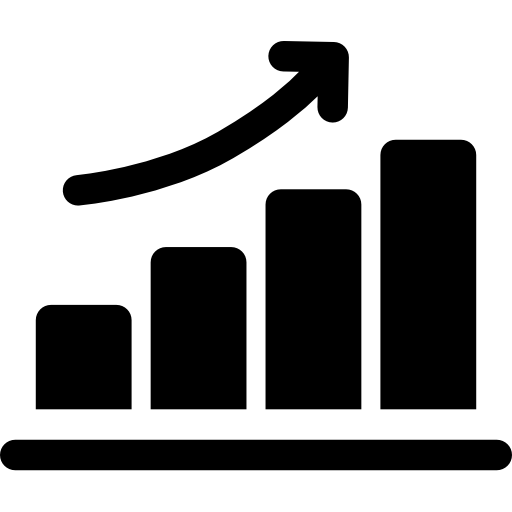
Ps_UI/graph.png
