We-sson/HanGao/Ps_UI/id (1).png

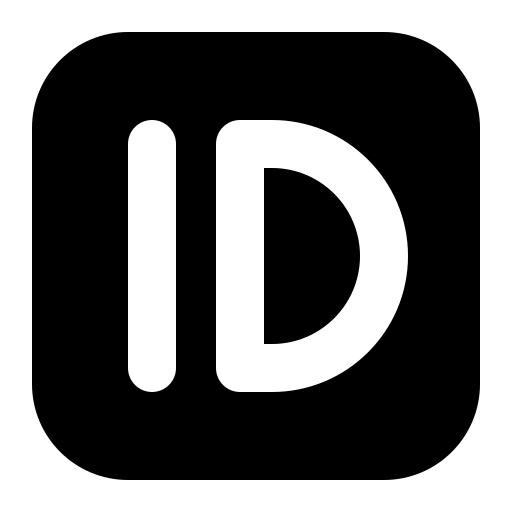
Ps_UI/id (1).png
