We-sson/HanGao/Ps_UI/id.png

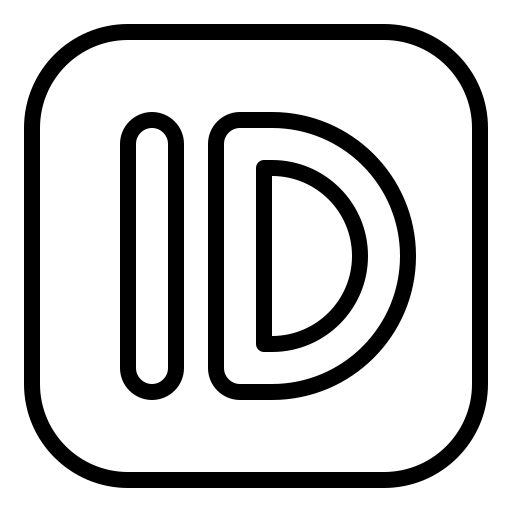
Ps_UI/id.png
