We-sson/HanGao/Ps_UI/layout (1).png

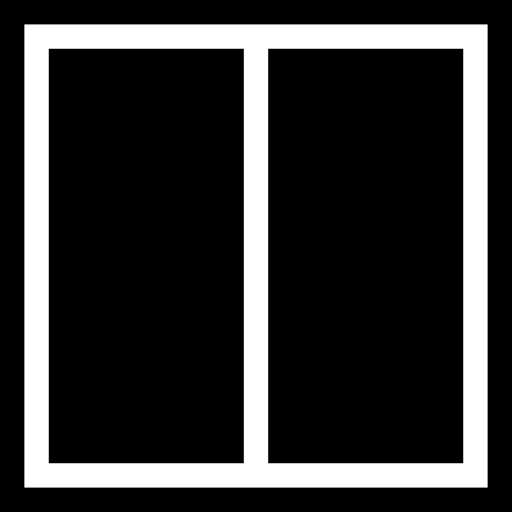
Ps_UI/layout (1).png
