We-sson/HanGao/Ps_UI/layout.png

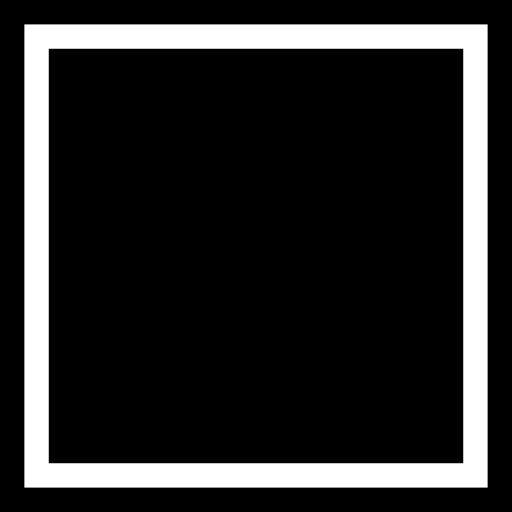
Ps_UI/layout.png
