We-sson/HanGao/Ps_UI/loss.png

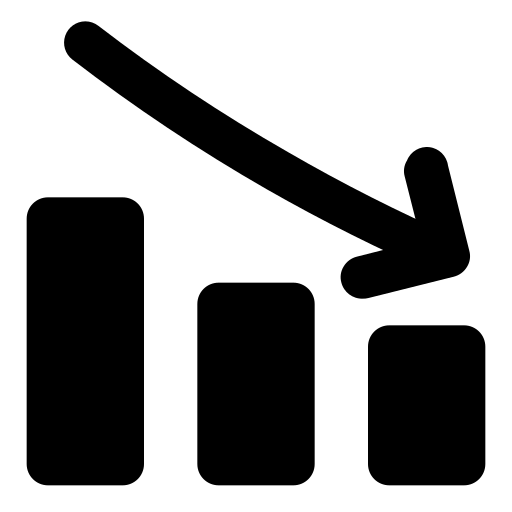
Ps_UI/loss.png
