We-sson/HanGao/Ps_UI/play.png

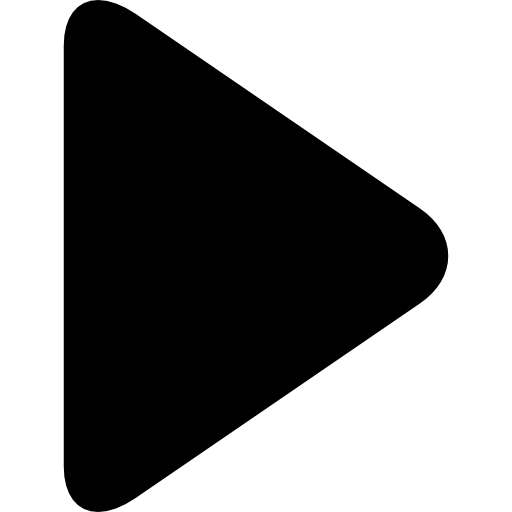
Ps_UI/play.png
