We-sson/HanGao/Ps_UI/renewable-energy.png

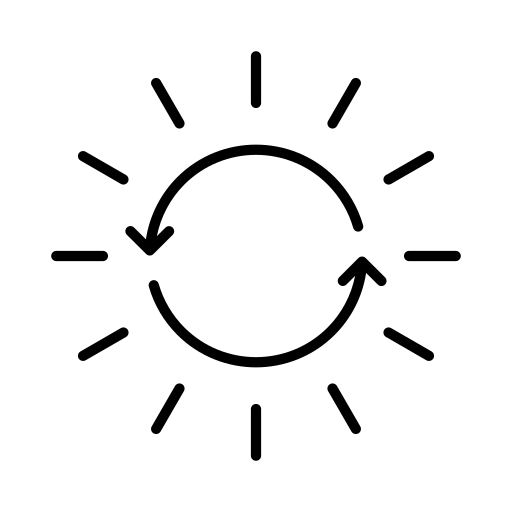
Ps_UI/renewable-energy.png
