We-sson/HanGao/Ps_UI/resize.png

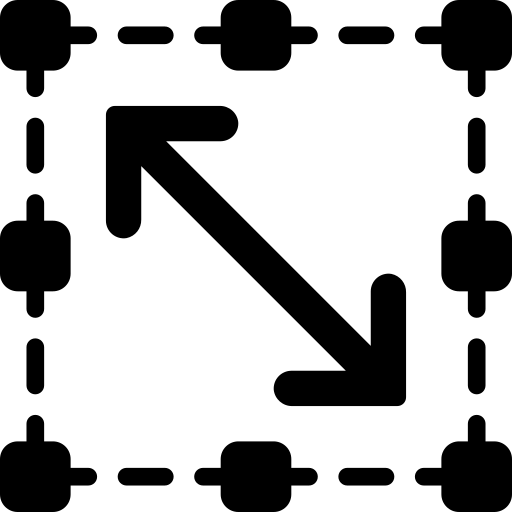
Ps_UI/resize.png
