We-sson/HanGao/Ps_UI/solar-energy.png

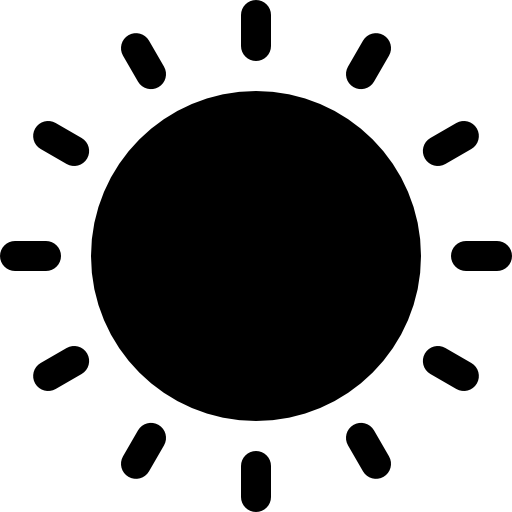
Ps_UI/solar-energy.png
