We-sson/HanGao/Ps_UI/system.png

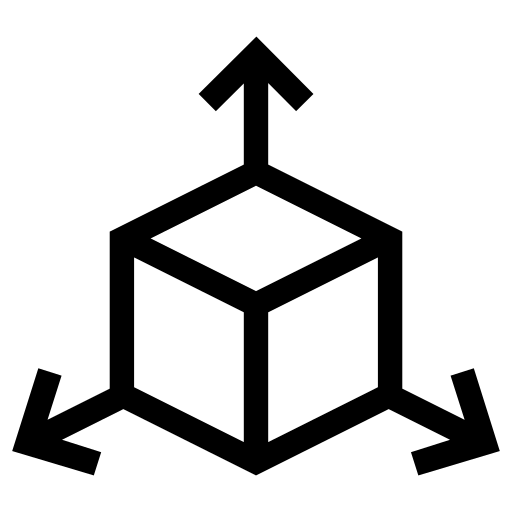
Ps_UI/system.png
