We-sson/HanGao/Ps_UI/target.png

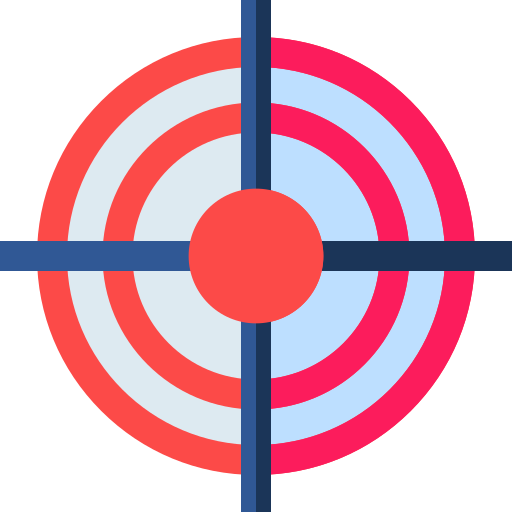
Ps_UI/target.png
