We-sson/HanGao/Robot_3D/Resources/Studio Soft Grey 12.jpg

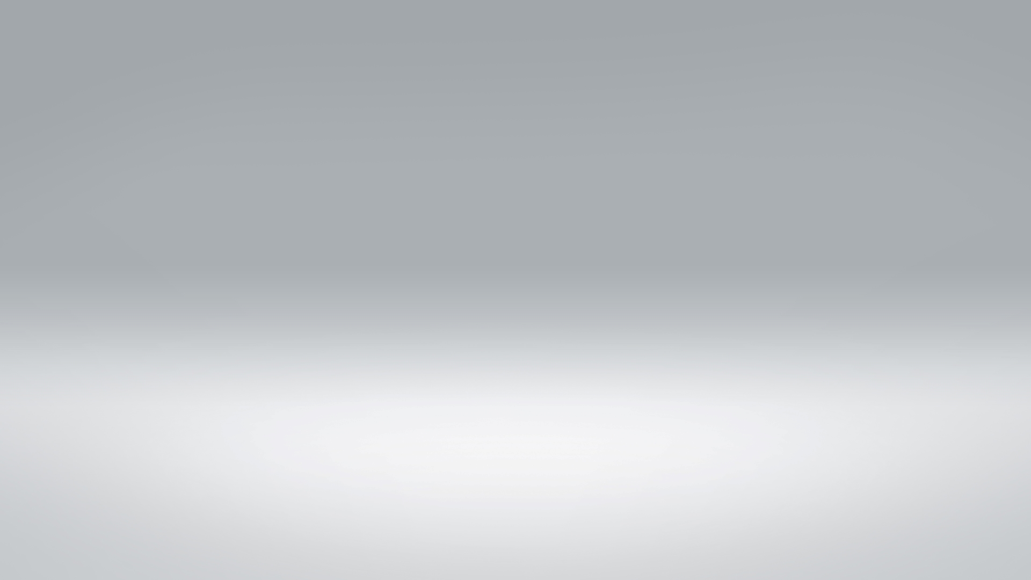
Robot_3D/Resources/Studio Soft Grey 12.jpg
