We-sson/HanGao/Robot_3D/tmp/pdfs/kuka-axis-065.png

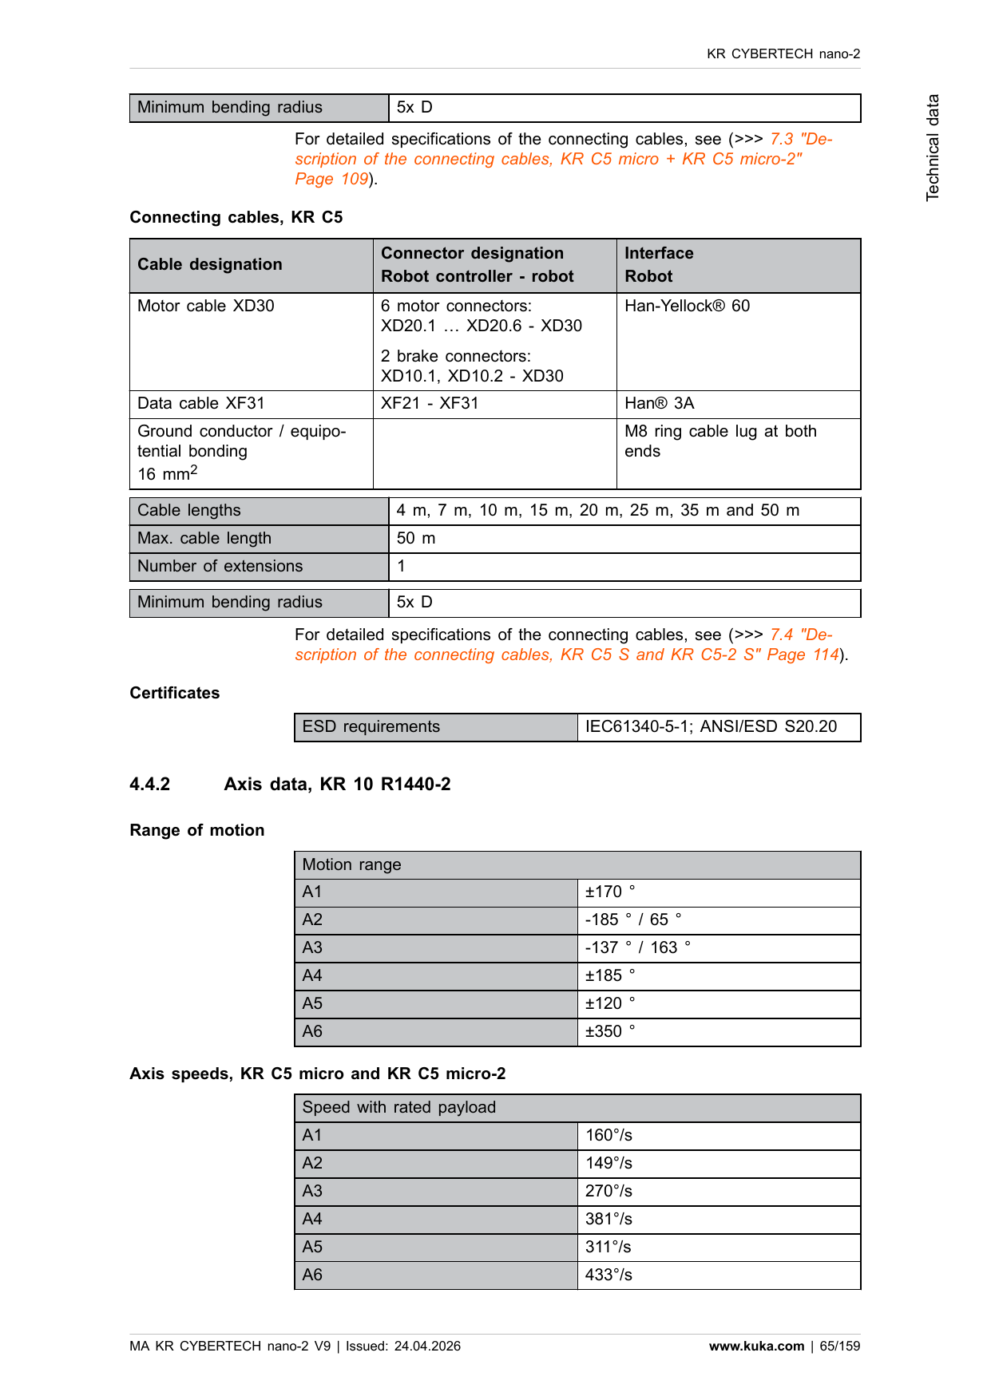
Robot_3D/tmp/pdfs/kuka-axis-065.png
