We-sson/HanGao/Robot_3D/tmp/pdfs/kuka-axis-066.png

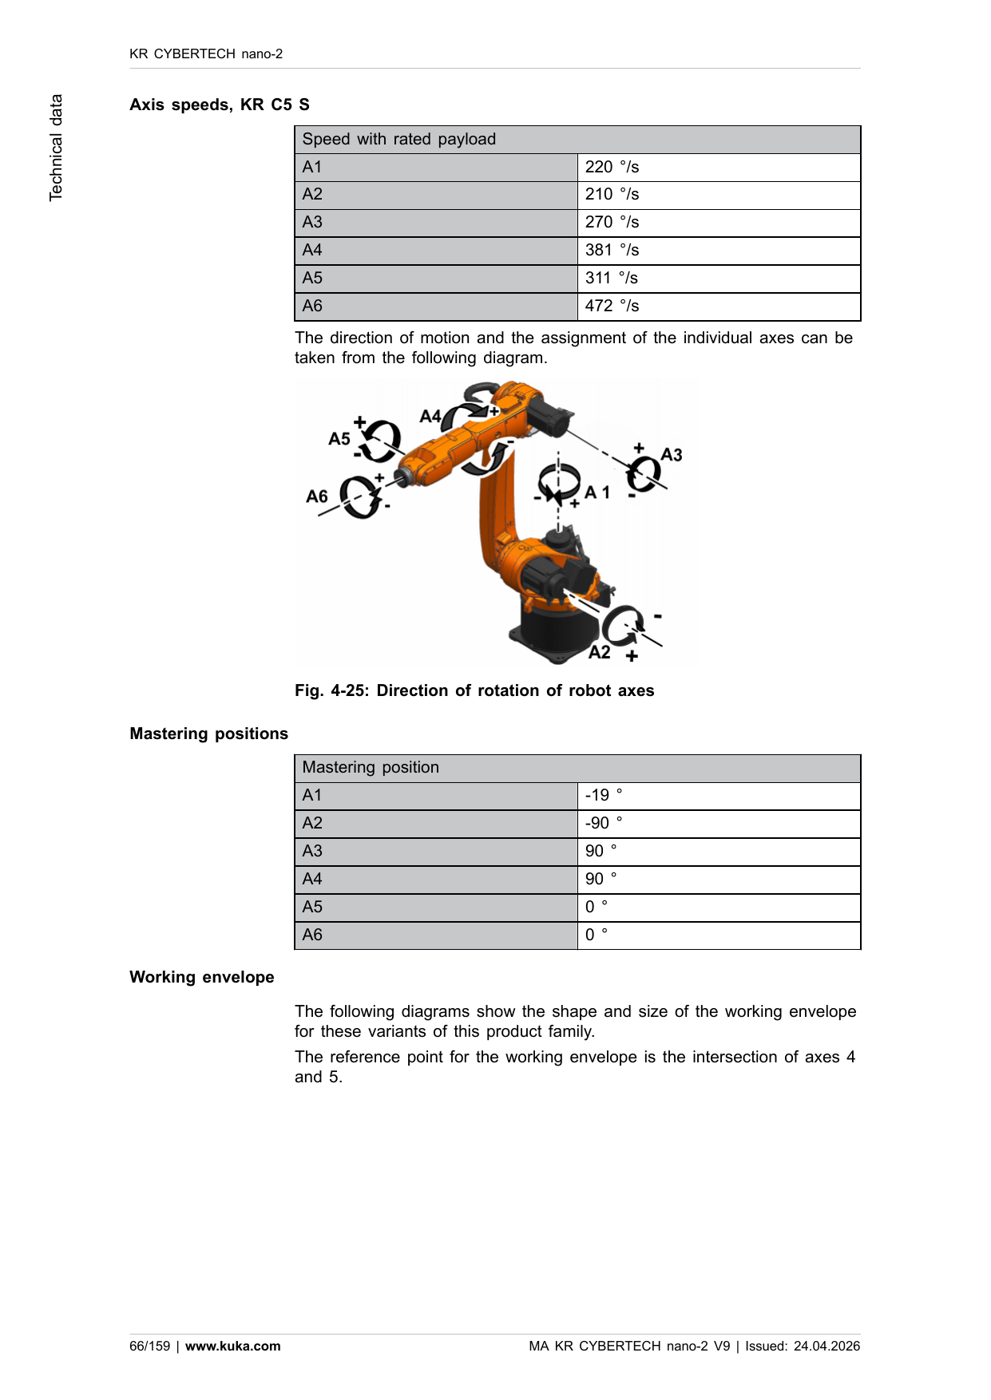
Robot_3D/tmp/pdfs/kuka-axis-066.png
