We-sson/HanGao/Robot_3D/tmp/pdfs/kuka-axis-067.png

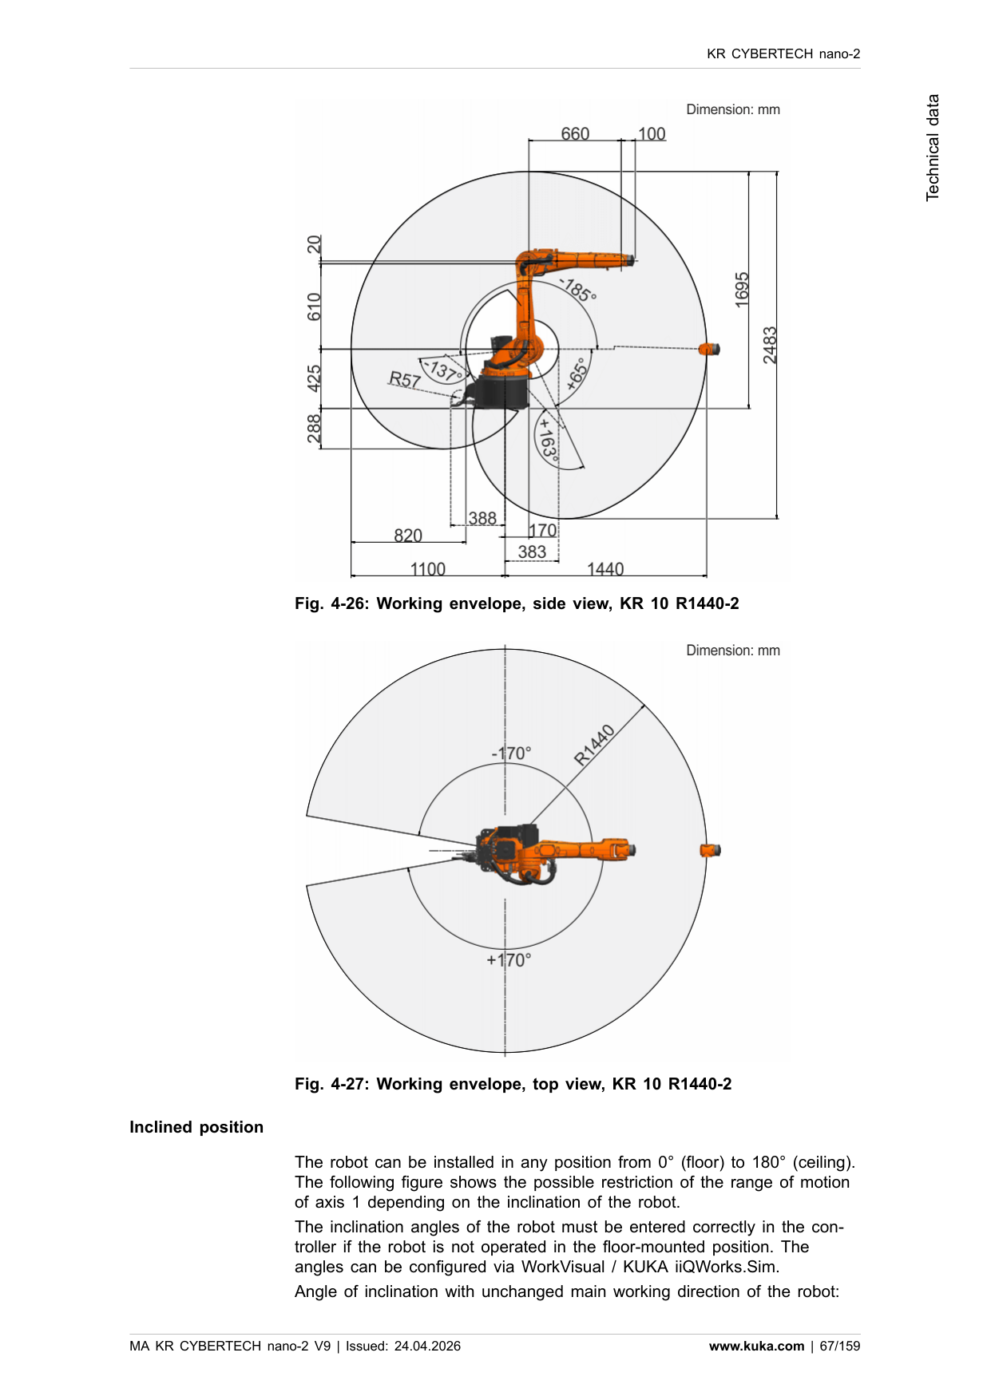
Robot_3D/tmp/pdfs/kuka-axis-067.png
