We-sson/HanGao/Robot_Info_Mes/Resources/1楼面板.png

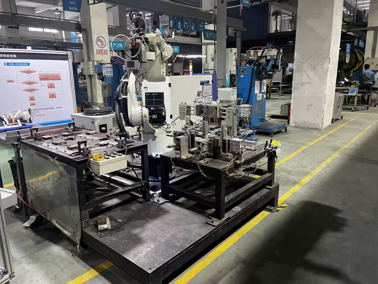
Robot_Info_Mes/Resources/1楼面板.png
