We-sson/HanGao/Robot_Info_Mes/Resources/2楼面板.jpg

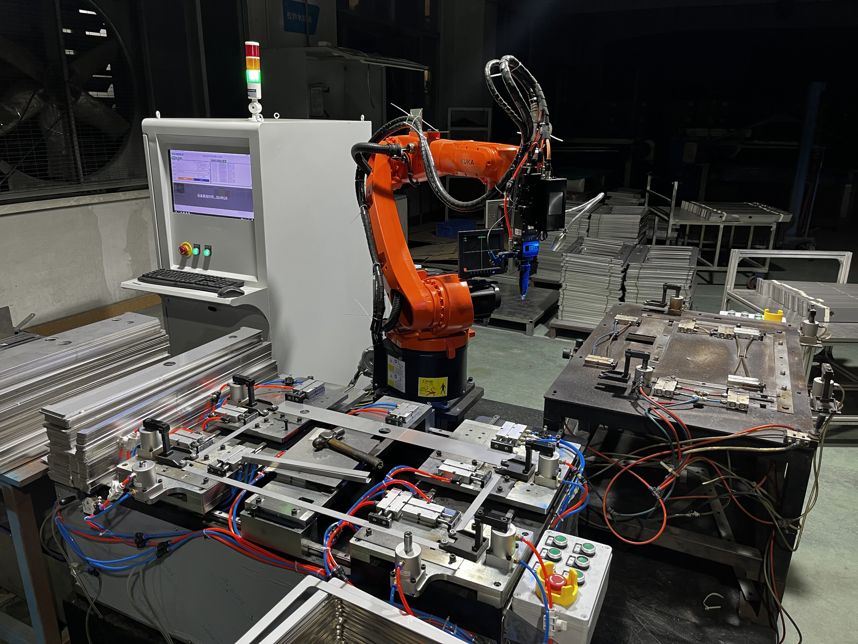
Robot_Info_Mes/Resources/2楼面板.jpg
