We-sson/HanGao/Robot_Info_Mes/Resources/9线R边.png

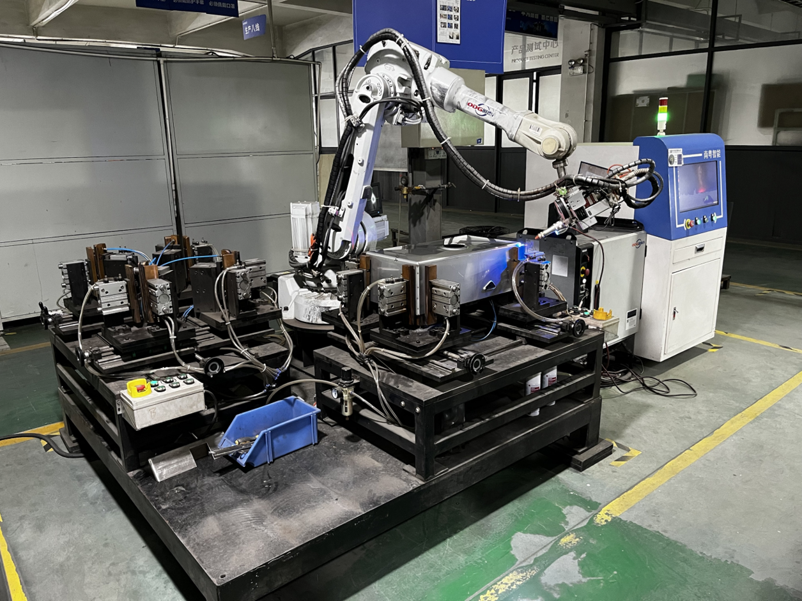
Robot_Info_Mes/Resources/9线R边.png
