We-sson/HanGao/Robot_Info_Mes/Resources/9线围边.png

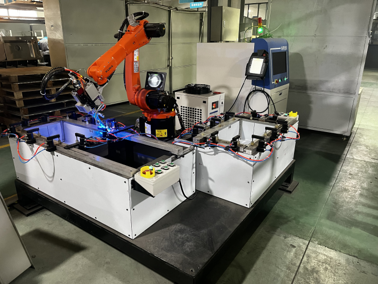
Robot_Info_Mes/Resources/9线围边.png
