We-sson/HanGao/Robot_Info_Mes/Resources/9线激光点焊.jpg

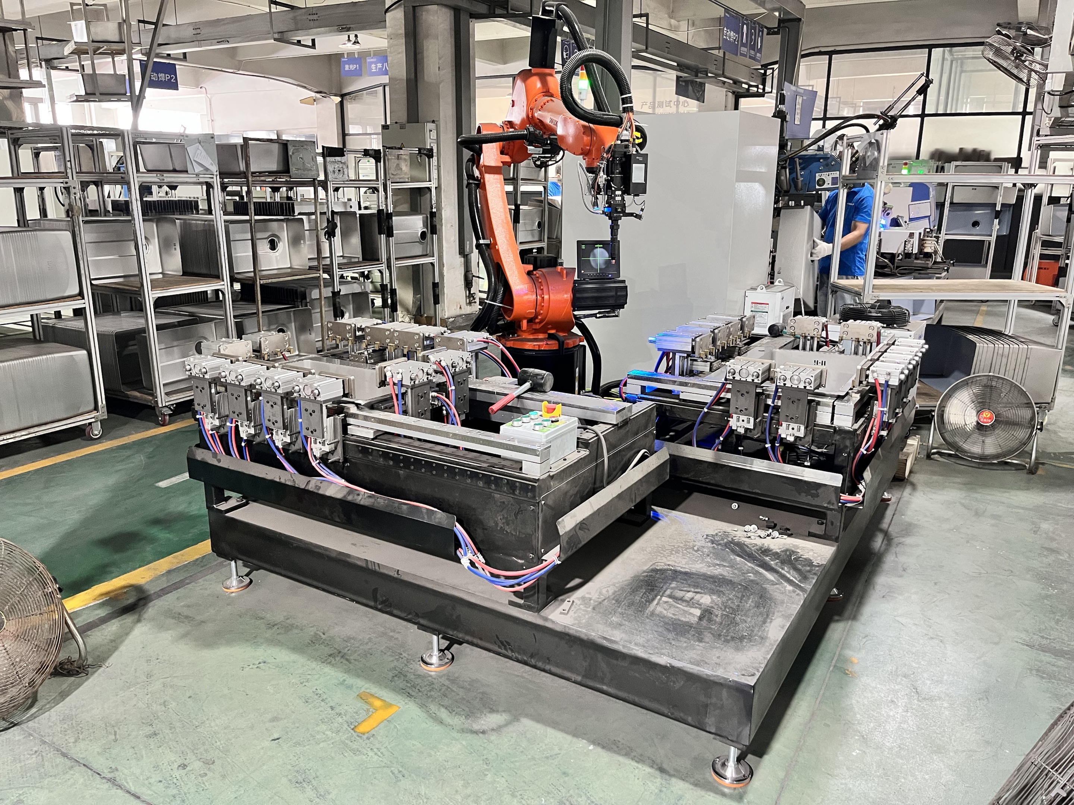
Robot_Info_Mes/Resources/9线激光点焊.jpg
