We-sson/HanGao/Robot_Info_Mes/Resources/光华拉伸激光切割_1.jpg

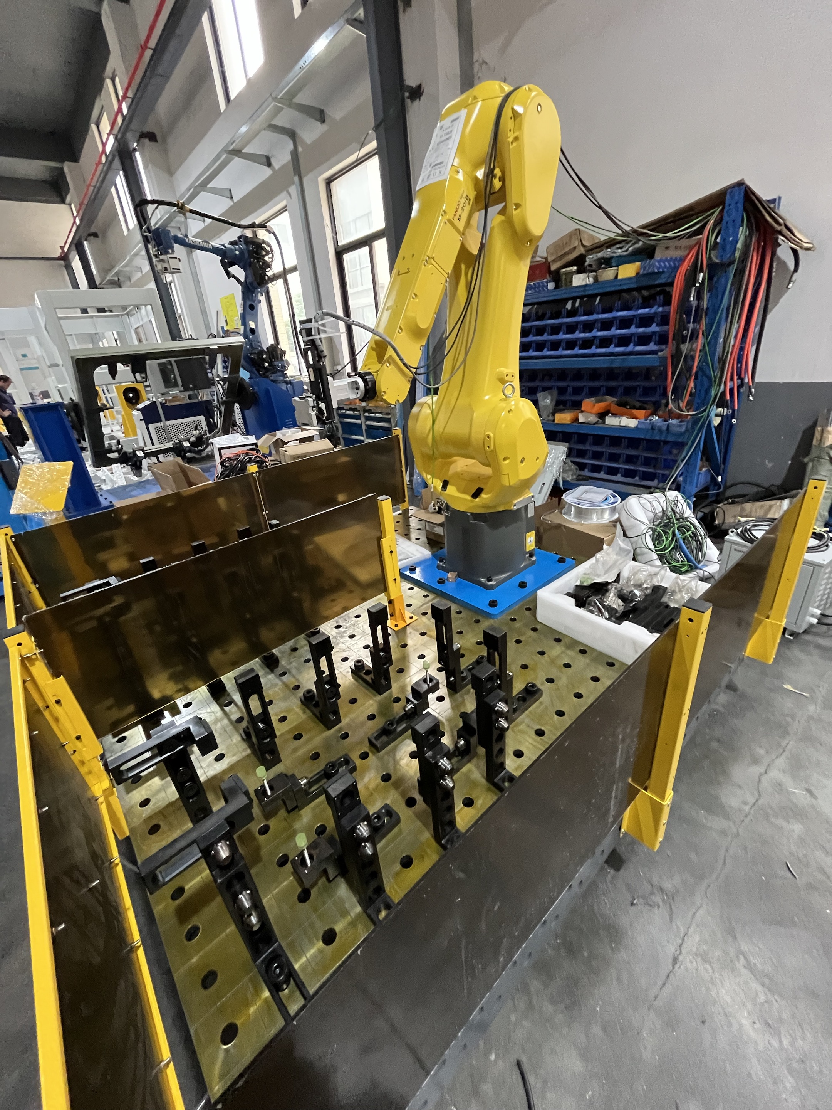
Robot_Info_Mes/Resources/光华拉伸激光切割_1.jpg
