We-sson/HanGao/Robot_Info_Mes/Resources/光华点焊围边焊接_1.jpg

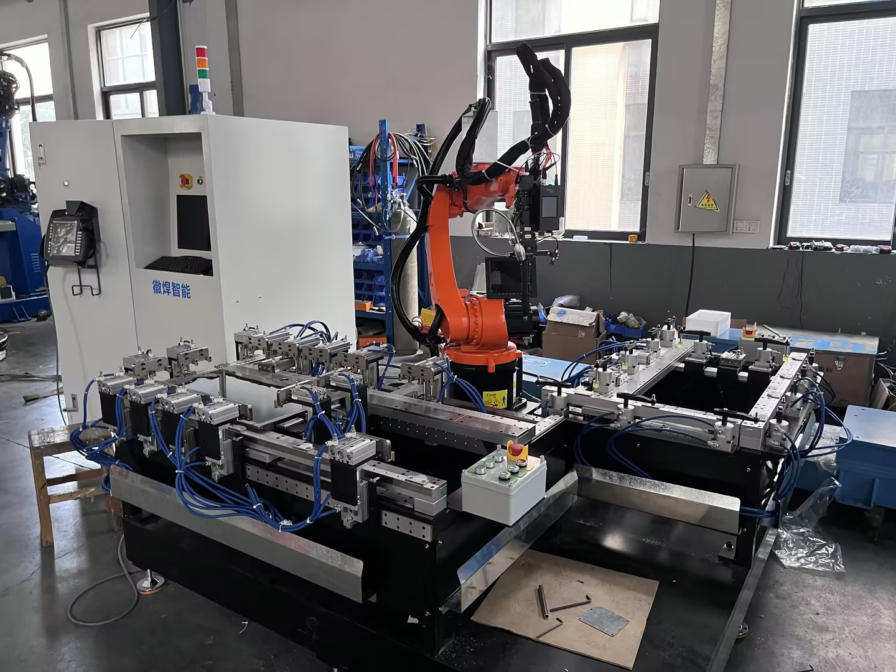
Robot_Info_Mes/Resources/光华点焊围边焊接_1.jpg
