We-sson/HanGao/tmp/hostorbit/host-1.png

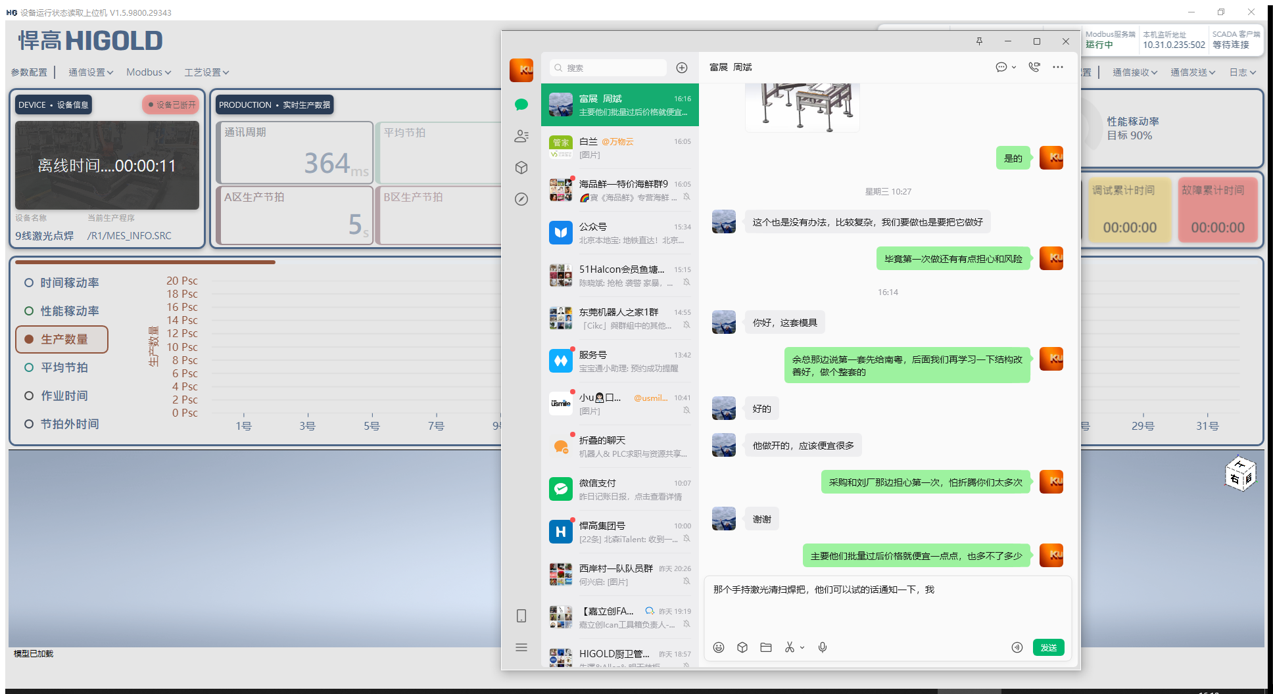
tmp/hostorbit/host-1.png
