We-sson/HanGao/tmp/hostshot/shot-loaded.png

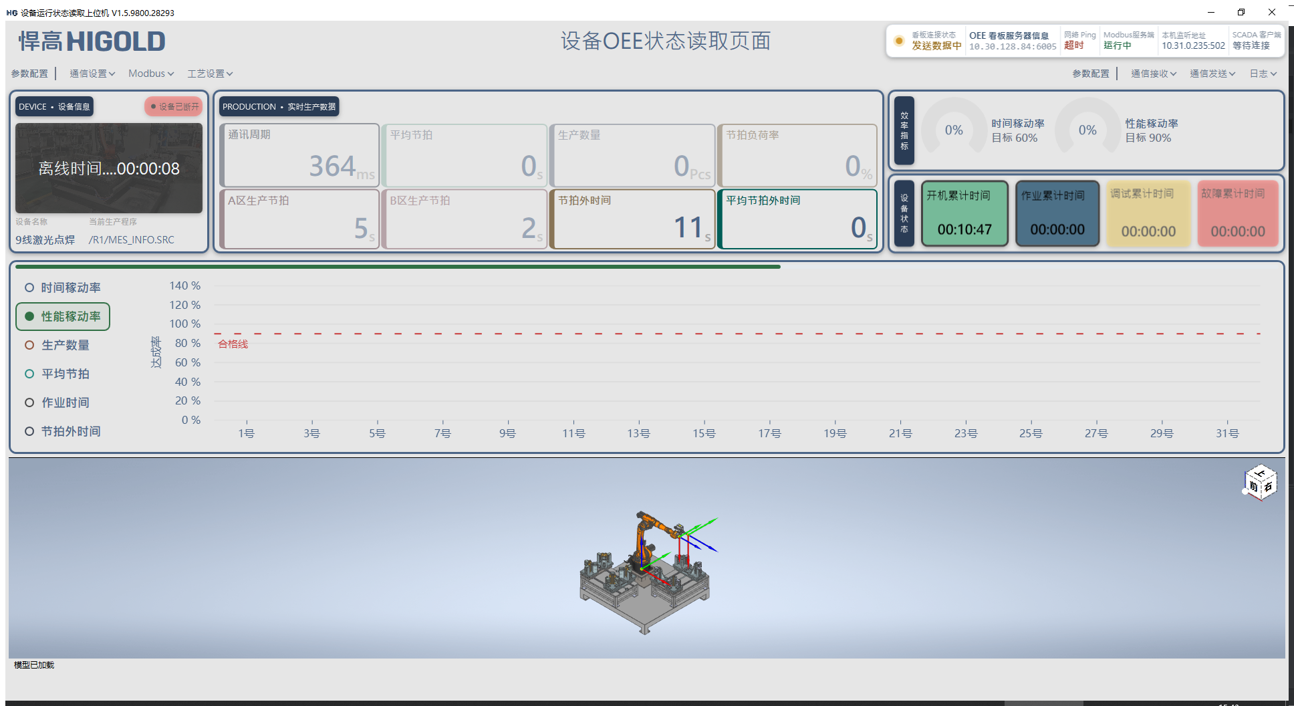
tmp/hostshot/shot-loaded.png
