We-sson/HanGao/tmp/hostshot/shot-loading.png

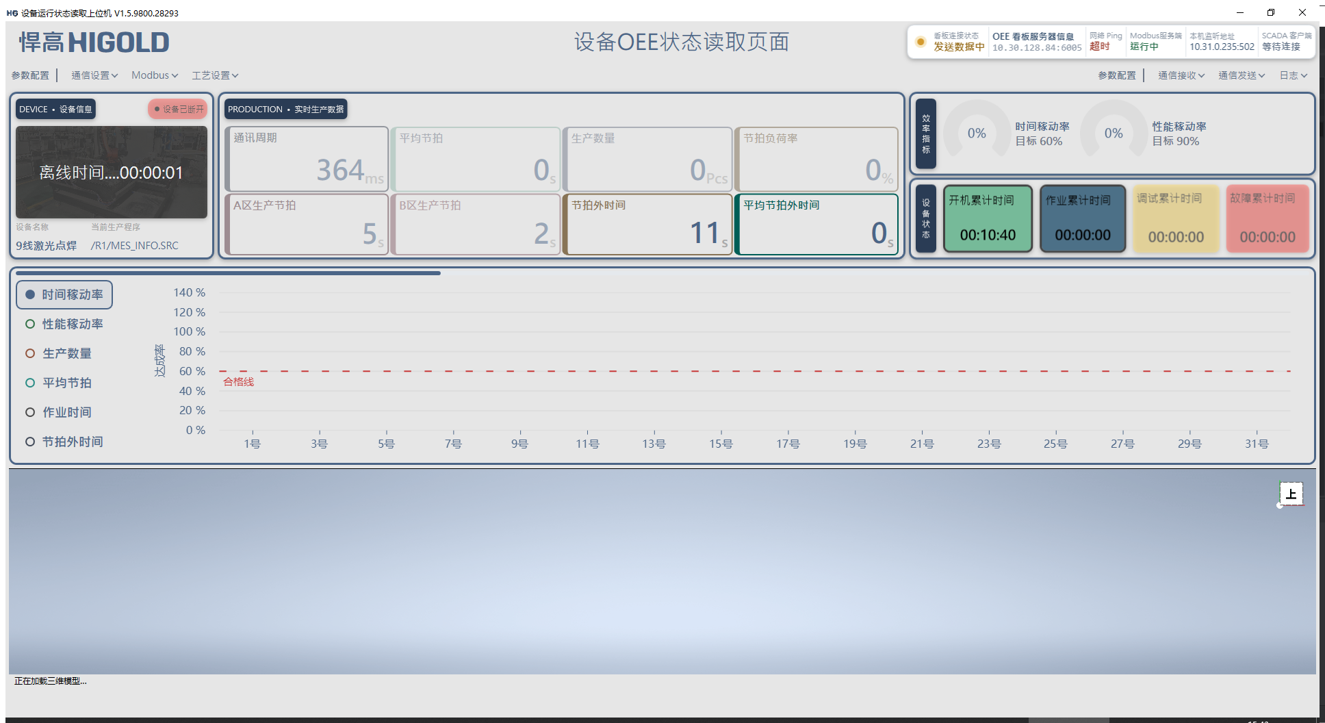
tmp/hostshot/shot-loading.png
