We-sson/HanGao/tmp/hostshot/shot.png

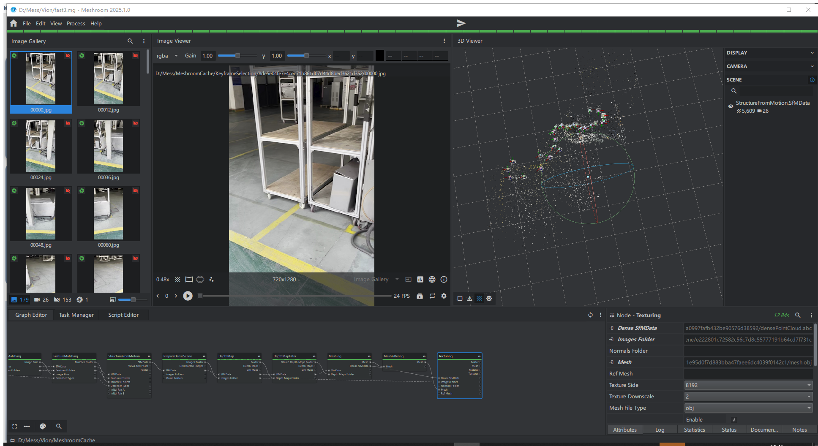
tmp/hostshot/shot.png
