We-sson/HanGao/tmp/simclick/1-start.png

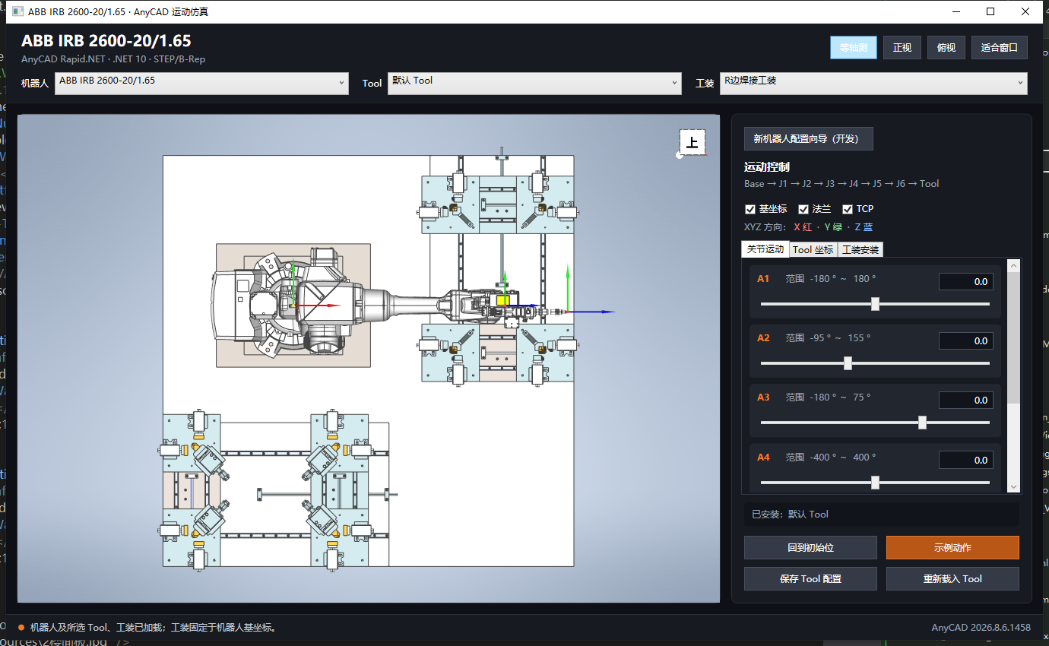
tmp/simclick/1-start.png
