We-sson/HanGao/tmp/simclick/2-front.png

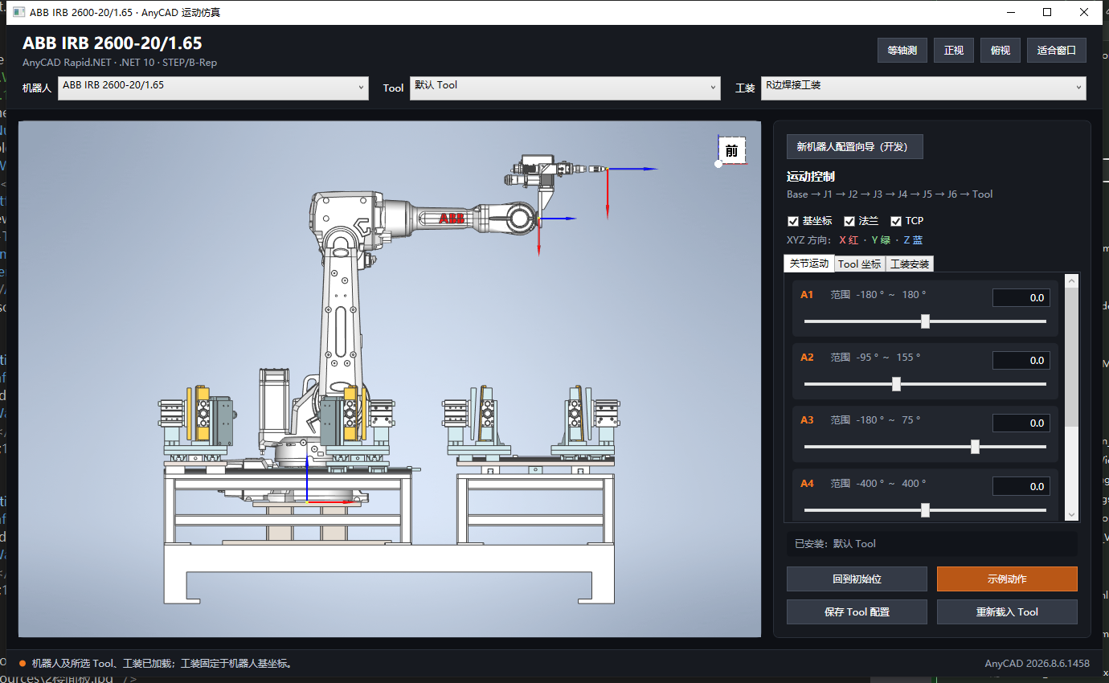
tmp/simclick/2-front.png
