We-sson/HanGao/tmp/simclick/3-iso.png

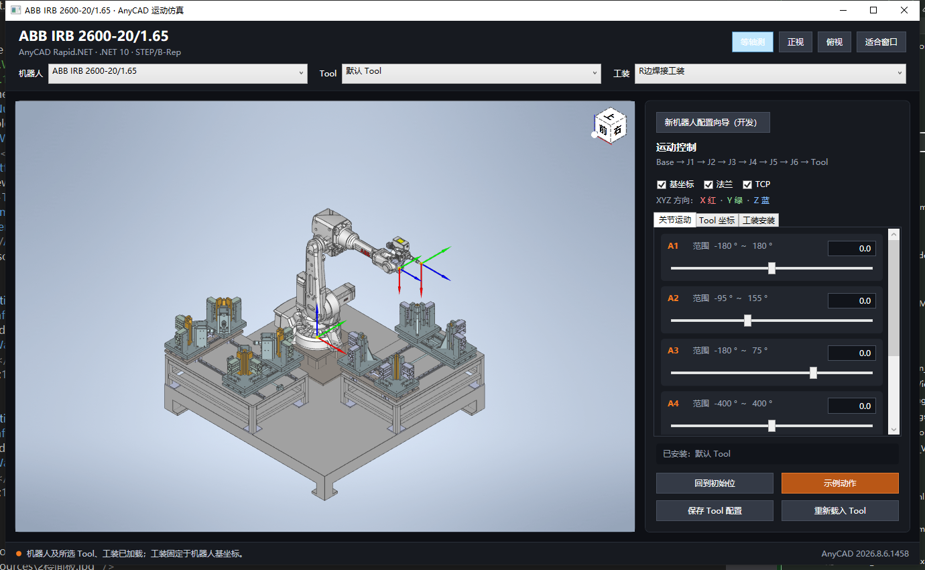
tmp/simclick/3-iso.png
