We-sson/HanGao/tmp/simclick/b2-middle.png

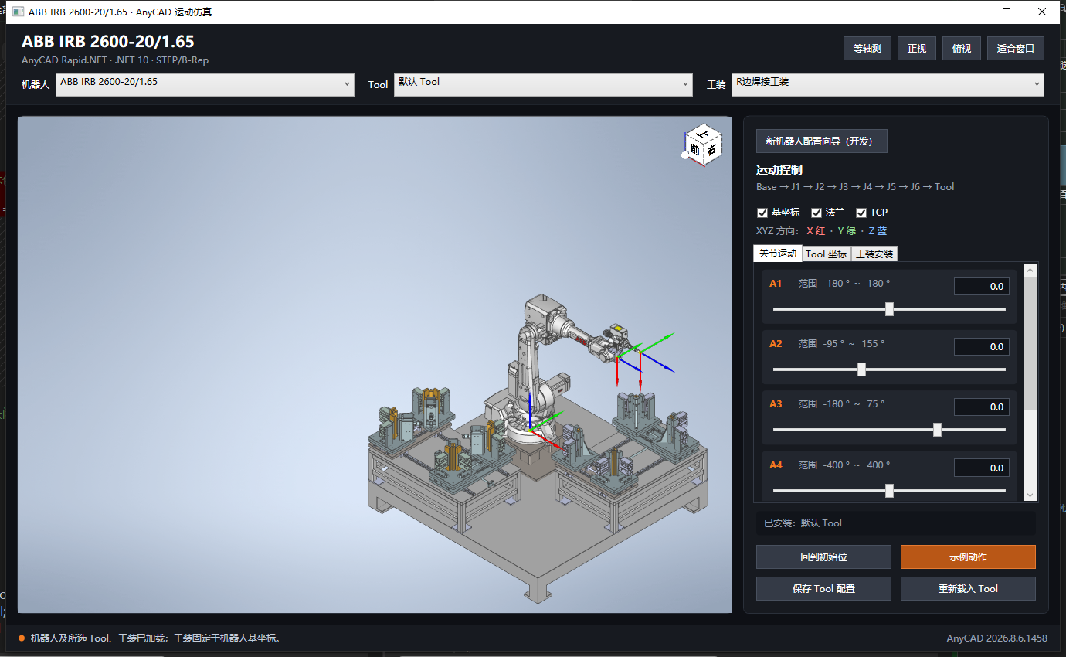
tmp/simclick/b2-middle.png
