We-sson/HanGao/tmp/simclip/shot/1.png

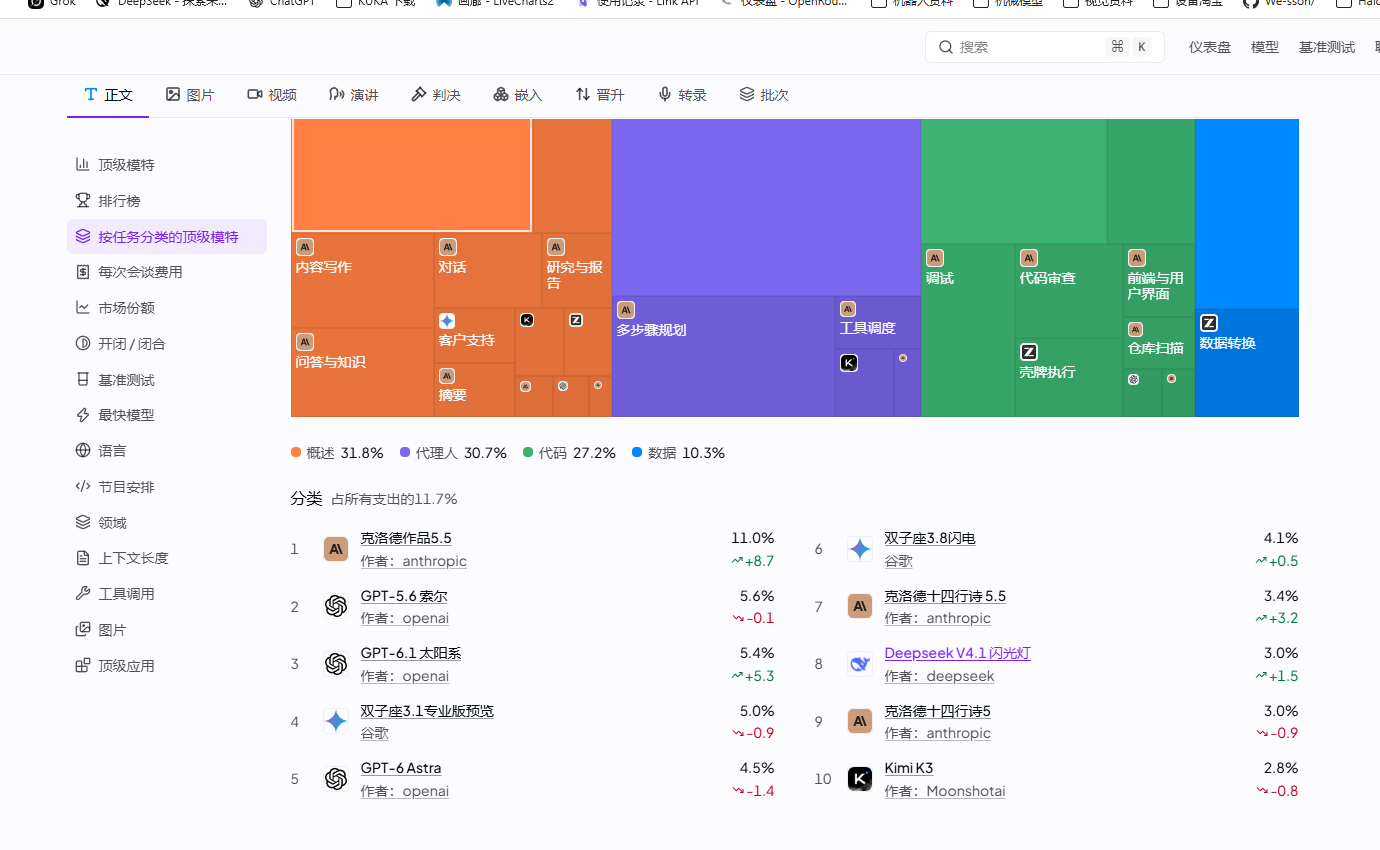
tmp/simclip/shot/1.png
