We-sson/HanGao/tmp/simclip/shot/3.png

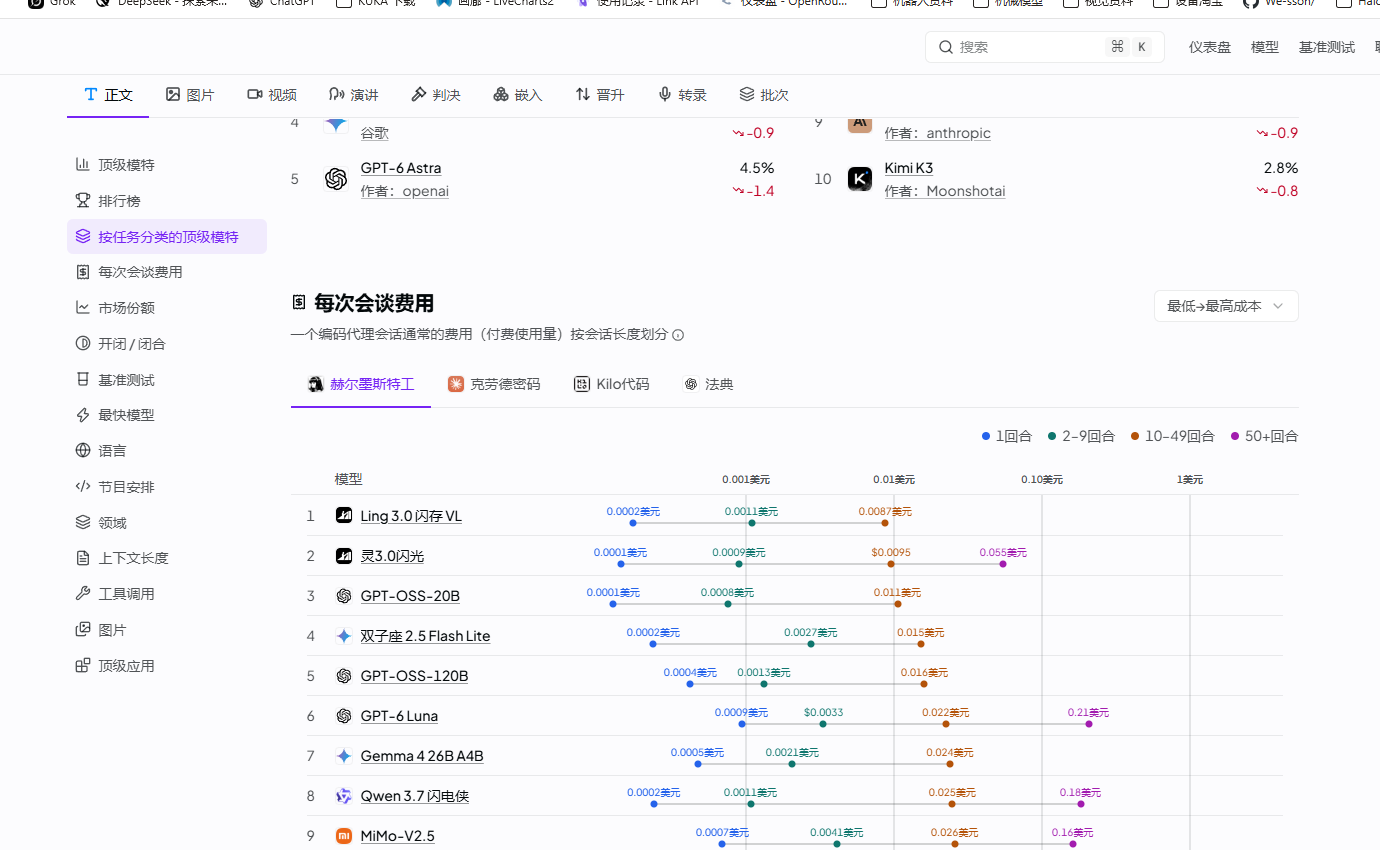
tmp/simclip/shot/3.png
