We-sson/HanGao/tmp/simfill/shot/fill.png

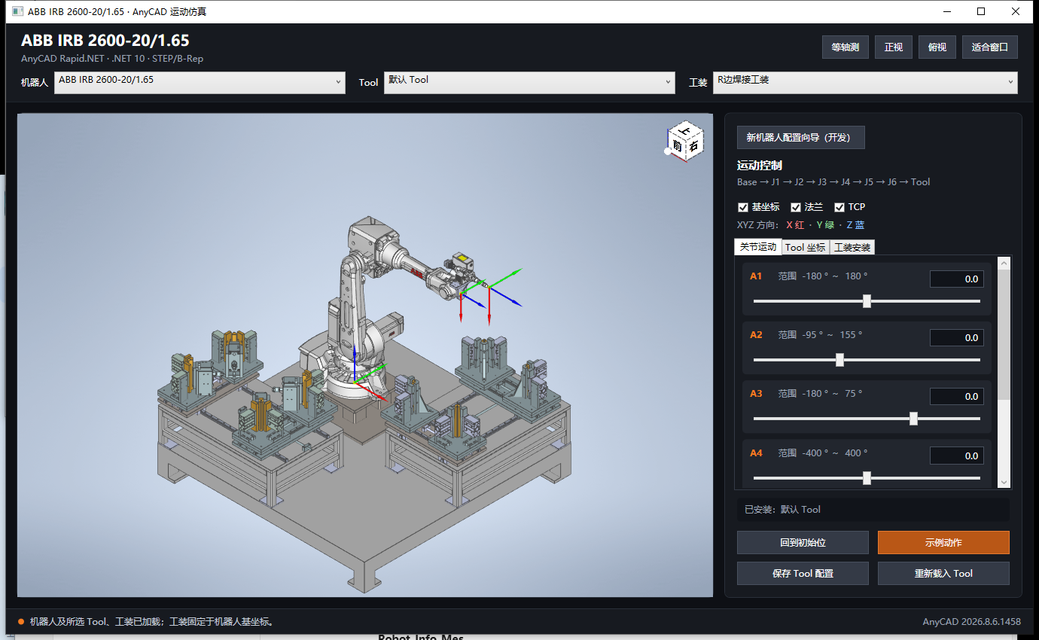
tmp/simfill/shot/fill.png
