We-sson/HanGao/tmp/simorbit/rotate-1.png

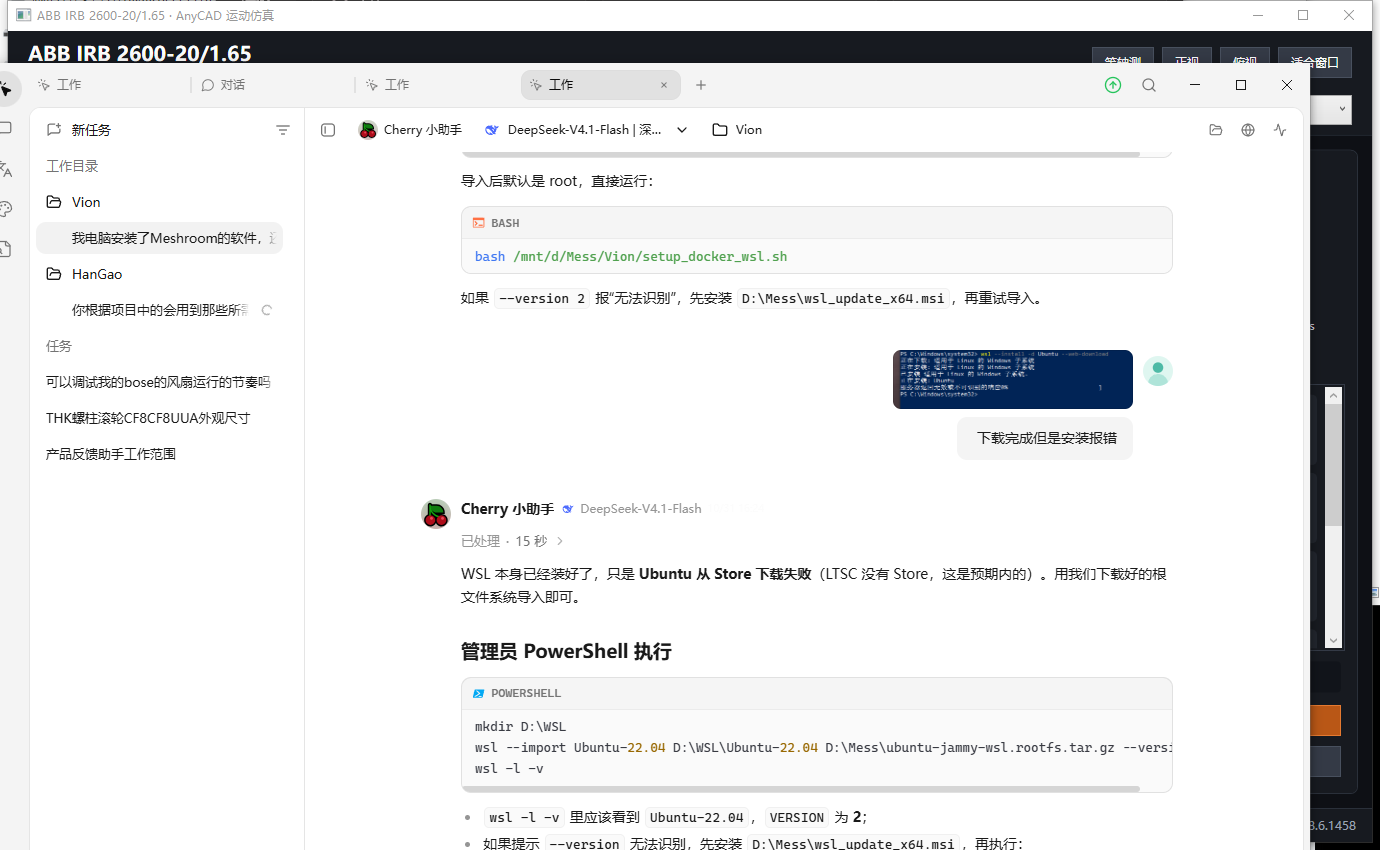
tmp/simorbit/rotate-1.png
