We-sson/HanGao/tmp/simshot/sim-loading.png

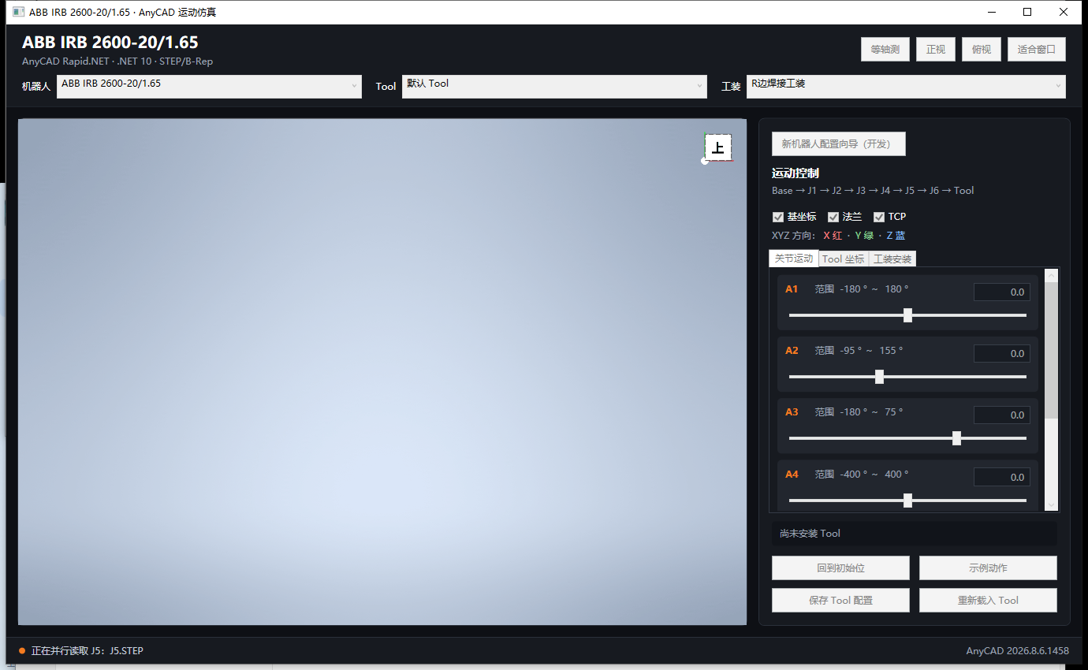
tmp/simshot/sim-loading.png
