We-sson/HanGao/Halcon_SDK/Halcon样图测试/立体视觉/三维测试零件.STEP

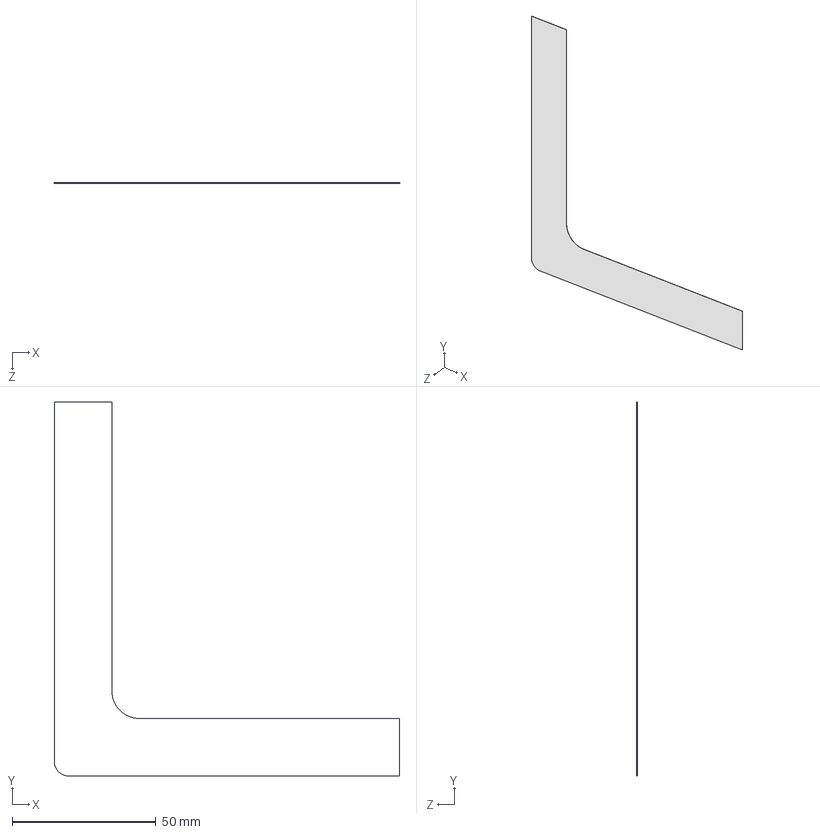
[picture p381: CAD file, 2024-08-26]
Halcon_SDK/Halcon样图测试/立体视觉/三维测试零件.STEP
120.0 x 130.0 x 0.1 mm
