We-sson/HanGao/Kawasaki_Socket/BA013N_Mes/MODEL/RA010N_J3.STL

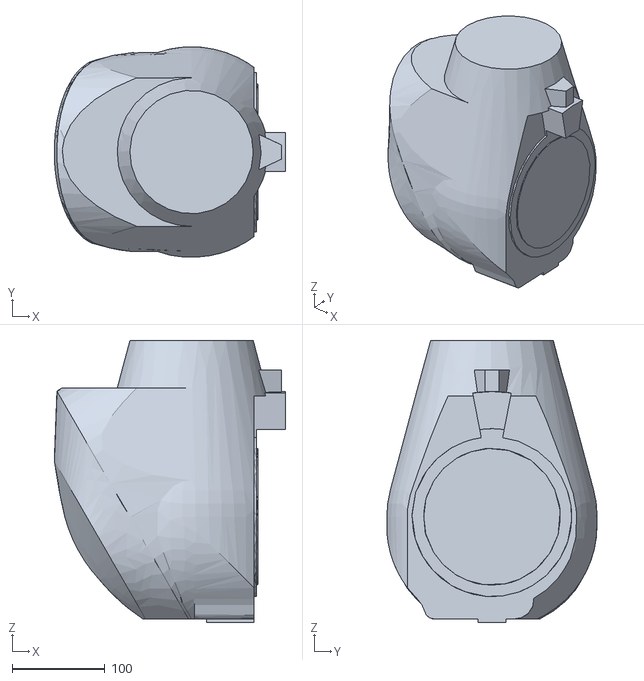
[picture p382: CAD file, 2026-01-23]
Kawasaki_Socket/BA013N_Mes/MODEL/RA010N_J3.STL
249.5 x 226.8 x 304.0
