We-sson/HanGao/Roboto_Socket_Library/Kawasaki_Socket/BA013N_Mes/MODEL/RA010N_J0.STL

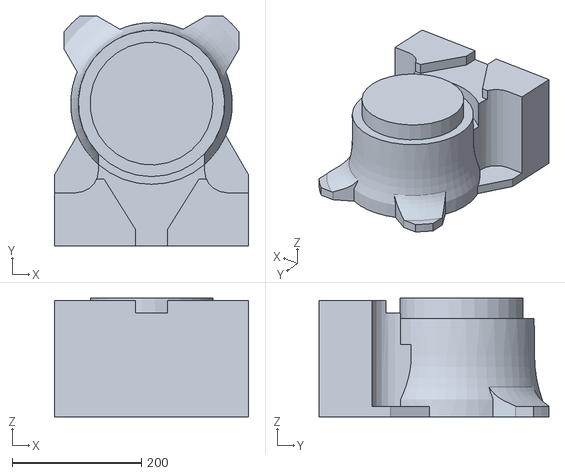
[picture p383: CAD file, 2026-01-23]
Roboto_Socket_Library/Kawasaki_Socket/BA013N_Mes/MODEL/RA010N_J0.STL
300.0 x 355.0 x 184.0
