We-sson/HanGao/RobotSimulator.AnyCAD/Resources/Robots/KR_10_R1440-2/J1.STEP

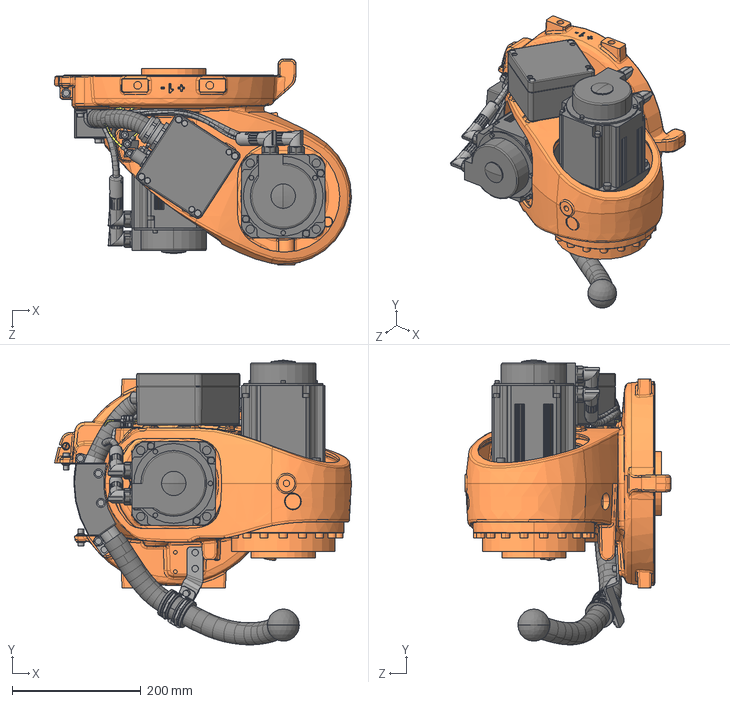
[picture p384: CAD file, 2026-10-30]
RobotSimulator.AnyCAD/Resources/Robots/KR_10_R1440-2/J1.STEP
461.1 x 442.1 x 320.0 mm
