We-sson/HanGao/RobotSimulator.AnyCAD/Resources/Robots/KR_20_R1810_2/J5.STEP

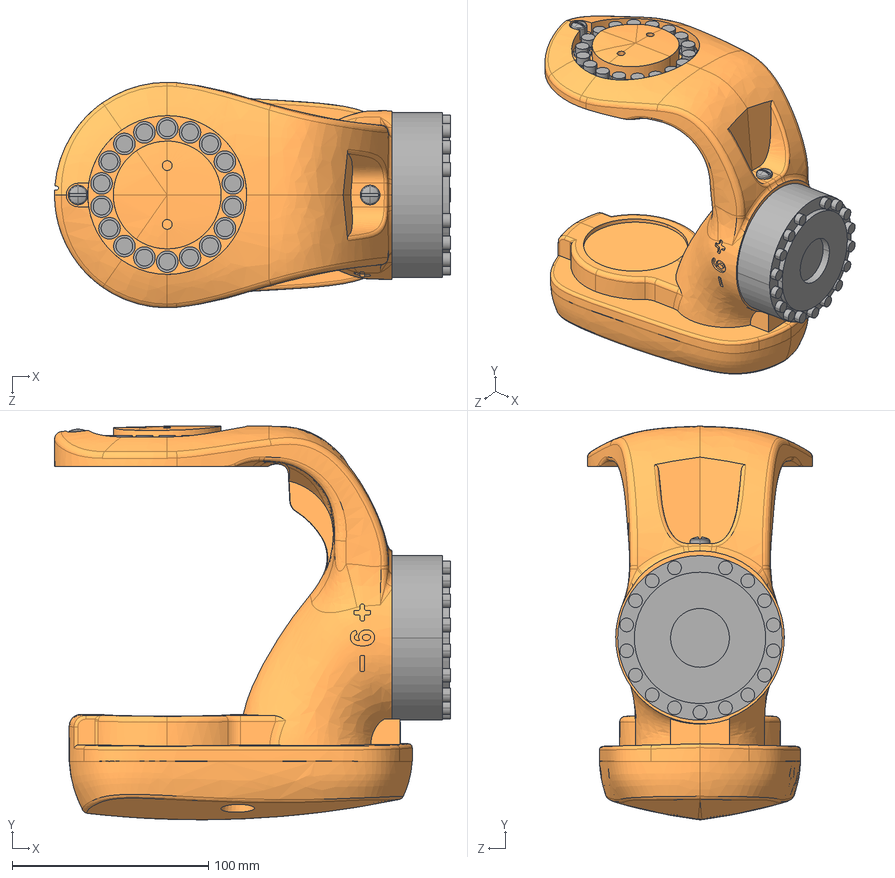
[picture p385: CAD file, 2026-10-30]
RobotSimulator.AnyCAD/Resources/Robots/KR_20_R1810_2/J5.STEP
202.0 x 200.8 x 115.0 mm
