We-sson/HanGao/RobotSimulator.AnyCAD/Resources/Tools/Tool/Tool.STEP

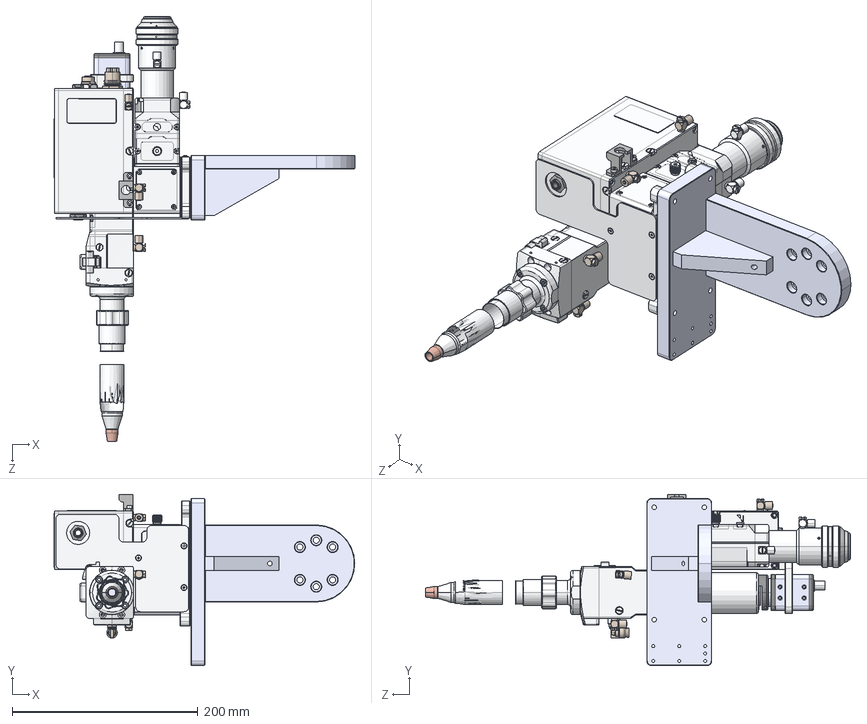
[picture p386: CAD file, 2026-10-30]
RobotSimulator.AnyCAD/Resources/Tools/Tool/Tool.STEP
323.8 x 184.4 x 457.9 mm
法兰连接板1-1820-1-2
法兰加强筋-1820-1-2
法兰连接板2-1820-1-2
焊接头 LWD03B0-AC-HB-B-H02(1)-1-2
