We-sson/HanGao/RobotSimulator.AnyCAD/Resources/Work/双点焊工装/双点焊工装.STEP

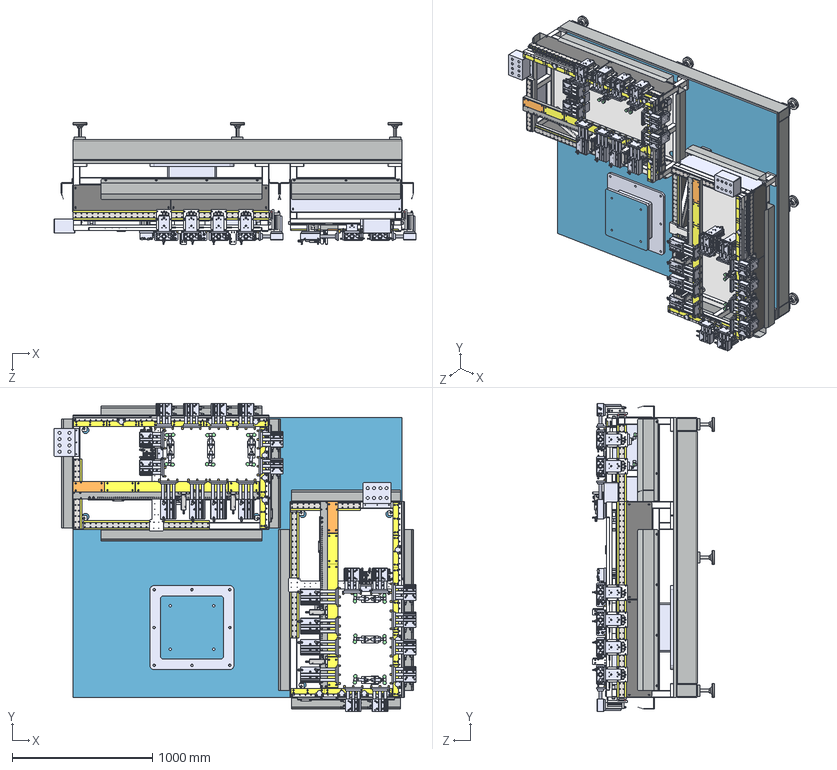
[picture p388: CAD file, 2026-10-30]
RobotSimulator.AnyCAD/Resources/Work/双点焊工装/双点焊工装.STEP
2584.5 x 2199.0 x 873.0 mm
C-CPVCH100-20-200_b-HG-1 x 8
C-CPVCH100-20-120_n-HG-1 x 8
MGW15H_右封_temp.stp-2 x 38
34310006.stp-2 x 30
M3H.stp-2 x 30
HLQ20X40-S-AF-body-1 x 8
HLQ20X40-S-AF-0-rod-1 x 8
定位夹爪安装板1-2 x 24
定位夹爪1-2 x 72
HLQL20X40-S-AF-body-2 x 20
HLQL20X40-S-AF-0-rod-2 x 20
TC-M-32x5050_b-2 x 16
TCM-32x50-0_50fp-2 x 16
滑台气缸座1-3 x 12
三轴气缸安装板1-3 x 20
三轴气缸安装板2-5 x 12
hexagon socket head cap screws gb(PreviewCfg)-1 x 12
指针-3 x 12
PSL801A-1 x 48
MPE10X10_body-2 x 2
MPE10X10_rod-2 x 2
MPE10X5_nut2-2 x 4
MPE10X5_nut1-2 x 4
_TR16-3030_b.stp-1 x 12
_TR16-30_fr.stp-1 x 12
磁吸调高-2 x 2
SMYHF10_214-2 x 12
光轴-10-2 x 12
缓冲器支架-2 x 12
磁力座12T-1 x 6
顶升气缸安装板-1 x 12
外螺纹胶头螺丝M5-1 x 24
HLQ20X75-S-AF-body-2 x 4
HLQ20X75-S-AF-0-rod-2 x 4
三轴气缸安装板1-2-2 x 4
三轴气缸安装板2-3-1 x 2
三轴气缸安装板2-4-2 x 4
滑块座1-3 x 4
滑块座2-3 x 4
滑台气缸座2-2 x 4
耐磨垫块1-2 x 4
_TC-L-20x5050_b_1-2 x 2
_TCL-20x50-0_50fp_1-2 x 2
PL801_1-2 x 4
滑块座1-1-2 x 2
滑块座2-1-2 x 2
TC-L-20x7070_b-2 x 4
TCL-20x70-0_70fp-2 x 4
缓冲胶头-2 x 8
TC-M-32x100100_b-2 x 6
TCM-32x100-0_100fp-2 x 6
三轴气缸安装板2-2-2 x 6
滑台气缸座1-2-2 x 6
指针-1-2 x 6
TC-M-32x100100_b-4-2 x 2
TCM-32x100-0_100fp-4-2 x 2
三轴气缸安装板6-1 x 2
滑台气缸座6-1 x 2
锁紧底板6-1 x 2
下机架-8(Default_按加工_)-2 x 2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
