We-sson/HanGao/Halcon_SDK/Halcon样图测试/立体视觉/采集点云.ply

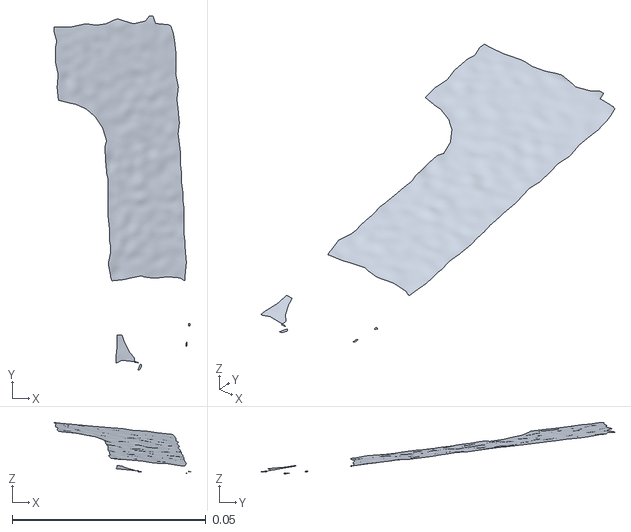
[picture p389: CAD file, 2024-07-31]
Halcon_SDK/Halcon样图测试/立体视觉/采集点云.ply
0.0354 x 0.0914 x 0.0132
