We-sson/HanGao/Kawasaki_Socket/BA013N_Mes/MODEL/RA010N_J5.STL

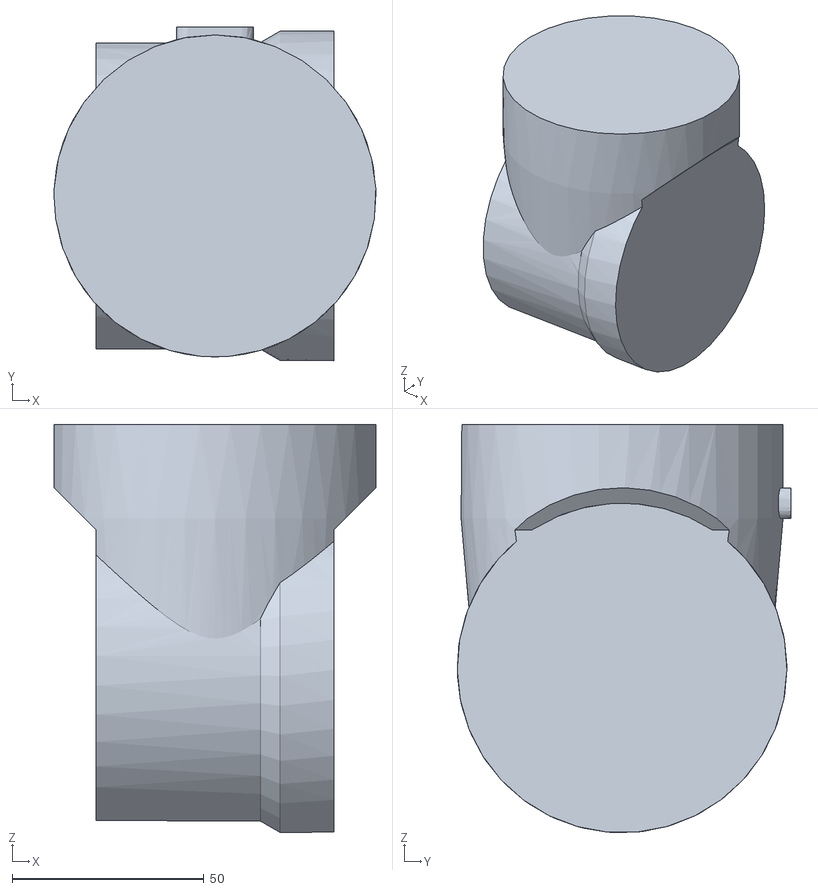
[picture p390: CAD file, 2026-01-23]
Kawasaki_Socket/BA013N_Mes/MODEL/RA010N_J5.STL
84.0 x 87.0 x 106.4
