We-sson/HanGao/Roboto_Socket_Library/Kawasaki_Socket/BA013N_Mes/MODEL/RA010N_J6.STL

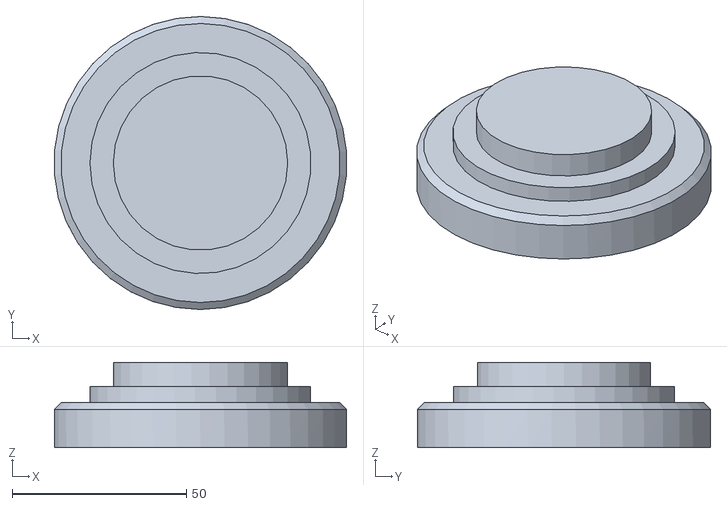
[picture p391: CAD file, 2026-01-23]
Roboto_Socket_Library/Kawasaki_Socket/BA013N_Mes/MODEL/RA010N_J6.STL
83.7 x 84.0 x 24.5
