We-sson/HanGao/RobotSimulator.AnyCAD/Resources/Robots/KR_20_R1810_2/J2.STEP

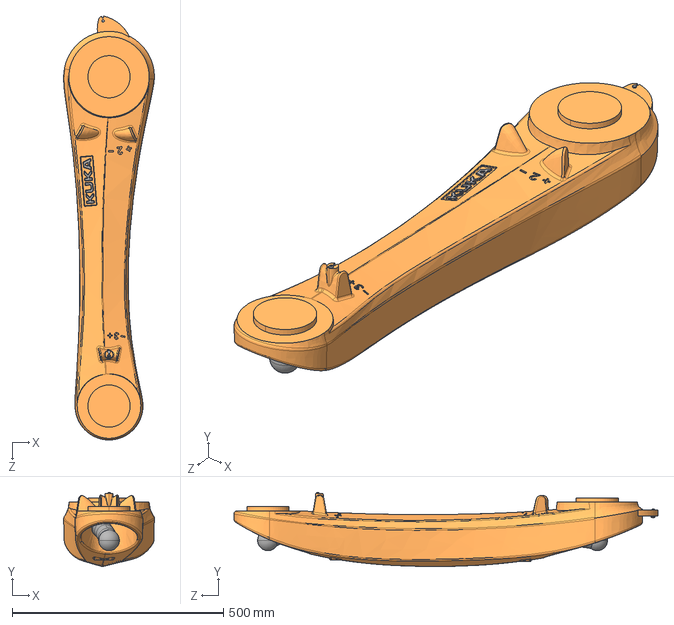
[picture p392: CAD file, 2026-10-30]
RobotSimulator.AnyCAD/Resources/Robots/KR_20_R1810_2/J2.STEP
215.0 x 175.5 x 1004.3 mm
