We-sson/HanGao/Kawasaki_Socket/BA013N_Mes/MODEL/RA010N_J4.STL

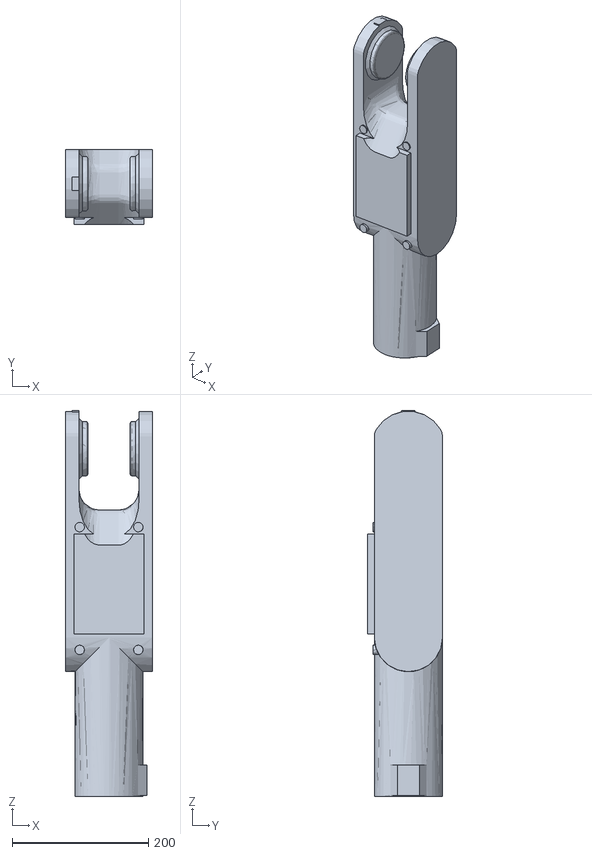
[picture p393: CAD file, 2026-01-23]
Kawasaki_Socket/BA013N_Mes/MODEL/RA010N_J4.STL
128.0 x 110.0 x 566.0
