We-sson/HanGao/Roboto_Socket_Library/Kawasaki_Socket/BA013N_Mes/MODEL/RA010N_J1.STL

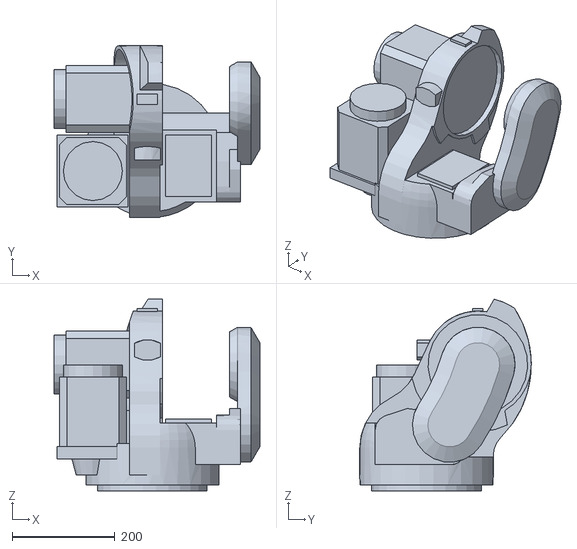
[picture p394: CAD file, 2026-01-23]
Roboto_Socket_Library/Kawasaki_Socket/BA013N_Mes/MODEL/RA010N_J1.STL
401.0 x 334.0 x 373.1
