We-sson/HanGao/RobotSimulator.AnyCAD/Resources/Robots/KR_20_R1810_2/J4.STEP

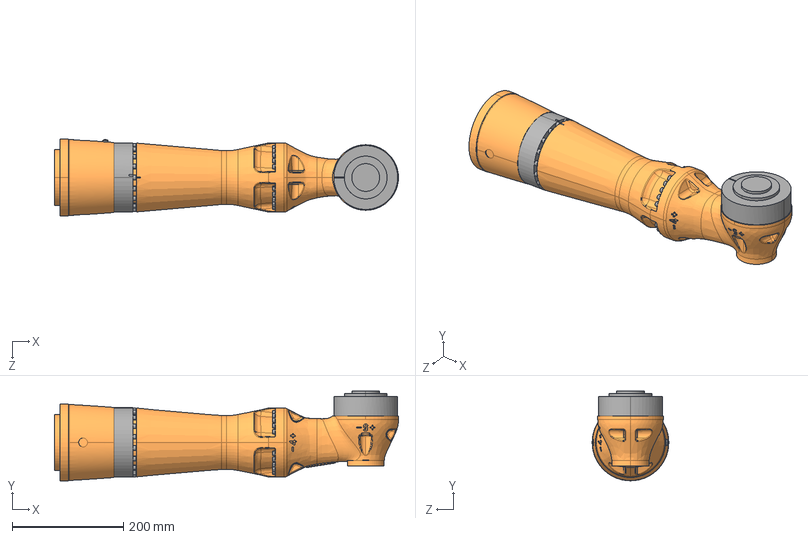
[picture p395: CAD file, 2026-10-30]
RobotSimulator.AnyCAD/Resources/Robots/KR_20_R1810_2/J4.STEP
619.0 x 161.3 x 138.0 mm
