We-sson/HanGao/Roboto_Socket_Library/Kawasaki_Socket/BA013N_Mes/MODEL/RA010N_J2.STL

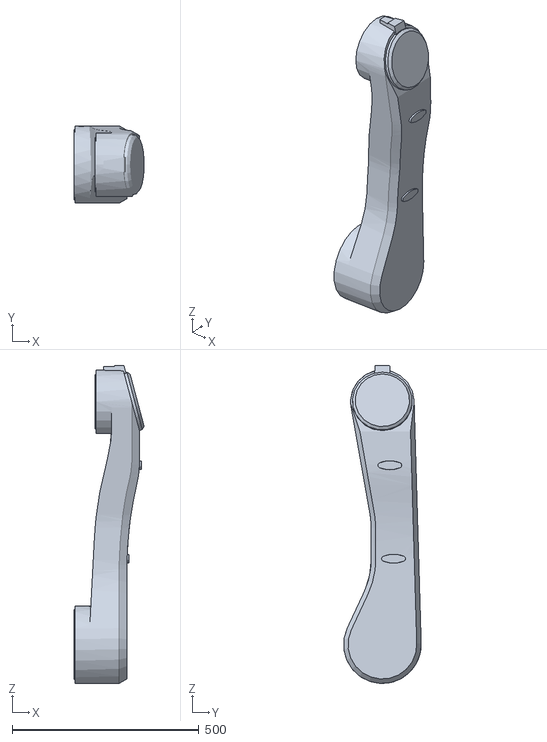
[picture p396: CAD file, 2026-01-23]
Roboto_Socket_Library/Kawasaki_Socket/BA013N_Mes/MODEL/RA010N_J2.STL
188.2 x 207.2 x 851.0
