We-sson/HanGao/RobotSimulator.AnyCAD/Resources/Robots/KR_20_R1810_2/Base.STEP

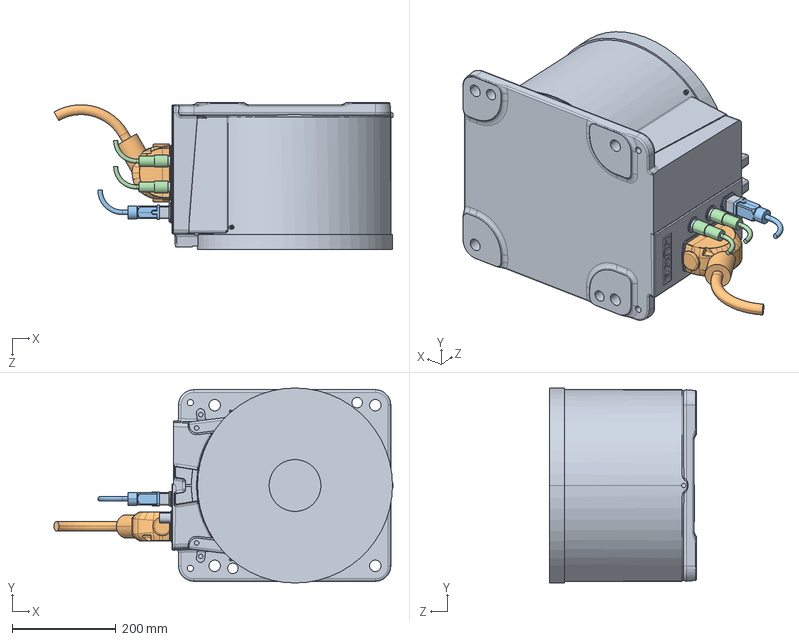
[picture p397: CAD file, 2026-10-30]
RobotSimulator.AnyCAD/Resources/Robots/KR_20_R1810_2/Base.STEP
654.6 x 376.5 x 284.5 mm
KR_20_R1810-2_V00.sldasm-Part-1
KR_20_R1810-2_V00.sldasm-Part-2
R2
KR_20_R1810-2_V00.sldasm-Part-3
KR_20_R1810-2_V00.sldasm-Part-4
