We-sson/HanGao/RobotSimulator.AnyCAD/Resources/Robots/KR_20_R1810_2/J3.STEP

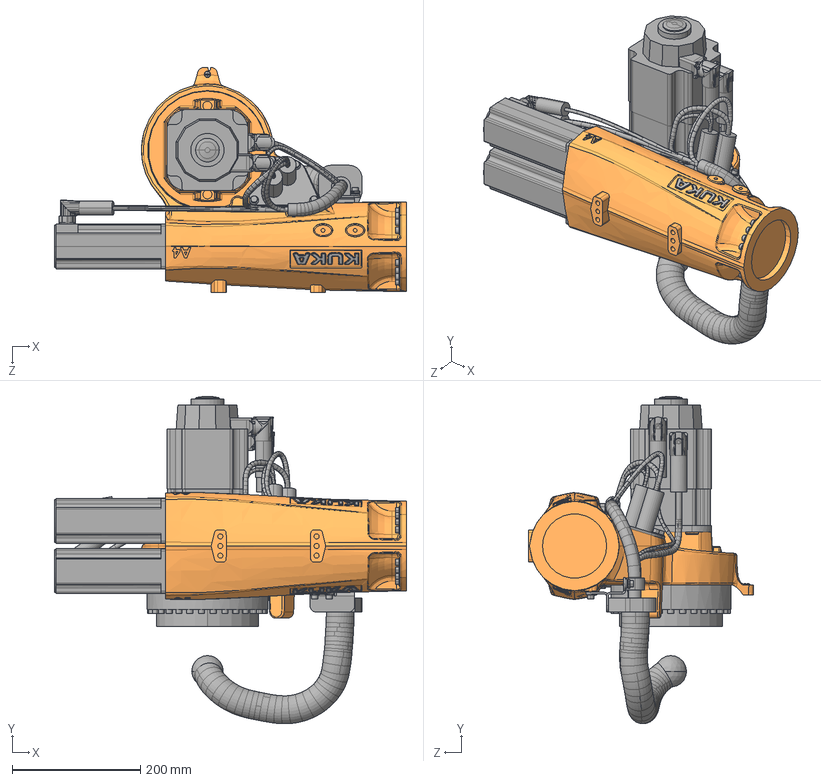
[picture p398: CAD file, 2026-10-30]
RobotSimulator.AnyCAD/Resources/Robots/KR_20_R1810_2/J3.STEP
548.2 x 510.0 x 350.9 mm
