We-sson/HanGao/(list of files, cad)

Other CAD files:
Halcon_SDK/Halcon样图测试/立体视觉/三维测试零件.PLY
Halcon_SDK/Halcon样图测试/立体视觉/三维测试零件.SLDPRT
RobotSimulator.AnyCAD/Resources/Robots/IRB2600_20_165/Base.STEP
RobotSimulator.AnyCAD/Resources/Robots/IRB2600_20_165/J1.STEP
RobotSimulator.AnyCAD/Resources/Robots/IRB2600_20_165/J2.STEP
RobotSimulator.AnyCAD/Resources/Robots/IRB2600_20_165/J3.STEP
RobotSimulator.AnyCAD/Resources/Robots/IRB2600_20_165/J4.STEP
RobotSimulator.AnyCAD/Resources/Robots/IRB2600_20_165/J5.STEP
RobotSimulator.AnyCAD/Resources/Robots/IRB2600_20_165/J6.STEP
RobotSimulator.AnyCAD/Resources/Robots/KR_10_R1420_HP/Base.STEP
RobotSimulator.AnyCAD/Resources/Robots/KR_10_R1420_HP/J1.STEP
RobotSimulator.AnyCAD/Resources/Robots/KR_10_R1420_HP/J2.STEP
RobotSimulator.AnyCAD/Resources/Robots/KR_10_R1420_HP/J3.STEP
RobotSimulator.AnyCAD/Resources/Robots/KR_10_R1420_HP/J4.STEP
RobotSimulator.AnyCAD/Resources/Robots/KR_10_R1420_HP/J5.STEP
RobotSimulator.AnyCAD/Resources/Robots/KR_10_R1420_HP/J6.STEP
RobotSimulator.AnyCAD/Resources/Robots/KR_35_R1820_2/Base.STEP
RobotSimulator.AnyCAD/Resources/Robots/KR_35_R1820_2/J1.STEP
RobotSimulator.AnyCAD/Resources/Robots/KR_35_R1820_2/J2.STEP
RobotSimulator.AnyCAD/Resources/Robots/KR_35_R1820_2/J3.STEP
RobotSimulator.AnyCAD/Resources/Robots/KR_35_R1820_2/J4.STEP
RobotSimulator.AnyCAD/Resources/Robots/KR_35_R1820_2/J5.STEP
RobotSimulator.AnyCAD/Resources/Robots/KR_35_R1820_2/J6.STEP
Robot_3D/模型文件/KR_10_R1440-2/Base.STEP
Robot_3D/模型文件/KR_10_R1440-2/J2.STEP
Robot_3D/模型文件/KR_10_R1440-2/J3.STEP
Robot_3D/模型文件/KR_10_R1440-2/J4.STEP
Robot_3D/模型文件/KR_10_R1440-2/J5.STEP
Robot_3D/模型文件/KR_10_R1440-2/J6.STEP
