We-sson/HanGao/Halcon_SDK/Halcon样图测试/立体视觉/reconstruct_surface_stereo/images/02_L.png

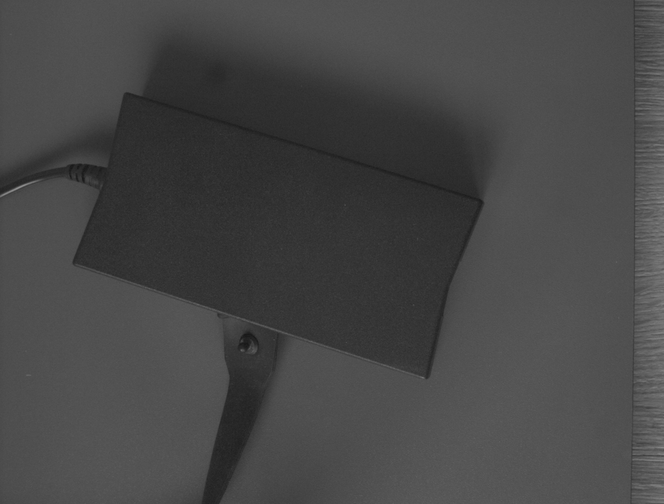
Halcon_SDK/Halcon样图测试/立体视觉/reconstruct_surface_stereo/images/02_L.png
