We-sson/HanGao/RobotSimulator.AnyCAD/Resources/SetupGuide/angle-reference.png

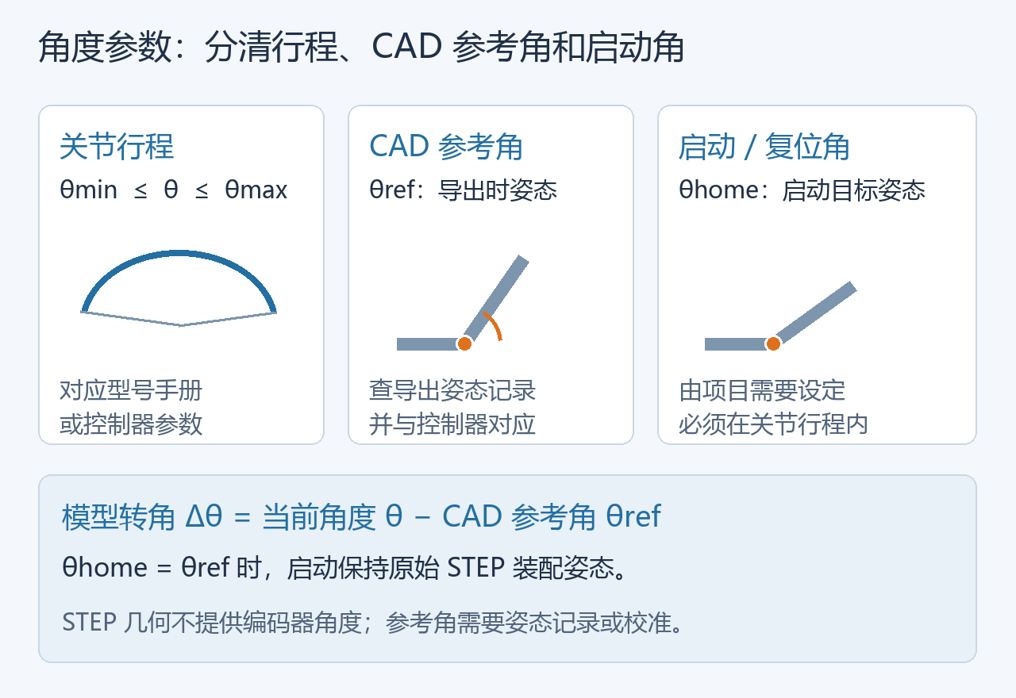
RobotSimulator.AnyCAD/Resources/SetupGuide/angle-reference.png
