We-sson/HanGao/RobotSimulator.AnyCAD/Resources/SetupGuide/flange-frame.png

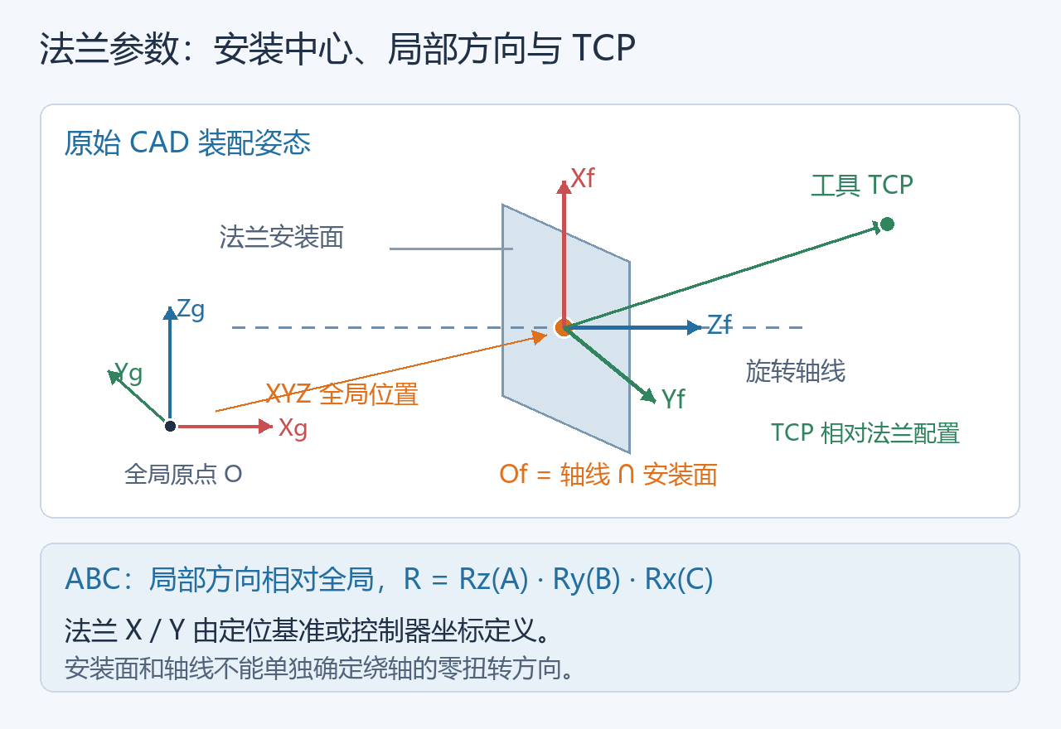
RobotSimulator.AnyCAD/Resources/SetupGuide/flange-frame.png
