We-sson/HanGao/RobotSimulator.AnyCAD/Resources/SetupGuide/joint-axis.png

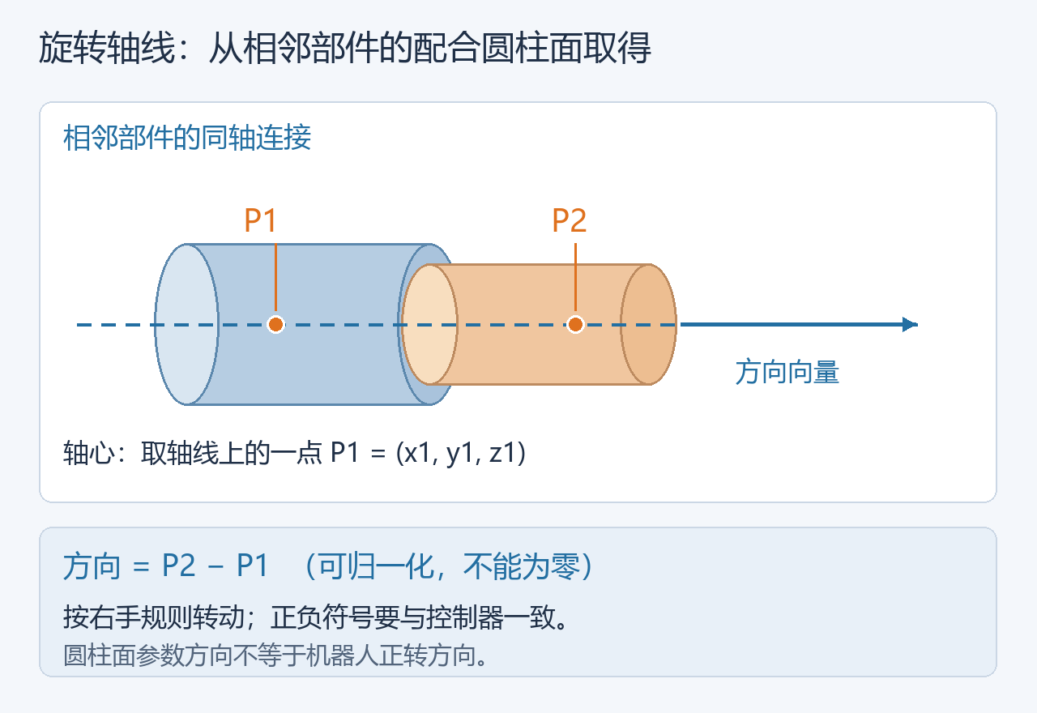
RobotSimulator.AnyCAD/Resources/SetupGuide/joint-axis.png
