We-sson/HanGao/RobotSimulator.AnyCAD/Resources/SetupGuide/model-assembly.png

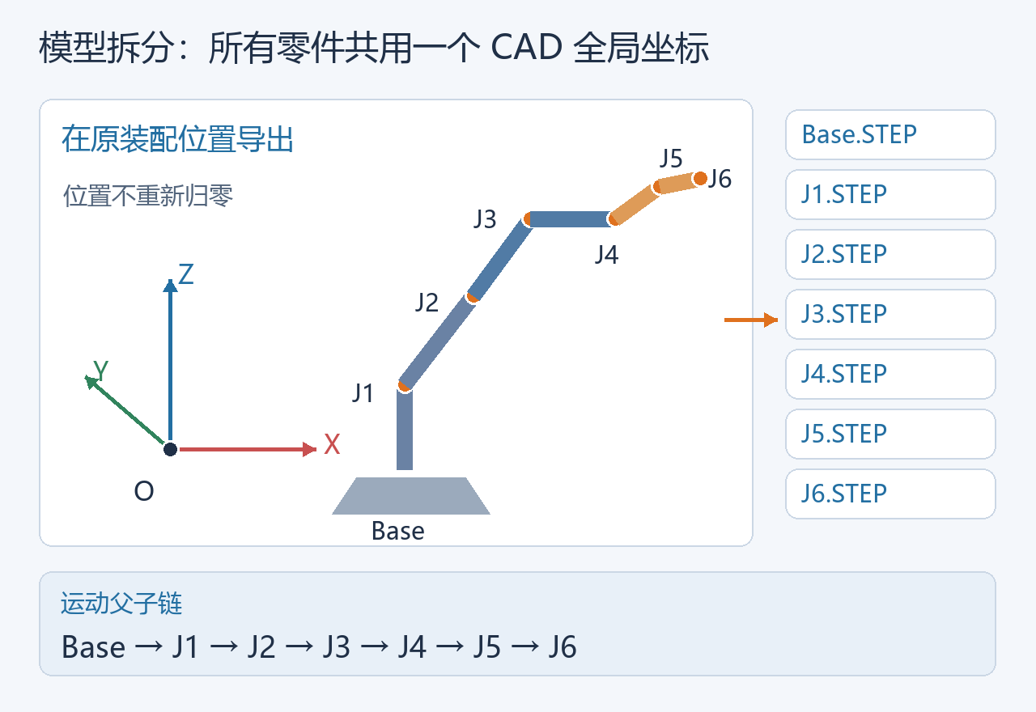
RobotSimulator.AnyCAD/Resources/SetupGuide/model-assembly.png
