We-sson/HanGao/Ps_UI/calibrate.png

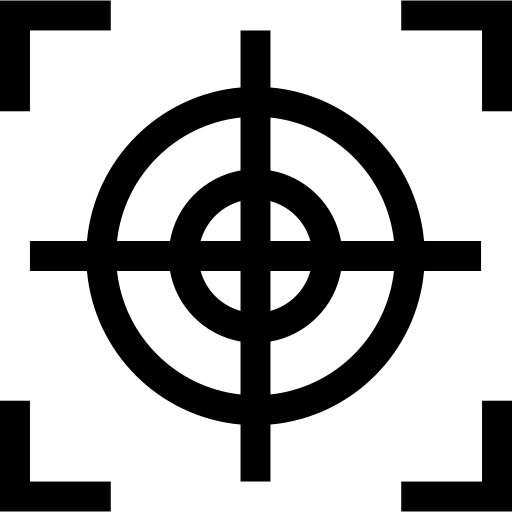
Ps_UI/calibrate.png
