We-sson/HanGao/(threads)

Thread 1 (2024-07-13):

有没有项目文档呀

94659960, 2024-07-13:
方便的话 QQ 94659960

We-sson, 2024-07-15:
感谢关注！该项目处于半成品研发状态，详细项目文档正在编写后续会更新推送！

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

94659960, 2024-08-26:
我一直在写.net，对该项目非常有兴趣，可否一起参与一下呀。
________________________________
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

We-sson, 2024-12-23:
**感谢各位开发者喜欢，该项目现有本人进行细分领域的工艺开发，属于非标软件。**
本项目可自下载参考和观摩，感谢各位对该项目非常有兴趣！

Closed 2024-07-15.
