We-sson/HanGao/(commit log)

2021-02-21 添加 .gitignore 和 .gitattributes。
2021-02-21 添加项目文件。
2021-02-21 二次提交
2021-02-21 拉取 测试
2021-02-22 重写滚动条样式
2021-02-24 1.把鼠标移动到元素ListBox样式修改。
2021-02-26 1.更新LIstbox数板在元素里面放大动画 2.添加输入框搜索功能
2021-03-02 1.更换内容页面切换架构，能够保持输入内容
2021-03-02 1.增加LIst列表显示动画 2.修改细节
2021-03-02 !.LIstBox添加显示动画过度 2.中间功能区域前端 3Gird鼠标到达元素上方效果
2021-03-03 1.增加功能选项样式。2.优化全局阴影效果
2021-03-07 1.修改功能区样式
2021-03-14 1.功能区细节修改2.增加机器人运行状况
2021-03-31 1.更改型号设置到加工区域,通过点击选择,取消拖拉事件.
2021-04-01 1.优化弹出工位选择动画.2,增加全局阴影
2021-04-04 1,添加加工型号写入指示显示
2021-04-06 1.把加工区域用户控件化 2.创建加工区域UI显示字段绑定 3.创建弹窗用户控件页面
2021-04-06 1.修改报错BUG
2021-04-14 1.增加功能区切换自身存储状态。2.优化显示加入加工区域颜色显示。3.增加型号列变切换弹窗提示，并检查列变中无其他Checked状态。
2021-04-21 1.修改主窗体边框大小和拖拉设置。2，增加最大最小关闭窗口功能。3，增加软件日志显示区域，把功能切换信息显示，加载卸载型号输出。4，显示日志有显示会调到最底部。5，优化View部分逻辑 6，修改弹窗原理，用UserControl框架显示。
2021-04-26 1.弹窗框架改为内部弹出 2.在主页面中添加UserControl作为多类型弹窗显示 3.使用消息通道传递和ViewModel之间交互 3.整理个部件注释
2021-04-26 -------前段UI完成---------
2021-05-07 1.增加侧边栏弹出功能 2.侧边栏弹出动画效果主页模糊屏蔽操作 3.侧边栏调整为用户控件可重复使用
2021-05-17 1增加用户IP端口输入数据检测 2.迁移Socket连接到主项目中 3.增加断开连接按钮
2021-06-11 1.部分功能修改为异步方式 2.加工区域布局修改 3.结构化优化
2021-06-11 二次上传
2021-06-11 修改打包参数
2021-06-27 1.更改发送框架
2021-06-28 1.优化程序性能，速度提升
2021-07-05 1.界面列表布局优化.2.性能提升
2021-07-06 1.优化接收消息重叠问题
2021-07-07 1.移除资源独占指令
2021-07-08 1.界面重新布局 2.侧面栏移动到左边
2021-07-10 1.测量栏布局改为左侧 2.修改型号列变显示，缩小
2021-07-13 1.功能区优化布局
2021-07-18 1.开始测试机器人通讯稳定性 2.增加写入变量测试
2021-07-18 1.更新界面优化
2021-07-20 1.增加列表循环延迟显示
2021-07-21 1.优化使用资源
2021-07-23 1.优化界面性能。 2.增加启动功能测试
2021-07-24 1.传输变量名更改为枚举类型，可多方面使用减少输入错误问题 2.把基础功能双向绑定到库卡变量上
2021-07-26 1.优化枚举架构
2021-07-28 1.优化数据同步化问题，2.添加同步数据的类型枚举
2021-07-28 1.修正工作区，在#ERRor字符下，失效
2021-07-29 1优化界面逻辑，2添加变量解释
2021-07-30 1.优化连接异常问题 2.优化机器人端异常断开处理方式 3.优化程序架构
2021-07-30 1.优化通讯报错信息
2021-07-31 1.优化滚动条卡顿问题
2021-08-03 1.优化控件逻辑 2.列变穿参方式修改
2021-08-05 1.优化控件之间传值问题
2021-08-21 1.测试内阴影显示
2021-08-23 1.更改侧边栏结构
2021-08-23 1.添加PS文件
2021-08-23 1.添加图标源文件
2021-08-26 1.优化名称2.增加Grie内阴影样式
2021-08-28 1.重写侧边栏显示。2.优化UI区域
2021-08-30 1.优化侧边栏结构
2021-09-16 1.大幅优化
2021-09-16 1.Nut库更新
2021-09-16 1.优化警告输出
2021-09-17 1.查找无数据接收问题
2021-09-18 1.把写入功能改为短连接
2021-09-19 1.重构写入通讯架构
2021-09-23 1.发送接收通讯测试完成
2021-09-23 1.发送与连接增加连接超时 2.连接方式改为多线程连接
2021-09-25 1.写入线程增加排队功能，减少多并发，界面卡顿现象
2021-09-25 1.修改发送回调异常问题
2021-09-28 1.读取线程通讯优化
2021-09-28 1.修改连接状态按钮只在读取线程有效
2021-10-02 1.测试连接稳定性
2021-10-02 1.优化程序集中文问题
2021-10-04 1.输出打包是取消优化编码选中,否则程序异常
2021-10-04 1.增加打包合集
2021-10-07 1.重置水槽图标,添加SVG格式
2021-10-09 1.水槽列表样式修改,增加尺寸和设置信息
2021-10-12 1.手稿水槽型号设置界面
2021-10-13 1.UI手稿
2021-10-16 常规保存
2021-10-18 1.手稿,辅助视图
2021-10-27 手稿更新
2021-10-30 1.手稿更新
2021-10-30 1.调整文件位置
2021-10-30 1.删除多余文件
2021-11-05 1.参数弹窗,目录修好
2021-11-10 1.编辑水槽尺寸UI
2021-11-15 1.工艺列表UI编写
2021-11-16 1.增加短边UI
2021-11-17 1.UI编写
2021-11-18 1.增加样式阴影事件
2021-11-20 1.优化逻辑
2021-11-21 1.修改主页按钮
2021-11-22 1.优化弹出逻辑
2021-11-23 1.添加弹窗切换逻辑
2021-11-25 1改进弹窗逻辑
2021-11-26 1.优化技术
2021-11-27 1修改Bug
2021-11-28 1.优化BUG
2021-11-30 1.修改框架暂存
2021-11-30 1.更新MVVM框架,修复BUG
2021-12-01 1.整理框架BUG
2021-12-02 1.Toolkiy框架修改
2021-12-03 1.IOC注入优化
2021-12-04 1.优化弹窗参数传输
2021-12-06 1.工艺弹窗优化数据读取
2021-12-08 1.优化水槽尺寸传输问题
2021-12-09 1.UI优化
2021-12-14 1.控制台UI优化
2021-12-16 1.完成机器状态UI逻辑
2021-12-17 1.传输参数库卡机器人
2021-12-24 UI手稿更新
2022-01-22 重新打包EXE
2022-01-22 主页面UI更新
2022-01-22 添加机器人配合指令
2022-01-22 KUKA_UserTech指令修改
2022-01-22 上位机，添加水槽尺寸主读读取
2022-01-23 kuka偏移参数增加运算
2022-01-23 前端UI 工艺参数列表
2022-01-23 更新界面
2022-01-23 玲_更新UI
2022-01-25 UI更新
2022-01-30 程序编辑UI多部件编写
2022-02-02 更新偏移点UI样式和事件
2022-02-02 清除无用样式
2022-02-07 程序编页面大致完成
2022-02-08 增加机器人指令,偏移值的读取写入
2022-02-09 更新技术文档的存储XMl格式说明
2022-02-10 添加XMl文件
2022-02-11 测试XML
2022-02-15 XML文档格式模板完成
2022-02-17 增加读取水槽数据功能
2022-02-18 读写水槽基本尺寸
2022-02-18 更新安装包文件
2022-02-18 优化工序页面跳转逻辑
2022-02-19 优化工艺逻辑
2022-02-21 添加焊接工艺功能
2022-02-22 优化水槽工艺文件导入失败处理方法，UI工艺传参结构
2022-02-22 增加程序编辑界面参数
2022-02-23 优化水槽属性
2022-02-24 优化工艺偏移点的参数列表
2022-02-24 增加机器人端得参数类型
2022-02-26 增加程序编辑UI的数据获取逻辑
2022-02-27 水槽工艺数据保存XML
2022-02-28 解释接收字符
2022-03-01 增加一次读取得功能，优化注释说明
2022-03-04 特征功能增加循环读取类型
2022-03-04 增加围边工艺方向点的变量名称添加到库卡读取变量表
2022-03-09 优化接收网络异常,增加处理围边工艺方向数据处理
2022-03-12 围边读取点功能完善
2022-03-12 优化主页面UI尺寸,整理围边工艺传输问题
2022-03-14 完善围边工艺保存功能
2022-03-14 更新库卡程序
2022-03-15 更新库卡计算角度错误问题,更新项目安装包
2022-03-19 优化参数传输闪退
2022-03-26 优化添加到传输列表时序
2022-03-31 修改UI草图
2022-04-02 增加网络发生信息
2022-04-07 更新Socket方法
2022-04-08 优化Socket通讯
2022-04-08 更新UI界面效果
2022-04-11 优化连接线程
2022-04-11 视觉界面UI更新
2022-04-19 删除上版本遗留功能
2022-04-20 增加周期发生通讯
2022-04-23 重构Socke
2022-04-27 更新KUKA指令
2022-04-29 重构Sockt发送方法
2022-05-04 修改接收线程方法
2022-05-05 优化循环读取值方法，更新UI数值绑定模式
2022-05-06 重构通讯写入方法
2022-05-07 优化写入字符串格式
2022-05-14 更新KUKA8.6系统指令支持
2022-05-14 Revert "优化写入字符串格式"
    This reverts commit b3c265f3e0ed8ab39cd8fec086e4f2436ec35f34.
2022-05-14 Revert "Revert "优化写入字符串格式""
    This reverts commit 5f6b85624cb1702facc1f6e5f0a3d4bedc31fde9.
2022-05-14 Revert "更新KUKA8.6系统指令支持"
    This reverts commit 0f13facb7c4de6bb2eb9593b5ccb3bc112a6e06e.
2022-05-19 合并主提交
2022-05-21 更新窗口1440*900多分辨率支持，优化UI显示结构和数据显示
2022-05-23 优化工作区显示的信息，更新UI信息
2022-05-24 1.优化UI区域点击效果和多分辨率显示问题
2022-05-25 信息点UI优化分辨率适配
2022-05-25 1.更新打包文件
2022-05-27 1.更细UI细节
2022-05-29 更细UI手稿
2022-06-04 1.更新视角界面UI手稿 2.优化位置点页面布局
2022-06-05 1.优化水槽UI尺寸显示 2.圆弧UI空间修改
2022-06-06 1.更新传输水槽工艺数据 2.等待UI页面重构
2022-06-07 1.通讯字节修改与发生流程
2022-06-08 1.更新双工位数据对接问题
2022-06-10 1.更新库卡变量双工位数据
2022-06-11 1.更新双工位数据格式
2022-06-13 1.更新双工位直接读取发生报文
2022-06-18 1.更新写入文件格式
2022-06-20 1.整理读取数据后保存的先后顺序
2022-06-21 1.更新读取XML内容方法
2022-06-23 1.添加水槽思维导图文件 2.更新业务逻辑记录
2022-06-24 1.更新Xml设置读取方法 2.优化XML模型内容标识
2022-06-25 1.优化了用户步骤记录方法 2.工艺数据修改保存方法
2022-06-25 1.添加水槽加载工作区功能
2022-06-26 1.更新加载工作区UI动画 1.加载水槽工艺数据
2022-06-27 1.更新UI显示逻辑
2022-06-29 1.更新实时读取变量值
2022-06-29 1.更新库卡双工位名称规则
2022-06-30 1.更新静态变量通知显示
2022-07-01 1.优化UI阴影设置参数 2.增加UI显示效果
2022-07-05 1.添加水槽UI手稿
2022-07-06 1.新增水槽添加列表UI 2.优化UI空间显示效果
2022-07-07 1.增加水槽后台数据功能
2022-07-08 1.水槽列表输入逻辑更改 2.UI界面全局颜色分类
2022-07-09 1.更新水槽UI
2022-07-11 1.处理库卡文件名
2022-07-11 1.更新库卡UserText文件细节
2022-07-11 1.继续优化设置水槽界面问题 2.修改打包程序参数
2022-07-12 1.修理修改水槽尺寸UI逻辑问题
2022-07-12 1.更新打包安装文件 2.修复保存文件问题
2022-07-12 1.增加UI版本号
2022-07-13 1.更新安装包使用序列号安装 2.更新库卡文件计算角度异常问题
2022-07-13 1.更新安装包参数
2022-07-14 1.更新取消按钮闪退问题 2.更新版本号同步问题
2022-07-15 1.短边UI界面错位修改 2.新增短边工艺读取方法
2022-07-16 1.增加短边工艺发送 2.增加短边工艺修改与保存功能
2022-07-16 1.更新库卡指令支持短边工艺
2022-07-18 1.更新短边焊接工艺 2.更新库卡指令格式 3.更新安装包
2022-07-19 1.更新库卡短边命令回拉填孔计算点
2022-07-21 1.增加UI界面加载条件显示 2.修改库卡指令问题
2022-07-22 1.添加ioc图标文件 2.增加开始页面状态页面
2022-07-23 1.UI更新手稿
2022-07-26 1.更新UI界面逻辑
2022-07-27 1.更新安装包内容 2.更新UI状态属性显示
2022-07-28 1.更新模板Xml文件格式 2.更新传输页面状态UI 3.更新解压包版本
2022-07-30 1.更新手稿UI
2022-08-01 1.更新库卡指令短边兼容其他类型焊接位置
2022-08-02 1.UI更新
2022-08-03 1.更新库卡短边焊接计算逻辑
2022-08-03 1.更改短边指令细节问题
2022-08-05 1.更新UI手稿
2022-08-08 1.更新库卡指令
2022-08-08 1.更新安装包版本
2022-08-09 1.更新读取库卡变量名
2022-08-25 1.增加视觉流程文档
2022-08-26 1.增加视觉页面的测试
2022-08-27 1.更新视觉逻辑流程图
2022-08-30 1.视觉UI更新
2022-08-31 1.MVVM框架更新，引用位置命名空间修改 2.视觉UI手稿更新 3.相机SDK连接测试
2022-09-01 1.UI视觉界面手眼标定页面更新
2022-09-01 1.UI手稿更新
2022-09-02 1.各功能UI手稿画好
2022-09-02 1.Halcon控件更新
2022-09-03 1.更新视觉UI界面 2.优化日志显示 3.优化颜色资源同意存放
2022-09-03 1.更新视觉UI侧围栏控件
2022-09-05 1.视觉页面部分UI界面样式
2022-09-06 1. 相机UI设置参数完成 2.相机UI九点标定完成二页 3.增加图标
2022-09-07 1.创建模板UI页面 2.添加数据更新文件
2022-09-08 1.创建模板功能UI完成 2.新建ViewModel数据文件
2022-09-08 1.新增自动模式UI参数页面
2022-09-09 1.开始测试相机连接功能
2022-09-12 1.添加海康威视SDK引用
2022-09-12 Revert "1.添加海康威视SDK引用"
    This reverts commit 6259fe27e8243d17c92ccbcb0e2b1bef6cf34e39.
2022-09-12 1.更改项目框架错误问题
2022-09-12 1.优化程序初始化时，控件加载卡顿问题
2022-09-13 1.开始进行相机功能编写
2022-09-14 1.测试相机采集功能
2022-09-15 1.新增海康sdk转halcon图像变量
2022-09-16 1.增加相机单帧获取方法
2022-09-16 1.添加相机SDK引用库文件
2022-09-16 1.添加Halcon SDK文件
2022-09-16 1.增加Halcon控件sdk引用文件
2022-09-17 1.修复相机单帧读取时居中问题
2022-09-19 1.UI TEXTBOX控件数值更改事件添加
2022-09-20 1.增加海康相机参数设置枚举名称
2022-09-21 1.优化相机采集逻辑
2022-09-22 1.更新相机参数UI单位数值
2022-09-23 1.优化UI页面数据更新
2022-09-26 1.优化相机参数设置和获取功能
2022-09-27 1.修改图像逻辑操作
2022-09-27 1.项目名称整理
2022-09-27 1.项目框架文件梳理
2022-09-27 1.整理文件位置
2022-09-27 1.整理文件删除
2022-09-27 1.添加使用文档
2022-09-27 1.新增Halcon项目，优化项目解耦
2022-09-28 1.解耦关联引用 2.文件同意引用文件
2022-09-28 1.添加各功能SDk
2022-09-28 1.修改功能名称
2022-09-28 1.修改库卡通讯值回调方法
2022-09-28 1.更新库卡指令 2.移动文件位置
2022-09-28 1.更新安装文件位置
2022-09-28 1.库卡变量表格更修问题
2022-09-29 1.优化耦合关系,解决模块之间关系
2022-09-30 1.焊接工艺UI加载状态修复 2.Halcon加载差错修复
2022-09-30 1.添加海康卫视相机运行SDK依赖
2022-09-30 1.增加相机配置文件
2022-09-30 1.更新系统变量信息
2022-10-08 1.删除多余DLL 2.优化相机DLL功能
2022-10-09 1.相机测试页面模块功能完成
2022-10-10 1.优化Halcon控件初始化赋值
2022-10-11 1.更新创建模板方法 2.新增Halcon模型文件
2022-10-16 1.更新获取帧方法优化 2.增加采集方式选择和图片地址加载
2022-10-20 1.更新Halcon窗体控件控件触发
2022-10-21 1.增加直线圆弧特征点显示创建XLD
2022-10-22 1.新增删除对应xld对象,显示重新刷新
2022-10-22 1.更新创建模板类型 2.更新创建模型UI参数
2022-10-24 1.创建模板界面参数形状选择不同类型参数 2.增加选择文件夹功能
2022-10-25 1.优化删除Halcon生成xld对象细节 2.新增匹配模型保存
2022-10-26 1.添加模板默认文件路径加载 2.增加常规和局部模型文件识别
2022-10-27 1.优化查找匹配模型方法
2022-10-28 1.新增识别位置数据显示
2022-10-28 1.更新九点标定图像采集功能
2022-10-29 1.封装查找九点标定图像方法
2022-11-01 1.所有项目更新项目版本
2022-11-02 1.添加库卡通讯必须软件包
2022-11-02 1.kuka服务端通讯流程梳理
2022-11-04 1.添加库卡通讯功能
2022-11-07 1.增加kuka查找位置通讯
2022-11-07 1.更新库卡通信文件连接问题
2022-11-08 1.优化kuka通讯拍照失败停止操作
2022-11-09 1.增加库卡直线方程算法
2022-11-10 1.优化kuka计算位置点算法
2022-11-12 1.修改库卡位置点计算方式
2022-11-16 1.kuka通信增加圆弧短边的焊接位置接收
2022-11-16 1.开发上位机服务器功能
2022-11-18 1.回退修复文件大小问题
2022-11-19 1.优化通讯格式兼容性 2.优化UI网络显示状态
2022-11-20 1.标定功能通讯完成 2.优化UI显示问题 3.修复通讯错误
2022-11-21 1.视觉标定优化 2.机器人通信显示优化
2022-11-21 1.更新库卡通信细节问题
2022-11-21 1.更新安装包
2022-11-23 1.更新页面逻辑切换 2.新增软件启动查找连接相机 3.新增通讯内容显示
2022-11-24 1.更新主页面显示逻辑
2022-11-24 1.新增启动连接相机,关闭断开相机连接
2022-11-25 1.更新界面显示细节 2.下位机程序修改 3.增加通讯协议查看和选择
2022-11-25 1.更新优化UI细节
2022-11-26 1.优化查找模板参数 2.优化UI逻辑显示
2022-11-27 1.常规更新
2022-11-28 1.优化枚举类型绑定UI层
2022-11-28 1.整理获取图像方法整合
2022-11-29 1.修复创建模型bug中，分离读取模型文件反法出来
2022-11-30 1.创建模板功能优化。2.UI操作逻辑限制
2022-12-01 1.优化识别图像流程
2022-12-02 1.模板匹配功能优化
2022-12-03 1.更新UI显示 2.相机参数修正
2022-12-03 1.新增相机参数读取功能
2022-12-03 1.修复相机功能
2022-12-04 1.新增相机参数读取，修复各类型读取2.进行IP读取解析
2022-12-05 1.修复相机信息显示有错 2.查找模块功能开发中
2022-12-05 1.增家视觉参数文件xml读写功能
2022-12-05 1.优化多处地方性能 2.开发查找模板功能中
2022-12-05 1.更新库卡通信错误细节
2022-12-06 1.修复相机设置BUG 2. 修复通讯错误信息
2022-12-06 1.更换Point属性为Point3D,2.修改一下点获得
2022-12-07 1.修改Point类似伟Point3D 2.修复控件显示问题
2022-12-07 1.调整库卡指令参数
2022-12-08 1.参数列表添加新增删除功能添加优化
2022-12-08 1.修复读取写入功能问题 2.UI显示不正常修复
2022-12-09 1.更新库卡计算焊接点
2022-12-09 1.打包安装包测试
2022-12-09 1.修复自动模式UI数据 2.视觉矩阵文件错误没有提示
2022-12-10 1.修复标定识别默认参数 2.增加图像模式id号功能加载和工作区域预设功能 3.识别拍照位置存档和计算便宜开发
2022-12-13 1.模型UI显示逻辑优化 2.模式名称改写 3.后端逻辑修改需要
2022-12-17 1.更新视觉模型参数到与水槽属性融合 2.更新xml读取问题
2022-12-18 1.优化读取模型文件逻辑
2022-12-19 1.修改库卡拍照点根据不同型号尺寸修改 2.修改通讯格式
2022-12-19 1.正在修改库卡实时通讯协议界面逻辑
2022-12-20 1.迁移第三方协议功能
2022-12-21 1.删除沉淀文件 2.修复协议为通讯问题
2022-12-21 1.协议为同讯增加互锁
2022-12-22 1.更新参数读取方式2.删除无用文件 3.服务器通讯一体化启动
2022-12-23 1.优化UI显示逻辑 2.更新库卡文件
2022-12-23 1.更新库卡8.6版本指令显示参数
2022-12-24 1.修复指令接收错误问题
2022-12-24 1.库卡指令修改不同尺寸偏移值
2022-12-24 1.修复水池数据保存无效果2.kuka通讯指令计算错误修复 3.常规修复bug
2022-12-26 1.解决库卡指令圆弧补偿错误问题
2022-12-26 1.增加全局参数文件设置 2.优化保存读取xml文件逻辑 3.UI页面优化 4.增加查找模型超时设置
2022-12-26 1.修理全局识别次数计算误差功能
2022-12-27 1.增加查找错误重复采集次数功能
2022-12-27 1.修复通讯连接断开错误显示
2022-12-28 1.增加图标UI显示,识别误差实时显示
2022-12-28 1.添加实时图标文档
2022-12-29 1.尝试修复UI更新位置
2022-12-29 1.测试实时图标更新问题
2022-12-30 1.更新实时图表显示 2.UI更新优化
2022-12-31 1.修复画面问题
2023-01-03 1.图表功能完善 2.图表显示隐藏UI改善中
2023-01-04 1.测试图标视觉误差效果 2.修复图表UI显示无效问题中
2023-01-05 1.修复视觉误差图表显示问题 2.修复识别超时结束程序问题 2.库卡指令增加显示误差显示提醒 3.增加超过误差停止运行功能 4.优化库卡指令文件名称
2023-01-05 1.添加运行识别错误提示
2023-01-07 1.优化运行稳定性
2023-01-10 1.更新安装包 2.优化运行内存过大问题
2023-02-07 1.更新库卡指令 2.优化图像边缘识别
2023-02-08 1.添加视觉参数配置 2.更新库卡通讯协议 3.优化库卡指令格式
2023-02-09 1.更新数据优化
2023-02-26 1.更新库卡焊接指令名称2.修改水槽页面名称错误
2023-02-27 1.视觉功能UI增加
2023-02-27 1.测试菜单栏功能
2023-02-28 1.修改合并 2.添加全局设置设置 3.增加图像保存本地选项
2023-02-28 1.优化图标显示逻辑 2.优化机器人状态图标显示
2023-03-06 1.整理库卡通讯文件
2023-03-07 1.修改标定功能增加 2.添加协议接收功能。
2023-03-08 1.修复标定算法参数无效 2.修改标定采集方法 3.修复库卡标定指令和参数
2023-03-11 1.修复库卡指令通讯失败问题
2023-03-11 1.更新安装包安装失败问题
2023-03-13 1.视觉UI页面合理优化布局
2023-03-13 1.增加误差图标功能
2023-03-13 1.整理图标绑定数据来源
2023-03-14 1.更新压缩包 。2.修复计算误差错误问题
2023-03-15 1.增加库卡指令功能 2.修复主窗口全屏显示不全 3.优化图标显示问题
2023-03-16 1.修复UI显示版号
2023-03-17 1.查找模型增加边缘处理方法 2.优化UI显示格式 3.增加查找模式参数
2023-03-27 1.添加Halcon样图测试工程文件
    [模板.dxf]
2023-03-27 1.更新Halcon测试程序
2023-03-28 1.完善ncc模式识别
2023-03-28 1.降低预处理值参数
2023-03-29 1.新增预处理方法分开 2.UI参数增加 3.Halcon方法优化
2023-03-30 1.增加创建ncc匹配模型功能 2.dxf文件保存 3.模型文件读取区分
2023-03-31 1.优化读取模型文件和写入文件逻辑
2023-03-31 1.增加ncc算法模型匹配
2023-04-01 1.更新读取模型文件
2023-04-03 1.更新ncc读取保存流程
2023-04-04 1.计算矩阵算法有问题,进行优化
2023-04-04 1.自动保存
2023-04-06 1.修复计量单位错误问题 2.修复保存模型名称问题 3.增加程序运行状态消息显示框架
2023-04-06 1.修复算子状态显示 2.正在修复创建模型数据显示处理
2023-04-07 1.修复XLD数据集合 2.修复xld集合问题
2023-04-08 1.修复xld类型创建显示问题 2.迁移临时存储xld变量位置
2023-04-08 1.修复Halon文件读取异常问题修复
2023-04-08 1.更新提取不用匹配类型结果xld类型顺序问题
2023-04-08 1整理流程优化
2023-04-09 1.增加异步线程控制图像识别时间
2023-04-10 1.修复线程超时问题
2023-04-10 1.读取模型文件有问题，需要处理。
2023-04-11 1.重构读取模型文件方式，优化读取大型模型文件卡顿问题
2023-04-12 1.修复库卡指令无法应用基本参数
2023-04-12 1.增加误差报表显示头目
2023-04-13 1.修复读取机器人当前工艺状态错误问题 2.优化数据更新问题
2023-04-13 1.修复功率显示单位错误 2.优化数据显示
2023-04-13 1.修改文件最后保存时间 2.优化圆弧显示异常问题
2023-04-14 1.更新完整版本 2.优化库卡指令焊接功率支持
2023-04-15 1.更新坐标信息页面布局和参数限制。2.重新打包安装包
2023-04-17 1.更新文件位置
2023-04-17 1.更新8.6版本配置文件。2.更新库卡选型包
2023-04-18 1.修改库卡配置文件
2023-04-18 1.删除多余多余文件 2.修改库卡指令
2023-04-18 1.添加数据误差数据保存功能
2023-04-20 1.增加汉高logo和界面
2023-04-21 1.增加误差数据xml格式保存
2023-04-25 1.添加kuka协议外6.1版本 2.修复kuka旧程序
2023-04-25 1.修复库卡指令单位异常卡屏
2023-04-25 1.修复库卡各版本指令语法兼容问题
2023-04-25 1.修复字体显示 2.修复库卡指令
2023-04-26 1.增加非托管内存
2023-04-27 1.库卡指令刘福标定拍照位置存储问题、相机偏移问题 2.修复UI显示通知问题 2.更新细节问题
2023-04-28 1.修复UI换型号旧数据遗留问题
2023-04-28 1.修改内存暴涨问题
2023-04-29 1.常试修复Halcon读取慢得问题
2023-04-30 1.该版本后修改为序列化读取写入
2023-04-30 1.ncc模型序列化读取写入
2023-05-02 1。Halcon解耦方式重构
2023-05-03 1.修复问题
2023-05-04 1.优化Halcon非托管内存清理问题
2023-05-04 1.常规保存
2023-05-05 1.匹配模型预读到内存 2.修复通讯卡顿问题
2023-05-05 1.修复偏移数据混乱
2023-05-07 1.打包安装文件记得复制行x64文件，图表文件libHarfBuzzSharp.dll编译回出错
2023-05-07 1.更新软件图标
2023-05-07 1.更新软件设置图标问题
2023-05-07 1.更新MVVM工具包版本
2023-05-07 1.更新安装打包文件
2023-05-07 1.修复读取数据异常 2.重构产品文件类型
2023-05-07 1.修复坐标数据错乱清空
2023-05-07 1.修复页面错误
2023-05-07 1.修复页面
2023-05-08 1.修复图标显示区域错误
2023-05-13 1. 增加数字上下调整
2023-05-18 1.优化图标文件 2.增加数字增减功能
2023-05-20 1.修复出现图像识别不到就保存图像 2.参数修改界面增加数字增减
2023-05-20 1.优化识别错误图像保存 2.更新安装包
2023-05-22 1.添加外部窗口到软件内
2023-05-23 1.测试嵌入外部软件
2023-05-24 1.取消嵌入窗口功能 2.修复查找视觉序号显示问题
2023-05-24 1.重新优化消息弹窗页面 2.优化视觉查找错误提示
2023-05-27 1.更新库卡多工位模板程序 2.修复标定位置未能修改问题
2023-05-29 1.整理代码空格和注释
2023-06-06 1.优化相机参数兼容问题，2.修复相机参数卡顿问题
2023-06-06 1.修复程序关闭相机未断开
2023-06-10 1.梳理标定文件 2.重新生产标定文件
    [模板.dxf]
2023-06-12 1.增加标定板文件
2023-06-14 1.增加立体视觉相关资料
2023-06-16 1.更新
2023-06-19 1.升级框架.net6 2.旧线程结束弃用，需要更新Task方法停止
2023-06-19 1.更新Task方法结束线程
2023-06-19 1.测试Task强制结束
2023-06-19 1.halcon测试文件更新
2023-06-19 1.halcon标定文件转移
2023-06-20 1.新增新Halcon标定板示例
2023-06-20 1.新增可视化标定示例
2023-06-21 1.新增创建三维重建示例
2023-06-21 1.三维重建示例更新
2023-06-21 1.三维重建示例程序修改
2023-06-21 1.更新内容
2023-06-24 1.修改示例
2023-06-26 1.保存示例
2023-06-27 1.示例更新
2023-06-27 1.更新示例
2023-06-30 1.增加单目标定图像
2023-06-30 1.整理文件
2023-07-04 1.修改Halcon库文件位置 2.单文件输出打包
2023-07-04 1..net压缩文件打包
2023-07-06 1.修正标定板文件名称规格
2023-07-14 1.更新23.05版本
2023-07-19 1.更新逻辑
2023-07-21 1.新增单目标定流程示例
2023-07-21 1.更新流程思维导图 2.更新手眼标定示例程序
2023-07-23 1.更新流程图
2023-07-25 1.更新示例程序
2023-07-25 1.更新流程
2023-07-27 1.更新双目手眼标定示例
2023-07-28 1.更新UI布局
2023-07-29 1.UI布局更新
2023-07-31 1.更新UI控件布局
2023-08-01 1.更新UI界面
2023-08-05 1.更新UI图标 2.新增标定页面
2023-08-06 1.更新标定内参UI画面 2.新增标定参数空间 3. 更新UI细节
2023-08-08 1增加相机SKD说明文档
    [工业相机SDK可配置化参数表.xlsx]
2023-08-09 1.更新海康SDK版本
2023-08-10 1.更新海康SDK相机连接流程
2023-08-10 1.修复SDK运行消息显示问题
2023-08-11 1.修复设置显示显示问题 .2改善参数设置
2023-08-11 1.增加显示界面切换 2.主参数设置相机
2023-08-12 1.更新BUG
2023-08-14 1.区分消息显示分区
2023-08-15 1.Halcon控件分区细分
2023-08-17 1.更新绑定显示
2023-08-19 1.更新相机驱动
2023-08-21 1.更新标定模型和UI
2023-08-22 1.更新用户控件依赖属性功能
2023-08-23 1.选择文件或者文件夹依赖属性设置完成
2023-08-23 1.修改多余文件
2023-08-23 1.新增Halcon标定参数
2023-08-24 1.更新图像取流功能
2023-08-29 1.更新控件显示
2023-08-30 1.新增标定图像 2.新增坐标显示
2023-09-01 1.更新显示
2023-09-01 1.更新读取图片
2023-09-02 1.标定图像选中显示
2023-09-04 1.更新Menu控件显示
2023-09-05 1.更新标定识别算法方法 2.优化显示保存图像识别图像方法
2023-09-05 1.更新方法注释
2023-09-06 1.增加标定数据最后整理和标定计算
2023-09-08 1.新增三维可视化显示
2023-09-08 1.增加获取标定板位置与三维数据
2023-09-09 1.更新包 2.增加三维模型生成
2023-09-10 1.更新模型读取方式
2023-09-12 1.测试官方三维可视乎
2023-09-13 1.新增可视化三维库
2023-09-14 1.更新文件
2023-09-14 1.更新VTK库复制文件
2023-09-15 1.测试内存流读取
2023-09-16 1.更新VTK版本 2.更新Halcon显示控件
2023-09-16 1.Halcon可视化完成
2023-09-16 1.编译完成
2023-09-16 1.增加VTK库文件
2023-09-18 1.可视化更新
2023-09-18 1.更新Halcon可视化行性能
2023-09-18 1.自定义Halcon可视化
2023-09-19 1.新增ModubusTCp通讯
2023-09-19 1.重写Halcon可视化
2023-09-20 1.更新测试
2023-09-21 1.删减可视乎代码
2023-09-25 1.自定可视化
2023-09-27 1.更新为控制世界坐标显示
2023-09-28 1.保存
2023-09-28 1.更新鼠标可视化事件
2023-09-28 1.修改窗口缩放显示问题
2023-10-02 1.更新可视化
2023-10-03 1.更新可视乎
2023-10-03 1.增加VTK包
2023-10-03 1.问题依旧
2023-10-03 1.增加渲染图像限制帧率
2023-10-04 1.更新注释
2023-10-04 1.增加可视化平移功能
2023-10-04 1.可视化更换对面模式
2023-10-05 1.修改更新
2023-10-05 1.更新可视化属性修改
2023-10-07 1.增加图标文件
2023-10-07 1.更新图标LOGO文件
2023-10-09 1.更新和谐版VTK
2023-10-09 1.增删功能
2023-10-11 1.测试标定结果显示
2023-10-13 1.更新位置
2023-10-14 1.更新相机初始化单位小数
2023-10-16 1.更新相机模型显示生成
2023-10-16 1.修改相机模型
2023-10-17 1.更新DLL文件
2023-10-17 1.增加图片 2.修改xld显示位置
2023-10-17 1.增加文件加载功能
2023-10-18 1.更新检测标定板
2023-10-18 1.标定保存
2023-10-19 1.分离标定相机方法
2023-10-19 1.对象模型不能跨项目
2023-10-20 1.修复文件标定方法
2023-10-21 1.增加双目图像 2.修复标定流程 3.双目标定创建有异常
2023-10-22 1。增加相机初始化UI
2023-10-22 1.测试双面标定计算相机位置
2023-10-23 1.更新异常错误显示问题
2023-10-23 1.修改报错信息 2.弹窗功能
2023-10-24 1.增加操作错误报错 2.标定检测功能去除测试
2023-10-25 1.更新相机在线状态
2023-10-26 1.修改相机连接读取相机内参功能 2.主相机设置显示到标定窗口有BUG，简易修改为标定窗口显示图像方式，用Message方式传递，Binding到窗口
2023-10-26 1.需要优化窗口关闭内存清理问题
2023-10-26 1.更新UI草稿
2023-10-27 1.优化内存使用
2023-10-27 1.优化内存
2023-10-27 1.测试图像存储增加问题
2023-10-28 1.更新标定页面
2023-10-29 1.更新界面和logo
2023-10-31 1.更新sdk
2023-11-03 1.调整标定文件 2.修改UI 3.增加手眼相机设备选择
2023-11-04 #720 增加库卡机器人通讯测试修改内容
2023-11-04 1.机器人配置
2023-11-06 1.更新KUKA
2023-11-07 1.更换上位机服务器模式
2023-11-08 1.更新标定库卡指令
2023-11-09 1.更新库卡通讯协议
2023-11-11 1.更新手眼标定UI 2.库卡指令
2023-11-13 1.更新手眼标定方法
2023-11-13 1.更新标定方法对象
2023-11-14 1.库卡通讯接收初始化任务
2023-11-14 1.库卡通讯格式接收
2023-11-15 1.更新UI逻辑
2023-11-16 1.更新手眼标定UI逻辑显示
2023-11-16 1.增加本地模式添加图片
2023-11-17 1.更新手眼标定图像导入方法
2023-11-18 1.增加模型文件
2023-11-18 1.更新官方示例方法
2023-11-19 1.增加版本号管理
2023-11-20 1.更新标定
2023-11-21 1.优化机器人TCP模型显示中心问题
2023-11-21 1.增加官方检测示例
2023-11-22 1.更新内参相机UI
2023-11-23 1.更新相机内参UI和逻辑 2.哈哈哈
2023-11-24 1.修复相机选中问题
2023-11-27 1.修复相机内参标定方法和UI
2023-11-27 1.优化三维模型显示问题
2023-11-28 1.更新优化文件结构
2023-11-28 1.添加相机标定内参UI操作报错提示
2023-11-29 1.更新优化相机内参标定流程报错
2023-11-29 1.更新文件内容
2023-11-30 1.更新手眼UI显示标定板位置
2023-11-30 1.优化手眼标定过程
2023-12-01 1.更新手眼识别逻辑
2023-12-01 1.更新2311版本DLL
2023-12-01 1.本地调试
2023-12-04 1.更新库卡手眼标定
2023-12-04 1.增加手眼标定参数
2023-12-05 1.增加标定结果数据显示和保存
2023-12-06 1.更新不同标定方法的读取结果参数
2023-12-07 1.增加结果读取参数
2023-12-07 1.更新标定结果信息显示
2023-12-07 1.更新手眼页面显示
2023-12-08 1.更新手眼UI数据读写功能保存
2023-12-08 1.更新官方手眼抓取
2023-12-09 1.增加官方示例测试数据
2023-12-09 1.增加手眼标定手相机三维模型创建
2023-12-11 1.更新指令
2023-12-13 1.更新官方示例
2023-12-14 1.更新报错信息
2023-12-14 1.更新通讯接受处理内容
2023-12-16 1.更新位置点类型
2023-12-19 1.更新标定输入坐标类型
2023-12-19 1更新相机参数设置问题
2023-12-19 1.更新测试程序
2023-12-20 1.更新库卡旋转方向的顺序
2023-12-20 1.更新实机图片
2023-12-20 1.更新显示角度旋转方向
2023-12-21 1.更新通讯协议内容显示 2.更新图像内存存储优化 3.标定板选择读取方式优化 3.增加标定板厚度设置
2023-12-21 1.更新库卡标定指令 2.增加接收标定板位置移动 3.需要合并通讯标定和收到表达方法
2023-12-21 1.更新优化
2023-12-22 1.更新切换设备变量异常 2.更新手眼标定结果UI显示单位 3.优化手眼标定流程
2023-12-22 1.更换弹窗的调度优先 2.更新三维显示多线程显示
2023-12-22 1.增加测试文件
2023-12-24 1.测试算法
2023-12-29 1.增加测试样图 2.增加相机内参
2024-01-04 1.更新ABB通信资料
2024-01-05 1.跟新ABB通信指令
2024-01-07 1.新增ABB通信资料
2024-01-07 1.更新软件包
2024-01-07 1.跟新ABB通信协议
2024-01-08 1.增加NULL检查类型 2.重新梳理通信结构协议 3.通信协议对接
2024-01-09 1.修改协议拓张功能 2.通信协议接收发送数据显示格式
2024-01-09 1更新ABB配置文件
2024-01-09 1.更新三维显示默认模型
2024-01-09 1.更新ABB旋转顺序
2024-01-09 1.增加ABB发送协议
2024-01-09 1.更新ABB标定程序
2024-01-10 1.更新ABB通讯接发协议 2.ABB标定指令更新
2024-01-10 1.优化重复事件订阅
2024-01-11 1.增加案例测试
2024-01-12 1.合并界面
2024-01-12 1.视觉工艺功能整个界面 2.修改相机对象功能
2024-01-13 1.视觉页面整个功能
2024-01-13 1.增加图像处理工艺流程功能 2.增加图像处理UI显示 3.优化程序结构
2024-01-14 1.更新UI初稿方案
2024-01-14 1.更新UI
2024-01-16 1.更新UI界面变量赋值 2.更新增加流程算法 3.优化图像处理
2024-01-16 1.增加流程处理排序
2024-01-17 1.跟新新相机SDK 2.增加运行环境包 3.修改图像显示UI
    [工业相机SDK可配置化参数表.xlsx]
2024-01-17 1.删除超大文件
2024-01-18 1.更新相机通讯问题
2024-01-18 1.优化图像回调GC优化问题 2.设置全局启动版本
2024-01-19 1.修改图像预处理流程应用
2024-01-19 1.增加创建模板UI 2.修复流程时间问题
2024-01-20 1.更新工艺模型创建模板
2024-01-20 1.优化十字坐标模型生成方法 2.优化创建模式方法 3.更新UI显示
2024-01-21 1.增加工艺选择 2.工艺特征描述选定 3.UI优化布局
2024-01-21 1.修改生产直线xld方法
2024-01-22 1.更新UI操作 2.更新模型创建方法 3.更新模型面向对象方式 4.固定保存模型位置 5.修改个别变量名称
2024-01-23 1.更新创建模型所需参数 2.相机内参手眼标定文件读取 3.创建模型方法优化 4.创建模型参数枚举增加 5.增加二维三维原点UI输入界面 6.参数文件读取修改
2024-01-27 1.增加三维点显示
2024-01-28 1.修改三维显示方法 2.修改界面显示逻辑 3.增加三维显示页面 4.修改图像矫正功能
2024-02-07 1.修改主页面UI格式 2.修改机器人通讯协议 3.优化通讯修理 3.优化机器人通讯协议逻辑
2024-02-08 1.修改abb配置文件 2.修改相机配置文件夹读取 3.修改逻辑
2024-02-10 1.更新ABB机器人通讯发送指令
2024-02-12 1.增加协议解释 2.增加本地监听地址 3.更新ABB协议读取问题 4.更新UI显示位置点
2024-02-12 1.更新UI坐标显示类型区分2.增加点类型设置3.更新ABB通讯测试
2024-02-18 1.更新模型变换方法 2.更新UI功能显示
2024-02-19 1.修改相机参数设置顺序 2.修改相机逻辑
2024-02-19 1.修改图像校正流程
2024-02-20 1.更新修改代码
2024-02-20 1.修改ABB通讯协议 2.通讯流程 3.修改ABB端程序 3.增加样图数据
2024-02-21 1.增加资料文件 2.增加位置模型显示 3.优化点位转换 3.修改机器人旋转顺序
2024-02-21 1.增加样图
2024-02-22 1.更新ABB项目内容
2024-02-22 1.增加图像校正功能
2024-02-23 1.更新保存
2024-02-26 1.更新平面模型区域生成
2024-02-27 1.增加本地调试
2024-02-29 1.测试模型生成问题
2024-03-01 1.更新模型错误问题 2.修改字典读写共
2024-03-03 1.字典方法保存 2.本地标定文件
2024-03-04 1.更新读取文件方法
2024-03-05 1.增加读取文件字典
2024-03-06 1.修复读取文件覆盖问题
2024-03-06 1.更新模型UI显示
2024-03-08 1.修复UI绑定值错误问题 2.修改保存模型偏移问题
2024-03-09 1.跟新模型查找方法
2024-03-10 1.修复创建模型xld位置重合问题
2024-03-11 1.UI参数修改
2024-03-14 1.修复功能预判提示 2.增加匹配模型平面坐标 3.修改
2024-03-15 1.增加匹配模型图像坐标转换
2024-03-15 1.增加UI校正系数显示位置
2024-03-19 1.增加UI系数显示和保存
2024-03-19 1.修复字典文件，数据添加 2.读取字典数据修改
2024-03-20 1.修改标定系数
2024-03-21 1.优化匹配模型的坐标
2024-03-22 1.优化识别流程
2024-03-22 1.优化UI显示问题 2.优化匹配参数保存功能
2024-03-23 1.优化XML文件读取 2.优化UI显示
2024-03-24 1.查找参数、图像参数、系统配置参数整合
2024-03-25 1.优化视觉参数保存文件的序列化
2024-03-25 1.正在优化xml文件优化问题
2024-03-26 1.更新读写XML文件
2024-03-27 1.软件启动读取参数文件，进行初始化流程
2024-03-27 1.修复相机标定文件 2.修复未标定相机参数读取 3.新增相机内参
2024-03-27 1.kuk指令手眼标定更新 2.统一UI风格
2024-03-27 1.统一通讯格式 2.修复通讯端口冲突问题 3.修复BUG
2024-03-27 1.KUKA增加创建视觉平面功能 2.更新模型创建方法
2024-03-28 1.增加启动选定参数相机 2.保存文件
2024-03-28 1.规范通讯协议格式 2.修复错误 3.更新指令
2024-03-28 1.修改库卡指令
2024-03-28 1.优化指令
2024-03-29 1.更新KUKA指令
2024-03-31 1.增加样图 2.修改库卡指令
2024-04-01 1.跟新库卡指令
2024-04-01 1.更新库卡指令 2.算法优化
2024-04-03 1.更新坐标转换问题
2024-04-03 1.修复坐标变换计算 2.增加原点显示 3.优化模型特性生成顺序关系 4.考虑增加根据实际位置设置模型原点
2024-04-05 1.增加库卡资料 2.修改平面坐标位置
2024-04-05 1.更新UI显示优化
2024-04-05 1.更新本地识别
2024-04-05 1.图像坐标转换世界坐标验证成功
2024-04-05 1.提高校正图像精度
2024-04-06 1.优化实时图像逻辑问题
2024-04-07 1.更新匹配识别流程 2.优化逻辑
2024-04-08 1.更新库卡指令 2.优化匹配逻辑
2024-04-08 1.修复计算结果处理 2.更新库卡指令显示
2024-04-09 1.更新三维显示功能 2.优化保存参数细节
2024-04-09 1.修改坐标点计算 2.修复错误
2024-04-09 1.增加匹配拍照次数限制 2.修复匹配时间超时停止
2024-04-09 1.修改库卡计算指令
2024-04-09 1.优化库卡多余指令
2024-04-09 1.更新接受通信显示功能
2024-04-09 1.优化IDE建议
2024-04-09 1.修复弧度转角度问题 2.需要修改库卡指令位置点计算
2024-04-10 1.更新指令逻辑 2.优化计算位置点
2024-04-10 1.更新通讯协议
2024-04-10 1.修改坐标点偏移计算
2024-04-11 1.修改标定坐标保存和读取
2024-04-11 1.修改
2024-04-11 1,.更新库卡指令
2024-04-11 1.图像丢失问题
2024-04-12 1.修复DC过早删除问题
2024-04-12 1.更新内存泄露 2.增加标定数据覆盖 3.库卡指令修复
2024-04-13 1.优化库卡标定流程
2024-04-14 1.增加姿态转换
2024-04-14 1.修复库卡机器人的姿态转换问题 2.增加匹配文件机器人类型, 3.优化坐标计算顺序问题
2024-04-14 1.模型文件读取失败修复 2.相机链接异常修复 3.修复标定数据更改问题
2024-04-17 1.更新kuka测试模式
2024-04-17 1.更新 2.BUG读取校正图像
2024-04-18 1.修复
2024-04-18 1.查找内存问题
2024-04-18 1.修复BUG
2024-04-20 1.检查内存使用情况
2024-04-22 1.更新内存状态
2024-04-24 1.修复Read内存错误
2024-04-26 1.修复Map算入传入图像尺寸大小
2024-04-26 1.增加Map校正检测
2024-04-27 1.增加校正图像校正识别尺寸，可强制缩放尺寸校正
2024-04-28 1.增加查找方法的校正设置
2024-04-29 1.更新Map生成图像问题修改
2024-04-29 1.优化KUKA指令偏移选项 2.优化校正位置点修复
2024-05-04 1.更新结果显示 2.增加样图测试
2024-05-05 1.更新自动化模式结果轮播显示
2024-05-07 1.更新页面错误 2.增加标定位置点显示图像中
2024-05-08 1.增加坐标显示功能
2024-05-09 1.更新标定位置显示逻辑 2.增加标定数据样本
2024-05-09 1.优化坐标点显示
2024-05-09 1.修复相机实时模式与采集模式冲突问题 2.修复结果显示图像错误问题
2024-05-13 1.增加三维程序样图
2024-05-14 1.前期验证测试流程
2024-05-15 1.测试HDR流程
2024-05-16 1.更新HDR方法
2024-05-20 1.增加双目标定测试精度
2024-05-22 1.增加点云测试文件
2024-06-11 1.更新版本2405 2.增加双目UI
2024-06-11 1.更新双面流程
2024-06-12 1.优化UI页面流程逻辑
2024-06-13 1.增加优化2D+三维结合
2024-06-19 1.更新点云生产流程 2.生产三角面
2024-06-21 1.更新图像采集集合
2024-06-22 1.跟新标定相机
2024-06-24 1.更新测试采集
2024-06-25 1.更新程序
2024-06-29 1.更新KUKA焊接指令
2024-07-01 1.更新相机初连接错误问题
2024-07-02 1.更新点位置
2024-07-04 1.增加校正平面功能
2024-07-05 1.更新标定转换系数方法
2024-07-06 1.增加其他算法技术系数
2024-07-08 1.增加匹配文件
2024-07-09 1.增加匹配计算
2024-07-10 1.更新算法显示
2024-07-15 Update README.md
    ~更新消息
2024-07-16 1.更加配准过程测试
2024-07-17 1.融合校正测试
2024-07-18 1.增加三维匹配模型
    [三维测试零件.SLDPRT, 三维测试零件.STEP]
2024-07-25 1.更新匹配文件
    [三维测试零件.SLDPRT, 三维测试零件.STEP]
2024-07-27 1.更新双重像
2024-07-29 1.更新三维匹配方法
2024-07-30 1.更新软件包 2.更新三维匹配方法
2024-08-01 1.确认新匹配方法 #2 整个流程
    [三维测试零件.SLDPRT, 三维测试零件.STEP]
2024-08-05 1.硬触发设置
2024-08-07 1.更修测试
2024-08-08 1.更修
    [三维测试零件.SLDPRT, 三维测试零件.STEP]
2024-08-09 1.更修手眼标定测试
2024-08-20 1.更修添加文件
2024-08-22 1.增加验证
2024-08-24 1手眼路径验证
    [三维测试零件.SLDPRT, 三维测试零件.STEP]
2024-08-26 1.更新标定坐标后匹配
    [三维测试零件.SLDPRT, 三维测试零件.STEP]
2024-08-27 1.增加标定模型
2024-10-26 1.修正页面显示问题 2.增加光源控制方式
2024-10-26 1.跟新表达页面相机参数互锁
2024-10-26 1.修改空间相互占用问题
2024-10-27 1.跟新检测显示延时
2024-10-31 1.修复双目表达测试功能
2024-11-02 1.优化双目同步采集方法
2024-11-03 1.优化数据重叠GC误删问题 2.重构拓展方法，减少累赘 3.显示3D坐标系还有问题
2024-11-05 1.修复多相机图像占用问题
2024-11-06 1.修复双相机多问题 2.修复双相机同步采集问题 3.双相机检测隔离
2024-11-07 1.修改BUG
2024-11-08 1.修复BUG 2.C++报错查找中
2024-11-09 1.修复UI显示同步问题 2.增加标定结果保存
2024-11-16 1.更新项目配置 2.优化内存泄露问题
2024-11-19 1.增加立体重建参数
2024-11-22 1.ui制作
2024-11-29 1.优化字体显示问题 2.优化控件布局 3.增加功能
2024-11-30 1.增加参数UI
2024-11-30 1.优化
2024-12-02 1.优化UI逻辑
2024-12-03 1.优化标定文件格式 2.优化格式流程
2024-12-04 1.更新双目文件配置加载和显示 2.net6升级备份
2024-12-04 1.更新net包版本
2024-12-04 1.版本更新文件跟新
2024-12-04 1.更新双相机设备显示 2.增加配置文件调试
2024-12-05 1.更新UI显示区分 2.增加相机信息显示
2024-12-06 1.增加双相机设备状态显示 2.增加双目相机同步连接 3.相机类型切换冲突
2024-12-06 1.更新初始化读取文件
2024-12-07 1.更新数据结构 2.UI绑定数据优化
2024-12-09 1.修复UI逻辑切换异常问题 2.中断出现显示异常，查名原因
2024-12-10 1.优化UI冲突问题 2.UI布局
2024-12-10 1.增加窗口控件显示 2.UI逻辑优化
2024-12-10 1.更新细节
2024-12-11 1.增加双目同步采集和设置参数 2.增加采集参数设置优化 3.单帧采集问题排查
2024-12-12 1.测试取图方法连接
2024-12-14 1.修复取图回调方法问题 2.需要优化多帧采集之间耗时
2024-12-16 1.优化多任务下耗时
2024-12-17 1.优化UI布局 2.增加图标
2024-12-17 1.优化UI布局控制
2024-12-18 1.更新UI显示数据异常 2.优化多任务性能
2024-12-18 1.修复图像预处理流程显示 2.立体呈现图像预处理方法 3.优化方法
2024-12-19 1.优化UI显示逻辑 2.参数控件优化
2024-12-19 1.增加立体参数 2.增加立体成像方法 3.优化逻辑 3.优化界面
2024-12-20 1.优化三维场景设置 2.优化立体成像方法
2024-12-20 1.更新立体匹配结果图像 2.三维窗口设置修改
2024-12-23 1.增加点云预处理UI 2.优化局部显示
2024-12-24 1.增加三维模型预处理方法
2024-12-26 1.增加三维预处理参数名称
2024-12-27 1.三维UI参数增加 2.参数转换修改
2024-12-28 1.细化三维算子流程 2.UI数据显示问题查找
2024-12-29 1.测试转换器传参问题
2025-01-02 1.维护
2025-01-04 1.修复UI冲突
2025-01-07 1.更新UI显示逻辑 2.数据格式
2025-01-08 1.优化UI逻辑 2.流程方法
2025-01-08 1.XML 有问题
2025-01-09 1.修复UI属性序列化问题
2025-01-12 1.修复方法错误
2025-01-13 1.修复三维出来方法参数 2.修复三维窗口延时显示卡顿 3.调试过程优化
2025-01-14 1.修复相机采集参数设置 2.修复多目参数错误问题
2025-01-15 1.更新标定文件
2025-01-15 1.更新标定文件时间显示 2.清理生成数据 3.优化内存泄露问题
2025-01-15 1.UI修复 2.流程重构
2025-01-17 1.UI修改 2.修复
2025-02-12 1.更新版本导致24.11冲突问题
2025-02-13 1.适配24.11，全部降低C#版本到8.0
2025-02-13 1.跟新Nut框架版本
2025-02-13 1.增加控件支持深度图像信息读取显示
2025-02-14 1.增加基元模型功能 2.增加UI功能
2025-02-15 1.更新新方法，优化内存
2025-02-17 1.修复三维显示数量错误问题 2.增加聚元属性提取
2025-03-01 1.修复部分问题
2025-03-25 1.KUKA指令测试
2025-03-25 1.增加视觉标定流程
2025-03-26 1.修复流程
2025-03-27 1.修复标定文件修改日期
2025-03-29 1.修改手眼界面显示 2.跟新UI绑定
2025-04-12 1.UI界面整理
2025-04-14 1.手眼UI更新
2025-04-19 1.修复UI逻辑
2025-04-22 1.修复报错
2025-04-30 1.UI重新布局 2.新增图标
2025-05-05 1.修复手眼界面显示错误
2025-05-05 1.修复功能错误
2025-05-07 1.新增数据显示
2025-05-09 1.新增方法
2025-05-09 1.增加结果显示 2.重复检查内存错误
2025-05-15 1.优化内存错误问题
2025-05-15 1.更新方法
2025-05-15 1.优化界面
2025-05-19 1.变量保存
2025-05-23 1.手眼标定通讯修复
2025-05-25 1.增加负载选项
2025-05-26 1 错误修复
2025-06-02 1.修复相机错误删除
2025-06-02 1.更BUG
2025-06-04 1.错误修复
2025-06-07 1.更新错误
2025-06-09 1.新增信息看板
2025-06-09 1.增加机器人人信息读取
2025-06-10 1.增加IOC
2025-06-12 1.增加功能
2025-06-14 1.更新kuka信息读取
2025-06-14 1.增加图片和通讯协议
2025-06-14 1.修改布局
2025-06-16 1.增加图像
2025-06-16 1.消除错误
2025-06-16 1.更加UI
2025-06-18 1.kuka机型协议修改 2.UI增加
2025-06-18 1.增加时间计算
2025-06-19 1.增加时间方法
2025-06-21 1.更新时间方法 2.更新通讯时间
2025-06-24 1.更新文件 2.更新控件
2025-06-26 1.更新演示
2025-06-26 1.启动最大化
2025-06-26 1.增加安装库
2025-06-26 1.增加
2025-06-28 1.增加围边工艺计时
2025-06-29 1.优化断电文件写入错误
2025-06-30 1.增加看板处理
2025-07-05 1.新增功能
2025-07-07 1.开始通讯
2025-07-07 1.更新协议
2025-07-08 1.修复时间累计问题 2.更新看板排序问题
2025-07-09 1.更新窗口名称
2025-07-09 1.增加版本
2025-07-09 1.修复计时精度
2025-07-11 1.修复重复时间
2025-07-11 1.增加ABB指令
2025-07-18 1.修复时间错误
2025-07-21 1.修复检测更新问题
2025-07-21 1.增加ABB文件
2025-07-22 1.更新ABB程序
2025-07-22 1.更新ABB
2025-07-23 1.更新ABB指令
    [EIO.cfg]
2025-07-24 1.更新KUKA\ABB指令
2025-07-25 1.修复线程优先级
2025-07-26 1.更新通讯错误
2025-07-27 1.更新线程安全2.动画显示
2025-07-27 1.优化性能
2025-07-28 1.更新日期
2025-07-29 1.更新控件格式
2025-07-31 1.增加合格线
2025-08-01 1.更新看板读写文件
2025-08-02 1.运行版本
2025-08-02 禁止动画优化性能
2025-08-04 1.增加设计模型和断开连接状态
2025-08-05 1.增加显示数据
2025-08-08 1.优化看板参数初始化 2.看板列表数据显示完整
2025-08-28 1.优化围边计时逻辑
2025-10-24 1.增加协议介绍
2025-11-06 1.增加机器人协议通讯
2025-11-07 1.修复计时
2025-12-13 1.同步
2025-12-13 1.修改接受看板显示
2025-12-24 1.kuka预约模块
2026-01-08 1.增加发那科mes通信
2026-01-08 1.增加川崎通信
2026-01-11 1.更新资料
2026-01-23 KUKA_mes增加工艺
2026-01-23 1.增加川崎文件调试
    [RA010N_J0.STL, RA010N_J1.STL, RA010N_J2.STL, RA010N_J3.STL, RA010N_J4.STL, RA010N_J5.STL, RA010N_J6.STL]
2026-01-26 1.修复多线程列表修改冲突
2026-01-29 1.更新川崎机器人通信处理
2026-01-29 1.更新通信
2026-01-30 1.更新锁
2026-02-27 1.修复跨月数据异常重叠问题
2026-03-17 更新SDK
2026-04-04 1.增加3D模型测试
2026-04-09 1.更新kuka工装控制
2026-04-09 1.更新版本
2026-04-11 1.更新测试新本版图表
2026-04-30 1.测试更新
2026-05-01 1.增加设备端月查看数据
2026-05-23 1.升级版本 2.合并主线
2026-05-23 1.合并更新
2026-05-25 1.调整数据显示过多问题
2026-05-26 1.修改内容
2026-05-27 1.修改多页面问题
2026-05-29 1.更新UI统一
2026-05-30 1.更新新版本
2026-06-02 1.跟新KUKA文件 2.优化页面显示精度 3.增加滚动控制选项
2026-06-06 1.增加服务器监听数量，避免抢夺通信
2026-06-15 1.兼容KUKA9.2新版本
2026-06-20 1.9系统适配
2026-07-11 1.修复连接异常断开
2026-07-23 1.增加码垛项目
2026-07-31 1.测试分包问题 2.更新文件
2026-08-06 1.更新设备文件 2.优化通信
2026-08-08 1.更新本机配置位置
2026-08-12 1.更新报错
2026-08-14 1.Server端增加新设备功能
2026-08-15 1.修复内存暴增问题
2026-08-20 1.更新图表显示步骤
2026-08-26 1.修复UI
2026-08-27 1.更新设置页面
2026-08-27 1.更新看板连接状态
2026-08-28 修复显示精度，减少UI溺出
2026-09-04 1.更加注释
2026-09-05 1.更新网络错误等一系列
2026-09-05 1.新增库卡后台工装逻辑
2026-09-16 1.新增仿真模型库测试
    [Base.STEP, J2.STEP, J3.STEP, J4.STEP, J5.STEP, J6.STEP]
2026-09-16 1.MubusTCP临时部署
2026-09-18 1.新增Mudbus通信协议
2026-09-30 调整框架结构
2026-10-30 1.更新相关模型文件
2026-10-30 1.新增机器人
2026-10-30 1.更新模型
2026-10-31 1.功能隔离 2.添加相关功能
2026-11-02 1.修复旋转问题
2026-11-03 修复错误
2026-11-07 1.修改通信问题
2026-11-07 1.修复部分错误
2026-11-11 1.库卡机器人8系统增加机器人位置角度通信 2.修改UI一致性
2026-11-11 1.修复显示 2.通信调整 3.清理旧方法 4.修复仿真显示模型异常
2026-11-13 1.修复卡顿显示问题
2026-11-13 1.更新9系统项目
